plektra/ESP32-PDM/docs/decisions.md

# Decisions

Every design decision, numbered. Numbers are never reused. **Confirmed** = decided by the owner; **[proposed]** =
recommended, not decided; **auto** = a two-way-door decision made by an agent under decision 23, which the owner may
overturn. Background and calculations: [design-notes.md](design-notes.md). New decisions take the next
free number (`/handoff` adds them).

| # | Date | Area | Decision | Status |
|---|---|---|---|---|
| 1 | 2026-10-29 | system | Purpose: replace mechanical relays with smart high-side switching, controlled by ordinary panel switches **and** over NMEA 2000; status and current reported on the bus. No relays in the product. | confirmed |
| 2 | 2026-10-29 | system | **Low cost is the guiding principle.** JLCPCB PCBA; JLCPCB basic or preferred parts wherever one fits; few unique extended parts. | confirmed |
| 3 | 2026-10-29 | system | Supply: 12 V and 24 V systems, up to ~30 V while charging. | confirmed |
| 4 | 2026-10-30 | system | Keep the ESP32-S3 (NMEA 2000 / SensESP / Signal K ecosystem, Wi-Fi, OTA). Native USB; no USB-UART bridge. | confirmed |
| 5 | 2026-10-30 | system | One board per product, built from shared schematic sheets; the earlier base board + output module split is dropped. | confirmed |
| 6 | 2026-10-30 | system | Physical switch inputs drive the outputs in hardware, independent of the ESP32 and its 3.3 V rail (protected direct inputs, no optocoupler). | confirmed |
| 7 | 2026-10-30 | pdm-4ch | 4-channel board with Infineon PROFET+24V switches, fitted per channel at assembly: BTT6050-1ERA (≈ 4 A) or pin-compatible BTT6010-1ERA (≈ 8 A). BTT6030 not used. | confirmed |
| 8 | 2026-10-30 | pdm-hc2 | High-current board: 2 channels, TI TPS48110A-Q1 + back-to-back MOSFETs (≈ 15 A continuous with BSC030N08NS5). | confirmed |
| 9 | 2026-10-30 | system | Heat budget is part of the design process: 40 °C engine-room ambient, `tools/heat_budget.py`. | confirmed |
| 10 | 2026-10-30 | mechanical | Enclosure 3D printed (ASA), **vented**, installed in an enclosed location. Two mountings: DIN rail with the PCB perpendicular to the rail (target 1 module width, 17.5 mm) and flat (wall/ceiling). | amended by 97 |
| 11 | 2026-10-30 | mechanical | No metal base plate: risk of bridging DC negative to a steel hull, and cost. | confirmed |
| 12 | 2026-10-30 | system | Load dump is **not** handled on the board; the README states it (system-level protection required). | confirmed |
| 13 | 2026-10-30 | system | Low-power modes are entered by a bus command (NMEA 2000 or Signal K); local switches always work and can wake the node. Panel LEDs dimmable. | confirmed |
| 14 | 2026-10-29 | system | Board variant ID: resistor divider on IO1 (`MOD_ID`, 10 kΩ pull-up). 4-ch = 10 kΩ, HC2 = 4.7 kΩ. | confirmed |
| 15 | 2026-10-30 | system | Bilge pumps: the automatic float-switch circuits stay wired directly to the battery; the PDM is used only for manual forced run (in parallel with the float switch). | confirmed |
| 16 | 2026-10-30 | system | Withdrawn by the owner (2026-11-03). | withdrawn |
| 17 | 2026-10-30 | system | Panel cable (J5, 10 poles): 1–4 switch inputs, 5 fused switch supply SW_SUPPLY (VS via PTC F4 1812L050/60GR, SMAJ30CA, 100 nF), 6–9 LED cathodes to constant-current sinks (MMBT5551 + 470 Ω emitter, 1 k/10 k base from the GPIO, ≈ 5 mA, PWM-dimmable, 1 nF on the collector), 10 GND/drain. Panel LEDs: anode to SW_SUPPLY, no resistor at the panel; works up to ≥ 10 m of cable at 12 V and 24 V. SMAJ30CA on every line; no 3.3 V on the cable. A short in the panel cable trips F4 and disables that board's panel switches (bus control keeps working). | confirmed |
| 18 | 2026-10-30 | system | Pin map: VBAT_SENSE on IO10 (220 k/22 k + 100 nF, 33 V full scale), NTC on IO9 (10 k B3380 NTC APV ANTC1608-103F3380FB + 10 k pull-up, placed next to the output switches); both ADC1. Panel LED drives move to IO38–IO41; channel-4 drive (4-ch) moves IO9 → IO11; IO12/IO13 spare. | confirmed |
| 19 | 2026-10-30 | pdm-hc2 | Withdrawn by the owner (2026-11-03): no HC2 load above the ≈ 15 A rating; the breaker stays as in decision 39. | withdrawn |
| 20 | 2026-10-30 | system | Panel LED behaviour and fault handling: LED on = output on, blinking = fault (firmware). Alerts and failures are published to Signal K so they can be acknowledged and muted there; the failure modes per output (what blinks, what alerts, what is latched, what clears) are still to be designed in `/system firmware`. | open |
| 21 | 2026-10-30 | system | Sense the panel switch supply: SW_SUPPLY → 100 k/10 k divider (+ 100 nF) → spare GPIO IO12, so the firmware can alert when F4 has tripped (otherwise indistinguishable from "all switches off"). Two basic resistors per board. | superseded by 93 |
| 22 | 2026-10-30 | system | Unattended agent runs (`docs/AUTONOMY.md`): agents make small decisions themselves (recorded as **auto**); bigger design changes go to the owner through `docs/OWNER-INBOX.md`. Pilot: only the reviewers run unattended. | confirmed; policy replaced by 23 |
| 23 | 2026-11-01 | system | Autonomy by reversibility (one-way/two-way doors, `docs/AUTONOMY.md`) replaces the small/big rule of decision 22. One-way doors go to the owner: money (orders, changes to ordered boards), the owner's confirmed, proposed or open decisions, weakening safety or invariants, facts only the owner has, CRITICAL findings. Everything else is a two-way door: agents decide (recorded as **auto**, listed in the inbox digest, undoable with `orchestrate.py undo`); questions with a sensible default are answered with it. | confirmed |
| 24 | 2026-11-01 | system | Unattended fixes (`docs/AUTONOMY.md`, "Unattended fixes"): approved items (owner rulings and two-way decisions) are applied by agents without the owner – a planner makes work packages, board-fixer agents edit the schematics, the orchestrator gates every change (scope, ERC, netlist against declared refs, LCSC, shared sheets equal) before merging into `auto/pilot`, and a validator re-checks each board. One-way doors still go to the owner; the owner merges into `main` and reviews before any order. | confirmed |
| 25 | 2026-11-01 | pdm-hc2 | HC2 gate slew control per TPS4811-Q1 §8.3.2.1: R1 in the PU path, C1 + 10 Ω at the gate, PD direct (RGATE_PD as a 0 Ω footprint); sized for about 20 A inrush into 1000 µF (start ≈ 100 k / 3.9 nF), because the HC2 loads are not known yet. This supersedes the plain RG_PU 100 Ω of Q-0001. MOSFET SOA, heat budget and fast short-circuit response are checked. No PWM on HC2 outputs until measured on the bench; real load capacitance measured on the prototype. (owner: Q-0001, Q-0043, Q-0045) | confirmed |
| 26 | 2026-11-01 | system | Battery input J10 (both boards): bulk capacitor rated ≥ 63 V (not 50 V, the TVS clamps up to ≈ 48 V), basic part preferred, plus 1–2.2 µF/100 V ceramic at J10 and 1 µF/100 V at each BTT6050 VS tab; ferrite/CMC as a DNP footprint. (owner: Q-0002) | confirmed |
| 27 | 2026-11-01 | system | Output surge protection: HC2 gets a TVS from each OUT to GND at J11 with a short return to J10.2 (SMAJ33CA if basic/cheap for stand-off margin in the 28.8 V float-switch case, else SMAJ30CA). Invariant 4 is reworded to cover the PROFET output case (protection through the body diode to VS and D30); pdm-4ch gets a DNP SMAJ30CA footprint per output and wide VS copper to D30. (owner: Q-0003, Q-0007) | confirmed |
| 28 | 2026-11-01 | system | EMC target: IEC 60945 as a design target, no certification; one pre-compliance scan on the first prototypes decides the DNP footprints; the N2K shield stays unconnected at the node (4-pole J4). (owner: Q-0012) | confirmed |
| 29 | 2026-11-01 | system | CAN sheet: Y-capacitor GND_CAN–GND as a DNP footprint and a CMC footprint fitted with 0 Ω bridges, decided at the pre-compliance scan; 10 k pull-up from the transceiver TXD to +3V3; CA-IS3050G replaces ISO1044 only if its part-facts check (supplies, pinout, timing) passes; the isolated CAN side stays powered from NET-S (NMEA 2000 practice, LEN). (owner: Q-0004, Q-0023, Q-0031, Q-0039) | confirmed |
| 30 | 2026-11-01 | system | Buck (power-usb): add 100 nF/100 V at VIN, an SW RC snubber footprint (DNP) and a 0 Ω boot resistor; keep LMR51610YDBVR – swap to the YF (FPWM) variant only if the pre-compliance scan shows PFM noise (check price and stock then), and revisit the 400 kHz X variant only after the scan. Capacitors on battery-side clamp nets (C1, C50–C53): 100 V where a basic part exists, otherwise ≥ 63 V; the stock check decides. (owner: Q-0005, Q-0009, Q-0013, Q-0022) | confirmed |
| 31 | 2026-11-01 | system | USB service port: README service rule (battery-powered laptop or USB isolator); verify the ESD diode TLP/clamp data before ordering; shield-to-GND RC footprints (1 MΩ ‖ 4.7 nF) with a 0 Ω option. USB-C stays fitted on the prototype run; DNP/pogo pads plus OTA reconsidered for later runs. (owner: Q-0008, Q-0020, Q-0029) | confirmed |
| 32 | 2026-11-01 | system | BOM parts: add the listed basic/preferred LCSC codes after checking each against value and footprint (J5/J10/J11 in /system mechanical); adopt each L3 swap (FB → GZ2012D601TF, F2 → 1812L050/60GR, PESD0402V05 → H5VL10B, TPS7B91 → L78M05ABDT) only if its part-facts check passes; check the 1812L050/60GR Imax and minimum resistance against the prospective short current (30 V / cable + PTC resistance); recheck stock before ordering and datasheet-check the L1 second sources SLW6045S8R2MST C47018494 / FNR6045S8R2MT C168074; keep the NTC TH1; keep R1/R2 on HC2 so the controller part stays identical. (owner: Q-0011, Q-0014, Q-0015, Q-0019, Q-0024, Q-0025) | confirmed |
| 33 | 2026-11-01 | system | Ordering: first order 5 pdm-4ch + 5 pdm-hc2, quantity revisited for later runs; combined 1:1 panel of both designs at the PCB phase if the JLCPCB multi-design surcharge does not cancel the saving; the owner checks 2 oz + Economic PCBA on the JLCPCB quote page before layout; merge 100 nF / 1 µF package variants only if Standard PCBA is forced. (owner: Q-0016, Q-0017, Q-0018, Q-0026, Q-0027, Q-0028) | confirmed; first order replaced by 101, 102 |
| 34 | 2026-11-01 | mechanical | Terminals: J10 GND pole(s) rated like the VS input, with wide GND copper to J10.2; pluggable vs fixed terminals decided in /system mechanical, leaning pluggable for low-current J4/J5 and fixed for J10/J11. (owner: Q-0010, Q-0021, Q-0030) | terminal type replaced by 98 |
| 35 | 2026-11-01 | system | Panel interface (analog_sw): C14–C17 raised to 470 nF; README: dry (unlit) switch contacts and output-off below about 8 V during 12 V cranking; R3/R4/R7/R8 become two 1206 resistors in series (2.2 k + 2.4 k, basic); a series diode in the SW_SUPPLY feed protects the panel LEDs on reversal (switch thresholds and IN margin rechecked with its drop). The switch ON margin claim is corrected in design-notes and measured on the prototype; RIN 4.7 k is the planned fix if it is short; no other circuit change now. (owner: Q-0006, Q-0034, Q-0038, Q-0040) | confirmed |
| 36 | 2026-11-01 | pdm-4ch | Standard population: all four BTT6050, heavy loads go on HC2. RIS as 1206 ≥ 0.25 W; OUT pull-down as a DNP footprint; firmware rule: DEN pulsed only while sampling IS and dropped on full-scale IS, not held high in Active mode. (owner: Q-0032, Q-0033, Q-0041) | confirmed |
| 37 | 2026-11-01 | system | Footprints: Infineon_PG-TDSO-14_ThermalVias paste windows move between the thermal vias (no plugged-via surcharge), rechecked against the package drawing; U3 uses the standard KiCad Package_TO_SOT_SMD:SOT-23-6 after a check against TI DBV0006A and the JLCPCB footprint. (owner: Q-0036, Q-0037) | confirmed |
| 38 | 2026-11-01 | system | Amends decision 18: VBAT_SENSE full scale is about 32 V (ESP32-S3 ADC calibrated range 0–2900 mV), not 33 V; the 220 k/22 k divider is unchanged. (owner: Q-0035) | confirmed |
| 39 | 2026-11-01 | pdm-hc2 | HC2 breaker: RIWRN 68 k (IOC ≈ 17.5 A, 146 ms) plus a README/label requirement for an external breaker ≤ 15–18 A per output and a firmware soft fuse; the ARCHITECTURE HC2 budget is updated; the bilge pump start current is measured before ordering. An OUT voltage divider on spare IO4/IO5 (ADC1) detects float-driven runs (pin-map change). (owner: Q-0042, Q-0046) | confirmed; pump test timing replaced by 100 |
| 40 | 2026-11-01 | pdm-hc2 | Reverse battery on HC2: keyed/polarised J10 plus README and label warning; design-notes §8 corrected (reversal survival does not apply to HC2); full reverse-polarity protection deferred to a later HC2 revision and kept on the list. (owner: Q-0044) | confirmed |
| 41 | 2026-11-01 | system | Battery input J10 (both boards): C31 100 uF/63 V Ymin VKMD1001J101MV C487384 (extended; no basic/preferred >=63 V electrolytic exists; 10000 h at 105 C, 902 mA rms) on VS, C30 1 uF/100 V X7R 1206 Samsung CL31B105KCHNNNE C13832 (extended; no basic/preferred 100 V 1 uF) on the terminal net VBAT_IN with D30; FL30 DNP ferrite position VBAT_IN-VS bridged by JP30 copper net tie (no part, widened to VS copper at layout); two new extended-part loading fees accepted (T-0064) | auto |
| 42 | 2026-11-01 | pdm-hc2 | HC2 bulk: one extra 100 uF/63 V (C487384) per channel on VS in hc_channel (C106/C206), 3 x 100 uF in total (T-0064) | auto |
| 43 | 2026-11-01 | pdm-hc2 | HC2 output TVS D103/D203 SMAJ33CA C19077549 (preferred): VRWM 33 V above the 28.8 V float case, VC 53.3 V below the 80 V MOSFET and 100 V SS510B ratings (T-0064) | auto |
| 44 | 2026-11-01 | pdm-4ch | 4-ch: C104-C404 1 uF/100 V C13832 at each BTT6050 VS tab; D103-D403 SMAJ30CA C19077548 DNP from OUT to GND (check PROFET demagnetisation clamp before fitting) (T-0064) | auto |
| 45 | 2026-11-02 | system | L3 swaps (T-0026): FB1/FB2 -> Sunlord GZ2012D601TF C1017 (600 ohm@100 MHz, 0.30 ohm, 500 mA); D4-D6 -> H5VL10B C7420372 on D_SOD-882 (VRWM 5 V, VC 10 V@5 A 8/20us, CJ 18 pF max); U6 -> L78M05ABDT C58069 DPAK (VI max 35 V vs 29.2 V clamp, Id 6 mA, LEN unchanged 1/2) with C13 1 uF/50 V 0805 C28323; F2 not swapped (PTC Imax check failed) (T-0065) | auto |
| 46 | 2026-11-02 | system | USB shield (T-0014): J3 SH on net USB_SHIELD, R13 1 M 1206 C17927 \|\| C18 4.7 nF/1 kV X7R 1206 Yageo C107198 fitted, R14 0 ohm 0603 C21189 DNP hard-tie option (T-0065) | auto |
| 47 | 2026-11-02 | system | Buck (T-0011): C19 100 nF/100 V 0805 C28233 at U3 VIN; R43 0 ohm 0402 C17168 in series with boot cap C2; SW snubber R44 10 ohm 1206 C17903 + C20 100 pF/100 V C0G 0603 C296717, both DNP (values set at the pre-compliance scan) (T-0065) | auto |
| 48 | 2026-11-02 | system | Capacitor ratings (T-0015): C1 -> 2.2 uF/100 V X7R 1206 Samsung CL31B225KCHSNNE C170101 (extended; no basic >=63 V, 2x C13832 would be below TI's 2.2 uF minimum); C50-C53 -> 1 nF/2 kV X7R 1206 FH C9196 (basic) (T-0065) | auto |
| 49 | 2026-11-02 | system | L1 approved alternates (T-0022): Sunltech SLW6045S8R2MST C47018494 and cjiang FNR6045S8R2MT C168074, same 8.2 uH / 0.056 ohm max / Isat 3.9 A / Irms 2.6 A / 6045 land as SWPA6045S8R2MT; stock recheck on the pre-order checklist (T-0065) | auto |
| 50 | 2026-11-02 | pdm-4ch | PG-TDSO-14 EP paste: 4 x 2.55x0.6 mm windows at y=+/-0.6,+/-1.8 and 2 x 2.55x0.5 mm at y=+/-2.95, between the via rows; 51 % of the EP, >=0.15 mm from every via drill (BTT6050-1ERA DS Fig. 53; Q-0036) (T-0066) | auto |
| 51 | 2026-11-02 | shared | U3 LMR51610 footprint Package_TO_SOT_SMD:SOT-23-6 on both boards (matches TI DBV0006A pitch/width/pin order, JLC C22427220 pads inside it); lib symbol default updated; custom lib/ESP32-PDM.pretty/LMR51610.kicad_mod removed (Q-0037) (T-0066) | auto |
| 52 | 2026-11-02 | pdm-4ch | RIS 680 ohm 1206 0.25 W = C17975 (extended; no basic 1206 680 ohm exists) (T-0069) | auto |
| 53 | 2026-11-02 | pdm-4ch | DNP OUT pull-down R106/R206/R306/R406 47 kohm 0603 C25819 (BTT6050 Table 11 RPD example; 19 mW at 30 V) (T-0069) | auto |
| 54 | 2026-11-02 | shared | C14-C17 470 nF/10 V X5R 0402 CL05A474KP5NNNC (C47339, preferred), same footprint; tau about 1.5 ms (T-0012/Q-0006) (T-0068) | auto |
| 55 | 2026-11-02 | shared | SW_SUPPLY series diode D55 = DSK16 (C22466351, already on BOM; 60 V, 1 A, IFSM 25 A) between F4.2 (anode) and SW_SUPPLY/J5.5 (cathode); D54/C54 stay on J5.5 (T-0049/Q-0040) (T-0068) | auto |
| 56 | 2026-11-02 | pdm-4ch | p_other documented as about 2.2 W at 30 V with all panel lines on (Tj 101 C at 4 A); heat_budget default unchanged (T-0047) (T-0068) | auto |
| 57 | 2026-11-03 | pdm-hc2 | DIODE bypass C107/C207 1 nF 0402 C1523 fitted across MMBT3904 (TPS4811-Q1 9.6.1); emitter Kelvin to U GND at PCB (T-0071) | auto |
| 58 | 2026-11-03 | pdm-hc2 | RVS R114/R214 100 ohm C25076 VS -> VS_CTRL (pin 20); C102/C202 moved to VS_CTRL as CVS 1 uF/100 V 1206 C13832 (Table 9-3); drop <= 70 mV at I(Q) 700 uA; RSET and UV/OV divider stay on VS (T-0071) | auto |
| 59 | 2026-11-03 | pdm-hc2 | CS X cap C108/C208 1 nF C1523 fitted (tau 0.1 us << tSC 4 us); Y caps C109/C110/C209/C210 100 pF/100 V C296717 DNP (unbalanced source impedance, needs ferrites; Q-0012) (T-0071) | auto |
| 60 | 2026-11-03 | pdm-hc2 | EN/UVLO C111/C211, OV C112/C212 and IWRN C113/C213 1 nF C1523 fitted (OV delay <= 0.4 ms; 10 nF rejected at 4 ms; IWRN 47 us vs tOC 146 ms) (T-0071) | auto |
| 61 | 2026-11-03 | shared-can | U5 ISO1044 -> Chipanalog CA-IS3050G (C528763, SOIC-8-WB, KiCad SOIC-8_7.5x5.85mm_P1.27mm, new symbol ESP32-PDM:CA-IS3050G); datasheet v1.10 checks passed (VCC1 2.5-5.5 V, VCC2 4.5-5.5 V, +/-58 V bus, loop <=210 ns, DTO 2-8 ms, 5 kVrms); LEN 1 worst case 49.3 mA (T-0067) | auto |
| 62 | 2026-11-03 | shared-can | TXD pull-up R70 10 k 0402 C25744 to +3V3 (T-0067) | auto |
| 63 | 2026-11-03 | shared-can | barrier Y-cap C70 = 1 nF/2 kV X7R 1206 C9196 (reuses C50-C53 part), DNP, GND_CAN-GND, capacitor only (T-0067) | auto |
| 64 | 2026-11-03 | shared-can | CMC FL1 = cjiang FACT4532-510-2P-T C20624726 (51 uH, 4532), DNP, footprint Coilank_ACM4532 placeholder, bus side on pins 1/4; bridges R71/R72 0 ohm 0402 C17168 (reuses R43 part), fitted (T-0067) | auto |
| 65 | 2026-11-03 | system | LCSC codes from cost report C1 applied on both boards after value/package/net-voltage check: C2 C14663, C4/C6 C15849, C5 C19666, C7/C9 C28233, C8 C45783, C10/C11 C307331, C12 C52923, D12-D15 C22466350 (BAT54C, preferred), R1/R2/R5/R6 C25879, R11/R12 C25905, R15-R17/R21/R24/R27 C25744; C13 and FB1/FB2 keep the T-0065 codes (T-0073) | auto |
| 66 | 2026-11-03 | system | Firmware/production rule: never burn EFUSE_STRAP_JTAG_SEL (IO3 held low by IS2 on pdm-4ch, IMON2 on pdm-hc2); design-notes §2 and both STATUS pre-order checklists (T-0073) | auto |
| 67 | 2026-11-03 | pdm-hc2 | RIWRN R113/R213 68 k 0402 1 % = C36871 (preferred, replaces C25792): IOC 17.5 A nominal, ~15.2-19.7 A over V(SNS_WRN) interpolation and 1 % parts; tOC 146 ms unchanged; Tj 111 C at 17.5 A, 139 C at 19.7 A (11.7 mOhm path) (T-0072) | auto |
| 68 | 2026-11-03 | pdm-hc2 | OUT sense on the HC2 root sheet: R63/R65 220 k C25767, R64/R66 22 k C25768, C62/C63 100 nF C307331 (VBAT_SENSE parts), OUT1 -> IO4 (ADC1_CH3), OUT2 -> IO5 (ADC1_CH4); full scale ~31.9 V; <=0.13 mA into an unpowered pin (T-0072) | auto |
| 69 | 2026-11-03 | shared-can | Amends decision 61: U5 CA-IS3050G pinout corrected per CA-IS305x v1.10 p. 5 Fig. 6-1/Table 6-1: pin 2 = RXD, pin 3 = TXD. The symbol ESP32-PDM:CA-IS3050G is renumbered (positions unchanged) on both boards, so /IO17 (CAN TX, R70 pull-up) goes to U5.3 TXD and /IO18 (CAN RX) to U5.2 RXD. The earlier pinout pass in decision 61 had the CA-IS3052G order. Pin map and parts are unchanged. (owner: Q-0052) (owner: Q-0052) | confirmed |
| 70 | 2026-11-03 | shared | CA-IS3050G symbol pins corrected to datasheet v1.10 Table 6-1 (2 RXD, 3 TXD) by renumbering only; pin points and wiring unchanged, /IO17 -> U5.3 TXD, /IO18 -> U5.2 RXD, R70 stays on TXD (T-0078) | auto |
| 71 | 2026-11-03 | system | Amends decision 24: unattended **sync** packages (`docs/AUTONOMY.md`, "System sync"). Board-fixers with scope `sync` may bring `docs/ARCHITECTURE.md` (never its Invariants section), `docs/design-notes.md`, the boards' `STATUS.md` and the inputs of `tools/heat_budget.py` in line with what is already merged and decided – no design change. After fixes settle, the orchestrator sweeps the "For /system" lists: bookkeeping items are synced, choices (mechanics, firmware, pin map, invariants, money, safety rules, owner facts) stay for an interactive `/system` session. Gates: those files only, netlists unchanged, invariants word for word, the heat budget tool still runs. | confirmed |
| 72 | 2026-11-03 | pdm-hc2 | Amends decision 25: Amends decision 25: HC2 outputs are rated for a maximum load input capacitance of about 50-100 uF (BSC030N08NS5 SOA, T-0070); the 1000 uF / 20 A inrush target is dropped. Only a short gate slew for EMC is fitted (decision 25 topology), sized within the MOSFET SOA at that capacitance, also for turn-on into a short. The README says HC2 is for motor loads (bilge pumps, wipers) and grouped LED work lights (possibly a few hundred uF in total), while DC-DC converters (e.g. 24->12 V for a car radio), radios and other electronics go on pdm-4ch. The prototype measures real load capacitance (Q-0045) and confirms the rating; grouped LED lights are split if they cause short-circuit trips. No PWM on HC2 until measured stays. (owner: Q-0049, Q-0050, Q-0051) (owner: Q-0049, Q-0050, Q-0051) | confirmed |
| 73 | 2026-11-03 | system | Amends decision 32: Amends decision 32 (and the F4 part of decision 17): F1/F3/F4 become an 1812 60 V PTC with Imax 100 A (TECHFUSE mSMD050-60V C70113 or JDT ASMD1812-050-60V C427396, same footprint) after a datasheet check, plus a series resistor of about 0.15-0.22 ohm per PTC so that 30 V / R_total <= Imax. The resistor's pulse energy is checked against the PTC trip time; if no basic/cheap part passes, back to the owner. Then F2 is swapped to the same PTC (T-0026). F4 is safety-relevant (panel switches: bilge forced run, navigation lights): a competent person reviews it before installation. (owner: Q-0047) (owner: Q-0047) | confirmed |
| 74 | 2026-11-03 | system | Amends decision 35: Amends decision 35: the panel switch loads R3/R4/R7/R8 become two 2 k 1206 basic resistors (C17944) in series, 4.0 k in total (7.5 mA and 0.11 W per part at 30 V), instead of 2.2 k + 2.4 k (no basic part for those exists). (owner: Q-0048) (owner: Q-0048) | confirmed |
| 75 | 2026-11-03 | shared | panel switch loads: R3/R4/R7/R8 2 k 1206 C17944 with new R45/R46/R47/R48 2 k 1206 C17944 in series to GND (4.0 k, 0.11 W per part at 30 V, 0.29 W per part at the 48 V clamp within the 5 s overload of 55.9 V); p_other about 2.3 W, Tj 101 C at 4 x 4 A (T-0105/Q-0048) (T-0105) | auto |
| 76 | 2026-11-03 | pdm-hc2 | gate slew: R1 (R104/R204) 10 k C25744, C1 (C114/C214) 1 nF/2 kV 1206 C9196 to GND via R2 (R115/R215) 10 ohm C25077, PD direct via RGATE_PD (R116/R216) 0 ohm C17168; output ramp about 0.5-0.75 V/us (TPS4811-Q1 8.3.2.1, Eq. 3/4; BSC030N08NS5 SOA Diagram 3) (T-0106) | auto |
| 77 | 2026-11-03 | pdm-hc2 | HC2 output rating: max about 50 uF load input capacitance (100 uF and 68 uF fail SOA from a hot start, 100 uF trips ISCP); confirmed on the prototype (Q-0045) (T-0106) | auto |
| 78 | 2026-11-03 | pdm-4ch | RIS = two 1 kOhm 1206 0.25 W C4410 in parallel (R103\|\|R107 ... R403\|\|R407) = 500 ohm, replaces 680 ohm C17975; IS <= 1.63 V at 4.5 A BTT6050 (kILIS min 1380), firmware scale 500 ohm (T-0107) (T-0107) | auto |
| 79 | 2026-11-03 | system | C30 at J10 (both boards) 1 uF C13832 -> 2.2 uF/100 V X7R 1206 C170101, within decision 26's 1-2.2 uF (T-0107) (T-0107) | auto |
| 80 | 2026-11-03 | pdm-hc2 | CVS C102/C202 on VS_CTRL 1 uF C13832 -> 2.2 uF/100 V C170101; TPS4811-Q1 Table 9-3 0.1-10 uF, tau 0.22 ms with RVS 100 ohm (T-0107) (T-0107) | auto |
| 81 | 2026-11-03 | system | Amends decision 73: Amends decision 73: F1/F3/F4 each get a series 0.2 ohm 2 W alloy 2512 resistor (FOJAN FRM252WJR200TK, C7420022, extended). It is accepted on its 5 s / 50 J overload rating without a published ms pulse rating. F1-F4 become the 100 A PTC TECHFUSE mSMD050-60V C70113 (F2 moves from 0805 to the 1812 footprint, no series resistor on F2). A hard-short test at 30 V on the prototype (J5.5, and behind F1 and F3) is mandatory before installation. F4 feeds the panel switches (bilge forced run, navigation lights): a competent person reviews it before installation. (owner: Q-0060) | confirmed |
| 82 | 2026-11-03 | pdm-4ch | Reverse battery on pdm-4ch: a reverse-blocking element (P-FET or ideal-diode controller) goes on VS in front of the bulk capacitors in this revision. It is sized for the 40-50 A input path and checked with the heat budget at 40 C. Until it is in, the README/design-notes reversal claim is limited to the BTT6050 switches, with a warning that C31 is not reverse-rated. J10 is still keyed/polarised (decision 34, /system mechanical). (owner: Q-0054) | confirmed; pdm-4ch J10 keying dropped by 121 (fixed terminal, Q30 blocks reverse battery) |
| 83 | 2026-11-03 | system | Amends decision 31: Amends decision 31: the USB shield RC is 1 MOhm \|\| 1 nF/2 kV. C18 becomes C9196 (basic, already on the BOM) on both boards instead of 4.7 nF/1 kV C107198. USB-C (J3 and its protection) stays fitted on every run; no DNP/pogo-pad variant for later runs. (owner: Q-0058, Q-0061, Q-0062) | confirmed |
| 84 | 2026-11-03 | system | Amends decision 26: Amends decision 26: each BTT6050 VS tab gets >= 1 uF/100 V. On pdm-4ch, C104-C404 are 2.2 uF/100 V X7R 1206 C170101 instead of 1 uF C13832 (same footprint), which removes the C13832 fee. Revisit if runs grow past about 12 boards. (owner: Q-0063, Q-0064) | confirmed |
| 85 | 2026-11-03 | system | Assembly: Economic PCBA without the through-hole connectors J4, J5, J10 and J11. The owner buys and hand-solders all four on both boards. The owner checks the JLCPCB monthly assembly coupon centre and the cart at order time. (owner: Q-0057, Q-0059, Q-0065) | confirmed |
| 86 | 2026-11-03 | system | PTC series resistors R54 (F1), R55 (F3), R56 (F4): 200m C7420022 on Resistor_SMD:R_2512_6332Metric, on the protected side; each PTC shifted 7.62 mm to its supply side to make room (T-0118) (T-0118) | auto |
| 87 | 2026-11-03 | system | F2 swapped to C70113 1812: USB-only buck input at 0.40 A peak 3.74 V typ vs 3.80 V before, below 4 V with either part, same pass/fail in every corner, so the Q-0060 stop condition is not met (design-notes 8.3) (T-0118) | auto |
| 88 | 2026-11-03 | pdm-4ch | reverse-battery blocker: LM74500-Q1 (C5219210, no reverse-current blocking, EN tied to SOURCE) driving N-FET IPT007N06N (C122552, 60 V, 0.75 mOhm) between new net VBAT_FL (behind FL30/JP30) and VS; keeps the OUT->VS->D30 surge path (invariant 4), no TVS on VS (design-notes 8.6) (T-0121) | auto |
| 89 | 2026-11-03 | pdm-4ch | U30 VCAP capacitor C32 1 uF/50 V 0603 C15849 (>= 10 x Ciss 21.3 nF = 213 nF, LM74500 datasheet 9.3.1.2.3) (T-0121) | auto |
| 90 | 2026-11-03 | pdm-4ch | PCB rule: >= 6 cm2 2 oz copper on Q30 drain tab (VS) - Q30 Tj 122 C at 40 A, 200 C on a minimal pad (T-0121) | auto |
| 91 | 2026-11-04 | pdm-4ch | Q30 cost lever L1 dropped: AGM601LL C5464765 is 1.6 mOhm max (1.25 typ), RthJA 50 K/W without copper area; Q30 has no stable Tj below 175 C at 40 A (IPT007N06N 124 C by the same method). Q30 stays IPT007N06N C122552 (design-notes 8.6 Cost) (T-0132) | auto |
| 92 | 2026-11-04 | pdm-4ch | Amends decision 88: Reverse-battery blocker: a TVS is fitted across Q30 (drain VS to source VBAT_FL) on the first order, so that a negative transient with VS charged no longer avalanches Q30. It keeps Q30 VDS below 60 V at the pulse current and takes the transient's energy, checked at the real maximum input of 32 A (4 x BTT6010 at 8 A). It must not conduct for a steady reversed battery (<= 28 V) or in normal operation. Basic/preferred part if one fits; back to the owner if no part keeps VDS below 60 V. The 'no TVS on VS' wording of decision 88 and design-notes 8.6 (c) changes accordingly: the TVS is across Q30, not from VS to GND, and the OUT->VS->Q30->D30 surge path stays (invariant 4 unchanged). Design-notes 8.6 (b) is corrected. This replaces the documentation-only default assumed in T-0130. (owner: Q-0066) | confirmed |
| 93 | 2026-11-04 | system | Replaces decision 21: sense the panel switch supply digitally, because the 100 k/10 k divider cannot work on IO12 (ADC2, invariant 10; as a digital input it reads low at 24 V). SW_SUPPLY → R49 10 k 1206 → SW_SENSE (R57 4.7 k, D24 BZT52C3V3, C21 470 nF to GND) → R58 10 k → IO12, the same network as the switch inputs, on both boards. High = SW_SUPPLY present, from about 7.7 V. +5 parts per board, no new unique part. The firmware alerts only while VBAT_SENSE shows a healthy battery, so 12 V cranking does not raise a false alarm. An alert, not a safety function. | confirmed |
| 94 | 2026-11-04 | pdm-hc2 | Amends decision 72: plan on one LED work light per output. Each HC2 output is limited to about 50 µF of load input capacitance (decision 77), confirmed on the prototype. Several lights on one output are allowed only for loads with little capacitance (plain LED strips without their own driver) or once the prototype shows that group switches on cleanly. No redesign now; a pre-charge path (TPS48111-Q1 with a pre-charge MOSFET and resistor) is the planned fix for the next HC2 revision if the prototype shows real loads need it. | confirmed |
| 95 | 2026-11-04 | system | Board input limits, replacing the ≈ 40 A (4-ch) / ≈ 50 A (HC2) budget and the 40–50 A sizing basis of decision 82: J10, its GND pole and the supply copper are sized for 32 A continuous on pdm-4ch (4 × BTT6010 at 8 A; 16 A in the standard all-BTT6050 build) and 36 A on pdm-hc2 (2 × the 18 A external breaker). The README states them as the board input limits. Q30 stays IPT007N06N with the ≥ 6 cm² drain copper rule (Tj ≈ 86 °C at 32 A). Output terminals are chosen in `/system mechanical`. | confirmed; output connectors set by 98; pdm-4ch limit amended by 103 |
| 96 | 2026-11-04 | pdm-4ch | Amends decision 92: TVS across the reverse-battery blocker: SMDJ40CA C42371557 (preferred, 0.22 USD) is fitted across Q30 (drain VS to source VBAT_FL). The owner accepts Q30 VDS 59.4 V worst case and VS down to about -4 V for the 31 A bounding spike. This is recorded as a residual risk in design-notes 8.6 (C31 briefly reverse-biased), and a prototype check measures Q30 VDS and VS during a negative pulse. Basis (T-0137): 25 C figures, source short-circuit current at most 31 A. (owner: Q-0067) | confirmed |
| 97 | 2026-11-05 | mechanical | Amends decision 10: the board is designed to mount two ways on the same four non-plated M3 holes (H1–H4). (a) DIN rail without its own enclosure: bare board on a plastic carrier, PCB edge-on (perpendicular to the rail), about 36 mm of rail per unit with the tallest J10 block, inside an enclosure the installer provides; one enclosure can hold several units. J10/J11 screws face the neighbouring unit, so they are wired before the neighbour is fitted or with a unit unclipped. (b) A 3D-printed vented ASA enclosure instead of the rail, also usable for flat mounting. The 1-module width target is dropped. Carrier and screws never reach board copper (invariant 6). Shared enclosure rating, estimated until measured: full rating up to 50 °C air inside the box; a BTT6050 channel at 3 A up to about 65–70 °C. | confirmed; screw access replaced by 98; holes and mount refined by 123 |
| 98 | 2026-11-05 | mechanical | Replaces the terminal type of decision 34 and meets the keying of decisions 34, 40 and 82: all four connectors are keyed plugs on right-angle sockets, so plugs pull outward and no terminal screw faces the neighbouring unit. J10 both boards: Kefa KF2EDGSRAM-10.16-2P C6394053 + locking plug C6394029 (65 A UL / 57 A IEC, 10 mm²). J11 pdm-4ch: KF2EDGRC-5.08-4P C441238 + plug C440882 (10 A UL / 15 A IEC). J11 pdm-hc2: locking KF2EDGSRM-7.62-2P C577772 + plug C577752 (30 A UL / 32 A IEC), a different pitch so the battery plug cannot enter an output socket. J5: Kangnex WJ15EDGRC-3.81-10P C26895 + plug C26865. J4: WJ15EDGRC-3.81-04P C7245 + plug C7244. The owner hand-solders all sockets (decision 85). Board depth about 65 mm on pdm-4ch and about 75 mm on pdm-hc2, length up to 100 mm, set at layout. One sample of each set is checked before layout: plugs truly one-way, J4 plug against the J5 socket, fit at the 36 mm rail pitch. | confirmed; pdm-4ch J10 amended by 103 and 121; sample check moved to bring-up by 127 |
| 99 | 2026-11-06 | system | Result of the owner's quote-page check in decision 33: JLCPCB does not offer Economic PCBA with 2 oz copper. While the boards stay 2 oz, Standard PCBA is the cost basis for every order, whichever module is used. This meets decision 33's condition for merging the 100 nF / 1 µF package variants; the merge itself is not done yet. (owner: Q-0026) | confirmed |
| 100 | 2026-11-06 | system | Amends decision 39's timing: the bilge pump start current is measured on or after the first working prototype, not before ordering, and before any board runs a pump in service (`docs/pump-start-current-test.md`). U1 stays machine-placed: the owner will not hand-solder a module with a bottom pad (no hot air or hot plate), and the DOIT modules are dropped because of possible commercial use. The cost levers based on them (L1, L2 of the 2026-11-05 cost report) are closed. Since the Espressif S3 modules are standard-only, orders stay on Standard PCBA whatever the copper weight. | confirmed |
| 101 | 2026-11-06 | system | Amends decision 33's first-order quantity: 5 bare PCBs of each design, of which JLCPCB assembles 2 (JLCPCB's 2-of-5 option), instead of 5 assembled. The first order is prototype only. Copper stays 2 oz and U1 machine-placed; reflowing the module by hand is dropped for now. | confirmed |
| 102 | 2026-11-06 | system | Amends decision 33's first-order scope: the first order is pdm-4ch only, as the cheapest tangible MVP (no board is urgent, design changes are expected). pdm-hc2 layout and order follow after pdm-4ch bring-up, so shared-sheet fixes go in once. The combined panel of both designs does not apply to this order. | confirmed |
| 103 | 2026-11-06 | pdm-4ch | Amends decisions 95 and 98 for the first version: pdm-4ch is 16 A only, all BTT6050, with no BTT6010 build; a BTT6010 option can return in a later revision. J10 is to be downsized and Q30 re-selected for 16 A, including a heat check; both are open items for the next `/system` session, and the schematic is not changed yet. | confirmed |
| 104 | 2026-11-07 | pdm-4ch | Amends decision 98: pdm-4ch J10 becomes KF2EDGSRM-7.62-2P C577772 + locking plug C577752 (30 A UL / 32 A IEC) instead of the 10.16 mm set, which keeps keying against the 5.08 mm J11 on the same board. Q30 is re-selected for 16 A with a datasheet check, the heat budget at 40 °C and the LM74500-Q1 gate drive; invariant 4, D31 and decision 96's negative-pulse limits are kept, or the agent stops and reports. This names the set left open in decision 103. pdm-hc2 keeps the 10.16 mm J10. As a result the pdm-4ch battery plug fits a pdm-hc2 J11 socket; this is noted for /system and was not part of the ruling. (owner: T-0148) | confirmed; J10 replaced by 121 |
| 105 | 2026-11-07 | system | Merge near-duplicate BOM lines under Standard PCBA (decision 99): C2 to C307331 (0402), C12 and C13 to C15849, R10 to C25768, HC2 R9 to C36871. C13 is the L78M05 input capacitor: it moves only if the X5R DC-bias curve at 29 V passes, otherwise it keeps C28323. Planner's note, not part of the ruling: R9 is on the shared power-usb sheet, so it changes on pdm-4ch as well, at no cost. (owner: T-0149) | confirmed |
| 106 | 2026-11-07 | system | Amends decision 18: On-board sign of life and spare access, both boards: a low-current 3.3 V power LED and a firmware status LED on IO13 (no longer spare), using one LED line and a resistor value already on the BOM where it fits; CAN TX/RX LEDs only if a check against the CA-IS3050G and R70 shows they do not load the signals. IO35, IO36, IO37 and IO42 with 3V3 and GND go to an unfitted footprint with no BOM line, and TXD0, RXD0 and GND to unfitted pads with no BOM line; IO45 and IO46 are not used. Planner's note, not part of the ruling: IO35-IO37 are FLT signals on pdm-hc2, so under the ruling's pin-map check pdm-hc2 brings out only IO42 of those, and both uses share one unfitted 8-pole footprint. (owner: T-0150, T-0151, T-0152) | confirmed |
| 107 | 2026-11-07 | system | Buck input filter position on power-usb between D2 and C1/U3: an inductor footprint bridged by a fitted 0 Ohm part or equivalent, DNP inductor, plus a DNP damping option, after checks of current rating, PTC and R54 interaction and stability against the LMR51610 input requirements. The decision 28 pre-compliance scan decides whether the inductor is fitted. (owner: T-0153) | confirmed |
| 108 | 2026-11-07 | pdm-4ch | Q30 is AGM601LL C5464765 for the 16 A input (replaces auto decision 91, which rejected it at 40 A): Tj 66-80 C at 16 A, 40 C, 40-62 K/W, Infineon's TOLL figures as an analogue because AGM's 50 K/W has no stated copper area; footprint Infineon_PG-HSOF-8-1 and C32 unchanged; symbol stays ESP32-PDM:IPT007N06N with value AGM601LL (T-0158) | auto |
| 109 | 2026-11-07 | pdm-4ch | Q30 copper rule: >= 2 cm2 of 2 oz VS copper joined to the drain tab (tab land + D31 terminal copper, rounded up), replacing the 6 cm2 of decisions 90 and 95 (T-0158) | auto |
| 110 | 2026-11-07 | system | C13 stays 1 uF/50 V X7R 0805 C28323: C15849 gives 0.10 uF at 29 V and 0.31 uF at 12 V (Samsung Component Library DC Bias simulation, 25 C) against L78M05 C_I 0.33 uF; C28323 gives 0.42 uF at 29 V with tolerance and temperature (T-0159) (T-0159) | auto |
| 111 | 2026-11-07 | system | R9 68 k moves to C36871 0402 on both boards, not only HC2: it is on the shared power-usb sheet, and on pdm-4ch it swaps one line for one line, so it is cost-neutral (T-0159) (T-0159) | auto |
| 112 | 2026-11-07 | system | C2 C307331 0402, C12 C15849 0603, R10 C25768 0402 on both boards; values, nets and 3.3 V setpoint tolerance unchanged; saves 3 lines on pdm-4ch (4.59 USD) and 4 on pdm-hc2 (6.12 USD) per order (T-0159) (T-0159) | auto |
| 113 | 2026-11-07 | system | T-0150: LED line KT-0603R red 0603 C2286 (basic) with 2.2 k C25879: power LED D8/R67 +3V3 to GND, status LED D7/R59 IO13 to GND (high = on), ≈ 0.7 mA each, root sheet both boards (design-notes §8.7) (T-0160) | auto |
| 114 | 2026-11-07 | system | T-0150: CAN TX/RX LEDs left out: LED to GND on TXD with R70 10 k sits at the 2 V VIH limit; active-low LEDs would not load but light only for dominant bits, invisible at 0.7 mA (T-0160) | auto |
| 115 | 2026-11-07 | system | T-0151/T-0152: one DNP 1x08 2.54 mm footprint J6, no BOM line: 1 GND, 2 TXD0, 3 RXD0, 4 IO35, 5 IO36, 6 IO37, 7 IO42, 8 +3V3 (T-0160) | auto |
| 116 | 2026-11-07 | pdm-hc2 | T-0151: J6 pins 4-6 not connected on pdm-hc2 (IO35-IO37 are FLT_T1/FLT_I2/FLT_T2), FLT nets untouched; brings out GND, TXD0, RXD0, IO42, 3V3 only (T-0160) | auto |
| 117 | 2026-11-07 | system | Buck input filter position (power-usb, both boards): D2.K -> JP1 copper bridge (SolderJumper-2 Bridged, 0.6 mm bar, no part; 87 A2s at 2 oz by Onderdonk vs 9.6 A2s F1 trip bound) \|\| L2 DNP SWPA6045S8R2MT C96963 -> C1/C19/U3; D3 on the U3 side. No 0 ohm chip part: C17168/C21189 publish no pulse data (T-0161) (T-0161) | auto |
| 118 | 2026-11-07 | system | Buck input filter damping option: C22 2.2 uF C170101 + R73 10 ohm C17903 1206 in series across C1, both DNP; scan starts at 10 ohm, 3.3-4.7 ohm if needed; L2 only fitted together with C22/R73 (Middlebrook margin 4.1x at a 7.3 V crank, U3 VIN surge peak) (T-0161, design-notes 8.3) (T-0161) | auto |
| 119 | 2026-11-07 | pdm-4ch | J10 stock fallback: only C577772 from another seller; C577767 and C7422678 rejected (no flange, no shown lock with plug C577752) – T-0171 (T-0171) | auto |
| 120 | 2026-11-07 | system | J10 (pdm-4ch) and J11 (pdm-hc2) stay KF2EDGSRM-7.62-2P C577772 + locking plug KF2EDGSKM-7.62-2P C577752; no design change while C577772 is out of stock (0 at JLCPCB/LCSC on 2026-11-07, plug 63). The connectors are hand-soldered (decision 85), so the owner buys the set from any seller (LCSC restock, the maker's own shop, other distributors), checking that the header reads KF2EDGSRM-7.62 (flange). If none can be bought in time, the decision 98 sample, and with it layout and the order, waits. Flange-less sockets without a shown lock (C577767, C7422678, or similar) are not acceptable. Confirms decision 119. (owner: Q-0068, Q-0069) | confirmed; pdm-4ch J10 replaced by 121, holds for pdm-hc2 J11 |
| 121 | 2026-11-07 | pdm-4ch | Amends decisions 98, 104 and 120 for the pdm-4ch prototype: J10 is the fixed screw terminal Kefa KF135T-10.16-2P C475108 (65 A UL / 57 A IEC, 10 mm2, M4, 2 pins per pole in a 10.16 mm grid, hole 2.3 mm), new footprint ESP32-PDM:Kefa_KF135T-10.16-2P from the Kefa drawing (rev. A, 2021-03-16); no plug. Reason: every flange-locking socket that fits is out of stock or thin at LCSC (C577772 0, C6394053 4 on 2026-11-07). Accepted: on the DIN rail the screws face the neighbouring unit (wire before fitting the neighbour, decision 97's original workaround); removing a board means unscrewing the battery leads, so the feed is switched off first; polarity relies on the marking and on Q30's reverse-battery blocking (decision 82). With no pdm-4ch battery plug, the cross-board mis-plug question of T-0158 closes. Connector stock, including plug sets, is re-checked for the next revision. pdm-hc2 is unchanged (J10 keyed, decision 40; J11 C577772, decision 120). (owner, 2026-11-07) | confirmed |
| 122 | 2026-11-08 | system | Layout rule, both boards: **all SMT parts on one side** (top). A double-sided Standard PCBA job costs 33.77 USD more per order (setup 51.12 vs 25.56 USD, stencil 16.42 vs 8.21 USD; JLCPCB price page 2026-11-07). Through-hole connectors are hand-soldered (decision 85) and do not count. A part goes on the bottom only with an owner ruling. Lever L3 of `docs/reviews/2026-11-07-cost-system-2.md`. (owner, 2026-11-08) | confirmed |
| 123 | 2026-11-08 | mechanical | Refines decision 97: H1–H4 are M3 non-plated holes, one in each corner of each board. Both boards have the same length and the same hole spacing along the rail-side edge. The DIN mount is one solid 3D-printed ASA part (owner's Bambu P1S): a short version fastened to the two rail-side holes, and a long version that also reaches the two far corners for rigidity, in a 65 mm (4-ch) and a 75 mm (HC2) depth. The long version reaches the far holes along the board's short edges, not as a full plate behind the board, so the rail pitch stays about 36 mm per unit (a full plate adds about 2 mm). Nylon M3 screws and standoffs; nothing conductive reaches board copper (invariant 6). Layout rule: no copper and no parts within Ø 8 mm of each hole. The mount is drawn as a parametric OpenSCAD file after layout, from the board outline. (owner, 2026-11-08) | confirmed |
| 124 | 2026-11-08 | shared power-usb | C3 (+3V3 at L1 output) C377773 2.2uF/50V 0805 -> C170101 2.2uF/100V X7R 1206 on both boards; LMR51610 SLUSEY1B §8.2.2.5 gives no C_OUT max or ESR limit; unique parts -1 per board (T-0190) | auto |
| 125 | 2026-11-08 | pdm-hc2 | R105/R205 EN/UVLO top resistor 1 MΩ: C26083 0402 → C17927 1206 (±1 %, 1/4 W, 200 V; same part as R13), unique parts −1 (T-0191) | auto |
| 127 | 2026-11-08 | pdm-4ch | Amends decision 98 (and the J10 sample note of 121) for the pdm-4ch prototype: **no connector sample check before layout or order**. The checks of decision 98 (plugs one-way, J4 plug against the J5 socket, 36 mm rail pitch, J10 wire entry and M4 screw access, pin fit, reach from the edge) move to the first assembled boards; the connectors are hand-soldered (decision 85), so they are bought with the board order and a misfit costs a board revision, which decision 102 already expects. The layout covers the risks from the drawings: (1) each connector footprint is checked against the maker drawing and the JLCPCB/EasyEDA footprint in software; (2) J10 keeps a parts-free zone on both sides of its body, so the wire entry works whichever side the sample shows; (3) J4 and J5 apart on the edge, with "CAN" and "PANEL" and pin 1 on the silkscreen, and every connector's function and pin 1 marked; (4) a few mm of margin to the board edge beyond the drawing reach. The rail pitch is a soft goal, not a constraint: as small as practical, but it does not limit connector or layout choices; it is measured on the first boards and recorded. (owner, 2026-11-08) | confirmed |
| 128 | 2026-11-08 | pdm-4ch | First layout floorplan, fixing decision 123's shared figures: board **100 × 65 mm** (pdm-hc2 100 × 75 mm). One 100 mm long edge is the rail side, the other the front. Power connectors J10 (battery) and J11 (outputs) on one 65 mm short edge, signal connectors J5 (panel) and J4 (CAN) on the other: the two rows (42 + 55 mm) do not fit one 100 mm edge, and the split keeps the switching current away from the switch inputs and CAN. Power half (Q30/U30/D31, D30/C30 at J10, the four PROFETs, VS pour) at the power end; logic half (buck, CAN barrier, J6, D7/D8) at the signal end; ESP32 antenna at the front corner of the signal end, away from the rail and the switches. H1–H4 hole centres 4 mm from both edges: rail-side spacing **92 mm on both boards**, 57 mm across on pdm-4ch (67 mm on pdm-hc2). Skeleton `hardware/pdm-4ch/ESP32-PDM-4CH.kicad_pcb` (outline, 2 oz stackup, Ø 8 mm keep-outs). (owner, 2026-11-08) | confirmed |
| 129 | 2026-11-08 | system | Replaces the owner-merge step of decisions 23–24: **all work lands on `main` by itself.** `tools/land.py` merges origin/main into the branch, refuses duplicate decision numbers, pushes to main and fast-forwards a clean main checkout. The orchestrator lands `auto/pilot` after every committed task, after `inbox` and at the start and end of a run (`run --no-land` opts out; `orchestrate.py land` retries by hand); every Claude session, background worktree sessions included, lands its commits as soon as it commits (CLAUDE.md "Git"), so no `worktree-*` branch or PR waits for the owner. `docs/decisions.md` merges with `union` like the STATUS files. Reason: unmerged branches hid owner rulings from later sessions (the 2026-11-05 no-samples ruling was asked again on 2026-11-08) and made the owner merge by hand. Landing is a two-way door (revert, `undo`); ordering stays the one-way door, reviewed on `main`. (owner, 2026-11-08) | confirmed |
| 130 | 2026-11-08 | system | **PCB layout is done by the orchestrator.** New agent `pcb-fixer` lays out one stage of a board with `tools/kpcb.py` (KiCad 10's own Python: import from the schematic, place, zones, tracks, vias, text, DRC with schematic parity, render). `orchestrate.py pcb <board>` queues six stages (connectors and holes; power path; logic half; power copper; routing; silkscreen), then an EMC and a validator review; the planner may send layout-only items to pcb-fixer packages. Gates: schematic unchanged, parity 0, 0 DRC errors on the board, outline and hole keep-outs unchanged, no SMT on the bottom, no part in a hole keep-out, nothing parked after placement, nothing unconnected after routing. Placement and routing are two-way doors; bottom-side parts, outline/hole/connector-edge changes and ordering stay the owner's. The three combined-panel items deferred to the PCB phase (T-0025, T-0036, T-0093) are closed as settled (decision 102). (owner, 2026-11-08) | confirmed |
| 131 | 2026-11-08 | pdm-4ch | Power edge: J11 toward the front (origin 7.8/12.0), J10 toward the rail (origin 17.2/39.5), so the heavy M4 screw terminal sits beside the rail-side holes of the DIN mount; VBAT_IN upper pole, GND lower; front faces 0.5 mm inside the edge (T-0197) | auto |
| 132 | 2026-11-08 | pdm-4ch | J5 on the signal edge toward the rail (pin 1 at the rail end), leaving the front corner free for the ESP32 antenna; its nine SMA TVSs in two staggered columns (x 87.6 odd pins, x 79.5 even pins) with pad 2 toward the pin, then R34-R37/C14-C17 and the SW_SUPPLY chain D54-C54-D55-R56-F4 along y 38.3 (T-0197) | auto |
| 133 | 2026-11-08 | pdm-4ch | D30 vertical across the J10 rear VBAT_IN/GND pins and C30 beside it, both parallel to the edge; the J10 clear zone behind the terminal (x 20-35, y 33-56) holds only these low SMT parts (T-0197) | auto |
| 134 | 2026-11-08 | pdm-4ch | D103-D403 (DNP) at the J11 pins in two staggered columns (x 13.6/21.2), pad 2 toward the pin, leaving 6.6 mm gaps for the OUT copper (T-0197) | auto |
| 135 | 2026-11-09 | pdm-4ch | Battery path along the rail side behind the J10 clear zone: JP30 38.1/47 rot 180, Q30 48.2/47 rot 0 (drain toward C31 and the switches), D31 under Q30 at 48.2/56.2 spanning source and drain, C31 60.9/47, C32 42.5/35.9 (T-0198) | auto |
| 136 | 2026-11-09 | pdm-4ch | BTT6050 switches in a 2x2 grid (U11 32/9.2, U12 51/9.2, U14 32/25.8, U13 51/27.8), rot 180 with OUT pins toward J11; OUT2/OUT3 run in the inter-row corridor so no outputs cross (T-0198) | auto |
| 137 | 2026-11-09 | pdm-4ch | Per channel: VS caps C_n04/C_n03 side by side at the tab end, OUT parts beside the OUT pins, IN/DEN/IS/GND-network parts on the logic side; TH1 at U13's tab end (hottest switch, next to Q30) (T-0198) | auto |
| 138 | 2026-11-09 | pdm-4ch | Amends decision 128: pdm-4ch is **100 × 75 mm**, the same as pdm-hc2; the extra 10 mm is on the rail side (H3/H4 and their keep-outs at y 71, 4 mm from the rail edge; rail-side hole spacing stays 92 mm, 67 mm across on both boards). Reason: decision 128 forgot the Ø 8 mm hole keep-outs at the corners – the 65 mm signal edge left 49 mm for J5 + J4 (57 mm), and layout stage 3 (T-0199) found no room for the CAN block. One board size also means one long DIN mount depth (75 mm). JLCPCB prices boards up to 100 × 100 mm the same. (owner, 2026-11-09) | confirmed |
| 139 | 2026-11-09 | pdm-4ch | J5 and its protection cluster moved 7.4 mm toward the front, J4 below at 93.3/63.9 rot 90 (pin 1 at the rail end); both between the H2/H4 keep-outs with a 0.6 mm gap (decision 138) (T-0199) | auto |
| 140 | 2026-11-09 | pdm-4ch | U1 at 69.25/9.75 rot 0, antenna on the front edge in the signal-end corner; keep-out strip x 46.5-92, y 0-4.5 clear; channel 2 moved 2.6 mm toward the rail with its IS column beside the module (T-0199) | auto |
| 141 | 2026-11-09 | pdm-4ch | Buck along the rail edge: VS at D31 -> F1 -> R54 -> D1/D2 -> JP1 \|\| L2 -> C1/C19/U3 (upright, VIN in one row, loop about 3 mm) -> L1 -> C3 (T-0199) | auto |
| 142 | 2026-11-09 | pdm-4ch | CAN barrier block at J4: U5 at 71.5/56.5, GND_CAN island x >= 78.1 / y >= 51.4 with all bus-side parts and U6, parts-free band x 65-78.1 crossed only by C70 (T-0199) | auto |
| 143 | 2026-11-09 | pdm-4ch | USB J3 at the front edge in the power-end corner (15.2/4.2 rot 180); J6 upright at 55.2/55.1 on the logic side (no free 21 mm strip near U1) (T-0199) | auto |
| 144 | 2026-11-09 | pdm-4ch | Power copper as zones: VS priority 6 (bottom bands 7), VBAT_IN/VBAT_FL 5, OUT 4, GND_CAN 2, GND 1; 1.0 mm clearance on VS/VBAT_IN/VBAT_FL pours (EMC rule 7), 0.4 mm on OUT, 0.3 mm on GND (T-0200) (T-0200) | auto |
| 145 | 2026-11-09 | pdm-4ch | VS reaches the four PROFETs on the bottom layer: spine under U12/U13/Q30 plus a front band (U11) and a rear band (U14), joined to the 2.67 cm2 top drain pour by 40 vias; the corridor between the switch rows stays GND on the bottom (T-0200) (T-0200) | auto |
| 146 | 2026-11-09 | pdm-4ch | OUT1 on a bottom band with four vias at U11; OUT2/OUT3 on top through the corridor between the switch rows, OUT4 on top below D403; the J11 TVS returns reach J10.2 through a 3 mm GND strip along the power edge (T-0200) (T-0200) | auto |
| 147 | 2026-11-09 | pdm-4ch | GND and OUT1 pours connect pads solid instead of thermal reliefs (thermals starved 28 pads; GND carries no load current); VBAT_IN keeps 1.5 mm spokes for the hand-soldered J10 (T-0200) (T-0200) | auto |
| 148 | 2026-11-09 | pdm-4ch | C70 turned 180 deg so its GND_CAN pad faces the island; GND pour ends at x 67.6, GND_CAN at x 75.7 (8.1 mm across U5), 4.0 mm at the J5/J4 corner (T-0200) (T-0200) | auto |
| 149 | 2026-11-09 | pdm-4ch | JP30 stays the 2 x 2 mm top-layer net tie for the prototype (one square of 2 oz, about 64 mW at 16 A); a wider two-layer tie waits for the FL30 decision (T-0200) (T-0200) | auto |
| 150 | 2026-11-09 | pdm-4ch | **4 copper layers** instead of 2 (EMC review 2026-10-30, layout rule 3, never decided until now): F.Cu/B.Cu 2 oz carry all load current, In1.Cu a solid GND plane (GND_CAN its own area on the CAN side, split at the barrier per PCB rule 9), In2.Cu VS under the switches and Q30 for heat spreading and the surge path, the rest GND and spare routing; 1.6 mm, inner copper 0.5 oz (JLCPCB). Owner's JLCPCB quote 2026-11-09, 100 × 75 mm, 5 pcs: 2 layers €36.88, 4 layers €43.95 (+€7.07 per order). The 2-layer routing stage (T-0201) is superseded; placement and outer power copper (stages 1–4) stay. (owner, 2026-11-09) | confirmed |
| 151 | 2026-11-09 | pdm-4ch | In1.Cu solid GND plane with the outer GND outline (antenna notch, barrier cut at x 67.55, Ø 8.8 mm arcs around H1–H3) and a GND_CAN area equal to the outer island; barrier gap 8.1 mm across U5 on every layer (T-0205) | auto |
| 152 | 2026-11-09 | pdm-4ch | In2.Cu: VS (12.2 cm², pads solid) under U11–U14, Q30 drain, C31 and D31's VS side, which takes every PROFET thermal via and every VS via at the drain; the rest GND, and GND_CAN under the CAN island (T-0205) | auto |
| 153 | 2026-11-09 | pdm-4ch | Inner zones leave the hole (Ø 8.8 mm) and antenna areas out in their own outlines, because those rule areas cover only F.Cu/B.Cu (T-0205) | auto |
| 154 | 2026-11-09 | pdm-4ch | 90 stitching vias 0.8/0.4 mm: 34 board edge (about 5 mm), 5 GND_CAN edge, 12 around the buck, 8 around U1, 30 open-area grid, 1 island tie; every outer GND/GND_CAN island tied to In1 (T-0205) | auto |
| 155 | 2026-11-10 | pdm-4ch | Buck input loop closes on F.Cu through a 0.3 mm GND track from U3.2 under the SOT-23-6 body (between pins 3 and 4) to C19.2; FB stays on F.Cu and no via sits in the C1/C19/U3 loop (T-0207) | auto |
| 156 | 2026-11-10 | pdm-4ch | C2 and R43 moved into the L1-U3 corridor (17.3/61.5 rot 90, 17.3/63.45 rot 270) so the bootstrap link stays on F.Cu without crossing SW (T-0207) | auto |
| 157 | 2026-11-10 | pdm-4ch | R67 and R59 turned 180 degrees so the D8/D7 anode links are straight under the antenna strip and the +3V3/IO13 pads face outward (T-0207) | auto |
| 158 | 2026-11-10 | pdm-4ch | Nine tented GND stitching vias under the ESP32 module (around pad 61 and under the top GND pin row) (T-0207) | auto |
| 159 | 2026-11-10 | pdm-4ch | VS-B-spine and VS-In2 narrowed from x 61.0 to x 59.5 beside C31 (y 34.5-52.8): a side area with no VS pad or via, -27 mm2 B.Cu / -24 mm2 In2, drain rule met on F.Cu, heat budget unchanged; opens the U1-to-south corridor to x 59.5-67.5 (T-0208) | auto |
| 160 | 2026-11-10 | pdm-4ch | Six GND stitching vias removed from the U1 corridor and fan-out lanes, two re-added west of U1 at (59.9, 10.2) and (59.9, 15.6); In1 stays one piece (T-0208) | auto |
| 161 | 2026-11-10 | pdm-4ch | U1 fan-out vias sit under the module (tented, staggered at least 1.2 mm apart so In1 keeps webs) because the right pin column has only 1.3 mm to C50/C52/C53 (T-0208) | auto |
| 162 | 2026-11-10 | pdm-4ch | J6 service lines routed on In2 (IO35/36/37/42 the whole way, TXD0/RXD0 with a 5 mm B.Cu hop at J6 because their order swaps between U1 and J6) (T-0208) | auto |
| 163 | 2026-11-10 | pdm-4ch | **Routing as a reproducible build** (owner): one script (`hardware/pdm-4ch/scripts/build_routing.sh`, KiCad closed) rebuilds the routing on a copy. Locked copper (the stage 4–5 power copper, scripted links and the fixed routes in `scripts/fixed_routes.py`) stays; unlocked tracks and vias are removed; zone fills are cleared and the power zone outlines are keep-outs; Freerouting (headless) routes the signals only; then refill, stitching vias, dangling-via clean-up, pour-integrity check and DRC with parity. Several runs, keep the best clean one. Fixes go into the scripts, not hand edits on the board. Routing stages T-0209–T-0211 are rebriefed to this method; T-0207/T-0208 stay as landed. | confirmed |
| 164 | 2026-11-11 | pdm-4ch | Routing build: each power zone outline (VS, VBAT_IN, VBAT_FL, OUT1–4, VS-In2) goes to Freerouting as plane plus keep-out of the same outline, minus 0.5 mm escapes around foreign pads/vias/track ends; a plane alone let foreign tracks split the pours (T-0209) | auto |
| 165 | 2026-11-11 | pdm-4ch | Routing build: 0.35 mm board-edge keep-out strip for the router (copper ≥ 0.5 mm from the edge), signals barred from In1.Cu, buck SW/CB on F.Cu only (T-0209) | auto |
| 166 | 2026-11-11 | pdm-4ch | Routing build accepts a run only with 0 DRC errors, parity 0 and every power pour at its baseline island count and ≥ 98 % of its area; it replaces the board only when it has fewer unconnected items than the board at that moment (T-0209) | auto |
| 167 | 2026-11-11 | pdm-4ch | First build locked all existing copper (stage 4–5 power copper, T-0207/T-0208 links and fan-out); router tracks stay unlocked and are rebuilt each run; GND islands without a via get a tie-in via from the build (T-0209) | auto |
| 168 | 2026-11-11 | pdm-4ch | CAN pair: H/L side by side on F.Cu over GND_CAN; CANL_XCVR under FL1 on In2, CANH_BUS to J4.3 on B.Cu (vias 86.0/53.45, 85.1/58.05); CANL_XCVR tap through the R71/R72 slot with a 0.15 mm neck (T-0210) | auto |
| 169 | 2026-11-11 | pdm-4ch | USB pair crosses the VS block on B.Cu y 19.0/19.5 (x 17-46), F.Cu y 20.5/21.15 through the U12/U13 gap (x 46-58) and In2 east of x 57.5 (GND plane) to the U1 fan-out vias; ESD D5/D6 inline at J3 (T-0210) | auto |
| 170 | 2026-11-11 | pdm-4ch | No via under J3 inside OUT1-B (y 8.9-11.6): J3 end of the USB pair on F.Cu only, CC1 via above the pads, fixed GND ties at 18.05/13.0 and 20.55/12.25 (T-0210) | auto |
| 171 | 2026-11-11 | pdm-4ch | Landed the clean build with the pairs fixed at 78 unconnected (75 before) because the pairs are now fixed input; later builds compare against it (T-0210) | auto |
| 172 | 2026-11-11 | pdm-4ch | Amends decision 166: Routing build may put foreign signal vias (not tracks) through VS-In2 (In2 keep-out for tracks only); every power pour must stay at one island and keep >= 95 % of its baseline area (was 98 %); a placement stage may move the U1 transistor/resistor block (Q3-Q6, R17-R24/R50/R51) and the channel signal columns to make room; no corridor notch in VS-In2/OUT3-F; heat budget rechecked after the change (decision 9). (owner, 2026-11-11) (owner: Q-0070) | confirmed |
| 173 | 2026-11-12 | pdm-4ch | J6 service bundle (TXD0/RXD0/IO35-37/IO42) on In2 runs as nested L-routes down x 75.6-78.1 and west along y 32.6-35.1 instead of the stage-6b diagonal through the Q3-Q6 block (fixed_routes.py, T-0236) (T-0236) | auto |
| 174 | 2026-11-12 | pdm-4ch | R60 (VS -> VBAT_SENSE divider top) at 58.3/41.4 with its VS pad inside the VS-F-drain outline on the VS via column, so only the divided sense signal leaves the power area (T-0236) | auto |
| 175 | 2026-11-12 | pdm-4ch | Signal vias through VS-In2 (decision 172) alone gave no gain (79 vs 78): a through via also needs F.Cu and B.Cu room, and the VS-B spine/front/rear close the west channel pocket on B.Cu (T-0236) | auto |
| 176 | 2026-11-12 | pdm-4ch | Amends decision 172: Amends decision 172: In2 corridor. Signal tracks (not only vias) may run through the VS copper on In2.Cu only. F.Cu/B.Cu VS, the 16 A paths and the surge path stay unchanged. VS-In2 stays one piece, keeps every PROFET's thermal vias inside it and loses at most 15 % of its baseline area (the other pours keep >= 95 %). The heat budget at 40 C must pass (tools/heat_budget.py). Routing method: first fix the router export so the DSN has no built-in violations, and run several Freerouting runs per build. Route mostly by script: one channel's signal bus (sense, input, LED lines) is designed once through the In2 corridor and generated for the other three channels in scripts/fixed_routes.py. The J6 bundle, CAN, USB and the U1 fan-out stay fixed routes. Freerouting only fills the remaining short links, and if it cannot close them it is dropped and those links are scripted too. (owner: Q-0071) | confirmed |
| 177 | 2026-11-13 | pdm-4ch | Router export without built-in violations: router keep-outs get 0.25 mm holes round fixed copper, every placed pin gets clearance class PIN<class> (pin-pin 190 um, pin-wire = net class), fixed vias FIXV<class> (0 to pins); Freerouting loads with 0 pre-existing violations (was 723); no KiCad rule changed (T-0241, patch in scripts/) (T-0241) | auto |
| 178 | 2026-11-13 | pdm-4ch | In2 corridor rule (Q-0071): signal tracks may run on In2 inside VS-In2 only >= 1.5 mm inside its outline (internal slots, cannot split it) and never over a PROFET thermal-via field + 1 mm; per-pour check VS-In2 >= 1012.1 mm2 and 1 island, others >= 95 % and same islands; thermal_check requires all 40 thermal vias inside VS-In2 (T-0241) | auto |
| 179 | 2026-11-13 | pdm-4ch | Channel signal bus is generated per net by scripts/maze_route.py (grid A* 0.1 mm, class clearances, pour keep-outs) instead of one copied pattern: the destinations (D12-D15, U1) and the west-channel B.Cu pocket are not channel-symmetric, and channel 2's signal parts differ from channels 1/3/4 (T-0241) | auto |
| 180 | 2026-11-13 | pdm-4ch | Builds run 3 Freerouting runs but on a clean DSN the three strategies give identical results (spread 0); 15 passes suffice (state settles by pass 8) (T-0241) | auto |
| 181 | 2026-11-13 | pdm-4ch | Amends decision 176: Amends decision 176: Freerouting is dropped from the pdm-4ch routing build (the Q-0071 condition is met: after the export fix it still left short links open). scripts/T-0241-next-build.patch is applied and every remaining connection is routed by scripts/maze_route.py as fixed routes in fixed_routes.py: short local links first, then IO2-IO5, then the SW_IN lanes, plus the J3 VBUS/D3-A legs from design-notes 8.18. In2 runs stay >= 0.9 mm off GND THT pads. The board is still the build output (decision 163), and the pour, thermal-via and heat-budget checks stay. To give SW_IN1 and SW_IN4 their own exits, the channel 1 and channel 4 small-signal parts (sense/input resistors, diodes, capacitors; not the PROFETs or any power part) move out of the west B.Cu pocket toward U1. No via in VS-B-front/rear and no change to F.Cu/B.Cu power copper. (owner: Q-0072) | confirmed |
| 182 | 2026-11-13 | pdm-4ch | Freerouting removed from the build (Q-0072): build_routing.sh = prep + routing_build.py apply <work> - (refill, clean-up, stitching, pour/thermal checks) + DRC, one deterministic run; the T-0236 build-2 copper (696 tracks, 109 vias) is kept verbatim as a generated block in fixed_routes.py so the build reproduces the board (T-0246) | auto |
| 183 | 2026-11-13 | pdm-4ch | T-0241 generated channel bus dropped from fixed_routes.py (generated on a base without the kept copper); remaining links come from maze_route.py passes on the current board, one build per pass (T-0246) | auto |
| 184 | 2026-11-13 | pdm-4ch | ch1/ch4 classification for the pocket move: R101/R102/R104/C101/R103/R107/D102 (and 4xx) movable; R105/D101 stay as the PROFET GND return path, with C102/R106/D103 (OUT) and C103/C104 (VS) (T-0246) | auto |
| 185 | 2026-11-13 | pdm-4ch | maze pass 2 (314 lines for 1 item) not kept: maze_route.py legs do not merge new copper into the source side and duplicate connections (T-0246) | auto |
| 186 | 2026-11-13 | pdm-4ch | Routing build: routing_build.finish() runs prune(), which removes dangling signal tracks/vias (KiCad connectivity; a via only when it touches at most one item), never power/GND copper (T-0250) (T-0253) | auto |
| 187 | 2026-11-13 | pdm-4ch | maze_route.py emits each net's class width (+3V3 0.3 mm) with keep-outs sized for it, and ends legs at least one grid cell inside their copper; prep widens identical locked tracks to the fixed_routes.py width, never narrows (T-0251) (T-0253) | auto |
| 188 | 2026-11-13 | pdm-4ch | +3V3 maze copper widened to 0.3 mm; two necks stay 0.2 mm beside GND vias (In2 65.7,59.9-65.8,59.7; B.Cu 45.9,68.1-46.2,68.2; 0.6 mm total, <0.1 A) (T-0253) | auto |
| 189 | 2026-11-13 | pdm-4ch | pdm-4ch routing continues within the decision 172 limits (Q-0070), with no corridor notch. Steps: (1) fix maze_route.py so that a net's later legs start from the copper already laid (no duplicate copper); (2) move the ch1/ch4 signal parts R101/R102/R103/R104/R107/C101/D102 and their 4xx twins toward U1; (3) run more maze passes, one build per pass. R105/D101 (PROFET GND return), the OUT parts and the VS parts stay in place. 'In progress' with fewer unconnected items counts as progress. The work goes back to the owner only if a stage gains nothing or needs a one-way door: power copper outlines, connectors, the board outline or the schematic. (owner, 2026-11-13) (owner: Q-0073) | confirmed |
| 190 | 2026-11-13 | pdm-4ch | maze_route.py: a routed leg's cells join the source side, so later legs start from the copper already laid (no duplicates: 87 lines vs 314); a failed leg re-seeds from the next open cluster (T-0259, decision 185) (T-0259) | auto |
| 191 | 2026-11-13 | pdm-4ch | ch1/ch4 move by script (fixed_routes.PLACE, routing_build.prep move_parts): R101/R102/R401/R402 at 180 deg with PROFET-side pads facing their pins (straight links), R103/R107/R403/R407 at 270 deg with IS pads on top, GND bottom pads tied by 0.4 mm links and GND vias (42.9,11.6)/(42.9,28.2) (T-0259) (T-0259) | auto |
| 192 | 2026-11-13 | pdm-4ch | DEN R102.1-R402.1 routed F -> B.Cu pocket (x 42.1) -> In2 slot inside VS-In2 -> F -> B; VS-In2 1156.4 mm2, 1 island, 40/40 thermal vias (T-0259) (T-0259) | auto |
| 193 | 2026-11-13 | pdm-4ch | ch4 DEN via moved off pad R402.1 to (38.60, 25.42) with a 45-degree F.Cu link, keeping the GND-F neck to R403.1 open; /DEN added to fixed_routes.DROP_NETS so the build owns all /DEN copper (T-0266) (T-0266) | auto |
| 194 | 2026-11-13 | pdm-4ch | Amends decision 189: Amends decision 189: the VS-In2 east edge is pulled back about 2-3 mm at y 5-20, which gives one In2 -> B.Cu via column at x 55-57 as the west-pocket exit for SW_IN1/SW_IN4, IO2, IO5 and DEN to U1. The VS-B spine, the other VS outlines and the 16 A path stay unchanged. VS-In2 stays one island, >= 1012.1 mm2 (decision 178), with all 40 thermal vias inside. The corridor stays >= 1.5 mm inside the new edge, and the heat budget is rechecked (decision 9). Routing then continues as in Q-0073: the ch2/ch3 IN/DEN links, U1.28 and the DEN via off R402.1 are two-way steps, and the work returns to the owner only when a stage gains nothing or needs another one-way door. (owner, 2026-11-13) (owner: Q-0074) | confirmed |
| 195 | 2026-11-14 | pdm-4ch | Q-0074 VS-In2 east-edge trim not applied: with the corridor band centred on the outline no In2 run can reach a via column outside the trimmed edge, so the trim gains nothing (T-0271, design-notes 8.21) (T-0271) | auto |
| 196 | 2026-11-14 | pdm-4ch | ch2: U12-DEN link through the middle gap (y 11.30) into R202.2 from below; R202.1 /DEN leaves north to an In2 via at (59.40, 10.60) and runs on In2 under U1 to U1.28 (T-0271) (T-0271) | auto |
| 197 | 2026-11-14 | pdm-4ch | U1.28 /DEN leaves north on F past the IO35 fan-out via to a via at (72.50, 17.50); the Q3-B track under the U1 bottom row stays (T-0271) (T-0271) | auto |
| 198 | 2026-11-14 | pdm-4ch | ch3: U13-IN link through the middle gap (y 27.30) into R301.2 from above, freeing R301.1 /SW_IN3 to the south; R302.1 stays boxed by the C301.2 GND via (T-0271) (T-0271) | auto |
| 199 | 2026-11-14 | pdm-4ch | Amends decision 194: Amends decision 194: instead of the Q-0074 east-edge trim (dropped, not needed), the pdm-4ch west-pocket In2 runs (SW_IN1/SW_IN4, IO2, IO5, DEN R102.1/R402.1) get one marked exit at y 5-20, where they may cross the VS-In2 east edge into a via column at x 56.3-57 (option (a) of T-0271 / design-notes 8.21). VS-In2 is notched there only as much as the runs need. It stays one island, >= 1012.1 mm2, with all 40 thermal vias inside, and the heat budget is rechecked (decision 9). The VS-B spine and every other power outline stay unchanged: no spine notch and no vias in the x 46.15 strip. Routing then continues as ruled in Q-0073, and the work returns to the owner only when a stage gains nothing or needs another one-way door. (owner, 2026-11-14) (owner: Q-0075) | confirmed |
| 200 | 2026-11-14 | pdm-4ch | Marked In2 exit (Q-0075): maze_route.py EXIT_WINDOW x 55.0-57.0, y 6.45-20 for SW_IN1/SW_IN4/IO2/IO5/DEN only; band unchanged elsewhere (T-0276) (T-0276) | auto |
| 201 | 2026-11-14 | pdm-4ch | VS-In2 notch x 55.6-56.5, y 14.9-16.5 (column via + 0.5 mm zone clearance), applied by routing_build.prep from fixed_routes.VS_IN2_NOTCH; VS-In2 1133.4 mm2, 1 island, 40/40 thermal vias (T-0276) (T-0276) | auto |
| 202 | 2026-11-14 | pdm-4ch | maze_route.py via mask keeps vias a zone clearance + via radius outside foreign power-pour outlines (was 0.25 mm) (T-0276) (T-0276) | auto |
| 203 | 2026-11-14 | pdm-4ch | DEN via column at (56.45, 15.70); B north along x 56.36 to the DEN drop (59.40, 10.60) (T-0276) (T-0276) | auto |
| 204 | 2026-11-14 | pdm-4ch | ch3 links shifted one gap south (U13-DEN middle, U13-IN south), C301.2 GND via moved 0.16 mm to (56.78, 25.30); R302.1 /DEN to a via at (57.45, 25.95) and the DEN column; R301.1 boxed again (D14.3 unreachable) (T-0276) (T-0276) | auto |
| 205 | 2026-11-14 | pdm-4ch | IO2/IO5 through the exit and the +3V3 B runs under U1 not kept: they split GND-B/GND-F pours (island gate) (T-0276) (T-0276) | auto |
| 206 | 2026-11-14 | pdm-4ch | Amends decision 172: Amends decision 172: for the pdm-4ch routing (T-0218) agents may reroute any signal copper without asking (two-way from now on): the IO4/NTC/VBAT_SENSE copper by U1, the J6 In2 service bundle (decision 173 route) and other signal links. Where a signal route still splits a GND pour on F.Cu or B.Cu (IO2, IO5, +3V3 under U1), the new GND fragment is allowed if at least 2 vias tie it to the GND-In1 plane; unstitched slivers are removed, so no floating copper, and GND-In1 stays one piece. D12-D15 may move a few mm (added to the decision 189 move list) if rerouting the J6 bundle is not enough. Power copper stays as ruled (decision 172, the Q-0075 notch only), the heat budget is rechecked (decision 9), and connectors, the outline and the schematic stay unchanged. Routing then continues as ruled in Q-0073, and the work returns to the owner only when a stage gains nothing or needs another one-way door. (owner, 2026-11-14) (owner: Q-0076) | confirmed |
| 207 | 2026-11-14 | pdm-4ch | Q-0076 build gate: a GND-F/GND-B island with < 2 ties (GND vias/THT pads in the GND-In1 fill) is accepted only on a fragment of the board before the build or of the T-0281 start board (scripts/gnd_weak_q0076.json); new weak islands get stitching vias up to 2, else the build fails; GND-In1 exactly 1 island; every other pour checked against the board before the build (islands not more, area >= 95 %); VS-In2 keeps its own gate (T-0281) (T-0281) | auto |
| 208 | 2026-11-14 | pdm-4ch | IO2/IO5 through the marked exit: column vias x 56.50 y 16.60/17.50, nested B lanes to F vias (60.2, 12.8)/(60.2, 14.0); VS_IN2_NOTCH grown to y 18.3 (decision 199); VS-In2 1093.8 mm2, 1 island, 40/40 thermal vias, Tj 101 C (T-0281) (T-0281) | auto |
| 209 | 2026-11-14 | pdm-4ch | ch3 R302.1 /DEN B lane into the exit column removed for IO2/IO5; R302.1 open again because an In2 leg from the DEN drop isolates the GND-In2 under U1 (T-0281) (T-0281) | auto |
| 210 | 2026-11-14 | pdm-4ch | +3V3 maze legs under U1 kept (5 -> 1 unconnected); 5 new GND-F/B fragments each stitched by 2 vias to In1 (T-0281) (T-0281) | auto |
| 211 | 2026-11-14 | pdm-4ch | D12-D15 not moved and J6 bundle not rerouted: SW_IN2/SW_IN3 are boxed at R201.1/R301.1, SW_IN1/SW_IN4 have no free exit-column via; a move gains nothing (T-0281) (T-0281) | auto |
| 212 | 2026-11-14 | pdm-4ch | Amends decision 206: Standing rule for the rest of the pdm-4ch routing (T-0218), replacing case-by-case questions. Agents may, without asking: (1) move any small signal part (resistors, capacitors, small-signal diodes incl. D12-D15/D102-D402, the Q3-Q6 block, R60 and similar, and the ch2/ch3 blocks R201/R202 and R301/R302) and reroute any signal copper; (2) grow the In2 exit window and its VS-In2 notch as the runs need (widens decision 199), as long as VS-In2 stays one island, >= 1012.1 mm2, with all 40 thermal vias, and the heat budget is rechecked (decision 9); (3) leave GND fragments on F.Cu, B.Cu and In2 when each is tied to GND-In1 by >= 2 vias (no floating copper; GND-In1 stays one island). Fixed, owner only: connectors, U11-U14, U1, Q30/U30/D30/D31, the buck, the 16 A/battery/surge paths, all other power-pour outlines, holes, board outline and schematic. Work continues until 0 unconnected and returns only when a stage gains nothing or needs a fixed item. (owner, 2026-11-14) (owner: Q-0077) | confirmed |
