plektra/ESP32-PDM/docs/ROADMAP.md

# Roadmap

Generated by `tools/orchestrate.py` from `docs/queue.json` – do not edit. Updated 2026-11-14 20:34. Policy: `docs/AUTONOMY.md`.

**Now:** nothing running · **Up next:** 3 packages · **Done:** 65 packages (97 items) · **Failed:** 1 · **Waiting for you:** 0 (`docs/OWNER-INBOX.md`) · **Deferred:** 23

## Board size

| Board | Parts | DNP | Unique fitted parts | Since the agents started |
|---|---|---|---|---|
| pdm-4ch | 227 | 20 | 59 | +60 parts, +20 DNP, +1 unique |
| pdm-hc2 | 241 | 16 | 63 | +72 parts, +16 DNP, -3 unique |

Every unique extended part costs a loading fee per order; DNP parts cost nothing but board space.

## Plan

```mermaid
flowchart LR
  T0064["T-0064 · shared<br/>Battery input bulk/HF caps and output s…"]:::done
  T0065["T-0065 · shared<br/>Shared supply, USB and fuse parts (buck…"]:::done
  T0066["T-0066 · shared<br/>Custom footprints in lib/ (TDSO-14 past…"]:::done
  T0067["T-0067 · shared<br/>CAN sheet: barrier Y-cap/CMC footprints…"]:::done
  T0068["T-0068 · shared<br/>Panel interface (analog_sw): debounce, …"]:::done
  T0069["T-0069 · pdm-4ch<br/>Channel sense resistor, DEN rule, popul…"]:::done
  T0070["T-0070 · pdm-hc2<br/>HC2 gate slew control (inrush, EMC edge…"]:::done
  T0071["T-0071 · pdm-hc2<br/>HC2 controller pin filtering (VS RC, CS…"]:::done
  T0072["T-0072 · shared<br/>HC2 breaker level, float-run OUT divide…"]:::done
  T0073["T-0073 · shared<br/>BOM LCSC codes and controller notes (VB…"]:::done
  T0078["T-0078 · shared<br/>U5 CA-IS3050G: TXD/RXD pin numbers 2/3 …"]:::done
  T0082["T-0082 · sync<br/>HC2 heat-budget RDS(on) at 150 C per BS…"]:::done
  T0084["T-0084 · sync<br/>HC2 heat-budget RDS(on) at 150 C - veri…"]:::done
  T0085["T-0085 · sync<br/>Sync the  For /system  lists"]:::done
  T0104["T-0104 · shared<br/>PTC interrupt rating: F1/F3/F4 100 A PT…"]:::done
  T0105["T-0105 · shared<br/>Panel switch loads R3/R4/R7/R8 -  2 k +…"]:::done
  T0106["T-0106 · pdm-hc2<br/>Short EMC gate slew, maximum load capac…"]:::done
  T0107["T-0107 · shared<br/>Extended-part fee levers: C18 -  C9196,…"]:::done
  T0108["T-0108 · shared<br/>README installation guidance (text only)"]:::done
  T0118["T-0118 · shared<br/>PTC interrupt rating: C70113 on F1-F4 p…"]:::done
  T0119["T-0119 · shared<br/>USB shield capacitor C18 to 1 nF/2 kV C…"]:::done
  T0120["T-0120 · pdm-4ch<br/>pdm-4ch VS-tab capacitors C104-C404 to …"]:::done
  T0121["T-0121 · pdm-4ch<br/>pdm-4ch reverse-battery blocking on VS …"]:::done
  T0132["T-0132 · pdm-4ch<br/>Q30 AGM601LL swap check (swap only if i…"]:::done
  T0137["T-0137 · pdm-4ch<br/>TVS across Q30 for negative transients …"]:::done
  T0141["T-0141 · sync<br/>Sync the  For /system  lists"]:::done
  T0143["T-0143 · pdm-4ch<br/>Fit SMDJ40CA across Q30, record the res…"]:::done
  T0147["T-0147 · sync<br/>Sync the  For /system  lists"]:::done
  T0156["T-0156 · sync<br/>Sync the  For /system  lists"]:::done
  T0158["T-0158 · pdm-4ch<br/>pdm-4ch 16 A input: J10 set and Q30 re-…"]:::done
  T0159["T-0159 · shared<br/>Merge near-duplicate BOM lines"]:::done
  T0160["T-0160 · shared<br/>Sign-of-life LEDs, spare GPIO and seria…"]:::done
  T0161["T-0161 · shared<br/>Buck input filter position"]:::done
  T0171["T-0171 · pdm-4ch<br/>pdm-4ch J10 socket C577772: stock fallb…"]:::done
  T0179["T-0179 · shared<br/>C577772 + C577752 set: buying rule and …"]:::done
  T0180["T-0180 · pdm-hc2<br/>HC2 turn-off edge: R116/R216 trial on t…"]:::done
  T0185["T-0185 · sync<br/>Sync the  For /system  lists"]:::done
  T0186["T-0186 · sync<br/>Sync the  For /system  lists"]:::done
  T0190["T-0190 · shared<br/>Shared power-usb: C3 to C170101 (cost l…"]:::done
  T0191["T-0191 · pdm-hc2<br/>HC2 EN/UVLO top resistors R105/R205 to …"]:::done
  T0196["T-0196 · sync<br/>Sync the  For /system  lists"]:::done
  T0197["T-0197 · pdm-4ch<br/>Place connectors and mounting holes"]:::done
  T0198["T-0198 · pdm-4ch<br/>Place the power path and output channels"]:::done
  T0199["T-0199 · pdm-4ch<br/>Place the logic half and all remaining …"]:::done
  T0200["T-0200 · pdm-4ch<br/>Power copper: pours and wide paths"]:::done
  T0201["T-0201 · pdm-4ch<br/>Route all remaining connections"]:::done
  T0202["T-0202 · pdm-4ch<br/>Silkscreen, markings and a clean DRC"]:::ready
  T0205["T-0205 · pdm-4ch<br/>4-layer planes and stitching vias"]:::done
  T0206["T-0206 · pdm-4ch<br/>Route all remaining connections on 4 la…"]:::done
  T0207["T-0207 · pdm-4ch<br/>Route the short local links and ground …"]:::done
  T0208["T-0208 · pdm-4ch<br/>Make room in the U1 strip and fan out U1"]:::done
  T0209["T-0209 · pdm-4ch<br/>Routing build script and the U1 strip"]:::done
  T0210["T-0210 · pdm-4ch<br/>CAN and USB pairs as fixed routes, rebu…"]:::done
  T0211["T-0211 · pdm-4ch<br/>Close the last connections by build"]:::ready
  T0214["T-0214 · pdm-4ch<br/>pdm-4ch: CAN/USB/CC1 fixed routes and L…"]:::done
  T0221["T-0221 · pdm-4ch<br/>pdm-4ch: confirm the routing scripts ga…"]:::done
  T0226["T-0226 · pdm-4ch<br/>pdm-4ch routing: signal vias through VS…"]:::failed
  T0231["T-0231 · pdm-4ch<br/>pdm-4ch routing: signal vias through VS…"]:::done
  T0236["T-0236 · pdm-4ch<br/>pdm-4ch routing: build with signal vias…"]:::done
  T0241["T-0241 · pdm-4ch<br/>pdm-4ch routing: clean router export, I…"]:::done
  T0246["T-0246 · pdm-4ch<br/>pdm-4ch routing: ch1/ch4 signal parts o…"]:::done
  T0253["T-0253 · pdm-4ch<br/>pdm-4ch routing scripts: remove danglin…"]:::done
  T0259["T-0259 · pdm-4ch<br/>pdm-4ch routing: maze_route merge fix, …"]:::done
  T0260["T-0260 · sync<br/>pdm-4ch +3V3 neck wording in design-not…"]:::done
  T0266["T-0266 · pdm-4ch<br/>pdm-4ch: move the ch4 DEN via off pad R…"]:::done
  T0271["T-0271 · pdm-4ch<br/>pdm-4ch: trim VS-In2 east edge for the …"]:::done
  T0276["T-0276 · pdm-4ch<br/>pdm-4ch: marked In2 exit across the VS-…"]:::done
  T0281["T-0281 · pdm-4ch<br/>pdm-4ch: stitched GND-F/B fragments, fr…"]:::done
  T0288["T-0288 · pdm-4ch<br/>pdm-4ch routing to 0 unconnected under …"]:::ready
  T0074["T-0074 · pdm-4ch<br/>re-check after its packages"]:::done
  T0075["T-0075 · pdm-hc2<br/>re-check after its packages"]:::done
  T0079["T-0079 · pdm-4ch<br/>re-check after its packages"]:::done
  T0080["T-0080 · pdm-hc2<br/>re-check after its packages"]:::done
  T0109["T-0109 · pdm-4ch<br/>re-check after its packages"]:::done
  T0110["T-0110 · pdm-hc2<br/>re-check after its packages"]:::done
  T0111["T-0111 · system<br/>re-check after its packages"]:::done
  T0112["T-0112 · system<br/>re-check after its packages"]:::done
  T0122["T-0122 · pdm-4ch<br/>re-check after its packages"]:::done
  T0123["T-0123 · pdm-hc2<br/>re-check after its packages"]:::done
  T0124["T-0124 · system<br/>re-check after its packages"]:::done
  T0125["T-0125 · system<br/>re-check after its packages"]:::done
  T0133["T-0133 · pdm-4ch<br/>re-check after its packages"]:::done
  T0134["T-0134 · system<br/>re-check after its packages"]:::done
  T0135["T-0135 · system<br/>re-check after its packages"]:::done
  T0138["T-0138 · pdm-4ch<br/>re-check after its packages"]:::done
  T0139["T-0139 · system<br/>re-check after its packages"]:::done
  T0140["T-0140 · system<br/>re-check after its packages"]:::done
  T0144["T-0144 · pdm-4ch<br/>re-check after its packages"]:::done
  T0145["T-0145 · system<br/>re-check after its packages"]:::done
  T0146["T-0146 · system<br/>re-check after its packages"]:::done
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
  T0190 --> T0191
  T0197 --> T0198
  T0198 --> T0199
  T0199 --> T0200
  T0200 --> T0201
  T0211 --> T0202
  T0200 --> T0205
  T0205 --> T0206
  T0205 --> T0207
  T0207 --> T0208
  T0208 --> T0209
  T0209 --> T0210
  T0210 --> T0211
  T0259 --> T0260
  classDef done fill:#d8f0dc,stroke:#2e7d32
  classDef running fill:#d6e6ff,stroke:#1f5fbf
  classDef ready fill:#f2f2f2,stroke:#888
  classDef failed fill:#f9d9d9,stroke:#b3261e
```

Green done · blue running · grey waiting · red failed. Arrows: must finish first.

## Up next – what will change

### T-0202 · pdm-4ch · Silkscreen, markings and a clean DRC

Waiting after T-0211.

<details><summary>Planner's brief</summary>

Layout rules: the board's STATUS.md ("Next" PCB items, PCB rule 9, the pre-order checklist), decisions 122 (all SMT on top), 123 (holes, Ø 8 mm keep-outs), 127 (connector margins, J10 clear zone, labels), 128 (floorplan), the "Layout rules" sections of the EMC reports in docs/reviews/, and ARCHITECTURE invariants 4 and 6. Silkscreen: BATTERY and polarity at J10, function labels and pin 1 at every connector, PANEL and CAN at J5/J4, the board name, version and date. References readable, nothing on pads. Refill zones; 0 DRC errors, 0 unconnected, then record in STATUS.md what the layout does and what the bring-up should check.

</details>

### T-0211 · pdm-4ch · Close the last connections by build

Waiting after T-0218.

<details><summary>Planner's brief</summary>

Layout rules: the board's STATUS.md ("Next" PCB items, PCB rule 9, the pre-order checklist), decisions 122 (all SMT on top), 123 (holes, Ø 8 mm keep-outs), 127 (connector margins, J10 clear zone, labels), 128 (floorplan), the "Layout rules" sections of the EMC reports in docs/reviews/, and ARCHITECTURE invariants 4 and 6. Method (decision 163, owner): routing is a reproducible build, not hand edits. One command, `hardware/pdm-4ch/scripts/build_routing.sh [runs]`, run with KiCad closed under KiCad's own Python (pcbnew; it exports Specctra DSN and imports SES, kicad-cli cannot), works on a temp copy of the project and copies a board in only when it is better and clean. Steps: (1) fixed copper = every LOCKED track, via and zone: the stage 4–5 power copper and the scripted links of T-0207/T-0208 (lock them once, in the first build) plus the fixed tracks listed in `scripts/fixed_routes.py` (pairs, tight escapes; coordinates in mm, the place where hand-made routing lives); all UNLOCKED tracks and vias are removed before each build; (2) clear every zone fill, keep the power zone outlines (VS, VBAT_IN, VBAT_FL, OUT1–4, VS-In2) as keep-outs for foreign nets, In1 barred for signals, the antenna, CAN-barrier, JP30/JP1 and hole keep-outs on all layers; (3) Freerouting 2.5.0 headless (`~/.local/opt/jdk-25.0.4.1+1/Contents/Home/bin/java -Djava.awt.headless=true -jar ~/.local/opt/freerouting-2.5.0/freerouting-2.5.0.jar --gui.enabled=false -de in.dsn -do out.ses -mt 1`) routes the signals only; (4) import the SES, then pour: refill every zone, add GND stitching vias, remove dangling vias and stubs; (5) check: no power pour split, no starved thermal, `kpcb drc` with parity; (6) Freerouting differs per run: do several runs (up to 3 in parallel, in the background, each in its own folder) and keep the one with 0 DRC errors and the fewest unconnected. A problem the router leaves is fixed by adding fixed routes or a part move to the scripts and rebuilding, never by editing only the board. Each Freerouting run takes 15–20 min: start runs early and hand in within the 90-min limit. Record the method and the script usage in the board's STATUS.md and design-notes. Rules: no signal on In1.Cu; buck SW/CB/input loop on F.Cu with no via in the C1/C19/U3 loop; nothing across the CAN barrier; power pours stay whole. Earlier failures: docs/reviews/2026-11-10-fix-pdm-4ch-T-0206-rejected.md. Add fixed routes or the smallest two-way part move for every connection still open, rebuild until a run has 0 unconnected and 0 DRC errors, and commit the scripts with the board. A one-way door goes to the owner. Finish with 0 unconnected and 0 DRC errors.

</details>

### T-0288 · pdm-4ch · pdm-4ch routing to 0 unconnected under the Q-0077 standing rule

Waiting.

- MAJOR · 0 unconnected is not reachable under the stage rules: the west channel signals (27 items) are walled in by th… → your ruling: Standing rule for the rest of T-0218 (replaces case-by-case questions). Agents may, without asking: (1) move any small signal part (resistors, capacitors, smal…

<details><summary>Planner's brief</summary>

Layout only (board file via tools/kpcb.py and the routing scripts; plus STATUS.md and design-notes). Start from the current board: T-0281 build b6, 37 unconnected, 0 DRC errors, parity 0. Owner ruling Q-0077, verbatim: "Standing rule for the rest of T-0218 (replaces case-by-case questions). Agents may, without asking: (1) move any small signal part (resistors, capacitors, small-signal diodes incl. D12-D15/D102-D402, the Q3-Q6 block, R60 and similar), including the ch2/ch3 blocks R201/R202 and R301/R302, and reroute any signal copper; (2) grow the In2 exit window and its VS-In2 notch as the runs need, if VS-In2 stays one island, >= 1012.1 mm2, with all 40 thermal vias inside, and the heat budget is rechecked (decision 9); (3) leave GND fragments on F.Cu, B.Cu and In2 when each is tied to GND-In1 by >= 2 vias (no floating copper; GND-In1 stays one island). Fixed, owner only: connectors, PROFETs U11-U14, U1, Q30/U30/D30/D31, the buck, the 16 A/battery/surge paths, all other power-pour outlines, holes, board outline, schematic. Keep going until 0 unconnected; return only when a stage gains nothing or needs one of the fixed items." Order: (a) Update the routing_build.py gate to the ruling. GND fragments are now allowed on In2 as well as F/B when each has >= 2 ties to GND-In1, so the GND-In2 'keep island count' check becomes the same >= 2-tie check (this lifts the T-0281 b2/b4/b5 rejection only if the cut-off GND-In2 under U1 gets 2 stitching vias). GND-In1 stays exactly 1 island. No floating copper. Every power pour other than VS-In2 keeps its outline unchanged. VS-In2 gate: 1 island, >= 1012.1 mm2, 40/40 thermal vias. (b) Move the ch2/ch3 resistor blocks R201/R202 and R301/R302 (and nearby small parts as needed) to free the R201.1/R301.1 exits. Route SW_IN2/SW_IN3 and ch3 R302.1 /DEN (this also clears T-0285). (c) Grow EXIT_WINDOW/VS_IN2_NOTCH (fixed_routes.py) only as far as SW_IN1/SW_IN4 need, or move D12-D15 to give them via spots. The VS-B spine and the x 45.5-46.8 strip stay untouched, because they are 'other power-pour outlines'. (d) Run maze passes on the U1 strip and the analog block (GND, Q4-B/Q4-E/Q5-E, F2-Pad1, IO*, EN, NTC, VBAT_SENSE, D3-A, SW*, +3V3), moving Q3-Q6, R60 and other small parts where that helps. Build once per pass and keep only builds that reduce unconnected. Checks after every kept build: kpcb drc with 0 errors and parity 0; fix_check --role pcb-fixer; pour gates as above; no SMT part on the bottom; no part in a hole keep-out. After any VS-In2 change, run tools/heat_budget.py at 40 C (Tj report as in T-0281). Record each step's auto decisions. Stop and return (one-way door) if the next gain needs any fixed item: a connector, U11-U14, U1, Q30/U30/D30/D31, the buck, a 16 A/battery/surge path, a power-pour outline other than the VS-In2 notch, a hole, the outline, the schematic, or a bottom-side part. Also stop if VS-In2 would fall below 1012.1 mm2, lose a thermal via or split, if GND-In1 would split, or if the heat budget fails. Return as well when a whole stage gains nothing. Safety: 16 A and surge paths stay unchanged, and a competent person reviews the board before installation.

</details>

## Done

| Package | Scope | What | Items | Board growth | Model | Cost | Merged |
|---|---|---|---|---|---|---|---|
| T-0064 | shared | Battery input bulk/HF caps and output surge protection (inv… | 4 | – | opus | 4.12 USD | `dbc672cd` |
| T-0065 | shared | Shared supply, USB and fuse parts (buck caps, USB shield/ES… | 6 | – | opus | 12.15 USD | `e5fedd96` |
| T-0066 | shared | Custom footprints in lib/ (TDSO-14 paste, LMR51610 -> SOT-2… | 2 | – | opus | 1.58 USD | `14b42e65` |
| T-0067 | shared | CAN sheet: barrier Y-cap/CMC footprints, TXD pull-up, CA-IS… | 5 | – | opus | 6.74 USD | `5ffcfb6f` |
| T-0068 | shared | Panel interface (analog_sw): debounce, switch-load resistor… | 6 | pdm-4ch +1 parts (+0 DNP), +1 unique, pdm-hc2 +1 parts (+0 DNP), +1 unique | opus | 2.66 USD | `86fbfe03` |
| T-0069 | pdm-4ch | Channel sense resistor, DEN rule, population rule | 4 | pdm-4ch +4 parts (+4 DNP), +0 unique | sonnet | 0.62 USD | `b9fcef31` |
| T-0070 | pdm-hc2 | HC2 gate slew control (inrush, EMC edges) | 4 | no part changes | opus | 1.65 USD | `c036d2a6` |
| T-0071 | pdm-hc2 | HC2 controller pin filtering (VS RC, CS/EN/OV/IWRN filters,… | 3 | pdm-hc2 +16 parts (+4 DNP), +0 unique | opus | 5.14 USD | `80bb3bd1` |
| T-0072 | shared | HC2 breaker level, float-run OUT divider, reverse-battery d… | 4 | – | opus | 3.99 USD | `c036d2a6` |
| T-0073 | shared | BOM LCSC codes and controller notes (VBAT full scale, IO3 s… | 6 | pdm-4ch +0 parts (+0 DNP), -4 unique, pdm-hc2 +0 parts (+0 DNP), -5 unique | opus | 1.13 USD | `1939dfbc` |
| T-0078 | shared | U5 CA-IS3050G: TXD/RXD pin numbers 2/3 swapped (both boards) | 1 | no part changes | opus | 0.51 USD | `d42065e2` |
| T-0082 | sync | HC2 heat-budget RDS(on) at 150 C per BSC030N08NS5 Diagram 9 | 1 | no part changes | opus | 0.24 USD | `24bf9f3b` |
| T-0084 | sync | HC2 heat-budget RDS(on) at 150 C - verify T-0082 sync and c… | 1 | no part changes | opus | 0.15 USD | `24bf9f3b` |
| T-0085 | sync | Sync the "For /system" lists | 0 | no part changes | opus | 0.71 USD |  |
| T-0104 | shared | PTC interrupt rating: F1/F3/F4 100 A PTC + series resistor,… | 1 | no part changes | opus | 3.21 USD | `3b24acd6` |
| T-0105 | shared | Panel switch loads R3/R4/R7/R8 -> 2 k + 2 k basic | 1 | pdm-4ch +4 parts (+0 DNP), +0 unique, pdm-hc2 +4 parts (+0 DNP), +0 unique | opus | 1.49 USD | `849fc1d6` |
| T-0106 | pdm-hc2 | Short EMC gate slew, maximum load capacitance, HC2 load gui… | 4 | pdm-hc2 +6 parts (+0 DNP), +0 unique | opus | 3.28 USD | `c036d2a6` |
| T-0107 | shared | Extended-part fee levers: C18 -> C9196, RIS -> 2 x C4410, 1… | 4 | pdm-4ch +4 parts (+0 DNP), +0 unique, pdm-hc2 +0 parts (+0 DNP), -1 unique | opus | 3.21 USD | `196bdd9c` |
| T-0108 | shared | README installation guidance (text only) | 1 | no part changes | opus | 0.25 USD | `c9bce1a7` |
| T-0118 | shared | PTC interrupt rating: C70113 on F1-F4 plus 0.2 ohm series r… | 1 | pdm-4ch +3 parts (+0 DNP), +0 unique, pdm-hc2 +3 parts (+0 DNP), +0 unique | opus | 1.81 USD | `3b24acd6` |
| T-0119 | shared | USB shield capacitor C18 to 1 nF/2 kV C9196 | 2 | pdm-4ch +0 parts (+0 DNP), -1 unique, pdm-hc2 +0 parts (+0 DNP), -1 unique | opus | 0.47 USD | `196bdd9c` |
| T-0120 | pdm-4ch | pdm-4ch VS-tab capacitors C104-C404 to 2.2 uF/100 V C170101 | 2 | pdm-4ch +0 parts (+0 DNP), -1 unique | opus | 0.41 USD | `70cdd9cf` |
| T-0121 | pdm-4ch | pdm-4ch reverse-battery blocking on VS in front of the bulk… | 1 | pdm-4ch +3 parts (+0 DNP), +2 unique | opus | 4.44 USD | `f1f3f88b` |
| T-0132 | pdm-4ch | Q30 AGM601LL swap check (swap only if it passes) and design… | 2 | no part changes | opus | 7.06 USD | `605f3305` |
| T-0137 | pdm-4ch | TVS across Q30 for negative transients with VS charged | 1 | no part changes | opus | 4.12 USD | `9cda47c8` |
| T-0141 | sync | Sync the "For /system" lists | 0 | no part changes | opus | 0.80 USD |  |
| T-0143 | pdm-4ch | Fit SMDJ40CA across Q30, record the residual risk and the p… | 1 | pdm-4ch +1 parts (+0 DNP), +1 unique | opus | 1.94 USD | `9cda47c8` |
| T-0147 | sync | Sync the "For /system" lists | 0 | no part changes | opus | 0.76 USD |  |
| T-0156 | sync | Sync the "For /system" lists | 0 | no part changes | opus | 0.61 USD |  |
| T-0158 | pdm-4ch | pdm-4ch 16 A input: J10 set and Q30 re-selection | 1 | no part changes | opus | 2.93 USD | `232c3185` |
| T-0159 | shared | Merge near-duplicate BOM lines | 1 | pdm-4ch +0 parts (+0 DNP), -3 unique, pdm-hc2 +0 parts (+0 DNP), -4 unique | opus | 3.01 USD | `698cbf87` |
| T-0160 | shared | Sign-of-life LEDs, spare GPIO and serial console access | 3 | pdm-4ch +5 parts (+1 DNP), +1 unique, pdm-hc2 +5 parts (+1 DNP), +1 unique | opus | 4.13 USD | `c01c3a6d` |
| T-0161 | shared | Buck input filter position | 1 | pdm-4ch +4 parts (+4 DNP), +0 unique, pdm-hc2 +4 parts (+4 DNP), +0 unique | opus | 5.08 USD | `9024407b` |
| T-0171 | pdm-4ch | pdm-4ch J10 socket C577772: stock fallback for the order | 3 | no part changes | opus | 0.97 USD | `ac1c0481` |
| T-0179 | shared | C577772 + C577752 set: buying rule and interchangeable-plug… | 3 | no part changes | opus | 0.44 USD | `ac1c0481` |
| T-0180 | pdm-hc2 | HC2 turn-off edge: R116/R216 trial on the pre-compliance sc… | 1 | no part changes | opus | 0.28 USD | `147034f0` |
| T-0185 | sync | Sync the "For /system" lists | 0 | no part changes | opus | 0.65 USD |  |
| T-0186 | sync | Sync the "For /system" lists | 0 | no part changes | opus | 0.53 USD |  |
| T-0190 | shared | Shared power-usb: C3 to C170101 (cost lever L5) | 1 | pdm-4ch +0 parts (+0 DNP), -1 unique, pdm-hc2 +0 parts (+0 DNP), -1 unique | opus | 0.97 USD | `ca774491` |
| T-0191 | pdm-hc2 | HC2 EN/UVLO top resistors R105/R205 to C17927 (cost lever L… | 1 | pdm-hc2 +0 parts (+0 DNP), -1 unique | opus | 0.46 USD | `93a72d3b` |
| T-0196 | sync | Sync the "For /system" lists | 0 | no part changes | opus | 0.33 USD |  |
| T-0197 | pdm-4ch | Place connectors and mounting holes | 0 | no part changes | opus | 2.17 USD |  |
| T-0198 | pdm-4ch | Place the power path and output channels | 0 | no part changes | opus | 3.48 USD |  |
| T-0199 | pdm-4ch | Place the logic half and all remaining parts | 0 | no part changes | opus | 24.23 USD |  |
| T-0200 | pdm-4ch | Power copper: pours and wide paths | 0 | no part changes | opus | 4.34 USD |  |
| T-0201 | pdm-4ch | Route all remaining connections | 0 | – | opus | 6.33 USD |  |
| T-0205 | pdm-4ch | 4-layer planes and stitching vias | 0 | no part changes | opus | 2.44 USD |  |
| T-0206 | pdm-4ch | Route all remaining connections on 4 layers | 0 | – | opus | 4.46 USD |  |
| T-0207 | pdm-4ch | Route the short local links and ground vias | 0 | no part changes | opus | 7.04 USD |  |
| T-0208 | pdm-4ch | Make room in the U1 strip and fan out U1 | 0 | no part changes | opus | 5.29 USD |  |
| T-0209 | pdm-4ch | Routing build script and the U1 strip | 0 | no part changes | opus | 3.54 USD |  |
| T-0210 | pdm-4ch | CAN and USB pairs as fixed routes, rebuild | 0 | no part changes | opus | 5.93 USD |  |
| T-0214 | pdm-4ch | pdm-4ch: CAN/USB/CC1 fixed routes and LAND_BEST into the ro… | 1 | no part changes | opus | 0.57 USD | `746f3880` |
| T-0221 | pdm-4ch | pdm-4ch: confirm the routing scripts gate is open and the T… | 1 | no part changes | opus | 0.21 USD | `1c5d7eb3` |
| T-0231 | pdm-4ch | pdm-4ch routing: signal vias through VS-In2 and placement r… | 1 | no part changes | opus | 0.94 USD | `` |
| T-0236 | pdm-4ch | pdm-4ch routing: build with signal vias through VS-In2, pla… | 1 | no part changes | opus | 4.82 USD | `` |
| T-0241 | pdm-4ch | pdm-4ch routing: clean router export, In2 signal corridor t… | 1 | no part changes | opus | 7.17 USD | `` |
| T-0246 | pdm-4ch | pdm-4ch routing: ch1/ch4 signal parts out of the west pocke… | 1 | no part changes | opus | 1.95 USD | `` |
| T-0253 | pdm-4ch | pdm-4ch routing scripts: remove dangling maze copper and em… | 2 | no part changes | opus | 3.81 USD | `f6b7742b` |
| T-0259 | pdm-4ch | pdm-4ch routing: maze_route merge fix, ch1/ch4 signal parts… | 1 | no part changes | opus | 12.97 USD | `` |
| T-0260 | sync | pdm-4ch +3V3 neck wording in design-notes and STATUS | 1 | no part changes | opus | 0.52 USD | `277a83e0` |
| T-0266 | pdm-4ch | pdm-4ch: move the ch4 DEN via off pad R402.1 | 1 | no part changes | opus | 1.54 USD | `64f4ea02` |
| T-0271 | pdm-4ch | pdm-4ch: trim VS-In2 east edge for the west-pocket exit to … | 1 | no part changes | opus | 7.34 USD | `` |
| T-0276 | pdm-4ch | pdm-4ch: marked In2 exit across the VS-In2 east edge (y 5-2… | 1 | no part changes | opus | 8.50 USD | `` |
| T-0281 | pdm-4ch | pdm-4ch: stitched GND-F/B fragments, free signal rerouting,… | 1 | no part changes | opus | 9.63 USD | `` |
| T-0226 | pdm-4ch | pdm-4ch routing: signal vias through VS-In2, placement room… | 1 | failed: no report written (unknown): timeout after 5400 s | opus | 0.00 USD |  |

Undo a package: `python3 tools/orchestrate.py undo <item>` (any of its items).

## Deferred

**Until order** (12)

- Order 30 instead of 10 per run: -6.05 $/board (4-ch), -7.00 $/board (HC2); 10 instead of 5 saves -9.0/-9.8 $
- USB-C as DNP or pogo pads removes 3 extended fees and ~0.27 $ parts: -1.30 $/board at 10 (overlaps L3)
- How many pdm-4ch and pdm-hc2 boards per order (5, 10, 30)? This is the largest cost lever
- Is a fitted USB-C service connector required, or are pads/DNP plus OTA enough (L4)?
- TPS48110A stock is 989 and L1 1231, both single-source or thin; nothing is below 500
- 30 instead of 10 boards per order saves 6.38 USD (4-ch) / 7.12 USD (HC2) per board; 10 instead of 5 saves 9.4…
- Hand-soldering the four through-hole connectors removes 4 extended fees and the THT labour: 16.2 USD per orde…
- USB-C as service pads on later runs saves 3 extended fees and parts: 1.20 USD per board at 10
- A monthly JLCPCB assembly coupon may waive the 8.18 USD setup per order (conditions for 2 oz and Economic PCB…
- Should the first order use the free-assembly coupon (L6) or hand-soldered connectors (L3)?
- C13832 removal costs 0.162 USD per board against a 3.07 USD fee per order, so it pays only up to about 19 boa…
- C170101 instead of C13832 saves the loading fee only below about 14 boards per order; above that C13832 is ch…

**Until owner** (4)

- 52/59 unique parts cost 1.53 $ each only under Standard PCBA; merging package variants would save ~9 $ per or…
- Does JLCPCB accept 2 oz copper with Economic PCBA? If not, Standard PCBA adds +5.1 $ (4-ch) / +5.6 $ (HC2) pe…
- C30 swap to 2.2 uF C170101 adds about 0.054 USD per board on pdm-4ch with no fee saved, because C13832 stays …
- ch3 /DEN link (routed in T-0276) is open again after the IO2/IO5 column took its lane; ch3 DEN pin would floa…

**Until prototype** (3)

- LMR51610YF (FPWM, same 1.1 MHz) would avoid PFM noise below 350 kHz; E7 asks for a scan first.
- LMR51610XDBVR (400 kHz, C20539658, 0.52 $) instead of the Y variant (1.35 $): -0.83 $/board; needs a re-desig…
- SH-ESP32 uses the same 60 V PTC without a series resistor; removing R54-R56 would save one line, about 2-3 US…

**Until system-mechanical** (4)

- Board ground reaches the battery negative through one terminal pole that carries TVS surge current and, on HC…
- Fixed screw terminals instead of pluggable header + plug: about -1.0 $/board (the plug halves alone cost 1.20…
- Pluggable or fixed screw terminals (L5)?
- SH-ESP32 fits standard 100 x 68 x 50 mm waterproof enclosures; pdm-4ch at about 100 x 65 mm is close, which c…
