plektra/ESP32-PDM/docs/OWNER-INBOX.md

# Owner inbox

One-way doors the agents may not decide themselves (decision 23, `docs/AUTONOMY.md`). Write your ruling on each
question's Answer line – `yes` (do the proposed fix), `no` (drop it) or your own ruling in words – or use `/inbox`.
The next `tools/orchestrate.py run` (or `inbox`) applies the answers. Below the questions: what the agents decided
(two-way doors), each with its undo command. This file is regenerated from `docs/queue.json`: only the Answer
lines are read; other edits are lost.

No open questions.

## Decided by agents (4) – two-way doors

Undo any of them with `python3 tools/orchestrate.py undo <task>`: it comes back above as a question.

- T-0130 · INFO · system · Do negative supply transients below -30 V occur on the Vega battery bus (inductive loads switched on the same bus)? → assumed No; treat E18 as documentation only and take no hardware action
- T-0128 · INFO · pdm-4ch · Accept a Q30 with 1.25 mΩ instead of 0.75 mΩ if the heat budget passes (L1)? → assumed yes, if Tj stays within the existing margin
- T-0101 · INFO · system · What does JLCPCB quote for the real board outline in 2 oz at 5, 10 and 30 pieces once layout exists? → assumed Keep the estimate of 15 / 20 / 38 USD per order
- T-0100 · INFO · system · Does the JLCPCB quote page offer Economic PCBA with 2 oz copper (Q-0026 is still open)? → assumed Assume Economic PCBA; if only Standard, per board at 10 add 6.2 USD (4-ch) / 7.4 USD (HC2)

## Applied by agents (75)

Undo with `python3 tools/orchestrate.py undo <task>`: reverts the whole work package.

- T-0264 · pdm-4ch · Open 0.3 mm via sits inside the 0402 pad R402.1; solder wicks away, risking an open joint and loss of ch4 DEN/diagnosis → T-0266 (`64f4ea02`)
- T-0257 · pdm-4ch · Text says the +3V3 necks feed only clamp diodes and pull-ups, but +3V3 also feeds U5 VCC1, L1 output caps and later U1.3; topology behind the necks not traced → T-0260 (`277a83e0`)
- T-0251 · pdm-4ch · 160 mm of +3V3 at 0.2 mm, below 0.3 mm v3 class; currents <0.1 A so no failure, known to the fixer → T-0253 (`f6b7742b`)
- T-0250 · pdm-4ch · Maze pass 1 left 13 dangling vias/track stubs (none in base); no short, 0 DRC errors → T-0253 (`f6b7742b`)
- T-0219 · pdm-4ch · the pcb-fixer merge gate still rejects hardware/pdm-4ch/scripts/ (T-0210 finding), so fixed routes cannot be added to fixed_routes.py as decision 163 requires; needs a /system gate change or a package scoped to scripts/ → T-0221 (`1c5d7eb3`)
- T-0212 · pdm-4ch · pcb-fixer merge gate admits only the board file and notes; the fixed_routes.py entries for the CAN/USB/CC1 routes and LAND_BEST=1 in build_routing.sh are held back as a patch in this report and need a package whose scope covers hardware/pdm-4ch/scripts/ (the routes themselves are locked copper on th → T-0214 (`746f3880`)
- T-0188 · pdm-hc2 · R105/R205 to C17927 1M 1206 (already R13) removes C26083 from the HC2 BOM: 1.53 USD per order, higher voltage rating on VS → T-0191 (`93a72d3b`)
- T-0187 · system · C3 to C170101 2.2uF/100V X7R 1206 (already on both BOMs) removes one line per board: 1.53 USD per order, +0.08 USD per part → T-0190 (`ca774491`)
- T-0177 · system · The pdm-4ch battery plug fits an HC2 output socket and puts battery minus on OUT2, so turning channel 2 on is a dead short through Q21/Q22 (outside the calculated SOA from hot); the README still says all connectors are keyed. → T-0179 (`ac1c0481`)
- T-0176 · pdm-hc2 · HC2 turn-off is not slewed (PD direct, R(PD) 0.69-1.34 Ω into about 10 nF): the output steps 28 V in tens of ns, about 500 V/µs, against 0.76 V/µs at turn-on, so a switch-off can click the VHF receiver. → T-0180 (`147034f0`)
- T-0169 · pdm-4ch · J10 socket C577772 is out of stock at JLCPCB (stock 0, min order 18), so the battery input cannot be assembled as designed until restocked. → T-0171 (`9d4e6dd8`)
- T-0168 · pdm-4ch · May C577772 be bought when it is back in stock, with C577767 as fallback after a footprint check? → T-0179 (`ac1c0481`)
- T-0167 · pdm-4ch · T-0158 saves about 4.8 $ per board at 5 (Q30 2.7 $, J10 set 2.2 $) with no new extended part; confirmed → T-0171 (`9d4e6dd8`)
- T-0166 · pdm-4ch · C577772 shows stock 0 (MOQ 18) on 2026-11-07; STATUS says 40, and pdm-hc2 J11 uses the same code → T-0179 (`ac1c0481`)
- T-0153 · system · The buck input has capacitors but no LC filter position; SH-ESP32 uses an inductor with damping to limit conducted noise → T-0161 (`9024407b`)
- T-0152 · system · The serial console is unconnected, so a firmware crash that takes native USB down leaves no diagnostics → T-0160 (`c01c3a6d`)
- T-0151 · system · Spare GPIOs are unconnected, so later design changes have nowhere to attach without a new PCB → T-0160 (`c01c3a6d`)
- T-0150 · system · The boards have no on-board LED, so a new board gives no sign of life without firmware and a panel (SH-ESP32 comparison in the cost report) → T-0160 (`c01c3a6d`)
- T-0149 · system · Standard PCBA charges 1.53 USD per unique line, so near-duplicate values cost about 6 USD (4-ch) and 7.65 USD (HC2) per order → T-0159 (`698cbf87`)
- T-0148 · pdm-4ch · Decision 103 makes the first pdm-4ch 16 A only, all BTT6050, but J10 is still the 65 A 10.16 mm set and Q30 the 0.75 mOhm IPT007N06N sized for 32 A → T-0158 (`232c3185`)
- T-0129 · pdm-4ch · A negative transient clamped by D30 at about -48.4 V while VS is charged puts about 77 V across Q30 (60 V rated, avalanche); design-notes states VDS <= 48.4 V. → T-0143 (`9cda47c8`)
- T-0126 · pdm-4ch · Q30 is the most expensive new part (3.06 USD at 10 boards); AGM601LL C5464765 (TOLL-8L, 60 V, 1.25 mΩ, 0.85 USD) would save about 2.2 USD per board if the heat budget still passes → T-0132 (`605f3305`)
- T-0115 · pdm-4ch · May pdm-4ch C104-C404 change to C170101 (already open from T-0107)? It removes C13832 from the 4ch BOM (-3.07 USD per order) and is cheaper up to about 9 boards → T-0120 (`70cdd9cf`)
- T-0099 · system · Using C170101 for the 1 uF/100 V places removes the C13832 fee; pays only for runs of fewer than 9 (4-ch) or 15 (HC2) boards → T-0120 (`70cdd9cf`)
- T-0098 · pdm-4ch · RIS 680 ohm 1206 C17975 (extended) replaced by two 1 kohm 1206 C4410 (basic) in parallel: 0.26 USD per board at 10, sense scale 0.33 V/A → T-0107 (`d6c2bb6e`)
- T-0096 · system · 4.7 nF/1 kV C107198 (extended) to 1 nF/2 kV C9196 (basic): 0.31 USD per board at 10, RC corner 34 Hz to 160 Hz → T-0119 (`196bdd9c`)
- T-0090 · system · Two avoidable extended-part types: 4.7 nF/1 kV USB-shield capacitor and the 680 ohm 1206 RIS, 3.07 USD per order and design each → T-0119 (`196bdd9c`)
- T-0089 · system · The cable practice that the immunity design assumes (screened panel cable with drain at the PDM end, bundled battery pair away from VHF coax, load returns to the battery negative bus, diode at inductive loads, PWM limits, N2K drop length) is not in the README. → T-0108 (`c9bce1a7`)
- T-0088 · system · The VS bulk capacitors are polarised aluminium electrolytics with no reverse rating in their datasheet and nothing in front of them at J10, while the README says pdm-4ch survives a reversed battery of up to 28 V for 2 min; a reversed battery can overheat and vent C31. → T-0121 (`f1f3f88b`)
- T-0076 · pdm-4ch · U5 pins 2 and 3 are swapped: datasheet (CA-IS305x v1.10 p. 5 Fig. 6-1/Table 6-1) has pin 2 = RXD, pin 3 = TXD; symbol and netlist have 2 = TXD on IO17 and 3 = RXD on IO18, so ESP32 TX drives the isolator's RXD output and CAN cannot work. → T-0078 (`d42065e2`)
- T-0062 · pdm-hc2 · Should the HC2 hardware breaker sit near the continuous rating (about 17.5 A) or stay at 25 A with a documented external breaker requirement? Is an OUT voltage divider (spare IO4/IO5) wanted for float-run detection, or are SW3/SW4 enough? → T-0072 (`901c6f45`)
- T-0061 · pdm-hc2 · Which HC2 loads have more than about 50 uF input capacitance (LED work-light drivers, radios, inverter)? Sets whether gate slew control is needed and its inrush target. → T-0106 (`c036d2a6`)
- T-0060 · pdm-hc2 · IO3 strapping pin is held low by the IMON2 network; harmless while EFUSE_STRAP_JTAG_SEL is not burnt (same as V11 on pdm-4ch). → T-0073 (`1939dfbc`)
- T-0059 · pdm-hc2 · First switch-on after power-up waits about 76-100 ms for the bootstrap (Eq. 1), also on the hardware switch path; overcurrent/short retry is about 3.8 min, reset by toggling INP. → T-0070 (`9d0b6d53`)
- T-0058 · pdm-hc2 · Section 1 still names TPS48111-Q1 and 8-20 A; section 9 says an OUT voltage divider lets the PDM see float-driven runs, but no such divider exists and IMON cannot see that current. → T-0072 (`901c6f45`)
- T-0057 · pdm-hc2 · RDS(on) at 150 C is 11.2 mOhm in the tool; BSC030N08NS5 Diagram 9 max (5.35 mOhm) gives 2 x 5.35 + 1 = 11.7 mOhm; 15 A rises from 87 to 88 C, 20 A from 137 to 143 C; rating stands. → T-0082 (`24bf9f3b`)
- T-0056 · pdm-hc2 · No 1 nF bypass across the MMBT3904 remote sensor; TPS4811-Q1 section 9.6.1 says it must be placed (EMC E4 lists it only as a tune-in-test footprint). → T-0071 (`80bb3bd1`)
- T-0055 · pdm-hc2 · Reversed battery puts about -12...-30 V on TPS48110 VS/CS+/CS-/ISCP (abs max -1 V to GND); D30 SMCJ30CA is bidirectional and HC2 has no reverse protection; design-notes section 8 survival claim does not apply to HC2. → T-0072 (`901c6f45`)
- T-0054 · pdm-hc2 · MOSFETs switch fully on in under 1 us, so a load with more than about 50-100 uF input capacitance probably exceeds the 71-91 A short-circuit threshold for longer than 4-5 us; the channel then stays off for 3.8 min (estimate, UNVERIFIED). → T-0106 (`c036d2a6`)
- T-0053 · pdm-hc2 · Hardware breaker at about 24-26 A (146 ms) and OT trip at 140-160 C at the sensor leave about 18-24 A unprotected in hardware; heat budget gives Tj 137-143 C at 20 A and 169 C at 22 A against MOSFET Tj max 150 C, so only firmware protects when the ESP32 runs. → T-0106 (`c036d2a6`)
- T-0052 · pdm-4ch · Should DEN be held high in Active mode, or pulsed only while sampling IS? V1 (RIS overload on fault or open output) depends on it. → T-0069 (`b9fcef31`)
- T-0051 · pdm-4ch · IO3 (JTAG source strap) is tied low through 10.7 k; harmless unless EFUSE_STRAP_JTAG_SEL is burnt. → T-0073 (`1939dfbc`)
- T-0050 · pdm-4ch · 'Switches survive with the ground network' holds only for VS(REV) 28 V, t < 2 min, RL >= 12 ohm (P_4.1.2); at 4 A the body diode dissipates about 2.4 W > PTOT 1.6 W. → T-0068 (`86fbfe03`)
- T-0049 · pdm-4ch · With reversed battery, the panel LEDs see about 24-30 V reverse (cathode held near 0 V by R19 and the Q collector-base junction); typical LED VR is 5 V. → T-0068 (`86fbfe03`)
- T-0048 · pdm-4ch · No external pull-up on ISO1044 TXD; TI says not to rely on the internal one, and GPIO17 has a 60 us low glitch at power-up, which can put a dominant pulse on the N2K bus. → T-0067 (`5ffcfb6f`)
- T-0047 · pdm-4ch · p_other 0.6 W omits about 1.5 W of panel-interface dissipation at 30 V (switch loads, dividers, LED sinks); Tj rises from 100 to 101 C at 4 A, so the rating stands. → T-0068 (`86fbfe03`)
- T-0046 · pdm-4ch · 0.19 W continuous at 30 V in a 0.25 W part (77 %), 0.49 W during a 48 V clamp. → T-0105 (`849fc1d6`)
- T-0045 · pdm-4ch · Pads are 1.81 x 0.61 mm at x = +/-1.15 (inner edges under the body) instead of TI DBV0006A 1.1 x 0.6 mm at +/-1.3; numbering is correct. → T-0066 (`14b42e65`)
- T-0044 · pdm-4ch · Paste apertures overlap the open 0.3 mm thermal vias, so solder wicks into the vias (voids under the VS tab). → T-0066 (`14b42e65`)
- T-0043 · pdm-4ch · ESP32-S3 ADC calibrated range is 0-2900 mV (datasheet v2.2 Table 5-6), so VBAT full scale is 31.9 V, not 33 V; 30 V still reads. → T-0073 (`1939dfbc`)
- T-0042 · pdm-4ch · At SWIN 10.5 V with the 3.3 V rail down, IN minus device GND is about 1.8-2.0 V once ON, against VIN(H) min 2.0 V; the claimed 0.4 V margin does not hold (UNVERIFIED zener knee). → T-0068 (`86fbfe03`)
- T-0041 · pdm-4ch · IS fault current (6/15/40 mA, P_7.5.7) into 680 ohm dissipates 0.15 W typ / ~1.1 W max in a 0.1 W 0603 whenever DEN is high and a channel is faulted, including an unconnected output floating up in OFF (open-load-in-OFF). → T-0069 (`b9fcef31`)
- T-0040 · pdm-4ch · Standard population for Vega's pdm-4ch: all BTT6050 (24.87 $) or a 2+2 mix with BTT6010 (28.58 $ at 10)? → T-0069 (`b9fcef31`)
- T-0039 · system · Must the isolated CAN side stay powered from NET-S? If not, an isolated CAN part with integrated isolated supply could also remove the TPS7B91/FB2/D11 chain → T-0067 (`5ffcfb6f`)
- T-0033 · pdm-hc2 · Removing R1/R2 on HC2 saves only ~0.01 $/board; recommendation is to keep the controller part identical → T-0073 (`1939dfbc`)
- T-0032 · pdm-4ch · Each BTT6010 channel adds 1.57 $ at 10 and a mixed build adds one 3.07 $ fee per order (2+2 mix: +3.71 $/board); fit BTT6010 only where > 4 A and order mixed builds together → T-0069 (`b9fcef31`)
- T-0031 · system · No basic NTC exists; an MMBT3904 diode sensor (preferred) would remove one extended fee: -0.32 $/board at 10, at the cost of accuracy and calibration → T-0073 (`1939dfbc`)
- T-0030 · system · CA-IS3050G (C528763, 5 kV RMS, 0.92 $ at 10+) instead of ISO1044 (1.62 $): -0.71 $/board, second source; different package/pinout → T-0067 (`5ffcfb6f`)
- T-0026 · system · Four basic/preferred swaps remove 4 extended fees: FB->GZ2012D601TF C1017, F2->1812L050/60GR, PESD0402V05->H5VL10B C7420372, TPS7B91->L78M05ABDT C58069 → T-0065 (`e5fedd96`)
- T-0022 · system · Nothing is below 500 in stock, but TPS48110A (999), L1 SWPA6045S8R2MT (1231) and BTT6050 (1748) are thin and single-source; the EMC option LMR51610YF has only 458 → T-0065 (`e5fedd96`)

## Deferred (23)

- T-0016 · system · Board ground reaches the battery negative through one terminal pole that carries TVS surge current and, on HC2, motor freewheel current (up to 25 A per channel); its rating is not defined. → until system-mechanical: Q-0010: GND pole(s) at J10 rated like the VS input are chosen with the terminal blocks in /system mechanical; wide GND copper to J10.2 is a PCB-phase rule
- T-0020 · system · LMR51610YF (FPWM, same 1.1 MHz) would avoid PFM noise below 350 kHz; E7 asks for a scan first. → until prototype: Q-0013: swap to LMR51610YF only if the pre-compliance scan of the first prototypes shows PFM noise; check price and stock then
- T-0023 · system · 52/59 unique parts cost 1.53 $ each only under Standard PCBA; merging package variants would save ~9 $ per order then → until owner: Q-0016: merge 100 nF / 1 uF package variants only if the owner's check (T-0034) shows Standard PCBA is forced
- T-0024 · system · Order 30 instead of 10 per run: -6.05 $/board (4-ch), -7.00 $/board (HC2); 10 instead of 5 saves -9.0/-9.8 $ → until order: Q-0017: 5 + 5 for the first order; revisit the quantity for later runs
- T-0027 · system · USB-C as DNP or pogo pads removes 3 extended fees and ~0.27 $ parts: -1.30 $/board at 10 (overlaps L3) → until order: Q-0020: no change now, USB-C stays fitted on prototypes; revisit DNP/pogo pads for later runs
- T-0028 · system · Fixed screw terminals instead of pluggable header + plug: about -1.0 $/board (the plug halves alone cost 1.20 $) → until system-mechanical: Q-0021: pluggable vs fixed terminals for J4/J5 is decided in /system mechanical
- T-0029 · system · LMR51610XDBVR (400 kHz, C20539658, 0.52 $) instead of the Y variant (1.35 $): -0.83 $/board; needs a re-designed L/C and conflicts with EMC lever L1 → until prototype: Q-0022: no for now, keep LMR51610Y; revisit the 400 kHz X variant after the pre-compliance scan
- T-0034 · system · Does JLCPCB accept 2 oz copper with Economic PCBA? If not, Standard PCBA adds +5.1 $ (4-ch) / +5.6 $ (HC2) per board at 10 → until owner: Q-0026: the owner checks the JLCPCB quote page (2 oz + Economic PCBA) before layout
- T-0035 · system · How many pdm-4ch and pdm-hc2 boards per order (5, 10, 30)? This is the largest cost lever → until order: Q-0027: 5 pdm-4ch + 5 pdm-hc2 for the first order; applies when ordering
- T-0037 · system · Is a fitted USB-C service connector required, or are pads/DNP plus OTA enough (L4)? → until order: Q-0029: USB-C fitted on the prototype run; reconsider DNP/pogo pads plus OTA for later runs
- T-0038 · system · Pluggable or fixed screw terminals (L5)? → until system-mechanical: Q-0030: terminal type for J4/J5/J10/J11 decided in /system mechanical with the J10 pole sizing (leaning pluggable J4/J5, fixed J10/J11)
- T-0091 · system · TPS48110A stock is 989 and L1 1231, both single-source or thin; nothing is below 500 → until order: Stock re-check of TPS48110A (989) and L1 SWPA6045S8R2MT (1231) only means something on the day of the order. It is already on both STATUS pre-order checklists, and the L1 alternates are on file (decision 49).
- T-0092 · system · 30 instead of 10 boards per order saves 6.38 USD (4-ch) / 7.12 USD (HC2) per board; 10 instead of 5 saves 9.46 / 9.93 USD → until order: First order 5 pdm-4ch + 5 pdm-hc2, quantity revisited for later runs: already decision 33. Nothing changes in the design; applied when the order is placed.
- T-0094 · system · Hand-soldering the four through-hole connectors removes 4 extended fees and the THT labour: 16.2 USD per order and design (1.62 USD per board at 10) → until order: J4, J5, J10 and J11 are left off the PCBA order and hand-soldered by the owner. This is done when the order's BOM/CPL is made. J5/J10/J11 are not chosen yet: /system mechanical should pick hand-solderable through-hole terminals (J10/J11 carry 40-50 A, so joint quality matters).
- T-0095 · system · USB-C as service pads on later runs saves 3 extended fees and parts: 1.20 USD per board at 10 → until order: Ruled 'no': USB-C (J3 and its protection) stays fitted on every run, with no DNP/pogo-pad variant. There is nothing to change in the design or docs; the decision row amends decision 31. Each order's BOM keeps J3, F2, C18, R13, D4-D6 and FB1.
- T-0097 · system · A monthly JLCPCB assembly coupon may waive the 8.18 USD setup per order (conditions for 2 oz and Economic PCBA unverified) → until order: Owner action: check the JLCPCB coupon centre and the cart (2 oz, Economic PCBA conditions) at order time.
- T-0102 · system · Should the first order use the free-assembly coupon (L6) or hand-soldered connectors (L3)? → until order: Economic PCBA without J4/J5/J10/J11 (hand-soldered, ruling Q-0057) plus the coupon check (ruling Q-0059). These are the same order-time actions as T-0094 and T-0097, done once at the order.
- T-0113 · pdm-4ch · C30 swap to 2.2 uF C170101 adds about 0.054 USD per board on pdm-4ch with no fee saved, because C13832 stays at C104-C404 → until owner: No change now. The pdm-4ch C30 C170101 swap costs +0.054 USD per board with no fee saved only while C104-C404 keep C13832. Whether they move to C170101 is the open owner question from T-0107/T-0099 (confirmed decision 26 names 1 uF at each VS tab). C30 stays identical on both boards (shared root sheet).
- T-0114 · pdm-hc2 · C13832 removal costs 0.162 USD per board against a 3.07 USD fee per order, so it pays only up to about 19 boards per order → until order: Depends on the order quantity. For orders above about 20 pdm-hc2 boards, revert C30/C102/C202 to C13832 1 uF/100 V (inside decision 26 and TPS4811 Table 9-3). Re-price with tier prices at order time, since STATUS says 15+ and cost-system-2 says about 19 at 1+ prices. C30 is on the shared root sheet: weigh this against keeping both boards identical. No change for the planned 5-30 boards.
- T-0127 · pdm-4ch · C170101 instead of C13832 saves the loading fee only below about 14 boards per order; above that C13832 is cheaper → until order: The item only asks to revisit C13832 vs C170101 at order time, once the run size is known. The first run is 5 boards (decision 33), below the break-even of about 14 boards, so nothing changes now. Decision 84 says revisit past about 12 boards; reprice at a run of 12 or more.
- T-0154 · system · SH-ESP32 uses the same 60 V PTC without a series resistor; removing R54-R56 would save one line, about 2-3 USD per order → until prototype: kept until measured
- T-0155 · system · SH-ESP32 fits standard 100 x 68 x 50 mm waterproof enclosures; pdm-4ch at about 100 x 65 mm is close, which could replace a printed MVP enclosure → until system-mechanical: needs a heat check
- T-0285 · pdm-4ch · ch3 /DEN link (routed in T-0276) is open again after the IO2/IO5 column took its lane; ch3 DEN pin would float if built as is → until owner: ch3 R302.1 /DEN has no free route under the current rules: its B lane went to the IO2/IO5 exit column (decision 209) and the only alternative, an In2 leg from the DEN drop (59.40, 10.60), isolates the GND-In2 under U1 (T-0281 builds b2/b4/b5). Signal rerouting (decision 206) was already tried in T-0281. The finding's fix routes it after the ch2/ch3 resistor-block move (R201/R202, R301/R302), which is the next one-way door in STATUS and is pending in owner question Q-0077 (T-0218). Route R302.1 in the first T-0218 pcb-fixer package after that ruling.

## Answered (62)

- Q-0050 (pdm-hc2): MOSFET gate drive is not slew-limited (about 400-800 V/us estimated, PD direct), so switching clicks reach the VHF receiver and cable emissions rise; PROFET channels switch at 0.8 V/us. → **covered by Q-0049: short EMC-only gate slew within the MOSFET SOA** (done)
- Q-0002 (system): Battery input has only an SMCJ30CA: no bulk or HF capacitance and no filter, so short-circuit turn-off spikes, switched-current steps and RF go straight onto the cable and the rails. → **yes - bulk capacitor rated >=63 V (not 50 V, TVS clamps up to ~48 V), basic part preferred, plus 1-2.2 uF/100 V ceramic at J10 and 1 uF/100 V at each BTT6050 VS tab; ferrite/CMC as a DNP footprint** (done)
- Q-0003 (pdm-hc2): HC2 outputs have no surge/ESD clamp at the connector (invariant 4); the back-to-back MOSFETs also stop positive surges from reaching D30, so only the 80 V avalanche limits them. → **yes - TVS from each OUT to GND at J11 with short return to J10.2; use SMAJ33CA if it is basic/cheap (stand-off margin for the 28.8 V float-switch case), else SMAJ30CA** (done)
- Q-0004 (system): No high-frequency return across the isolation barrier (CIO about 1 pF) and no CMC option, so the N2K cable can radiate logic-ground noise and ESD lifts the whole island; not measured. → **yes - as footprints only: Y-capacitor GND_CAN-GND DNP, CMC footprint fitted with 0 ohm bridges; decide at pre-compliance scan** (done)
- Q-0005 (system): Buck is the 1.1 MHz PFM variant; PFM drops into the 150-350 kHz band at light load, the datasheet's separate 0.1 uF at VIN is missing, C1 is only 50 V, and SW ringing can land in the tightly limited 156-165 MHz band. → **yes - add 100 nF/100 V at VIN, footprints for an SW RC snubber (DNP) and a boot resistor (0 ohm); keep LMR51610YDBVR, switch to the YF (FPWM) variant only if the pre-compliance scan shows PFM noise** (done)
- Q-0006 (system): Hardware switch path has tau 0.32 ms (no real debounce), turns the output off below about 8 V at the switch (12 V cranking), and a lamp across the switch contacts above about 1.4 mA turns it on. → **yes - C14-C17 to 470 nF; README note: dry (unlit) switch contacts, and the output-off behaviour below about 8 V during 12 V cranking** (done)
- Q-0007 (pdm-4ch): 4-ch outputs rely on the PROFET (body diode to VS, clamp, 4 kV HBM) and D30 at J10; this meets the intent of invariant 4 but not its wording, and D30 is far from J11. → **yes - reword invariant 4 to cover the PROFET output case, DNP SMAJ30CA footprint per output, keep VS copper to D30 wide** (done)
- Q-0008 (system): USB shield is tied to battery negative (shore PE loop via a laptop) and the ESD diode is listed with a 40 V clamp against 3.6 V ESP32 pins (unverified). → **yes, all three - README service rule (battery-powered laptop or USB isolator), verify the ESD diode TLP/clamp data before ordering, shield-to-GND RC footprints (1 Mohm || 4.7 nF) with a 0 ohm option** (done)
- Q-0009 (system): 1 nF collector capacitors and the 2.2 uF buck input capacitor are probably 50 V parts against a 48.4 V TVS clamp; TI advises twice VIN for CIN. → **yes, basic-first - 100 V where a basic part exists, otherwise >=63 V; the stock check decides** (done)
- Q-0010 (system): Board ground reaches the battery negative through one terminal pole that carries TVS surge current and, on HC2, motor freewheel current (up to 25 A per channel); its rating is not defined. → **yes - GND pole(s) rated like the VS input, decided in /system mechanical; wide GND copper to J10.2** (deferred)
- Q-0060 (system): Is the interrupt rating (Imax at 60 V) of the 1812L050/60GR PTC enough for the prospective current of a direct battery short at J5.5 (F4 is fed from VS) or on NET-S? I could not read the datasheet. → **Option (1): series 0.2 ohm 2 W alloy 2512 FOJAN FRM252WJR200TK C7420022 for F1/F3/F4, accepted on its 5 s/50 J overload rating; a hard-short test at 30 V on the prototype is mandatory before installation. F1-F4 become C70113.** (done)
- Q-0012 (system): Is IEC 60945 (marine) compliance a goal or only good practice, is a pre-compliance scan planned, and may the N2K shield stay unconnected at the node (4-pole J4)? This sets how far E3-E7 must go. → **IEC 60945 as a design target, no certification; one pre-compliance scan on the first prototypes decides the DNP footprints; the N2K shield stays unconnected at the node (4-pole J4)** (done)
- Q-0013 (system): LMR51610YF (FPWM, same 1.1 MHz) would avoid PFM noise below 350 kHz; E7 asks for a scan first. → **swap to LMR51610YF only if the pre-compliance scan shows PFM noise (see Q-0005); check price and stock then** (deferred)
- Q-0014 (system): 22 BOM lines have no LCSC field, so JLCPCB cannot place them as drawn → **yes - add the listed basic/preferred LCSC codes after checking each against value and footprint; J5/J10/J11 in /system mechanical** (done)
- Q-0015 (system): Nothing is below 500 in stock, but TPS48110A (999), L1 SWPA6045S8R2MT (1231) and BTT6050 (1748) are thin and single-source; the EMC option LMR51610YF has only 458 → **yes - recheck stock before ordering; datasheet-check the L1 second sources SLW6045S8R2MST C47018494 / FNR6045S8R2MT C168074** (done)
- Q-0016 (system): 52/59 unique parts cost 1.53 $ each only under Standard PCBA; merging package variants would save ~9 $ per order then → **only if Standard PCBA is forced (see Q-0026): then merge the 100 nF and 1 uF package variants** (deferred)
- Q-0017 (system): Order 30 instead of 10 per run: -6.05 $/board (4-ch), -7.00 $/board (HC2); 10 instead of 5 saves -9.0/-9.8 $ → **5 + 5 for the first order (see Q-0027); revisit the quantity for later runs** (deferred)
- Q-0018 (system): One panel holding pdm-4ch + pdm-hc2 saves one setup, stencil, THT fee and 15 shared extended fees: -59.79 $/order (-2.99 $/board at 10+10) → **yes - panelise both designs at the PCB phase if the multi-design surcharge does not cancel the saving (see Q-0028)** (done)
- Q-0019 (system): Four basic/preferred swaps remove 4 extended fees: FB->GZ2012D601TF C1017, F2->1812L050/60GR, PESD0402V05->H5VL10B C7420372, TPS7B91->L78M05ABDT C58069 → **yes - adopt each of the four swaps only if its part-facts check passes (H5VL10B USB FS capacitance and clamp, L78M05 at the 29 V clamp and Iq, DPAK area)** (done)
- Q-0020 (system): USB-C as DNP or pogo pads removes 3 extended fees and ~0.27 $ parts: -1.30 $/board at 10 (overlaps L3) → **no for now - USB-C stays fitted on prototypes (see Q-0029); revisit for later runs** (deferred)
- Q-0021 (system): Fixed screw terminals instead of pluggable header + plug: about -1.0 $/board (the plug halves alone cost 1.20 $) → **decide in /system mechanical (see Q-0030)** (deferred)
- Q-0022 (system): LMR51610XDBVR (400 kHz, C20539658, 0.52 $) instead of the Y variant (1.35 $): -0.83 $/board; needs a re-designed L/C and conflicts with EMC lever L1 → **no for now - keep LMR51610Y; revisit after the pre-compliance scan** (deferred)
- Q-0023 (system): CA-IS3050G (C528763, 5 kV RMS, 0.92 $ at 10+) instead of ISO1044 (1.62 $): -0.71 $/board, second source; different package/pinout → **yes - part-facts check of CA-IS3050G (supplies, pinout, timing), swap only if it passes; Q-0004 footprints and Q-0039 pull-up then apply to it** (done)
- Q-0024 (system): No basic NTC exists; an MMBT3904 diode sensor (preferred) would remove one extended fee: -0.32 $/board at 10, at the cost of accuracy and calibration → **keep the NTC (accuracy without calibration is worth 3.07 USD per order)** (done)
- Q-0025 (pdm-hc2): Removing R1/R2 on HC2 saves only ~0.01 $/board; recommendation is to keep the controller part identical → **no - keep R1/R2 so the controller part stays identical on both boards** (done)
- Q-0026 (system): Does JLCPCB accept 2 oz copper with Economic PCBA? If not, Standard PCBA adds +5.1 $ (4-ch) / +5.6 $ (HC2) per board at 10 → **owner checks the JLCPCB quote page (2 oz + Economic PCBA) before layout; Q-0016 merge only if Standard PCBA is forced** (deferred)
- Q-0027 (system): How many pdm-4ch and pdm-hc2 boards per order (5, 10, 30)? This is the largest cost lever → **5 + 5 (5 pdm-4ch and 5 pdm-hc2) for the first order** (deferred)
- Q-0028 (system): Is a combined 1:1 panel of pdm-4ch + pdm-hc2 acceptable (L2)? → **yes - combined 1:1 panel of pdm-4ch + pdm-hc2, decided at the PCB phase after checking the JLCPCB multi-design surcharge** (done)
- Q-0029 (system): Is a fitted USB-C service connector required, or are pads/DNP plus OTA enough (L4)? → **USB-C fitted on the prototype run; reconsider DNP/pogo pads plus OTA for later runs** (deferred)
- Q-0030 (system): Pluggable or fixed screw terminals (L5)? → **decide in /system mechanical together with the J10 pole sizing (Q-0010); leaning pluggable for low-current J4/J5, fixed for J10/J11** (deferred)
- Q-0031 (system): Must the isolated CAN side stay powered from NET-S? If not, an isolated CAN part with integrated isolated supply could also remove the TPS7B91/FB2/D11 chain → **keep the isolated CAN side powered from NET-S (NMEA 2000 practice, LEN)** (done)
- Q-0032 (pdm-4ch): Standard population for Vega's pdm-4ch: all BTT6050 (24.87 $) or a 2+2 mix with BTT6010 (28.58 $ at 10)? → **all four BTT6050 as the standard pdm-4ch population; heavy loads go on HC2** (done)
- Q-0033 (pdm-4ch): IS fault current (6/15/40 mA, P_7.5.7) into 680 ohm dissipates 0.15 W typ / ~1.1 W max in a 0.1 W 0603 whenever DEN is high and a channel is faulted, including an unconnected output floating up in OFF (open-load-in-OFF). → **yes, all three - RIS as 1206 >=0.25 W; record firmware rule: DEN pulsed only while sampling (and dropped on full-scale IS); OUT pull-down as a DNP footprint** (done)
- Q-0034 (pdm-4ch): At SWIN 10.5 V with the 3.3 V rail down, IN minus device GND is about 1.8-2.0 V once ON, against VIN(H) min 2.0 V; the claimed 0.4 V margin does not hold (UNVERIFIED zener knee). → **correct the margin claim in design-notes and measure on the prototype; RIN 4.7 k goes on the prototype test list as the planned fix if the margin is short; no circuit change now** (done)
- Q-0035 (pdm-4ch): ESP32-S3 ADC calibrated range is 0-2900 mV (datasheet v2.2 Table 5-6), so VBAT full scale is 31.9 V, not 33 V; 30 V still reads. → **yes - correct VBAT full scale to about 32 V in decision 18 and design-notes** (done)
- Q-0036 (pdm-4ch): Paste apertures overlap the open 0.3 mm thermal vias, so solder wicks into the vias (voids under the VS tab). → **move the paste windows between the thermal vias (no plugged-via surcharge); recheck the footprint against the package drawing** (done)
- Q-0037 (pdm-4ch): Pads are 1.81 x 0.61 mm at x = +/-1.15 (inner edges under the body) instead of TI DBV0006A 1.1 x 0.6 mm at +/-1.3; numbering is correct. → **use the standard KiCad Package_TO_SOT_SMD:SOT-23-6 after checking it against TI DBV0006A and the JLCPCB footprint** (done)
- Q-0048 (pdm-4ch): 0.19 W continuous at 30 V in a 0.25 W part (77 %), 0.49 W during a 48 V clamp. → **(a) 2 k + 2 k 1206 basic (C17944) in series for R3/R4/R7/R8** (done)
- Q-0039 (pdm-4ch): No external pull-up on ISO1044 TXD; TI says not to rely on the internal one, and GPIO17 has a 60 us low glitch at power-up, which can put a dominant pulse on the N2K bus. → **yes - 10 k pull-up from ISO1044 TXD to +3V3 on the shared can sheet** (done)
- Q-0040 (pdm-4ch): With reversed battery, the panel LEDs see about 24-30 V reverse (cathode held near 0 V by R19 and the Q collector-base junction); typical LED VR is 5 V. → **add a series diode in the SW_SUPPLY feed to protect the panel LEDs on reversal; recheck the switch thresholds and the Q-0034 IN margin with the extra diode drop** (done)
- Q-0041 (pdm-4ch): Should DEN be held high in Active mode, or pulsed only while sampling IS? V1 (RIS overload on fault or open output) depends on it. → **DEN pulsed only while sampling IS (and dropped on full-scale IS), not held high in Active mode (see Q-0033)** (done)
- Q-0053 (pdm-hc2): Hardware breaker at about 24-26 A (146 ms) and OT trip at 140-160 C at the sensor leave about 18-24 A unprotected in hardware; heat budget gives Tj 137-143 C at 20 A and 169 C at 22 A against MOSFET Tj max 150 C, so only firmware protects when the ESP32 runs. → **no - drop the 21 A option; decision 19 is withdrawn by the owner (2026-11-03); the breaker stays as in decision 39** (done)
- Q-0049 (pdm-hc2): MOSFETs switch fully on in under 1 us, so a load with more than about 50-100 uF input capacitance probably exceeds the 71-91 A short-circuit threshold for longer than 4-5 us; the channel then stays off for 3.8 min (estimate, UNVERIFIED). → **(1) maximum load capacitance: rate HC2 for about 50-100 uF load input capacitance, confirmed by the prototype measurement (Q-0045); fit only a short gate slew for EMC (within the MOSFET SOA at that capacitance); README: HC2 is for motor loads (bilge pumps, wipers) and grouped LED work lights, while DC-DC converters (e.g. 24->12 V for a car radio), radios and other electronics go on the 4-channel board; split grouped LED lights if the prototype shows short-circuit trips** (done)
- Q-0044 (pdm-hc2): Reversed battery puts about -12...-30 V on TPS48110 VS/CS+/CS-/ISCP (abs max -1 V to GND); D30 SMCJ30CA is bidirectional and HC2 has no reverse protection; design-notes section 8 survival claim does not apply to HC2. → **keyed/polarised J10 plus README and label warning, and correct design-notes section 8 (reversal survival does not apply to HC2); full reverse-polarity protection deferred to a later HC2 revision (keep it on the list)** (done)
- Q-0051 (pdm-hc2): Which HC2 loads have more than about 50 uF input capacitance (LED work-light drivers, radios, inverter)? Sets whether gate slew control is needed and its inrush target. → **typical HC2 loads are bilge pumps and wipers (not capacitive) and possibly grouped 100 W LED work lights (a few hundred uF in total); DC-DC converters for 12 V car radios, radios and electronics go on the 4-channel board; see Q-0049** (done)
- Q-0046 (pdm-hc2): Should the HC2 hardware breaker sit near the continuous rating (about 17.5 A) or stay at 25 A with a documented external breaker requirement? Is an OUT voltage divider (spare IO4/IO5) wanted for float-run detection, or are SW3/SW4 enough? → **breaker level as ruled in Q-0042 (RIWRN 68k, about 17.5 A, plus external breaker and firmware soft fuse); add an OUT voltage divider on spare IO4/IO5 for float-run detection - pin-map change via /system** (done)
- Q-0052 (pdm-4ch): U5 pins 2 and 3 are swapped: datasheet (CA-IS305x v1.10 p. 5 Fig. 6-1/Table 6-1) has pin 2 = RXD, pin 3 = TXD; symbol and netlist have 2 = TXD on IO17 and 3 = RXD on IO18, so ESP32 TX drives the isolator's RXD output and CAN cannot work. → **yes** (done)
- Q-0054 (system): The VS bulk capacitors are polarised aluminium electrolytics with no reverse rating in their datasheet and nothing in front of them at J10, while the README says pdm-4ch survives a reversed battery of up to 28 V for 2 min; a reversed battery can overheat and vent C31. → **Add reverse blocking now, this revision: a reverse-blocking element (P-FET or ideal-diode controller) on VS in front of the bulk capacitors on pdm-4ch, sized for the 40-50 A path and checked with the heat budget at 40 C. Until it is in, limit the README/design-notes claim to the BTT6050 and warn that C31 is not reverse-rated. Still key J10 (decision 34).** (done)
- Q-0062 (system): Two avoidable extended-part types: 4.7 nF/1 kV USB-shield capacitor and the 680 ohm 1206 RIS, 3.07 USD per order and design each → **yes: same ruling as Q-0061 (C18 -> 1 nF/2 kV C9196, decision 31 amended).** (done)
- Q-0055 (system): 30 instead of 10 boards per order saves 6.38 USD (4-ch) / 7.12 USD (HC2) per board; 10 instead of 5 saves 9.46 / 9.93 USD → **First order 5 pdm-4ch + 5 pdm-hc2 as decision 33; quantity revisited for later runs.** (deferred)
- Q-0056 (system): One panel for both designs saves 62.9 USD per order (3.15 USD per board at 10 + 10) → **yes, as decision 33: combined 1:1 panel at the PCB phase if the JLCPCB multi-design surcharge does not cancel the saving.** (done)
- Q-0057 (system): Hand-soldering the four through-hole connectors removes 4 extended fees and the THT labour: 16.2 USD per order and design (1.62 USD per board at 10) → **yes: leave J4, J5, J10 and J11 out of the PCBA order; the owner buys and hand-solders all four.** (deferred)
- Q-0058 (system): USB-C as service pads on later runs saves 3 extended fees and parts: 1.20 USD per board at 10 → **no: USB-C (J3 and its protection) stays fitted on every run; amend decision 31 (no DNP/pogo-pad variant for later runs).** (deferred)
- Q-0061 (system): 4.7 nF/1 kV C107198 (extended) to 1 nF/2 kV C9196 (basic): 0.31 USD per board at 10, RC corner 34 Hz to 160 Hz → **yes: C18 becomes 1 nF/2 kV C9196 on both boards; amend decision 31 to 1 MOhm || 1 nF/2 kV.** (done)
- Q-0059 (system): A monthly JLCPCB assembly coupon may waive the 8.18 USD setup per order (conditions for 2 oz and Economic PCBA unverified) → **yes: the owner checks the JLCPCB coupon centre and the cart at order time.** (deferred)
- Q-0063 (system): Using C170101 for the 1 uF/100 V places removes the C13832 fee; pays only for runs of fewer than 9 (4-ch) or 15 (HC2) boards → **yes: pdm-4ch C104-C404 become 2.2 uF/100 V C170101 (same 1206 footprint); amend decision 26 to '>= 1 uF/100 V (2.2 uF C170101)'. Revisit if runs grow past about 12 boards.** (done)
- Q-0065 (system): Should the first order use the free-assembly coupon (L6) or hand-soldered connectors (L3)? → **Not all by JLCPCB: Economic PCBA without J4, J5, J10, J11; the owner hand-solders those four (ruling Q-0057). The owner checks the monthly assembly coupon at order time (ruling Q-0059).** (deferred)
- Q-0064 (pdm-4ch): May pdm-4ch C104-C404 change to C170101 (already open from T-0107)? It removes C13832 from the 4ch BOM (-3.07 USD per order) and is cheaper up to about 9 boards → **yes: same ruling as Q-0063 (C104-C404 -> C170101, decision 26 amended).** (done)
- Q-0067 (pdm-4ch): A negative transient clamped by D30 at about -48.4 V while VS is charged puts about 77 V across Q30 (60 V rated, avalanche); design-notes states VDS <= 48.4 V. → **A: fit SMDJ40CA C42371557 (preferred, 0.22 USD) across Q30 (drain VS to source VBAT_FL). Accept VDS 59.4 V worst case and VS down to about -4 V only for the 31 A bounding spike; record this as a residual risk in design-notes 8.6 (C31 briefly reverse-biased) and add a prototype check of Q30 VDS and VS during a negative pulse.** (done)
- Q-0068 (pdm-4ch): C577772 shows stock 0 (MOQ 18) on 2026-11-07; STATUS says 40, and pdm-hc2 J11 uses the same code → **Keep C577772 + C577752 (no design change). Sockets are hand-soldered (decision 85), so buy them from any seller (LCSC restock, AliExpress Kefa, other distributors); if none can be bought by order time, the order waits. A flange-less socket without the lock (C577767, C7422678) is not acceptable.** (done)
- Q-0069 (pdm-4ch): May C577772 be bought when it is back in stock, with C577767 as fallback after a footprint check? → **no – see Q-0068: buy C577772 + C577752 from any seller; no C577767 fallback (no lock); the order waits if none can be bought.** (done)
- Q-0077 (pdm-4ch): 0 unconnected is not reachable under the stage rules: the west channel signals (27 items) are walled in by the VS-In2, VS spine/front/rear and OUT2/OUT3-F outlines (only the 0.65 mm via strip at x 46.15, used by USB), and the U1 strip/analog block (47 items) is congested; needs an owner ruling on a  → **Standing rule for the rest of T-0218 (replaces case-by-case questions). Agents may, without asking: (1) move any small signal part (resistors, capacitors, small-signal diodes incl. D12-D15/D102-D402, the Q3-Q6 block, R60 and similar), including the ch2/ch3 blocks R201/R202 and R301/R302, and reroute any signal copper; (2) grow the In2 exit window and its VS-In2 notch as the runs need, if VS-In2 stays one island, >= 1012.1 mm2, with all 40 thermal vias inside, and the heat budget is rechecked (decision 9); (3) leave GND fragments on F.Cu, B.Cu and In2 when each is tied to GND-In1 by >= 2 vias (no floating copper; GND-In1 stays one island). Fixed, owner only: connectors, PROFETs U11-U14, U1, Q30/U30/D30/D31, the buck, the 16 A/battery/surge paths, all other power-pour outlines, holes, board outline, schematic. Keep going until 0 unconnected; return only when a stage gains nothing or needs one of the fixed items.** (parked)
