plektra/ESP32-PDM/docs/reviews/2026-11-14-plan-system-T-0286.md

# Plan – T-0286 (2026-11-14, unattended)

One approved item: T-0285 (MINOR, pdm-4ch, two-way, from `docs/reviews/2026-11-14-validate-pdm-4ch-3.md` M1).

## Packages

None. Nothing in this item can be done now without repeating work that has already failed or going through a one-way door.

## Deferred

- **T-0285 – ch3 R302.1 /DEN open again** → `until: owner`. In T-0281 the IO2/IO5 exit column took over the ch3 DEN
  B lane along x 56.36 (decision 209). The only other path T-0281 found was an In2 leg down from the DEN drop at
  (59.40, 10.60). Builds b2/b4/b5 showed that this leg cuts off the 78 mm² of GND-In2 under U1, which the GND-In2
  island gate rejects. Rerouting signal copper is already a two-way door (decision 206), and T-0281 tried it. The
  finding's own fix says "route R302.1 in a later stage (after the ch2/ch3 resistor block move already named in
  STATUS); no extra action now". STATUS names that move (R201/R202, R301/R302) as the next one-way door, and it is
  covered by the open owner question **Q-0077** (T-0218, how to continue past the current stage rules). Once the
  owner rules Q-0077, R302.1 /DEN should be routed in the first pcb-fixer package for T-0218 that follows. Until then
  the board is not orderable anyway (37 unconnected), so the open DEN pin is disclosed and causes no harm.

## Decisions

None. The item carries no owner ruling, and deferring it is not a design decision.

<!-- plan:begin -->
```json
{
  "packages": [],
  "deferred": [
    {"task": "T-0285", "until": "owner", "reason": "ch3 R302.1 /DEN has no free route under the current rules: its B lane went to the IO2/IO5 exit column (decision 209) and the only alternative, an In2 leg from the DEN drop (59.40, 10.60), isolates the GND-In2 under U1 (T-0281 builds b2/b4/b5). Signal rerouting (decision 206) was already tried in T-0281. The finding's fix routes it after the ch2/ch3 resistor-block move (R201/R202, R301/R302), which is the next one-way door in STATUS and is pending in owner question Q-0077 (T-0218). Route R302.1 in the first T-0218 pcb-fixer package after that ruling."}
  ],
  "decisions": []
}
```
<!-- plan:end -->
