plektra/ESP32-PDM/docs/reviews/2026-11-14-plan-system-T-0280.md

# Plan – system, T-0280 (2026-11-14)

Planner run, unattended. One approved item: T-0218 (pdm-4ch routing to 0 unconnected) with the owner's ruling on
Q-0076 ("Both, stitched"). Start state (T-0276): 42 unconnected, 0 DRC errors, parity 0, VS-In2 1 island 1133.4 mm²
with 40/40 thermal vias, Tj 101 °C at 40 °C.

## Packages

**P1 – pdm-4ch, pcb-fixer: stitched GND fragments, free signal rerouting, D12–D15 nudge (T-0218).** Layout only, no
schematic change, so a pcb-fixer package. Order inside the package:
1. Change the build's pour gate only for GND-F/GND-B: a new fragment is kept if ≥ 2 vias tie it to GND-In1;
   unstitched slivers are removed; GND-In1 stays one piece; every power pour keeps its existing gate.
2. Put back the routes T-0276 dropped only because of the island gate: IO2/IO5 through the exit column, +3V3 under U1.
3. Reroute signal copper by U1 (IO4/NTC/VBAT_SENSE) where that keeps a GND link open (now a two-way door).
4. SW_IN1–4: reroute the J6 In2 bundle first. Move D12–D15 a few mm only if that is not enough.
5. Continue the Q-0073 maze passes. Gates as before, heat budget at 40 °C at the end.

The package stops and asks if work needs power copper beyond decision 172 and the Q-0075 notch, a GND-In1 split, an
unstitched fragment, a bigger D12–D15 move or any other part move, a schematic/connector/outline change, looser
rules, or a failing heat budget.

## Deferred

None.

## Decisions

- One row from Q-0076, status confirmed, **amends decision 172** (the pour rules). It allows stitched GND-F/B
  fragments, makes rerouting signal copper (including the J6 bundle) a two-way door and adds D12–D15 (a few mm) to the
  decision 189 move list. Power copper, connectors, outline and schematic stay as ruled.

Safety: no 16 A or surge path changes. A competent person should review the board before installation.

<!-- plan:begin -->
```json
{
  "packages": [
    {
      "id": "P1",
      "scope": "pdm-4ch",
      "role": "pcb-fixer",
      "title": "pdm-4ch: stitched GND-F/B fragments, free signal rerouting, D12-D15 nudge; continue routing to fewer unconnected",
      "tasks": [
        "T-0218"
      ],
      "after": [],
      "brief": "T-0218 (MAJOR). Owner ruling Q-0076, verbatim: \"Both, stitched (T-0276 open points). (1) Agents may reroute any signal copper without asking: IO4/NTC/VBAT_SENSE by U1, the J6 In2 service bundle and other signal links. This is a two-way door from now on. (2) Where a signal route still splits a GND pour on F.Cu or B.Cu (IO2, IO5, +3V3 under U1), the new GND fragment is allowed if at least 2 vias tie it to the GND-In1 plane. Unstitched slivers are removed, so no floating copper. GND-In1 itself stays one piece. (3) D12-D15 may move a few mm if rerouting the J6 bundle is not enough. Power copper stays as ruled (decision 172, Q-0075 notch only), the heat budget is rechecked, and connectors, the outline and the schematic stay unchanged. Then keep going on T-0218 as ruled in Q-0073. Return only when a stage gains nothing or needs another one-way door.\"\n\nBACKGROUND: read docs/reviews/2026-11-14-fix-pdm-4ch-T-0276.md (open points) and design-notes 8.20-8.22. Start state after T-0276: 0 DRC errors, parity 0, 42 unconnected, only the /IO13 via_dangling; pours GND-F 37, GND-B 19, GND-In2 18, GND-In1 1 island; VS-In2 1 island, 1133.4 mm2, 40/40 thermal vias, notch x 55.6-56.5 / y 14.9-16.5 (VS_IN2_NOTCH); EXIT_WINDOW x 55.0-57.0 / y 6.45-20 for SW_IN1/SW_IN4/IO2/IO5/DEN; Tj 101 C at 40 C, 4 x 4 A. Decisions in force: 163 (board = build output; fixes go into the scripts, not hand edits), 166/172/176/178/181 (pour and corridor rules, amended for GND-F/B fragments by this ruling), 173 (J6 bundle route, now reroutable), 189/199 (Q-0073/Q-0075), 200-205 (T-0276 results). No part fact or schematic check is needed: this is layout only.\n\nSTEPS:\n1. Confirm the start state: python3 tools/kpcb.py pdm-4ch drc and the pour check; heat budget python3 tools/heat_budget.py --ambient 40 --currents 4,4,4,4.\n2. Change the build gate (routing_build.py / pour-integrity check), and only for GND-F and GND-B: a new GND island is accepted when at least 2 vias tie it to GND-In1 (count real GND vias inside the fragment). Every unstitched GND sliver is removed by the build (no floating copper, no dangling via). GND-In1 stays exactly 1 island; GND-In2 and every power pour keep the existing gates (island count, >= 95 % area, VS-In2 >= 1012.1 mm2 with 40/40 thermal vias). Record the new gate as an auto decision quoting Q-0076.\n3. Re-run the T-0276 routes that were dropped only for the island gate: IO2 and IO5 through the exit column, and the +3V3 B runs under U1. Keep them when each new GND fragment is stitched by >= 2 vias to In1 (add stitching vias where needed, outside power outlines and the x 46.15 strip).\n4. Signal copper by U1 (IO4, NTC, VBAT_SENSE and other signal links) may be rerouted (two-way now) where that keeps a GND link open or frees a via spot; prefer that over making new fragments when it costs nothing.\n5. SW_IN1-4 to D12.3-D15.3: first reroute the J6 In2 service bundle (fixed_routes.py, decision 173 route) to free via spots by the diode pads. Only if that is not enough, move D12-D15 by a few mm (same side, no rotation that changes the connector edge); record the move.\n6. Then continue on the remaining nets as ruled in Q-0073 (maze passes, one build per pass with hardware/pdm-4ch/scripts/build_routing.sh, KiCad closed).\n7. GATES for every kept build: 0 DRC errors; parity 0; unconnected below the previous kept build (42 at start), else the stage gains nothing; no new dangling copper; GND-F/GND-B fragments only as allowed in step 2; GND-In1 1 island; VS-In2 1 island, >= 1012.1 mm2, 40/40 thermal vias; other pours unchanged island count and >= 95 %; no via in VS-B-front/rear or the x 46.15 strip; In2 runs >= 0.9 mm off GND THT pads (decision 181).\n8. Heat budget at 40 C at the end (decision 9) and report Tj; python3 tools/fix_check.py --role pcb-fixer --scope pdm-4ch.\n9. Update hardware/pdm-4ch/STATUS.md (gate change, fragments with their via count, moved parts, per-net unconnected), add design-notes 8.23, record auto decisions. Safety: no 16 A or surge path changed; a competent person reviews the board before installation.\n\nONE-WAY DOORS (stop and ask, do not do):\n- any power copper change beyond decision 172 and the Q-0075 notch (VS/VBAT/OUT outlines, VS-B spine, F/B power copper, 16 A or surge paths), vias in the x 46.15 strip;\n- a GND-In1 split, or a GND-F/B fragment with fewer than 2 vias to In1 kept on the board;\n- moving D12-D15 more than a few mm, or moving any other part outside the decision 189 list;\n- a schematic, connector, outline or hole change, or a bottom-side SMT part;\n- loosening a DRC rule, clearance or net-class width;\n- the heat budget failing at 40 C.\nWhen a stage gains nothing, return with the per-net unconnected list and name the next one-way door."
    }
  ],
  "deferred": [],
  "decisions": [
    {
      "area": "pdm-4ch",
      "text": "Amends decision 172: for the pdm-4ch routing (T-0218) agents may reroute any signal copper without asking (two-way from now on): the IO4/NTC/VBAT_SENSE copper by U1, the J6 In2 service bundle (decision 173 route) and other signal links. Where a signal route still splits a GND pour on F.Cu or B.Cu (IO2, IO5, +3V3 under U1), the new GND fragment is allowed if at least 2 vias tie it to the GND-In1 plane; unstitched slivers are removed, so no floating copper, and GND-In1 stays one piece. D12-D15 may move a few mm (added to the decision 189 move list) if rerouting the J6 bundle is not enough. Power copper stays as ruled (decision 172, the Q-0075 notch only), the heat budget is rechecked (decision 9), and connectors, the outline and the schematic stay unchanged. Routing then continues as ruled in Q-0073, and the work returns to the owner only when a stage gains nothing or needs another one-way door. (owner, 2026-11-14)",
      "from": [
        "Q-0076"
      ],
      "amends": 172
    }
  ]
}
```
<!-- plan:end -->
