plektra/ESP32-PDM/docs/reviews/2026-11-13-plan-system-T-0270.md

# Plan T-0270 (2026-11-13, unattended)

There is one approved item: T-0218 (pdm-4ch, MAJOR). It comes with the owner's ruling on Q-0074. The change is to
the layout only: the copper outline of VS-In2 and the routing. The schematic does not change. So it becomes one
pcb-fixer package. Nothing is deferred. There is one decision row for the ruling, and it amends decision 189.

## Packages

**P1 – pdm-4ch: trim the VS-In2 east edge for a pocket exit, then continue routing (T-0218, pcb-fixer).**

The problem comes from T-0259 (`docs/reviews/2026-11-13-fix-pdm-4ch-T-0259.md`, MAJOR finding). Five pocket nets
cannot reach U1: SW_IN1, SW_IN4, IO2, IO5 and DEN. The reason is that the In2 corridor ends at x 55.0, which is the
1.5 mm band inside the VS-In2 east edge. A via at x ≤ 55 lands in the B.Cu VS spine.

The owner ruled on this. The ruling is to pull the VS-In2 east edge back by about 2–3 mm at y 5–20. That makes room
for one In2 → B.Cu via column at x 55–57. Nothing else changes:
- the VS-B spine, the other VS outlines and the 16 A path;
- the VS-In2 limits: one island, at least 1012.1 mm², all 40 thermal vias inside;
- the 1.5 mm corridor band, now measured from the new edge.

The fixer then carries on with T-0218 under Q-0073 (decision 189), taking the two-way steps the ruling names:
- the ch2/ch3 IN/DEN links;
- U1.28;
- the DEN via off R402.1. T-0266 has already done this one (decision 193), so it only needs to be checked.

The fixer stops only when a stage gains nothing, or when a step needs another one-way door.

The trim costs about 30–45 mm² out of the current 1156.4 mm², which leaves a wide margin to 1012.1 mm². The heat
budget at 40 °C is rerun anyway (decision 9).

## Deferred

None.

## Decisions

There is one row, from Q-0074. It **amends decision 189**, which held routing to "no corridor notch". The new rule
allows one trim of the VS-In2 east edge at y 5–20 for a single In2 → B.Cu via column. The other limits from
decisions 172, 178 and 181 stay as they are.

<!-- plan:begin -->
```json
{
  "packages": [
    {
      "id": "P1",
      "scope": "pdm-4ch",
      "role": "pcb-fixer",
      "title": "pdm-4ch: trim VS-In2 east edge for the west-pocket exit to U1, then continue routing",
      "tasks": ["T-0218"],
      "after": [],
      "brief": "T-0218 (MAJOR). Owner ruling Q-0074, verbatim: \"Trim the VS-In2 east edge (T-0259 finding): pull it back about 2-3 mm at y 5-20 for one In2 -> B.Cu via column at x 55-57, the exit for SW_IN1/SW_IN4, IO2, IO5 and DEN to U1. The VS-B spine, the other VS outlines and the 16 A path stay unchanged. VS-In2 stays one island, >= 1012.1 mm2 (decision 178), with all 40 thermal vias inside. Recheck the heat budget (decision 9). The corridor stays >= 1.5 mm inside the new edge. Then keep going on T-0218 as ruled in Q-0073: the two-way next steps (ch2/ch3 IN/DEN links, U1.28, the DEN via off R402.1) need no question. Return only when a stage gains nothing or needs another one-way door.\"\n\nBACKGROUND: see docs/reviews/2026-11-13-fix-pdm-4ch-T-0259.md, the MAJOR finding and the open points. The In2 corridor from the west pocket ends at x 55.0, which is the 1.5 mm band inside the VS-In2 east edge. The U1 side of In2 starts at x 58.1. The B.Cu VS spine covers x 45.5-55. The only F.Cu gap (U12/U13, y 19-20) carries the USB pair. Decisions in force: 163 (the board is the build output), 172/176/178/181 (In2 corridor rules), 189 (Q-0073 steps), 190-193 (maze and move results).\n\nSTEPS:\n1. Confirm the start state with python3 tools/kpcb.py pdm-4ch drc. Expect: 0 errors, 46 unconnected, parity 0 (FL30 DNP warning only), the explained /IO13 via_dangling, VS-In2 1 island at 1156.4 mm2 with 40/40 thermal vias. Then run heat_budget at 40 C, 4x4 A: Tj 101 C.\n2. Find where the VS-In2 zone outline comes from: the board file, or prep in hardware/pdm-4ch/scripts/routing_build.py / fixed_routes.py. Change it at that source so that a rebuild keeps the change (decision 163). Pull ONLY the VS-In2 east edge back by about 2-3 mm, over y 5-20. Make it just enough that one In2 -> B.Cu via column at x 55-57 clears VS-In2 by its class clearance, keeping the corridor band (CORRIDOR_BAND, 1.5 mm) measured from the new edge. The rest of the VS-In2 outline stays as it is. These stay untouched: the VS-B spine, VS-B-front/rear, the VS F.Cu pours, OUT*, VBAT* and every 16 A or surge track. The freed In2 area fills as the existing In2 pours already do. Add no new pour, keep-out or option.\n3. Check the via column: at x 55-57, y 5-20, a through via must clear all F.Cu and B.Cu power copper without moving it. Use it as the exit for SW_IN1, SW_IN4, IO2, IO5 and DEN toward U1. Route with maze_route.py passes as fixed routes in fixed_routes.py, one build per pass (hardware/pdm-4ch/scripts/build_routing.sh, KiCad closed).\n4. Then do the Q-0073 two-way steps: re-route the ch2/ch3 U12/U13 IN/DEN links with copper only, so that R201.1/R202.1/R301.1/R302.1 are no longer boxed in; then free U1.28 (DEN) by moving the Q-net track under the U1 bottom row; then run more maze passes. The DEN via off R402.1 is already done (T-0266, decision 193). Only check that it stays off the pad, at least 0.5 mm.\n5. GATES for every kept build:\n   - 0 DRC errors and parity 0;\n   - unconnected below the previous kept build, otherwise the stage gains nothing;\n   - no new dangling copper;\n   - VS-In2: 1 island, >= 1012.1 mm2, all 40 thermal vias inside (thermal_check);\n   - every other pour keeps its island count and >= 95 % of its baseline (decision 172);\n   - no via in VS-B-front/rear;\n   - In2 runs >= 0.9 mm off GND THT pads (decision 181).\n6. Run python3 tools/heat_budget.py --ambient 40 --currents 4,4,4,4 after the trim and at the end (decision 9). Report Tj; it must not exceed the limit. Then run python3 tools/fix_check.py --role pcb-fixer --scope pdm-4ch.\n7. Update hardware/pdm-4ch/STATUS.md with the new VS-In2 area, the unconnected count per net, and the open items. Add a design-notes 8.20 entry with the new edge coordinates and the via column. Record auto decisions for your own choices. Add safety: no 16 A/surge path changed, and a competent person reviews the board before installation.\n\nONE-WAY DOORS (stop and ask, do not do):\n- a VS-In2 change beyond the east edge at y 5-20 (about 2-3 mm), or one that leaves VS-In2 split, below 1012.1 mm2 or with a thermal via outside it;\n- any change to the VS-B spine, VS-B-front/rear, other VS/OUT/VBAT outlines, F.Cu/B.Cu power copper, or the 16 A or surge paths;\n- a via column that needs any of those changes to fit;\n- a corridor run closer than 1.5 mm to the new edge;\n- a schematic change, a connector, outline or hole change, or a bottom-side SMT part;\n- moving a part outside the decision 189/191 move list;\n- loosening a DRC rule, clearance or net-class width;\n- the heat budget failing at 40 C.\nWhen a stage gains nothing, return with the per-net unconnected list and name the next one-way door."
    }
  ],
  "deferred": [],
  "decisions": [
    {
      "area": "pdm-4ch",
      "text": "Amends decision 189: the VS-In2 east edge is pulled back about 2-3 mm at y 5-20, which gives one In2 -> B.Cu via column at x 55-57 as the west-pocket exit for SW_IN1/SW_IN4, IO2, IO5 and DEN to U1. The VS-B spine, the other VS outlines and the 16 A path stay unchanged. VS-In2 stays one island, >= 1012.1 mm2 (decision 178), with all 40 thermal vias inside. The corridor stays >= 1.5 mm inside the new edge, and the heat budget is rechecked (decision 9). Routing then continues as in Q-0073: the ch2/ch3 IN/DEN links, U1.28 and the DEN via off R402.1 are two-way steps, and the work returns to the owner only when a stage gains nothing or needs another one-way door. (owner, 2026-11-13)",
      "from": ["Q-0074"],
      "amends": 189
    }
  ]
}
```
<!-- plan:end -->
