plektra/ESP32-PDM/docs/reviews/2026-11-13-plan-system-T-0258.md

# Plan T-0258 (2026-11-13, unattended)

Two approved items, both pdm-4ch. Each one goes into a package. Nothing is deferred.

## Packages

**P1 – pdm-4ch routing: maze_route merge fix, ch1/ch4 signal parts toward U1, more maze passes (T-0218, pcb-fixer).**
This package carries out the Q-0073 ruling. First, `maze_route.py` must start a net's later legs from the copper
that is already laid, so it stops laying duplicate copper. Then the ch1/ch4 signal parts move toward U1:
R101/R102/R103/R104/R107/C101/D102 and their 4xx twins. After that, more maze passes run, one build per pass.

The work is layout and script only. It stays inside the decision 172/176/178 limits. R105/D101, the OUT parts and the
VS parts do not move. The start state is 48 unconnected, 0 errors and parity 0.

"In progress" with fewer unconnected items counts as a result. The package stops and asks the owner only if:
- a stage gains nothing, or
- the work would need a one-way door: power copper outlines, connectors, the board outline or the schematic.

**P2 – sync: +3V3 neck wording (T-0257).** This package only rewords text in design-notes (T-0253 note) and in
STATUS.md. The current text says the +3V3 necks feed "only clamp diodes and pull-ups". That claim was never traced.
The new text states the real bound instead:
- the necks are about 3 squares of 0.2 mm copper in total;
- that is a few mΩ (In2 is 0.5 oz, B.Cu is 2 oz);
- the drop is negligible even at 0.5 A.

P2 comes after P1 because P1's re-route can change or remove the two necks, and the text should describe the final
copper.

## Deferred

None.

## Decisions

One row for Q-0073. It records the owner's ruling to keep going on T-0218 within the Q-0070 limits, with the named
next steps and the conditions for returning to the owner. It does not change decision 172. It confirms the part
classification that decision 184 made as auto.

<!-- plan:begin -->
```json
{
  "packages": [
    {
      "id": "P1",
      "scope": "pdm-4ch",
      "role": "pcb-fixer",
      "title": "pdm-4ch routing: maze_route merge fix, ch1/ch4 signal parts toward U1, maze passes",
      "tasks": ["T-0218"],
      "after": [],
      "brief": "T-0218 (MAJOR, PCB layout). Owner ruling Q-0073, verbatim: \"Keep going on T-0218 within the Q-0070 limits (decision 172). Next: fix maze_route.py so a net's later legs start from the copper already laid (no duplicate copper), move the ch1/ch4 signal parts (R101/R102/R103/R104/R107/C101/D102 and the 4xx twins) toward U1, then more maze passes, one build per pass. R105/D101 (PROFET GND return), the OUT parts and the VS parts stay. \\\"In progress\\\" with fewer unconnected items is progress, not a question. Return to the owner only if a stage gains nothing or needs a one-way door: power copper outlines, connectors, the board outline or the schematic.\"\n\nScope: layout and scripts only (hardware/pdm-4ch/ESP32-PDM-4CH.kicad_pcb, hardware/pdm-4ch/scripts/{maze_route,routing_build,fixed_routes,geom_export}.py, build_routing.sh), plus STATUS.md and design-notes 8.20.\n\nSTART STATE (confirm first with python3 tools/kpcb.py pdm-4ch drc):\n- 0 errors, about 407 warnings, 48 unconnected, parity 0;\n- 1 explained via_dangling (the /IO13 junction via at 64.15/16.80);\n- VS-In2 1 island, 1165.0 mm2, 40/40 thermal vias;\n- Tj 101 C at 40 C, 4x4 A.\nSources: hardware/pdm-4ch/STATUS.md, design-notes 8.20, docs/reviews/2026-11-13-fix-pdm-4ch-T-0246.md and -T-0253.md (open points), decisions 163, 172, 176, 178, 181-188.\n\nLIMITS (decisions 172/176/178):\n- signal vias, and signal tracks on In2 only, may pass through VS-In2, but only >= 1.5 mm inside its outline and never over a PROFET thermal-via field + 1 mm;\n- VS-In2 stays 1 island, >= 1012.1 mm2, with all 40 thermal vias inside it;\n- every other pour keeps its island count and >= 95 % of its baseline;\n- In2 runs stay >= 0.9 mm off GND THT pads;\n- no notch in VS-In2/OUT3-F;\n- F.Cu/B.Cu VS, the 16 A paths and the surge path do not change;\n- the board stays the build output (decision 163); Freerouting stays out (decision 182).\n\nSTEP 1 - maze_route.py merge fix (T-0246 finding, decision 185):\n1. Replace the stub 'added' loop. After a leg of a multi-cluster net is routed, add its cells to the source side, so the next leg can start from any copper of the already joined cluster.\n2. Check it by re-running the pass that gave 314 lines for 1 item: the new copper must not duplicate an existing connection.\n3. Keep the T-0253 behaviour: class widths, erode() goal and start cells, prune() in finish().\n\nSTEP 2 - placement move (decision 184 classification, confirmed by the ruling):\n1. Move R101/R102/R103/R104/R107/C101/D102 and R401/R402/R403/R404/R407/C401/D402 toward U1, to give SW_IN1/SW_IN4 and the ch1/ch4 signals their own exits from the west pocket.\n2. These parts stay where they are: R105/D101 and R405/D401, C102/R106/D103 and their 4xx twins (OUT), C103/C104 and their 4xx twins (VS), and every other part.\n3. Keep every part on top. Keep no part in a hole keep-out. Keep pad clearance to the pours and their outlines; the pour outlines do not change.\n4. Do the move by script, so the build reproduces it.\n\nSTEP 3 - maze passes, one build per pass:\n1. For each pass, run the build (LAND_BEST=1) and keep the result only if:\n   - unconnected goes down;\n   - 0 DRC errors and parity 0;\n   - no new dangling copper;\n   - all the pour and thermal-via checks above pass.\n2. Order of work: short local links first, then the U1 strip and the U1 IO fan-outs (including U1.3 +3V3 at the +3V3 class width, 0.3 mm), then IO2-IO5, the SW_IN lanes, DEN/EN/NTC, and the J3 VBUS/D3-A legs (decision 181).\n3. Where a re-route makes it easy, widen the two 0.2 mm +3V3 necks to 0.3 mm. Do not move a GND via just for this.\n4. Run builds in the background with a 25-min limit. Stop at about 60 minutes and keep the best clean state.\n\nSTEP 4 - land:\n1. Run python3 tools/heat_budget.py --ambient 40 --currents 4,4,4,4 (decision 9).\n2. Run python3 tools/fix_check.py --role pcb-fixer --scope pdm-4ch.\n3. Update STATUS.md and design-notes 8.20, and give the unconnected count per net against the start state.\n4. Report T-0218 as done only at 0 unconnected. Otherwise list it under 'blocked' as two-way 'in progress: <stage>, N unconnected (was 48)'. Fewer unconnected items is progress, not a question.\n\nONE-WAY DOORS (stop and put a question in the report, do not do):\n- any change to a power copper outline (VS/OUT/VBAT/GND pours), F.Cu/B.Cu power copper, the 16 A paths, the surge path or a locked 0.3-1.2 mm power track;\n- moving a connector, a VS or OUT part, R105/D101 or R405/D401;\n- a board outline or hole change;\n- a bottom-side part;\n- any schematic change;\n- loosening a DRC rule, a clearance or a net-class width;\n- a VS-In2 split, an area below 1012.1 mm2, or a thermal via outside it;\n- the heat budget failing at 40 C;\n- a full stage (merge fix + move + passes) that gains nothing: then return to the owner with the per-net blockers."
    },
    {
      "id": "P2",
      "scope": "sync",
      "title": "pdm-4ch +3V3 neck wording in design-notes and STATUS",
      "tasks": ["T-0257"],
      "after": ["P1"],
      "brief": "T-0257 (MINOR, two-way, from docs/reviews/2026-11-13-validate-pdm-4ch-3.md M1). Text only: change docs/design-notes.md (T-0253 note in 8.20, '+3V3 width' bullet) and hardware/pdm-4ch/STATUS.md (T-0253 entry and any later entry that repeats the claim). Change no design, script or board file.\n\nPROBLEM: The note says the +3V3 path through the two 0.2 mm necks 'feeds clamp diodes and pull-ups only', and STATUS says 'branch currents < 0.1 A'. The +3V3 net also feeds L1.2 (buck output), C3/C8/C10, U5.1 (CA-IS3050G VCC1) and, once T-0218 routes it, U1.3. Which of these lie behind the necks was never traced.\n\nSTEPS:\n1. Read the board as P1 left it. Find out whether the 0.2 mm +3V3 necks still exist, and measure their lengths and layers. The T-0253 necks were In2 (65.7,59.9)-(65.8,59.7) and B.Cu (45.9,68.1)-(46.2,68.2), about 0.6 mm and about 3 squares in total.\n2. State the bound instead of the consumer claim, using the stackup in design-notes (In1/In2 0.5 oz, about 1 mOhm/sq; F/B 2 oz, about 0.25 mOhm/sq):\n   - the neck resistance (a few mOhm at most);\n   - the drop at 0.5 A, which covers the ESP32 peak plus U5 (well under 5 mV, negligible against the 3.3 V tolerance).\n3. Remove the claim that only clamp diodes and pull-ups lie behind the necks. Keep the sentence that the +3V3 copper is not in the battery input, reverse-battery or output path, and keep the competent-person reminder.\n4. If P1 removed or widened the necks, say so in one line instead.\n5. Do not edit decisions.md; its rows are a log.\n\nONE-WAY DOOR: none expected. If the measured neck copper gives more than about 50 mV drop at 0.5 A, do not reword it as negligible. Report it as a finding for the owner."
    }
  ],
  "deferred": [],
  "decisions": [
    {
      "area": "pdm-4ch",
      "text": "pdm-4ch routing continues within the decision 172 limits (Q-0070), with no corridor notch. Steps: (1) fix maze_route.py so that a net's later legs start from the copper already laid (no duplicate copper); (2) move the ch1/ch4 signal parts R101/R102/R103/R104/R107/C101/D102 and their 4xx twins toward U1; (3) run more maze passes, one build per pass. R105/D101 (PROFET GND return), the OUT parts and the VS parts stay in place. 'In progress' with fewer unconnected items counts as progress. The work goes back to the owner only if a stage gains nothing or needs a one-way door: power copper outlines, connectors, the board outline or the schematic. (owner, 2026-11-13)",
      "from": ["Q-0073"],
      "amends": null
    }
  ]
}
```
<!-- plan:end -->
