plektra/ESP32-PDM/docs/reviews/2026-11-13-plan-system-T-0245.md

# Plan T-0245 – pdm-4ch routing after Q-0072 (ch1/ch4 signal parts out of the west pocket, scripted routing)

Date: 2026-11-13 · Role: planner (unattended) · Items: 1 (T-0218, owner ruling Q-0072)

## Overview for the owner

**Where it stands.** T-0241 left the board unchanged: 74 unconnected, 0 DRC errors, parity 0, VS-In2 1 island,
1185.4 mm². What it did achieve:

- The router export now loads with 0 violations.
- The corridor rule and the generated channel bus are ready but not applied. They are in
  `hardware/pdm-4ch/scripts/T-0241-next-build.patch`, which the 2026-11-13 validator found applies cleanly.

Two problems are left:

1. **SW_IN1 and SW_IN4 have one exit between them.** It is the via strip at x 45.2–46.2, which also carries USB.
2. **Freerouting still leaves short links open,** even on the clean DSN.

You ruled on Q-0072:

- Move the ch1/ch4 small-signal parts toward U1.
- Add no via in VS-B-front/rear and change no power copper.
- Drop Freerouting and route everything left with `maze_route.py` as fixed routes.

**Package P1 (pcb-fixer, pdm-4ch)** – one item, done in this order:

1. Apply the patch.
2. Move the ch1/ch4 signal parts out of the west B.Cu pocket toward U1. Only parts whose nets are not VS, OUT or the
   load path may move.
3. Take Freerouting out of the build.
4. Script all remaining connections in this order:
   - short local links first;
   - then IO2–IO5;
   - then the SW_IN lanes;
   - then the J3 VBUS/D3-A legs from §8.18.
   In2 runs stay ≥ 0.9 mm away from GND THT pads.
5. Land the board as the build output.
6. Run the pour, thermal-via and heat-budget checks.

The goal is 0 unconnected. If it is not reached, the report says exactly which nets are left and why.

- **Deferred:** none.
- **Decisions:** one new row (Q-0072). It amends decision 176 (the routing method; it also replaces the Freerouting
  step of decision 163). The placement freedom for the channel signal columns is already in decision 172 and is not
  repeated.

**Safety.** The ruling keeps the PROFETs, VS caps, OUT TVS diodes, every F.Cu/B.Cu power pour, the 16 A paths and the
surge path where they are. Only small-signal parts move. VS-In2 stays under the existing corridor rule (decision 178),
and the heat budget is rechecked. A competent person should review the battery path, the VS copper and the outputs
before installation.

<!-- plan:begin -->
```json
{
  "packages": [
    {
      "id": "P1",
      "scope": "pdm-4ch",
      "role": "pcb-fixer",
      "title": "pdm-4ch routing: ch1/ch4 signal parts out of the west pocket, Freerouting dropped, all links scripted with maze_route.py (Q-0072)",
      "tasks": ["T-0218"],
      "after": [],
      "brief": "Fifth attempt at T-0218. The board on main is the T-0236 build 2: 74 unconnected, 0 DRC errors, parity 0, VS-In2 1 island, 1185.4 of 1190.7 mm2, 40/40 thermal vias inside. First confirm that state with kpcb drc.\n\nOwner's ruling (Q-0072, new decision row amending 176), verbatim: \"Move the channel 1 and channel 4 small signal parts (their sense/input resistors, diodes and capacitors, not the PROFETs or any power part) out of the west B.Cu pocket toward U1 so SW_IN1 and SW_IN4 get their own exits; no via in VS-B-front/rear and no change to F.Cu/B.Cu power copper. Drop Freerouting (the Q-0071 condition is met: after the export fix it still left short links open): apply scripts/T-0241-next-build.patch, route every remaining connection with scripts/maze_route.py as fixed routes (short local links first, then IO2-IO5, then the SW_IN lanes), keep In2 runs >= 0.9 mm off GND THT pads, script the J3 VBUS/D3-A legs from design-notes §8.18, and land the board as the build output. Keep the pour, thermal-via and heat-budget checks.\"\n\nSources:\n- docs/reviews/2026-11-12-fix-pdm-4ch-T-0241.md: the open items with the next scripted routes, and the channel placement table (ch1/3/4 identical, ch2 differs);\n- design-notes 8.16-8.19, in particular the west pocket geometry and the J3 VBUS route in 8.18;\n- hardware/pdm-4ch/STATUS.md;\n- decisions 163-180.\n\nMethod: decision 163 as amended by this ruling. The board stays the output of scripts/build_routing.sh, but routing_build.py no longer calls Freerouting. Every signal track comes from fixed_routes.py, generated by maze_route.py. Placement moves use tools/kpcb.py and must be recorded in the scripts or a placement step, so that the build reproduces the board.\n\nREPORT DISCIPLINE:\n- Write the report within the first 10 minutes. Its fix block lists T-0218 under 'blocked' (door two-way, reason 'in progress: <stage>').\n- Update the report after each stage.\n- Move T-0218 to 'done' only at 0 unconnected.\n- Never leave done and blocked both empty.\n- Do not commit; the orchestrator does.\n\nTIME BOX:\n- Run maze routing and builds in the background with a 25-min limit each.\n- Stop work at about 75 minutes, keep the best clean state, and finish the report.\n\nSTAGE 1 - apply the patch:\n1. git apply hardware/pdm-4ch/scripts/T-0241-next-build.patch. It contains the clean export, the corridor rule (decision 178), pour_check/thermal_check and the generated bus.\n2. Remove the Freerouting call from build_routing.sh/routing_build.py. Keep prep (zone refill, keep-outs), stitching, the dangling-via clean-up, pour_check, thermal_check and DRC/parity.\n3. Remove the generated SW_IN bus from fixed_routes.py for now. Stage 3 generates it again after the move.\n\nSTAGE 2 - placement (ch1/ch4 only):\n1. With tools/sch_query.py pdm-4ch net/ref, classify every ch1/ch4 part: C101/C102, R101/R102/R104/R105, D102 (BAT54S), R103/R107, D101 and their 400-series twins.\n2. A part may move only if none of its pads is on VS, OUT1/OUT4 or the load/GND-return path of the PROFET. Those parts stay: C103/C104, C403/C404, D103/D403, R106/R406 and anything else on VS/OUT.\n3. Report the classification before you move anything.\n4. Move the movable parts out of the west B.Cu pocket (x 36-45.5, y 6-30) toward U1, on F.Cu (no bottom-side part). Keep each IS filter (series R + C) together and close to the U1 ADC pin.\n5. A pad that must stay at the PROFET (IN/DEN/IS pin) keeps a short local link. The long run then becomes a single signal per channel through the pocket exit, instead of a column of parts.\n6. Use the free room in the U1 block and the analog area. Decision 172 already allows moving the Q3-Q6 block and the channel signal columns.\n7. Do not move PROFETs, Q30/U30/D31, connectors, holes or the outline. Do not change the F.Cu/B.Cu power copper or any pour outline.\n8. After the move, run kpcb drc: 0 errors and parity 0 (routing may be open).\n\nSTAGE 3 - scripted routing with maze_route.py:\nRoute in this order and append each result to fixed_routes.py as fixed routes:\n1. short local links (U11-U14 IS/DEN/IN, Q3-Q6 block, J3-CC2 and the other open short links);\n2. IO2-IO5;\n3. the SW_IN1-4 lanes: SW_IN1 and SW_IN4 each need their own exit; no via in VS-B-front/rear;\n4. the J3 VBUS (F2-Pad1) and D3-A (FB1.2 -> D3) legs, scripted from design-notes 8.18. They compete for In2 west of x 26.5, so do them together.\nRules for every route:\n- keep In2 runs >= 0.9 mm off GND THT pads (J6.1 starved relief in T-0241 build 5);\n- respect the corridor rule (decision 178);\n- no signal on In1.Cu;\n- buck SW/CB on F.Cu only;\n- nothing across the CAN barrier or the antenna strip;\n- no via in OUT1-B (decision 170).\nAfter each group, pre-check the fixed copper with kpcb drc (0 errors) plus pour_check/thermal_check, then continue.\n\nSTAGE 4 - land:\n1. Run one build (LAND_BEST=1) so that the board is the script output.\n2. Accept it only with:\n   - 0 DRC errors and parity 0;\n   - VS-In2 1 island and >= 1012.1 mm2, all 40 thermal vias inside it;\n   - every other pour at its island count and >= 95 %;\n   - fewer unconnected items than the board (target 0).\n\nAFTER THE LAST KEPT BUILD:\n1. Run python3 tools/heat_budget.py --ambient 40 --currents 4,4,4,4 (decision 9) and report Tj.\n2. State the VS-In2 area, the island count and the thermal vias.\n3. Run python3 tools/fix_check.py --role pcb-fixer --scope pdm-4ch.\n4. Update STATUS.md and design-notes (new 8.20).\n5. Record your own placement and routing choices as auto decisions in the fix block.\n\nIf nets stay open, list them under 'blocked' (two-way) with the exact nets and why maze_route.py found no path.\n\nONE-WAY DOORS (stop, do not do, ask in the report):\n- a via, or any signal copper, in VS-B-front/rear or the VS-B spine on B.Cu;\n- any change to F.Cu/B.Cu power copper, a power-zone outline, the 16 A paths or the surge path;\n- moving a PROFET, a VS cap, an OUT TVS, Q30/U30/D31, a connector, a hole or the outline;\n- a part that turns out to be on VS/OUT/load path but seems to need moving;\n- breaking the corridor rule: VS-In2 split, below 1012.1 mm2, or a thermal via outside it;\n- the heat budget failing at 40 C;\n- loosening a DRC rule or clearance;\n- a bottom-side part;\n- any schematic change;\n- bringing Freerouting back."
    }
  ],
  "deferred": [],
  "decisions": [
    {
      "area": "pdm-4ch",
      "text": "Amends decision 176: Freerouting is dropped from the pdm-4ch routing build (the Q-0071 condition is met: after the export fix it still left short links open). scripts/T-0241-next-build.patch is applied and every remaining connection is routed by scripts/maze_route.py as fixed routes in fixed_routes.py: short local links first, then IO2-IO5, then the SW_IN lanes, plus the J3 VBUS/D3-A legs from design-notes 8.18. In2 runs stay >= 0.9 mm off GND THT pads. The board is still the build output (decision 163), and the pour, thermal-via and heat-budget checks stay. To give SW_IN1 and SW_IN4 their own exits, the channel 1 and channel 4 small-signal parts (sense/input resistors, diodes, capacitors; not the PROFETs or any power part) move out of the west B.Cu pocket toward U1. No via in VS-B-front/rear and no change to F.Cu/B.Cu power copper.",
      "from": ["Q-0072"],
      "amends": 176
    }
  ]
}
```
<!-- plan:end -->
