plektra/ESP32-PDM/docs/reviews/2026-11-12-plan-system-T-0240.md

# Plan T-0240 – pdm-4ch routing after Q-0071 (In2 corridor, scripted channel buses)

Date: 2026-11-12 · Role: planner (unattended) · Items: 1 (T-0218, owner ruling Q-0071)

## Overview for the owner

**Where it stands.** T-0236 used your Q-0070 ruling, vias through VS-In2 (decision 172), and got the board from 78 to
**74 unconnected**, with 0 DRC errors, parity 0 and every pour whole. Two things block further progress:

- **The west channel nets cannot get out.** They sit in a B.Cu pocket closed by the VS-B copper. A via is no help
  there, because it also needs room on F.Cu and B.Cu (decision 175).
- **The router results are noisy.** Freerouting starts every run from a DSN with 722 built-in violations, and
  single runs vary by about ±3 unconnected.

You ruled on Q-0071: an **In2 corridor**, with signal tracks through the VS copper on In2.Cu only, and routing done
mostly by script.

**Package P1 (pcb-fixer, pdm-4ch)** – one item, five stages in this order:

1. **Clean router export.** Fix the router export so the DSN has no built-in violations, and run several Freerouting
   runs per build. `build_routing.sh` already takes up to 3 runs with different strategies.
2. **Corridor rule in the build scripts.** Signal tracks may run on In2 inside VS-In2. The build checks:
   - VS-In2 stays one island and loses at most 15 % of its baseline area;
   - every PROFET thermal via stays inside VS-In2;
   - the other pours keep the existing ≥ 95 %.
3. **One channel signal bus, repeated.** Design one channel's sense, input and LED bus through the corridor in
   `fixed_routes.py`, then generate the other three channels from the same pattern. The J6 bundle, CAN, USB and the
   U1 fan-out stay fixed routes.
4. **Short links.** Freerouting fills the remaining short links. If it still cannot close them, they are scripted
   too.
5. **Heat budget** at 40 °C (decision 9), then STATUS.md and design-notes.

The report must name T-0218 in its fix block from the first minutes on, as blocked "in progress" until the board
reaches 0 unconnected. Two earlier runs ended with an empty or unfinished report.

- **Deferred:** none.
- **Decisions:** one new row (Q-0071). It amends decision 172:
  - signal tracks (not only vias) are now allowed through VS-In2;
  - VS-In2 may lose up to 15 % of its area, where 172 allowed 5 %;
  - routing becomes script-first.
- **Planner finding (MINOR, tool):** the T-0236 merge commit says "0 fixed, 0 blocked", but its fix block lists
  T-0218 as blocked. The orchestrator's merge summary under-counts blocked items. This does not affect the plan.

**Safety.** The ruling keeps the F.Cu/B.Cu VS copper, the 16 A paths and the surge path unchanged. The corridor only
thins the In2 VS layer, which carries about 11 % of the load current and sits under the PROFET thermal vias. That is
why P1 checks the area, the island count, the thermal vias and the heat budget. A competent person should review the
battery path, the VS copper and the outputs before installation.

<!-- plan:begin -->
```json
{
  "packages": [
    {
      "id": "P1",
      "scope": "pdm-4ch",
      "role": "pcb-fixer",
      "title": "pdm-4ch routing: clean router export, In2 signal corridor through VS-In2, scripted channel buses (Q-0071)",
      "tasks": ["T-0218"],
      "after": [],
      "brief": "Fourth attempt at T-0218. The board on main is the T-0236 build 2: 74 unconnected, 0 DRC errors, parity 0, VS-In2 1 island, 1185.4 of 1190.7 mm2. Start from main, and first confirm that state with kpcb drc.\n\nOwner's ruling (Q-0071, new decision row amending 172), verbatim: \"In2 corridor. Allow signal tracks through the VS copper on In2.Cu only; F.Cu/B.Cu VS, the 16 A paths and the surge path stay unchanged. VS-In2 stays one piece and keeps every PROFET's thermal vias inside it, loses at most 15 % of its baseline area, and the heat budget at 40 °C must pass (tools/heat_budget.py). First fix the router export so the DSN has no built-in violations (T-0236 reports 722), and run several Freerouting runs per build so the run-to-run spread does not hide gains. Route mostly by script: the four output channels are identical, so design one channel's signal bus (sense, input, LED lines) through the In2 corridor once and generate the other three as the same pattern in scripts/fixed_routes.py; the J6 bundle, CAN, USB and the U1 fan-out stay fixed routes too. Freerouting only fills the remaining short links; if it still cannot close them after the export fix, drop it and script those links as well.\"\n\nSources:\n- docs/reviews/2026-11-12-fix-pdm-4ch-T-0236.md: open items by group, the builds table, the next steps;\n- design-notes 8.16 (build method; the 500-700 'unfixable' violations), 8.17 and 8.18 (the west pocket geometry, J6 bundle v2 and the J3 VBUS route, both pre-checked at 0 DRC errors on fixed copper);\n- hardware/pdm-4ch/STATUS.md;\n- decisions 163-175.\n\nMethod (decision 163): fixes go into hardware/pdm-4ch/scripts/ (routing_build.py, fixed_routes.py, build_routing.sh), and the board is the build output. Placement moves, if any, use tools/kpcb.py.\n\nREPORT DISCIPLINE:\n- Write the report within the first 10 minutes. Its fix block lists T-0218 under 'blocked' (door two-way, reason 'in progress: <stage>').\n- Update the report after each stage.\n- Move T-0218 to 'done' only at 0 unconnected.\n- Never leave done and blocked both empty.\n- Do not commit; the orchestrator does. Leave the best clean state in the worktree, with the scripts reproducing that board. Use LAND_BEST=1 once after fixed_routes.py changes, if needed.\n\nTIME BOX:\n- Start each build in the background with a 25-min limit.\n- At most 5 builds.\n- Stop work at about 75 minutes, keep the best clean state, and finish the report.\n\nSTAGE 1 - clean router export (no board change):\n1. In routing_build.py prep, find what makes the 722 DSN violations. Suspects from 8.16: power copper inside its own pour keep-out, and pads near the 0.35 mm edge strip.\n2. Change the export so the DSN has 0 built-in violations (Freerouting log). Do not loosen any KiCad DRC rule or keep-out to get there.\n3. From then on, build with 3 runs (build_routing.sh 3 25). The script already gives each run its own strategy (FR_STRATS).\n4. Record the violations before and after, and the 3-run spread.\n\nSTAGE 2 - corridor rule (scripts only):\n1. Let signal tracks on In2.Cu pass inside the VS-In2 outline: VS-In2 is no longer a track keep-out for foreign nets on In2.\n2. Change nothing on F.Cu/B.Cu VS, the VBAT/OUT pours, the 16 A paths or the surge path. Their keep-outs stay exactly as they are.\n3. Make the pour check per pour: VS-In2 may lose up to 15 % of its 1190.7 mm2 baseline (so >= 1012 mm2) and must stay 1 island. Every other pour keeps its island count and >= 95 % of its area (decision 172).\n4. Add a check that every PROFET thermal via (U11-U14 exposed pad vias, VS) lies inside the filled VS-In2 and is connected to it.\n5. Leave the VS-In2 outline unchanged; the fill clears around the tracks.\n6. Run one 3-run build and keep it if it is better.\n\nSTAGE 3 - scripted channel bus:\n1. Before you script anything, check that the four channels' signal-side parts (the IS sense resistors/filters, the IN/DEN input parts, the LED drivers and their resistors) have the same relative placement and rotation. Report any differences.\n2. Design one channel's bus (IS sense, IN/DEN input, LED lines) from its signal-column parts through the In2 corridor to D12-D15/U1, as a function in fixed_routes.py.\n3. Generate the other three channels with that function, using per-channel offsets or a mirror. Where placement differs, use per-channel parameters rather than moving power parts.\n4. Keep J6 (v1 as on main, or v2 from 8.18 if it then builds better), CAN, USB and the U1 fan-out as fixed routes.\n5. Add the J3 VBUS route and a D3-A route (FB1.2 -> D3) from 8.18 together. They compete for In2 west of x 26.5.\n6. Pre-check the fixed copper at 0 DRC errors, then build.\n\nSTAGE 4 - short links:\n1. Let Freerouting fill what is left.\n2. If after the export fix it still leaves links open across builds, script those links in fixed_routes.py and build again.\n\nACCEPTANCE (every build):\n- 0 DRC errors and parity 0;\n- the pour rules from stage 2;\n- no signal on In1.Cu (EMC rule 3), buck SW/CB on F.Cu only, nothing across the CAN barrier or the antenna strip, no via in OUT1-B (decision 170);\n- fewer unconnected items than the board.\n\nAFTER THE LAST KEPT BUILD:\n1. Run python3 tools/heat_budget.py --ambient 40 --currents 4,4,4,4 (decision 9) and report Tj.\n2. heat_budget.py does not model the In2 area. State the VS-In2 area, the island count and that all thermal vias are inside it.\n3. Run python3 tools/fix_check.py --role pcb-fixer --scope pdm-4ch. It checks: schematic unchanged, parity 0, 0 DRC errors, outline and holes unchanged, no bottom SMT.\n4. Update STATUS.md and design-notes (new 8.19).\n5. Record your own layout choices (export fix, channel bus geometry) as auto decisions in the fix block.\n\nIf items stay open, list them under 'blocked' (two-way) with the exact nets and the next scripted route.\n\nONE-WAY DOORS (stop, do not do, ask in the report):\n- any change to F.Cu/B.Cu VS copper, the 16 A paths, the surge path or any other power-zone outline;\n- a signal track through any power pour other than VS-In2, or on a layer other than In2 inside VS copper;\n- VS-In2 split, losing more than 15 %, or a PROFET thermal via ending up outside it;\n- the heat budget failing at 40 C;\n- loosening a DRC rule or clearance to clear DSN violations;\n- moving a PROFET, Q30/U30/D31, a connector, a hole or the outline;\n- a bottom-side part;\n- any schematic change."
    }
  ],
  "deferred": [],
  "decisions": [
    {
      "area": "pdm-4ch",
      "text": "Amends decision 172: In2 corridor. Signal tracks (not only vias) may run through the VS copper on In2.Cu only. F.Cu/B.Cu VS, the 16 A paths and the surge path stay unchanged. VS-In2 stays one piece, keeps every PROFET's thermal vias inside it and loses at most 15 % of its baseline area (the other pours keep >= 95 %). The heat budget at 40 C must pass (tools/heat_budget.py). Routing method: first fix the router export so the DSN has no built-in violations, and run several Freerouting runs per build. Route mostly by script: one channel's signal bus (sense, input, LED lines) is designed once through the In2 corridor and generated for the other three channels in scripts/fixed_routes.py. The J6 bundle, CAN, USB and the U1 fan-out stay fixed routes. Freerouting only fills the remaining short links, and if it cannot close them it is dropped and those links are scripted too.",
      "from": ["Q-0071"],
      "amends": 172
    }
  ]
}
```
<!-- plan:end -->
