plektra/ESP32-PDM/docs/reviews/2026-11-11-cost-system.md

# Cost re-check, scope system – 2026-11-11 (T-0228)

## Figures
`git diff c08d5134a4cb -- hardware lib docs/design-notes.md` is empty. The only commits since the base are
a3158bc (planner T-0225: plan, decision row, queue; docs only) and e27010b (pcb-fixer T-0226: failed, no board change).
No part was added, removed or swapped. The BOM, the unique extended part count per board and the loading fees are
unchanged from the earlier reports. Nothing to price.

## Levers
None from this change set.

## Rule findings
None. The planned T-0218 routing work (signal vias through VS-In2, placement moves) changes no part, only copper and
placement, so it has no BOM cost.

## Questions for the owner
None.

## Not checked
Everything untouched since c08d5134a4cb, as instructed. Quote-side fee items stay with the owner.

<!-- findings:begin -->
```json
[]
```
<!-- findings:end -->
