plektra/ESP32-PDM/docs/reviews/2026-11-11-validate-pdm-4ch-3.md

# Validation re-check pdm-4ch (T-0227), 2026-11-11

Scope: changes since c08d5134a4cb in `hardware`, `lib`, `docs/design-notes.md`.

## Findings
None. `git diff c08d5134a4cb HEAD -- hardware lib docs/design-notes.md` is empty; the worktree is clean.

## Checked and OK
- Commits after c08d513 (a3158bc planner T-0225, e27010b pcb-fixer T-0226 "failed") touch only `docs/ROADMAP.md` and `docs/queue.json` (git show --stat e27010b). No design file changed, so no change needs a correctness or scope check.

## Not checked
- Untouched circuits (out of scope for this re-check).

<!-- findings:begin -->
```json
[]
```
<!-- findings:end -->
