plektra/ESP32-PDM/docs/reviews/2026-11-13-fix-pdm-4ch-T-0271.md

# pdm-4ch – T-0271 (T-0218, owner rulings Q-0074 and Q-0073): VS-In2 east-edge trim, ch2/ch3 links, U1.28

Date: 2026-11-14, unattended (pcb-fixer). Board: `hardware/pdm-4ch/ESP32-PDM-4CH.kicad_pcb`, which is the output of
`build_routing.sh` again (decision 163). Copper only; no part moved, no pour outline changed.

## Start state (confirmed)
- `kpcb drc`: 0 errors, 407 warnings, 46 unconnected, parity 0 (FL30 DNP warning only), /IO13 via_dangling.
- VS-In2: 1 island, 1156.4 mm², 40/40 thermal vias. `heat_budget.py --ambient 40 --currents 4,4,4,4`: Tj 101 °C.

## Step 1–3: the VS-In2 east-edge trim was not applied
The VS-In2 outline lives only in the board file; prep reads it and no script builds it. Its east edge is x 56.5 at
y 4.95–34.5. The B spine is x 45.5/46.5–55.0 at y 5–35, with a 1.0 mm zone clearance.

FINDING (MAJOR): the ruled trim cannot create the exit. The corridor band is drawn **centred on** the VS-In2 outline
(maze_route.py: the outline as a 2 × 1.5 mm line; routing_build.py: outline − deflated outline). An In2 run can
therefore never cross any VS-In2 edge. It can only end at a via at least 1.5 mm inside the pour, which today means
x ≤ 55.0. A through via clears the B spine only at x ≥ 56.3, and for y < 35 every spot in the band-free core is spine
on B and OUT2-F/OUT3-F or U12/U13 on F. Pulling the east edge back 2–3 mm moves the core further west (x ≈ 52–53).
The via column at x 55–57 then sits outside VS-In2, and no corridor run can reach it without crossing the new edge
(a one-way door in this brief). The trim alone gains nothing and would fail the "fewer unconnected" build gate, and
it costs VS-In2 copper, so it was not made. VS-In2 is unchanged.

The exit needs one of these one-way rulings (design-notes 8.21):
- **(a)** One marked exit where pocket In2 runs may cross the VS-In2 east edge at y 5–20 into a via column at
  x 56.3–57. VS-In2 gets a notch and stays one island; the trim becomes optional.
- **(b)** A spine notch: the B spine east edge to x ≤ 53.7 at y 5–20, so a via at x ≈ 55 in the band-free core
  clears it.
- **(c)** Signal vias in the x 46.15 strip between OUT3-F and the spine, as the USB pair has. They notch the spine
  fill. The run then goes east on F between U12 and U13 at y 16.6–19.8 / 21.8–23.

## Step 4: Q-0073 two-way steps
The two 0402 resistors per channel leave three 0.76–0.77 mm gaps across their pad columns (north, middle, south).
Each gap holds one 0.2 mm track. The U12/U13 pin row walls the west, and no via fits west of x 56.3. So only one of
the two R?.1 pads per channel can be freed with F copper.
- **ch2:** the U12-DEN link now goes through the middle gap into R202.2 from below. R202.1 (/DEN) leaves through the
  north gap to an In2 via at (59.40, 10.60). Maze pass 1 found the In2 leg under U1 (GND-In2 side, outside VS-In2)
  to U1.28. R201.1 (/SW_IN2) stays boxed.
- **U1.28:** it was boxed by pads 27/29 and the Q3-B track under the bottom row. It now leaves north on F past the
  IO35 fan-out via to a via at (72.50, 17.50): 0.23 mm to In2 IO40 and 0.24 mm to B Q3-C. Q3-B was not moved; that
  would need vias in the R18/R20/IO38/IO39 block.
- **ch3:** the C301.2 GND via (56.78, 25.46) fills the north gap, so R302.1 (/DEN) cannot leave. The U13-IN link
  moved to the middle gap instead, which opens R301.1 (/SW_IN3) to the south. No route to D14.3 was found, and a
  stub with a via would have been dangling copper, so none is built.
- **DEN via off R402.1** (T-0266): it is still at (38.60, 25.42), 0.60 mm from the pad (≥ 0.5 mm).
- The hand stubs are needed because the 0.77 mm gaps are below what the maze router's 0.1 mm grid with inflated
  keep-outs can resolve.

## Step 5: builds
| build | content | unconnected | errors | kept |
|---|---|---|---|---|
| w1 | U12/U13 DEN links via the middle gap | 46 | 0 | no (no gain) |
| w2 | + R202.1/R302.1 stubs | 46 | 1 (R302.1 stub 0.04 mm from the C301.2 GND via) | no |
| w3/w4 | ch3 switched to the IN link; U1.28 stub; maze pass 1 run on base | 46 | 0 | no |
| w5 | + maze pass 1 (R202.1 → U1.28) and SW_IN3 stub | 45 | 0 | landed, then rejected: dangling SW_IN3 via, GND-F 37 → 38 islands |
| w7 | SW_IN3 stub removed, rebuilt from the HEAD board | 45 | 0 | rejected: GND-F 37 → 38 (C201.2/R203.2 fragment) |
| w8 | In2 drop moved to (59.40, 10.60) | **45** | 0 | **yes** |

A full maze pass over all 31 open nets on the w8 board gained nothing (every net failed or found only redundant
joins). The stage stops there.

## Step 6: checks on the kept board
- `kpcb drc`: **0 errors, 407 warnings, 45 unconnected, parity 0.** The only via_dangling is the known /IO13. No
  bottom-side SMT, no part in a hole keep-out, nothing parked.
- Pours compared with the HEAD board (`routing_build.py islands`): every zone keeps its island count. GND-F
  2863.8 → 2858.0 mm² (−0.20 %), GND-In2 3759.8 → 3745.3 mm² (−0.39 %), GND-B −0.06 %, GND-In1 −0.06 %. All other
  pours are unchanged. **VS-In2: 1 island, 1156.4 mm² (≥ 1012.1), 40/40 thermal vias.**
- No via in VS-B-front/rear: the new vias are at (59.40, 10.60) and (72.50, 17.50). No GND THT pad lies near the new
  In2 run.
- `heat_budget.py --ambient 40 --currents 4,4,4,4`: **Tj 101 °C** (unchanged, no VS copper changed).
- `fix_check.py --role pcb-fixer --scope pdm-4ch`: OK. `fix_check.py --scope pdm-4ch`: OK.
- Safety: no power copper, pour outline, 16 A path or surge path changed. The new copper is 0.2 mm signal copper on
  the DEN line (diagnosis enable) and two link reroutes on the IN/DEN side. A competent person reviews the board
  before installation.

## Unconnected per net, start → now
**DEN 3 → 2**. Unchanged: +3V3 5, GND 3, IO6 2, IO11 2, IO17 2, SW1 2, SW4 2, F2-Pad1 2, Q4-B 2, and 1 each for
SW_IN1–4, SWIN2–4, SW1_IO, SW2_IO, SW4_IO, IO0, IO2, IO5, IO7, IO18, EN, NTC, VBAT_SENSE, D3-A, Q4-E, Q5-E.
Total 46 → 45.

## Open points for the next stage
- **One-way door for the owner:** the pocket exit (SW_IN1/4, IO2, IO5, pocket DEN R102.1/R402.1). Choose (a), (b)
  or (c) above. The trim as ruled does not work with the band rule.
- Two-way: route R301.1 (/SW_IN3) → D14.3 (the pad is open now). Freeing R302.1 needs the C301.2 GND via moved
  (only the IS loop interior is free for it). R201.1 can only be freed if ch2 gives up R202.1.
- The U1 strip and analog block (+3V3, IO6/11/17/18, SW*_IO, EN, IO0, NTC, VBAT_SENSE, Q4/Q5) are unchanged.

<!-- fix:begin -->
```json
{
  "done": [],
  "blocked": [
    {"id": "T-0218", "door": "one-way", "reason": "the Q-0074 VS-In2 east-edge trim cannot give the pocket exit: the 1.5 mm corridor band straddles the VS-In2 outline, so an In2 run cannot cross a trimmed edge, and every via >= 1.5 mm inside VS-In2 lands in the B spine (x <= 55.0 vs >= 56.3 needed). Trim not applied (it gains nothing). Owner choice needed: (a) a marked In2 exit across the east edge into a via column at x 56.3-57, (b) a spine notch to x <= 53.7 at y 5-20, or (c) signal vias in the x 46.15 strip that notch the spine fill. Two-way steps done: 46 -> 45 unconnected (DEN 3 -> 2)"}
  ],
  "refs": [],
  "decisions": [
    {"area": "pdm-4ch", "text": "Q-0074 VS-In2 east-edge trim not applied: with the corridor band centred on the outline no In2 run can reach a via column outside the trimmed edge, so the trim gains nothing (T-0271, design-notes 8.21)"},
    {"area": "pdm-4ch", "text": "ch2: U12-DEN link through the middle gap (y 11.30) into R202.2 from below; R202.1 /DEN leaves north to an In2 via at (59.40, 10.60) and runs on In2 under U1 to U1.28 (T-0271)"},
    {"area": "pdm-4ch", "text": "U1.28 /DEN leaves north on F past the IO35 fan-out via to a via at (72.50, 17.50); the Q3-B track under the U1 bottom row stays (T-0271)"},
    {"area": "pdm-4ch", "text": "ch3: U13-IN link through the middle gap (y 27.30) into R301.2 from above, freeing R301.1 /SW_IN3 to the south; R302.1 stays boxed by the C301.2 GND via (T-0271)"}
  ],
  "checks": {"drc": "0 errors, 407 warnings, 45 unconnected", "parity": "0", "fix_check": "OK", "heat_budget": "Tj 101 C at 40 C, 4x4 A", "vs_in2": "1 island, 1156.4 mm2, 40/40 thermal vias"}
}
```
<!-- fix:end -->
