plektra/ESP32-PDM/docs/reviews/2026-11-13-fix-pdm-4ch-T-0259.md

# pdm-4ch – T-0259 (T-0218, owner ruling Q-0073): maze merge fix, ch1/ch4 move, maze passes

Date: 2026-11-13, unattended (pcb-fixer). Board: `hardware/pdm-4ch/ESP32-PDM-4CH.kicad_pcb`. It is the output of
`build_routing.sh` again (decision 163).

## Start state (confirmed)
- `kpcb drc`: 0 errors, 407 warnings, 48 unconnected, parity 0.
- VS-In2: 1 island, 1165.0 mm², 40/40 thermal vias. Tj 101 °C at 40 °C, 4 × 4 A.

## Step 1 – maze_route.py merge fix
- The stub `added` loop is gone. After each leg, the leg's path cells (`laid`, per layer) become start cells for the
  next leg, so later legs start from any copper of the joined cluster.
- The T-0253 behaviour stays: class widths, `erode()` start and goal cells, and `prune()` in `finish()`.
- Check: re-running the full open-net list on the start board gave **87 lines** (T-0246 pass 2: 314), with no
  duplicate connection. Most legs are 0.1 mm joins onto fragment clusters; those under 0.15 mm were dropped. One
  multi-leg route (MOD_ID) closed.
- Also changed: a failed leg now re-seeds from the next open cluster, so one boxed-in pad no longer stops the net
  (that is how DEN gained). The node limit is 6 M, and the `@file` net list is one net per line, because net names
  can contain spaces.
- FINDING (MINOR): build_routing.sh reported "KEPT" after a crashed prep, because an empty result counted as clean.
  The cp then failed, so the board was untouched. Fixed: `OK=${OK:--1}`.

## Step 2 – placement move (scripted)
- `fixed_routes.py` now holds `PLACE`, `DROP_NETS` and `DROP_GND`. `routing_build.prep` → `move_parts()` places the
  parts and removes the copper the move replaces, in the same single pass over the tracks. A second `GetTracks()`
  after `Remove()` breaks KiCad's SWIG layer.
- R101 (37.2, 9.2, 180°), R102 (37.2, 7.93, 180°), R401 (37.2, 25.8, 180°), R402 (37.2, 24.53, 180°). The PROFET-side
  pad now faces its U11/U14 pin with a straight 0.2 mm link, and the SW_IN/DEN pad faces east toward U1. Before
  this, the IN/DEN links wrapped round the resistor and boxed in the SW_IN/DEN pad.
- R103/R107/R403/R407 turned to 270° in place. The IS pads are now on top, linked from the R104/R404 branch, and
  the IS track no longer runs down x 38.9 across the pocket. The bottom GND pads get a 0.4 mm link and one GND via
  each: (42.9, 11.6) and (42.9, 28.2).
- C101, R104, D102 and their 4xx twins did not need to move. R105/D101, R405/D401, OUT, VS and every other part
  stay. All parts are on top, none is in a hole keep-out, and no pour outline changed.
- Result: R101.1, R102.1, R401.1 and R402.1 now reach F, In2 and B (before the move, R102.1 reached 33 cells on F
  only).

## Step 3 – builds (one per pass)
| build | content | unconnected | errors | kept |
|---|---|---|---|---|
| 1 | pass 1 (merge-fixed router, all open nets) | 47 | 2 (NTC leg 0.1973 mm from R62.1) | no, NTC line dropped |
| 2 | move + pass 1 | 47 | 0 | yes |
| 3 | pass 2: DEN R102.1 → R402.1 (F → B → In2 slot → F → B) + local IO2/IO5 joins | **46** | 0 | yes |

Every kept build had parity 0 and no new dangling copper (still only the /IO13 junction via). Every pour is whole.

FINDING (MAJOR): the pocket nets still cannot reach U1. For y < 35, the In2 corridor from the pocket ends at x 55.0
(the 1.5 mm band inside the VS-In2 east edge), and the U1 side of In2 starts at x 58.1. A via at x ≤ 55 lands in the
B.Cu VS spine (x 45.5–55), and the only F.Cu gap (U12/U13, y 19–20) carries the USB pair. SW_IN1/SW_IN4, IO2, IO5
and DEN to U1 therefore need a VS-In2 or VS-spine outline change, which is a one-way door. The same holds for the
other boxed pads, which sit outside this stage's move list: R201.1/R202.1/R301.1/R302.1 (ch2/ch3 have the same
wrap-around pattern), U1.28 (DEN), D12.3 (SW_IN1), U5.2/U5.3 (IO18/IO17), R70.2, R60.2, FB1.2, J3 A4/A9/B4/B9 and
the Q4/Q5 block.

FINDING (MINOR): the new DEN via at (37.60, 24.30) overlaps R402.1 (same net, DRC clean). Solder can wick into it;
move it off the pad when DEN is routed again.

## Step 4 – checks
- `kpcb drc`: **0 errors, 407 warnings, 46 unconnected, parity 0**. No bottom-side SMT, no part in a hole keep-out,
  nothing parked.
- Pours compared with the start board: no power pour lost an island or more than 5 %. **VS-In2: 1 island,
  1156.4 mm²** (≥ 1012.1), 40/40 thermal vias inside. The GND fills changed their island counts (F 39 → 37,
  B 17 → 19, In2 15 → 18) with GND unconnected unchanged at 3. These are fill fragments, not lost connections.
- `heat_budget.py --ambient 40 --currents 4,4,4,4`: Tj 101 °C (unchanged).
- `fix_check.py --scope pdm-4ch`: OK.
- Safety: no power copper, outline, 16 A path, surge path or locked power track changed. The moved parts are
  sense/control parts (IN, DEN, IS), and IS keeps R103 ∥ R107 to GND. A competent person reviews the board before
  installation.

## Unconnected per net, start → now
+3V3 5→5, SWIN2 1→1, SWIN3 1→1, SWIN4 1→1, **DEN 4→3**, EN 1→1, IO0 1→1, IO11 2→2, IO17 2→2, IO18 1→1, IO2 1→1,
IO5 1→1, IO6 2→2, IO7 1→1, **MOD_ID 1→0**, NTC 1→1, SW1 2→2, SW1_IO 1→1, SW2_IO 1→1, SW4 2→2, SW4_IO 1→1,
SW_IN1–4 1→1 each, VBAT_SENSE 1→1, GND 3→3, D3-A 1→1, F2-Pad1 2→2, Q4-B 2→2, Q4-E 1→1, Q5-E 1→1. Total 48 → 46.

## Open points for the next stage
- One-way door for the owner: a signal exit from the west pocket to U1. Options: narrow the VS-In2 east edge or the
  VS-B spine at y 5–20 enough for one In2 → B via column at x 55–57, or allow In2 corridor runs to end closer than
  1.5 mm to the VS-In2 edge at one marked exit. Either one would also serve SW_IN4/IO5 from ch4.
- Two-way: re-route the ch2/ch3 U12/U13 IN/DEN links with copper only, so R201.1/R202.1/R301.1/R302.1 are no longer
  boxed in. The parts cannot move there. Then free U1.28 (DEN) by moving the Q-net track under the U1 bottom row.
- Move the DEN via off R402.1.

<!-- fix:begin -->
```json
{
  "done": [],
  "blocked": [
    {"id": "T-0218", "door": "two-way", "reason": "in progress: merge fix + ch1/ch4 move + 2 maze passes done, 46 unconnected (was 48); the pocket nets (SW_IN1/4, IO2, IO5, DEN) now leave their pads but reach U1 only through a VS-In2/VS-spine outline change (one-way door, see report)"}
  ],
  "refs": ["R101", "R102", "R103", "R107", "R401", "R402", "R403", "R407"],
  "decisions": [
    {"area": "pdm-4ch", "text": "maze_route.py: a routed leg's cells join the source side, so later legs start from the copper already laid (no duplicates: 87 lines vs 314); a failed leg re-seeds from the next open cluster (T-0259, decision 185)"},
    {"area": "pdm-4ch", "text": "ch1/ch4 move by script (fixed_routes.PLACE, routing_build.prep move_parts): R101/R102/R401/R402 at 180 deg with PROFET-side pads facing their pins (straight links), R103/R107/R403/R407 at 270 deg with IS pads on top, GND bottom pads tied by 0.4 mm links and GND vias (42.9,11.6)/(42.9,28.2) (T-0259)"},
    {"area": "pdm-4ch", "text": "DEN R102.1-R402.1 routed F -> B.Cu pocket (x 42.1) -> In2 slot inside VS-In2 -> F -> B; VS-In2 1156.4 mm2, 1 island, 40/40 thermal vias (T-0259)"}
  ],
  "checks": {"drc": "0 errors, 407 warnings, 46 unconnected", "parity": "0", "fix_check": "OK", "heat_budget": "Tj 101 C at 40 C, 4x4 A", "vs_in2": "1 island, 1156.4 mm2, 40/40 thermal vias"}
}
```
<!-- fix:end -->
