plektra/ESP32-PDM/docs/reviews/2026-11-12-fix-pdm-4ch-T-0241.md

# pdm-4ch T-0241 – clean router export, In2 corridor through VS-In2, scripted channel buses (Q-0071)

Run 2026-11-12 23:26 – 2026-11-13 00:22. Item T-0218 (Q-0071). Role: pcb-fixer (unattended).

## Result
**The board is unchanged: 74 unconnected, 0 DRC errors, parity 0, VS-In2 1 island, 1185.4 mm².** No build beat it.
- **Stage 1 is done.** The router export has 0 pre-existing violations (was 723).
- **Stages 2–3 are written and verified on fixed copper.** The final-rule build gave 77 unconnected with 1 error.
  That is not better, so it was not kept.
- **Where the changes are.** All script changes are kept as `hardware/pdm-4ch/scripts/T-0241-next-build.patch`
  (applies cleanly with `git apply`). `routing_build.py`/`fixed_routes.py` stay as on main, so they still reproduce
  the board. The generators `geom_export.py` and `maze_route.py` are added; the build does not import them.
- **Doors.** No one-way door was touched: no change to F/B VS copper, power-zone outlines, parts, outline or
  schematic.
- T-0218 stays blocked (two-way).

## Start state (confirmed)
`kpcb drc` on main: 0 errors, 425 warnings, 74 unconnected, parity 0 (T-0236 build 2).

## Stage 1 – clean router export (done)
Freerouting on the main board's DSN: **723 pre-existing violations** (the brief said 722). They were:
- 125 pin-to-pin;
- 598 fixed trace/via vs ObstacleArea.

After the fix: **0** (no design warning at all; 408 unrouted at the start, as before). Three causes, all fixed in
`routing_build.py` (DSN/router copy only, no KiCad rule or zone touched):
1. **Fixed copper inside router keep-outs (598).**
   - What happened: a DSN keep-out holds for every net. So a pour's own vias and tracks inside its `pour-*`
     keep-out were violations, and so were foreign vias whose 0.8 mm escape was smaller than their class clearance.
   - Fix (`clear_fixed()`): every router-made keep-out (pour-*, antenna, CAN barrier, JP1/JP30, edge strip) gets a
     hole around each fixed track/via it touches. The hole is the item's class clearance + 0.05 mm. Another net
     cannot be placed in that hole anyway, so the protection is unchanged.
2. **Pin-to-pin (125).**
   - What happened: Freerouting checked fixed pad pairs against the net-class clearance (VS 1.0 mm, OUT 0.3, VBUS
     0.25). The footprints' own pad gaps cannot meet that: PROFET VS pins, VS capacitors, F1, R60, U30 and the J3
     VBUS/GND pins (KiCad gap 0.200 mm).
   - Fix (`pin_classes()`): every placed pin gets clearance class `PIN<class>`. Pin↔wire/via keeps the class value
     (the larger of the two). Pin↔pin is 190 µm; that covers only two fixed pads, which the router never moves, and
     the 190 absorbs Freerouting's polygon approximation of the 0.200 mm J3 gap. KiCad DRC (0.2 mm) stays the
     authority.
3. **Fixed vias at a same-net SMD pad (6, left after 1 and 2).**
   - Which: the R60.1 VS via column (57.4/40.8 and 42.2, VS copper, not to be moved), and the GND vias at D6.1,
     D103.1, D203.1 and R106.2 (gaps 0–0.15 mm).
   - Fix: fixed vias get `FIXV<class>`: 0 against pins and other fixed vias, the class value against routed
     wires/vias.

Pass 1 of a run now ends with "128 unrouted and 0 violations" (T-0236: 138 unrouted, 722 violations).

## Stage 2 – In2 corridor rule (scripts only)
- `routing_build.py`: `CORRIDOR_POURS = {'VS-In2'}`. The router no longer gets a track keep-out over the VS-In2
  outline, only over each PROFET's thermal-via field (pad-15 PTH vias + 1.0 mm, `THERMAL_KEEP_MM`). F.Cu/B.Cu VS,
  VBAT, OUT, the 16 A paths and the surge path keep their full keep-outs. Outlines are unchanged.
- `pour_check()`: VS-In2 must be exactly 1 island and ≥ 1012.1 mm² (85 % of 1190.7, `CORRIDOR_MIN_MM2`). Every
  other power pour keeps its island count and ≥ 95 % of its baseline.
- `thermal_check()`: each of the 40 PROFET thermal vias (U11–U14, 10 each) lies inside the VS-In2 outline and touches
  its fill. The pour check fails the run otherwise. On main: 40/40.

## Stage 3 – channel bus
**Placement comparison (relative to each PROFET, all rot 180):**
- Channels 1, 3 and 4 are identical: Rx01/Rx02/Rx05/Cx01 at +5.20 x, Rx03 +8.30, Rx07 +10.90, Rx04 (+7.00, −4.20),
  Dx01 (+7.00, +4.20), Dx02 (+10.50, −5.00).
- **Channel 2 differs**, because U12 sits against the U1 block: R203 (+7.55, −0.95), R204 (+5.20, −4.00), R207
  (+7.55, +3.80), D201 (+6.50, +7.50), D202 (+8.20, −5.25).
- The C/D power parts (Cx03/Cx04) are mirrored in y for ch3/ch4. They are not part of the signal bus.
- No power part was moved.

**Why a copied pattern does not work here.** The destinations are not channel-symmetric:
- D12–D15 sit in a column at x 59–63, y 56–72.
- U1's IO pins are at x 62.
- The two west channels (1, 4) sit in a B.Cu pocket (x 36–45.5) closed by VS-B-front/rear and the spine.
- The two east channels (2, 3) sit beside the spine.
- So the bus is generated per net by a script instead (`maze_route.py`: grid A* at 0.1 mm over F/In2/B, with the
  KiCad clearances, the pour keep-outs and the corridor rule built in). Its output is the generated block at the end
  of `fixed_routes.py`.
- Every SW_IN line uses one lane: pocket → via strip x 45.2–46.2/y 16–18 (In2 hop under the spine edge) → F.Cu
  between U12 and U13 → B.Cu lane x 56–61 → D12–D15.
- The strip holds only one lane besides USB, so SW_IN1 and SW_IN4 cannot both pass. Every one of 6 orders closed
  3 of 4.

## Builds (`build_routing.sh 3 25`, later `3 15`; each from a snapshot of the scripts in the job folder)
| Build | Input | Result (3 runs) | Kept |
|---|---|---|---|
| 1 | main + clean export (class-clearance holes) | 69 / 69 / 69 unconnected, 0 errors, **pour check failed**: VS-B-spine 463.0 of 519.7 mm², VS-In2 1003.7 | no |
| 2 | + In2 corridor (no band) | 64 / 64 / 64, 0 errors, **failed**: VS-In2 2 islands, 1083.3 mm²; spine 478.5 | no |
| 3 | + scripted bus | stopped after 7 min: carried the hole bug of builds 1–2 | no |
| 4 | + 0.25 mm holes | stopped after 1 min: no corridor band yet | no |
| 5 | 0.25 mm holes + corridor with 1.5 mm band + scripted bus (3 × 15 passes) | 77 / 77 / 77, **1 error** (starved GND thermal relief, In2, J6 pad 1), pours whole | no |

**Spread:** in every build the three runs (strategies prioritized/sequential/random) gave identical results, pass for
pass. The run-to-run spread is 0 on a clean DSN.

What the numbers mean:
- Builds 1–2 reached 69/64 only because signal tracks cut VS copper. The pour check rejected them, so it works as
  intended.
- Under the final rules, the scripted lane closes SW_IN2/3/4, but Freerouting then leaves short links open that it
  used to close: U11–U14 IS/DEN/IN, IO2/IO4, VBUS, J3-CC2, the Q3–Q6 block.
- Freerouting's best state per build: 128 (b1), 120 (b2), 145 (b5) unrouted. It still alternates with a ~250 state.

## Stage 4 – short links
Not reached within the 5 builds. Stage 1 fixed the export, and Freerouting still leaves links open. As Q-0071 says,
the next step is to script those too. The tool is ready: `maze_route.py` closes nets on a given board under the same
rules, and every output is pre-checked with kpcb drc plus the pour and thermal checks.

## Acceptance of the kept state (= main board)
- `kpcb drc`: 0 errors, 74 unconnected, parity 0, no bottom SMT, nothing in a hole keep-out.
- No signal on In1, buck SW/CB on F.Cu, CAN barrier/antenna free, no via in OUT1-B: unchanged from T-0236.
- VS-In2: 1 island, 1185.4 mm² (−0.4 % of 1190.7). All 40 PROFET thermal vias (U11–U14 pad 15) lie inside it and
  touch its fill (new `thermal_check()`, run on the board).
- `python3 tools/heat_budget.py --ambient 40 --currents 4,4,4,4`: 4 × BTT6050-1ERA, 1.40 W/ch, enclosure air
  45.4 °C, **Tj 101 °C**, passes. heat_budget.py does not model the In2 area; the area is unchanged.
- `python3 tools/fix_check.py --scope pdm-4ch`: **OK – passes the merge gates** (ERC 0 errors, 227 parts +0).

## Open items, with the next scripted routes
1. **Apply `scripts/T-0241-next-build.patch`.** Then generate the bus after the short local links, not before.
   - Order: the U1x-IS/DEN/IN links first, then IO2–IO5, then SW_IN2/3/4 through the lane.
   - Run `maze_route.py` on the routed board's leftovers too, and land everything as fixed routes. One build
     (LAND_BEST=1) then makes the board the script output again.
2. **SW_IN1 vs SW_IN4.** Only one lane besides USB fits the west-pocket via strip (x 45.2–46.2, y 16–18). A second
   exit needs either a via landing in VS-B-front/rear, which is a one-way door, or the ch1/ch4 signal columns moved
   out of the pocket (two-way, placement).
3. **J6 pad 1 (GND).** In2 copper beside it starves its thermal relief. Keep In2 runs ≥ 0.9 mm off GND THT pads
   (maze_route.py does this; Freerouting does not).
4. **VBUS (F2-Pad1) and D3-A.** The maze connects them only in part. Script the remaining J3 legs by hand from
   design-notes §8.18.

Safety: no power copper changed. The battery path, the reverse-battery blocker, the 16 A paths, the surge path and
the outputs are as on main. With the patch, the corridor only allows signal tracks on In2 inside VS-In2: 1.5 mm off
its edge, never over a thermal-via field, and with the pour check guarding area and islands. A competent person
reviews the board before installation.

<!-- fix:begin -->
```json
{
  "done": [],
  "blocked": [
    {"id": "T-0218", "door": "two-way", "reason": "74 unconnected left (board unchanged; no build was better). Export fixed (0 DSN violations), corridor rule and generated channel bus are in hardware/pdm-4ch/scripts/T-0241-next-build.patch; final-rule build gave 77 unconnected + 1 starved-thermal error (J6.1 GND, In2). Next: apply the patch, script the short links first (U11-U14 IS/DEN/IN, IO2-IO5, VBUS F2-Pad1, D3-A, J3-CC2, Q3-Q6 block) with maze_route.py on the routed board, then SW_IN2/3/4 through the lane, keep In2 >= 0.9 mm off GND THT pads, one LAND_BEST=1 build. SW_IN1 and SW_IN4 share the only west-pocket via strip (x 45.2-46.2, y 16-18): a second exit needs a moved ch1/ch4 signal column (two-way) or a via landing in VS-B-front/rear (one-way)."}
  ],
  "refs": [],
  "decisions": [
    {"area": "pdm-4ch", "text": "Router export without built-in violations: router keep-outs get 0.25 mm holes round fixed copper, every placed pin gets clearance class PIN<class> (pin-pin 190 um, pin-wire = net class), fixed vias FIXV<class> (0 to pins); Freerouting loads with 0 pre-existing violations (was 723); no KiCad rule changed (T-0241, patch in scripts/)"},
    {"area": "pdm-4ch", "text": "In2 corridor rule (Q-0071): signal tracks may run on In2 inside VS-In2 only >= 1.5 mm inside its outline (internal slots, cannot split it) and never over a PROFET thermal-via field + 1 mm; per-pour check VS-In2 >= 1012.1 mm2 and 1 island, others >= 95 % and same islands; thermal_check requires all 40 thermal vias inside VS-In2"},
    {"area": "pdm-4ch", "text": "Channel signal bus is generated per net by scripts/maze_route.py (grid A* 0.1 mm, class clearances, pour keep-outs) instead of one copied pattern: the destinations (D12-D15, U1) and the west-channel B.Cu pocket are not channel-symmetric, and channel 2's signal parts differ from channels 1/3/4"},
    {"area": "pdm-4ch", "text": "Builds run 3 Freerouting runs but on a clean DSN the three strategies give identical results (spread 0); 15 passes suffice (state settles by pass 8)"}
  ],
  "checks": {"drc": "0 errors, 425 warnings, 74 unconnected", "parity": "0", "fix_check": "OK", "dsn_violations": "723 -> 0", "heat_budget": "Tj 101 C at 40 C, 4 x 4 A", "vs_in2": "1 island, 1185.4 of 1190.7 mm2, 40/40 thermal vias inside", "builds": "b1 69 (pours fail), b2 64 (VS-In2 split), b3/b4 stopped, b5 77 + 1 error (pours whole)"}
}
```
<!-- fix:end -->
