plektra/ESP32-PDM/docs/reviews/2026-11-12-fix-pdm-4ch-T-0236.md

# pdm-4ch T-0236 – routing with signal vias through VS-In2, placement room (continues T-0231)

Run 2026-11-12, 07:41–08:40. Item T-0218 (Q-0070, decision 172). Role: pcb-fixer (unattended).

## Result
**74 unconnected (was 78), 0 DRC errors, parity 0, every pour whole.** The board in the worktree is the build-2 output,
and `scripts/fixed_routes.py` is exactly that build's input (J6 bundle v1). Stage A' alone gains nothing. Stage B
(the J6 bundle off the Q3–Q6 block, and R60 into the VS-F-drain edge) gives −4. Builds 3 and 4 (VBUS fixed route,
J6 bundle v2) gave 77 and 75 and were not kept. Their scripts are described below for the follow-up. T-0218 stays
**blocked (two-way)** with named next steps. No one-way door was touched.

## Start state (confirmed)
- `routing_build.py` line 43: `VIA_OK_POURS = {'VS-In2'}`; `fixed_routes.py` line 30: `POUR_LOSS_MAX = 0.05`.
- Board on main: T-0210 build, 0 errors, 78 unconnected, parity 0.

## Stage A' – build with via freedom
- Build 1 (`build_routing.sh 1 25`, 07:41–07:54): r1 0 errors, parity 0, pours whole, **79 unconnected** (board
  78), so the board is unchanged.
- VS-In2: baseline 1 island, 1190.7 mm². The board had 1 island, 1185.4 mm²; r1 had 1 island, 1186.0 mm²
  (-0.4 %). There are 12 foreign vias inside its outline in both.
- Why the via freedom did not help: a via through In2 also needs a legal spot on F.Cu and B.Cu.
  - The west channel columns (R10x/R40x, x 36–44) sit in a B.Cu pocket x 36–45.5, y 6–30. It is closed by VS-B-front
    (north), the VS-B-spine (east, x 45.5–55, y 5–58.7) and VS-B-rear (south).
  - Its only B.Cu exit is west, through y 13.8–21 at x 26.5–36.
  - From there a net must change to In2 west of x 26.5 and run south round J10 and the buck. It then turns east along
    y 59–74 to D12–D15/U1, a path of about 150 mm per net. Freerouting does not find it.
- In the U1 south strip, a locked stage-6b In2 diagonal of the J6 service bundle runs across the Q3–Q6/analog block.
  It is six tracks at 0.5 mm pitch, from (78,21) to (60,36). Nearly every short link in that block was open (Q3-B,
  Q4-B, Q5-B, Q3-E, Q4-E, the collectors), because no via fits beside those pads.

## Stage B – placement and lanes (option 2)
- The J6 bundle's In2 diagonal is removed (6 locked segments, `kpcb delete --track-at`). It is replaced in
  `fixed_routes.py` by nested L-routes on In2: down at x 75.6–78.1, west at y 32.6–35.1, onto the existing verticals
  at x 60.2–62.7. This frees In2 under the whole block, x 60–75, y 21–32.
- R60 (VS → VBAT_SENSE divider top) moved from (64.6, 24.4) to (58.3, 41.4). Its VS pad now sits inside the VS-F-drain
  outline, on the VS via column at x 57.4, so the 1 mm-clearance VS link through the analog block is gone. Only the
  divided VBAT_SENSE signal leaves the power area.
- Build 2 (`build_routing.sh 1 25`, 07:59–08:13): r1 0 errors, parity 0, pours whole (VS-In2 1 island,
  1185.4 mm²), **74 unconnected** (was 78). Kept: this is the board in the worktree unless build 4 is better.
  - fix_check: OK.
  - Committing and `land.py` are denied in this run (pcb-fixer rule: the orchestrator commits), so the result waits
    in the worktree.
- Still open in the block: Q3-B, Q4-B, Q3-E, Q4-E, Q5-E, Q4-C, Q6-B. The new In2 verticals at x 75.6–78.1 now lie
  under R17/R18/R20/R21 and R24/R27/R52.

## Stage C – fixed route J3 VBUS
- `fixed_routes.py` gains a fixed route for VBUS (Net-(F2-Pad1)).
  - A4/B9 and A9/B4 leave upwards past the NPTH pegs on F.Cu (0.2 mm) to vias at (17.4, 5.6) and (13.0, 5.6).
  - The two join on In2 (0.4 mm) along y 5.6, west of VS-In2.
  - The route comes down at x 21.5 to a via at (25.2, 13.6), between OUT1-B (y ≤ 11.6) and OUT2-F (y ≥ 14.1), and
    reaches F2.1 on F.Cu.
  - No via sits in OUT1-B (decision 170) or in any other power outline.
- Build 3 (`build_routing.sh 1 25`, stage B plus the VBUS route), run in parallel with build 2. The build input
  does not depend on build 2, because prep removes all unlocked copper.
  - Result: 0 errors, parity 0, pours whole, **77 unconnected**. The VBUS items closed (−4), but the router's variance
    moved elsewhere (+7: D3-A, Q5-B, U14-IS, IO4, IO8, SW3_IO, SWIN1).
  - Not kept. The script had copied it, because the board it compared against was the edited pre-build board (83).
    The build-2 board was restored by hand.
- Build 4 (`build_routing.sh 1 25`), the last allowed, has all of the above plus J6 bundle v2:
  - The whole bundle is re-defined, and its 12 old locked In2 segments were removed.
  - Each line jogs 2.2 mm east at 45° under U1's corner, runs down x 77.8–80.3 under the LED-driver SMA/1206 parts,
    and turns west along y 32.6–35.1. This frees x 60–77 under the block for vias.
  - Pre-check: DRC on the prepped base board (fixed copper only, refilled) gives 0 errors.
  - Result: see below.

- Build 4 result: 0 errors, parity 0, pours whole (stitch 9), **75 unconnected**. VBUS, Q3-E, Q4-E and Q5-E
  closed; Q3-C, Q5-B, SW4, NTC and SW_SUPPLY opened. Not kept, so the board stays at build 2.
  `fixed_routes.py` was reverted to the build-2 input (J6 v1, no VBUS), so the scripts reproduce the board.
  - The two script blocks that were not kept are J6 v2 and VBUS. They are written out in design-notes §8.18 and
    were pre-checked at 0 DRC errors on fixed copper. Their exact text came from this run's job folder and is not in
    the repo; re-create them from §8.18.

## Builds (4 of 4 used, 1 run each, `build_routing.sh 1 25`)
| Build | Input | Unconnected | Kept |
|---|---|---|---|
| 1 | main (via freedom in VS-In2) | 79 | no |
| 2 | + J6 bundle v1 (L round the block), R60 moved | **74** | **yes** |
| 3 | build 2 + J3 VBUS fixed route | 77 | no (restored by hand) |
| 4 | build 3 + J6 bundle v2 (lane x 77.8–80.3) | 75 | no |

Freerouting still oscillates between two board states each pass (138 vs ~260 unrouted, 722 constant DSN violations).
Single-run results vary by ±3 for small input changes, so a 1-run build can hide a real gain.

## Heat budget (decision 9)
`python3 tools/heat_budget.py --ambient 40 --currents 4,4,4,4`: 4 × BTT6050-1ERA, P 1.40 W/ch, enclosure air
45.4 °C, **Tj 101 °C** (below the limit). heat_budget.py does not model the In2 area. The RthJA estimate is unchanged:
every PROFET thermal via is still VS inside VS-In2, and VS-In2 lost 0.4 % (1185.4 of 1190.7 mm², 1 island), within
the 5 % limit.

## Checks
- `kpcb drc` (board): 0 errors, 425 warnings, 74 unconnected, parity 0. No bottom SMT, nothing in a hole keep-out,
  nothing parked.
- `python3 tools/fix_check.py --scope pdm-4ch`: **OK – passes the merge gates**. Schematic unchanged: ERC 0 errors,
  227 parts (+0).
- Outline, holes, power-zone outlines, connectors, PROFETs, Q30/U30/D31, buck and U1 are not moved or changed. The
  only placement change is R60.

## Open items (74), with next steps
1. **West channel group** (about 30 items: DEN ×8, +3V3 ×20 in part, SW_IN1–4, IO0/2/3/5, EN ×6, NTC, U12/U14-IS).
   - The pocket exits only west on B.Cu (y 13.8–21, x 26.5–36). A net then needs In2 west of x 26.5, round J10 and
     the buck, and east along y 59–74.
   - Next step: fixed routes in `fixed_routes.py` along that path, one net at a time, starting with SW_IN1/SW_IN4
     (to D12/D15) and DEN.
   - Alternative: move D102/D402 (IO2/IO5 clamps, +3V3) next to U1, which takes +3V3 out of the pocket. This needs
     room west of U1's left pad column, and there is none today.
2. **U1 strip / analog block** (about 40 items: Q3-B, Q4-B, Q3/Q4/Q5-E, Q4-C, Q6-B, SW1/SW2/SW4, IO6/7/11/17/18,
   SWx_IO, SW_SENSE(_IO), SWIN2–4, R3/R4 dividers).
   - Next step: J6 bundle v2 (§8.18), the lane x 77.8–80.3 that frees R17–R21/R24/R27/R52, together with a
     re-spaced Q block and a 2–3-run build, because single runs vary by ±3.
3. **J3** (VBUS ×4, D3-A ×2): the VBUS fixed route of §8.18 closes VBUS (build 3). It should land together with a D3-A
   route, because FB1.2 → D3 competes for In2 west of x 26.5.

Safety: no power copper changed (no outline, no split, no via in OUT/VBAT/VS-F/VS-B copper). R60, the divider top
resistor from VS, now sits at the VS pour edge. The battery path, the reverse-battery blocker and the outputs are
unchanged. A competent person reviews the board before installation.

<!-- fix:begin -->
```json
{
  "done": [],
  "blocked": [
    {"id": "T-0218", "door": "two-way", "reason": "74 unconnected left (was 78). (1) West channel group, about 30 items (DEN, SW_IN1-4, IO0/2/3/5, EN, NTC, +3V3 to D102/D402, U12/U14-IS): the B.Cu pocket x 36-45.5/y 6-30 exits only west at y 13.8-21; next step is fixed routes in fixed_routes.py along B.Cu west, then In2 west of x 26.5, round J10/buck and east along y 59-74, starting with SW_IN1/SW_IN4 and DEN. (2) U1 strip/analog block, about 40 items (Q3-B, Q4-B, Q3/Q4/Q5-E, Q4-C, Q6-B, SW1/2/4, IO6/7/11/17/18, SWx_IO, SW_SENSE, SWIN2-4): next step is J6 bundle v2 (design-notes 8.18, lane x 77.8-80.3) with a re-spaced Q block and a 2-3 run build. (3) J3: the VBUS fixed route of 8.18 plus a D3-A route (FB1.2 -> D3) on In2 west of x 26.5"}
  ],
  "refs": ["R60"],
  "decisions": [
    {"area": "pdm-4ch", "text": "J6 service bundle (TXD0/RXD0/IO35-37/IO42) on In2 runs as nested L-routes down x 75.6-78.1 and west along y 32.6-35.1 instead of the stage-6b diagonal through the Q3-Q6 block (fixed_routes.py, T-0236)"},
    {"area": "pdm-4ch", "text": "R60 (VS -> VBAT_SENSE divider top) at 58.3/41.4 with its VS pad inside the VS-F-drain outline on the VS via column, so only the divided sense signal leaves the power area"},
    {"area": "pdm-4ch", "text": "Signal vias through VS-In2 (decision 172) alone gave no gain (79 vs 78): a through via also needs F.Cu and B.Cu room, and the VS-B spine/front/rear close the west channel pocket on B.Cu"}
  ],
  "checks": {"drc": "0 errors, 425 warnings, 74 unconnected", "parity": "0", "fix_check": "OK", "heat_budget": "Tj 101 C at 40 C, 4 x 4 A", "vs_in2": "1 island, 1185.4 of 1190.7 mm2 (-0.4 %)"}
}
```
<!-- fix:end -->
