plektra/ESP32-PDM/docs/reviews/2026-11-11-fix-pdm-4ch-T-0231.md

# pdm-4ch T-0231 – signal vias through VS-In2 and placement room (in progress)

Started 2026-11-11 06:30. Stage A/B/C in progress.

## Stage A (option 3): script change
- `routing_build.py`: new `VIA_OK_POURS = {'VS-In2'}`. The router keep-out `pour-VS-In2` uses `SetDoNotAllowVias(False)`
  and exports as a `wire_keepout` (tracks barred, vias allowed). The DSN has 1 wire_keepout and 248 full keep-outs, so
  every other pour keeps its full track+via keep-out (decision 164).
- `fixed_routes.py`: `POUR_LOSS_MAX = 0.05` (was 0.02).
- VS-In2 baseline (prep, `islands`): 1 island, 1190.7 mm². So the "one island" rule is the existing "no more islands
  than baseline" test.
- Build A (1 run): running.

<!-- fix:begin -->
```json
{
  "done": [],
  "blocked": [],
  "refs": [],
  "decisions": [],
  "checks": {}
}
```
<!-- fix:end -->
