plektra/ESP32-PDM/docs/reviews/2026-11-11-fix-pdm-4ch-T-0221.md

# Fix pdm-4ch T-0221 – routing scripts gate and T-0210 fixed routes (2026-11-11, unattended)

Closes T-0219 (from `docs/reviews/2026-11-11-fix-pdm-4ch-T-0211.md`): the pcb-fixer merge gate was reported to reject
`hardware/pdm-4ch/scripts/`.

## Per item

**T-0219 – done (verification, one STATUS line).**
1. Gate: `tools/orchestrate.py` loaded via importlib; `fix_allowed('hardware/pdm-4ch/scripts/fixed_routes.py',
   'pdm-4ch', 'pcb-fixer')` returns `True` (gate opened in c9fa4fa). No tools/ change needed.
2. Patch: already on main – commit 4945f12 (T-0214). `fixed_routes.py` carries the CAN pair, USB D+/D− and J3 CC1
   entries; `build_routing.sh` handles `LAND_BEST`. Not applied again. `fixed_routes.py` imports with 34 TRACKS and
   16 VIAS; `bash -n build_routing.sh` passes. build_routing.sh not run; the board was not touched.
3. `hardware/pdm-4ch/STATUS.md`: the "Held back" bullet was replaced by one line. It now says the routes are in
   `scripts/fixed_routes.py` and the pcb-fixer gate admits `scripts/` (c9fa4fa, decision 163). The "Updated" line
   was refreshed.

No schematic, PCB, lib or tools change.

## Checks
- Gate check script: `fix_allowed(...) = True`.
- `python3 tools/fix_check.py --scope pdm-4ch` (no refs): OK. pdm-4ch ERC 0 errors/5 warnings, 227 parts (+0),
  59 unique (+0). pdm-hc2 ERC 0 errors/5 warnings, 241 parts (+0), 63 unique (+0).

## Open points
None.

<!-- fix:begin -->
```json
{
  "done": ["T-0219"],
  "blocked": [],
  "refs": [],
  "decisions": [],
  "checks": {"erc": "pdm-4ch 0 errors/5 warnings, pdm-hc2 0 errors/5 warnings (unchanged)", "netlist": "unchanged on both boards (fix_check OK, +0 parts)", "gate": "fix_allowed(hardware/pdm-4ch/scripts/fixed_routes.py, pdm-4ch, pcb-fixer) = True", "scripts": "fixed_routes.py imports, 34 TRACKS / 16 VIAS; bash -n build_routing.sh OK; patch already landed in 4945f12 (T-0214)"}
}
```
<!-- fix:end -->
