plektra/ESP32-PDM/docs/reviews/2026-11-08-fix-pdm-4ch-T-0197.md

# pdm-4ch layout stage 1: connectors and mounting holes (T-0197, 2026-11-08, unattended)

Role: pcb-fixer. Board `hardware/pdm-4ch/ESP32-PDM-4CH.kicad_pcb`, edited only with `tools/kpcb.py`. The schematic, `lib/`, the outline
and the hole keep-outs are unchanged.

Coordinates are mm from the top-left board corner. The board is 100 × 65 mm:
- x = 0 is the power edge, x = 100 the signal edge;
- y = 0 is the front, y = 65 the rail side.

These come from the Cmts.User floorplan notes of decision 128.

## What was placed

| Group | Parts | Position / reason |
|---|---|---|
| Holes | H1–H4 | On the keep-out centres (4,4), (96,4), (4,61), (96,61) (decision 123/128) |
| Power edge | J11 (rot 270, origin 7.8/12.0) | Toward the front, plug side outward, OUT1–OUT4 from the top |
| Power edge | J10 (rot 270, origin 17.2/39.5) | Toward the rail: the heaviest and tallest part (29.5 mm, M4, 10 mm²) sits beside the rail-side holes that carry the short DIN mount. Wire entry outward; VBAT_IN (+) upper pole, GND (−) lower |
| J10 protection | D30 (vertical, at the rear VBAT_IN/GND pins), C30 (beside it, parallel to the edge) | EMC 2026-11-07-3 rule 1, 2026-11-03 rule 2 |
| J11 protection | D103–D403 (DNP), two staggered columns at x 13.6 / 21.2, pad 2 (OUT) toward the pin | EMC 2026-11-03 rule 1. The 6.6 mm gaps let the OUT copper pass |
| Signal edge | J5 (rot 90, origin 93.3/53.5, pin 1 at the rail end) | Toward the rail; the front corner (y < 16) stays free for the ESP32 antenna |
| J5 protection | D16–D19, D50–D54: horizontal, pad 2 toward the pin, odd pins at x 87.6, even pins at x 79.5 | Within about 4 mm of the pins, flow-through (EMC 2026-10-30 rules 1 and 8) |
| J5 filters | R34–R37 (x 71.5), C14–C17 (x 67.3) at pins 1–4 | TVS → R → C (rule 8) |
| SW_SUPPLY chain | D54 → C54 → D55 → R56 → F4 along y 38.3 from J5.5 | EMC 2026-11-07-2 rule 3, 2026-11-03-2 rule 12 |
| Silkscreen | "BATTERY", "+", "−" at J10; OUT1–OUT4 at J11; "PANEL" and pin "1" at J5 | Decision 127 item 3, EMC 2026-11-07-3 rule 3 |

Design-notes §8.9 has the reasoning, the J10 clear zone and the safety note. STATUS.md has the dated paragraph.

## Blocked – owner (one-way door): J4 does not fit on the signal edge

- **FINDING (HIGH): J4 does not fit.** Decision 128 puts J5 (panel) and J4 (CAN) together on the 65 mm signal edge.
  - The H2 and H4 Ø 8 mm keep-outs are centred 4 mm from the corners. Any connector whose courtyard reaches the edge
    must stay outside y 0–8 and y 57–65, which leaves **49 mm**.
  - J5 takes 39.0 mm of body (40.1 mm courtyard) and J4 16.1 mm (17.2 mm courtyard): **55.1 mm at the least, 57.3 mm
    with courtyards**, before any gap between them (decision 127 asks for them to be apart).
  - Decision 128's "42 + 55 mm" count used the full edge.
- **What was done.** J5 is placed (toward the rail); J4, D9, D10 and its GND_CAN-side parts stay parked. Holes, outline and
  connector edges are owner-fixed (decisions 123/128), so this is a one-way door.
- **Question for the owner:** where does J4 go? Options:
  - (a) on the front long edge near the signal end. Simplest; the ESP32 antenna then moves along the front edge,
    away from J4.
  - (b) on the power edge. Against the split rationale of decision 128 (keep CAN away from the switching current).
  - (c) a shorter J5. Needs a schematic change; not proposed.
  - (d) holes inset further, or a longer edge. Changes decisions 123/128 and the shared DIN mount.
- **Suggested default:** (a). J4 sits on the front edge 10–15 mm from the signal-edge corner, plug outward. The CAN
  barrier (U5, GND_CAN island) goes beside it, and the antenna goes to the front edge between the power half and J4, or
  to the signal-edge corner above J5 if the keep-outs allow.

## Checks

- `kpcb drc` (whole board):
  - **0 errors**, 10 warnings, 469 unconnected (no routing yet), parity 0, bottom SMT none, hole keep-out none.
  - All 10 warnings are silkscreen:
    - 2 are the H1/H2 reference fields near the edge;
    - 7 are reference fields of D19/C54, D30/J10 and D303 overlapping;
    - 1 is my "OUT3" text over the D303 reference.
  - `kpcb` cannot delete or move a text, so these go to the silkscreen pass.
  - The error lines `kpcb drc` prints (antenna keep-out of U1, Q3/Q30, JP30/L1) are between parts still parked off the
    board and do not count.
- `python3 tools/fix_check.py --scope pdm-4ch`: **OK – passes the merge gates** (ERC 0 errors on both boards, parts unchanged).
- Render read after each group: parts are grouped at their connectors, nothing overlaps, and the hole and antenna
  corners are free.

## Open points for the next stages

1. **J4** and its protection (D9, D10, F3/R55, FB2) wait for the owner's ruling above.
2. **J10 clear zone (decision 127 item 2):**
   - Behind J10's rear face (x 20–35, y 33–56), only the low SMT parts D30/C30 sit.
   - Keep other and tall parts out, so a wire still fits if the sample shows the entry on the inner face.
   - Along the edge, J10 has 2.7 mm of room to J11 and 1.7 mm to the H3 keep-out; the 49 mm edge allows no more.
3. **Power stage:**
   - JP30/FL30 → Q30 → C31 (at Q30's drain) start right of C30 at x ≈ 30, around y 40–50.
   - VS to F4.1 (x 54.8, y 38.3) has to be routed across.
   - The GND return of D103–D403 goes to J10.2.
4. **Panel-interface stage:**
   - The LED parts R19/R22/R25/R28 → C50–C53 go after D50–D53 (column at x 79.5/87.6).
   - Even-pin traces run through the 4 mm gaps of the odd-pin column.
5. **ESP32 stage:** the antenna corner (signal end, front) is free above J5 for y < 16, but the H2 keep-out takes
   x > 92 there.
6. **Silkscreen pass:**
   - Clean the reference-field overlaps listed above, including the "OUT3" label.
   - Add "CAN" and pin 1 at J4 once it is placed.

<!-- fix:begin -->
```json
{
  "done": [],
  "blocked": [{"task": "T-0197", "door": "one-way", "reason": "J5 (40.1 mm courtyard) and J4 (17.2 mm) need 57 mm, but the signal short edge has 49 mm between the H2/H4 Ø 8 mm keep-outs; decision 128 counted the full 65 mm edge. J4, D9, D10 left parked.", "question": "Where does J4 (CAN) go: (a) front long edge near the signal end, (b) power edge, (c) shorter J5, (d) holes or edge changed?", "default": "(a) J4 on the front edge 10-15 mm from the signal-edge corner, plug outward, CAN barrier beside it"}],
  "refs": ["H1", "H2", "H3", "H4", "J10", "J11", "J5", "D30", "C30", "D103", "D203", "D303", "D403", "D16", "D17", "D18", "D19", "D50", "D51", "D52", "D53", "D54", "C54", "D55", "R56", "F4", "R34", "R35", "R36", "R37", "C14", "C15", "C16", "C17"],
  "decisions": [
    {"area": "pdm-4ch", "text": "Power edge: J11 toward the front (origin 7.8/12.0), J10 toward the rail (origin 17.2/39.5), so the heavy M4 screw terminal sits beside the rail-side holes of the DIN mount; VBAT_IN upper pole, GND lower; front faces 0.5 mm inside the edge"},
    {"area": "pdm-4ch", "text": "J5 on the signal edge toward the rail (pin 1 at the rail end), leaving the front corner free for the ESP32 antenna; its nine SMA TVSs in two staggered columns (x 87.6 odd pins, x 79.5 even pins) with pad 2 toward the pin, then R34-R37/C14-C17 and the SW_SUPPLY chain D54-C54-D55-R56-F4 along y 38.3"},
    {"area": "pdm-4ch", "text": "D30 vertical across the J10 rear VBAT_IN/GND pins and C30 beside it, both parallel to the edge; the J10 clear zone behind the terminal (x 20-35, y 33-56) holds only these low SMT parts"},
    {"area": "pdm-4ch", "text": "D103-D403 (DNP) at the J11 pins in two staggered columns (x 13.6/21.2), pad 2 toward the pin, leaving 6.6 mm gaps for the OUT copper"}
  ],
  "checks": {"drc": "0 errors, 10 warnings (silkscreen only), 469 unconnected", "parity": "0", "fix_check": "OK"}
}
```
<!-- fix:end -->
