plektra/ESP32-PDM/docs/reviews/2026-11-07-fix-sync-T-0186.md

# T-0186: "For /system" sweep (scope sync), 2026-11-07

Unattended sweep, documents only. **Nothing changed in this package:** no file was edited apart from this report.

The "For /system" lists on both boards are word for word the ones T-0185 swept earlier today. T-0185 already synced
every bookkeeping entry, and the T-0156 sweep before it gave the same verdicts for the entries that remain. Since then
the only change was decision 121 (pdm-4ch J10 → KF135T-10.16-2P C475108). ARCHITECTURE already records it (Mechanics
row "J10, 4-ch"), and it is not a list entry. Every remaining entry is a choice, not a record: firmware, a safety or
installation rule, an owner decision, mechanics, or a future revision. So each one stays word for word for an
interactive `/system` session.

## Synced

None.

## Left (word for word)

pdm-4ch:
- T-0160 IO13 status LED / J6 spare-input pulls: firmware.
- Decision 93 read IO12: firmware.
- T-0107 RIS = 500 Ω scale constant: firmware.
- T-0069 RIS note (C17975 gone, 0.8 W fault case): firmware cover of a fault case.
- T-0069 DEN firmware requirements and part-swap text: firmware. The part-swap sentence is stale (C17975 and C23228 are
  gone), but it shares an entry with firmware content, so it stays (as in T-0156, open point 2).
- RIS at the 40 mA fault current, ≥ 1.5 W hardware cover: owner decision.
- T-0118 PTC settled, competent-person review of F1–F4/R54–R56: safety review reminder.
- DIN carrier and printed enclosure: mechanics.

pdm-hc2:
- T-0072/T-0055 keyed J10, board-label warnings: installation and safety rule.
- T-0072/T-0053 firmware soft fuse on IMON, OUT sense IO4/IO5: firmware.
- Next HC2 revision (reverse polarity at J10, pre-charge path): a future revision's design choice (Q-0044, decision 94).
- Decision 93 read IO12: firmware.
- T-0160 IO13 status LED / IO42 pull: firmware.
- T-0118 competent-person review of F1–F4/R54–R56: safety review reminder.
- Bilge output fusing (T-0064): safety and installation rule (invariant 8). The README is outside the sync scope.
- DIN carrier and printed enclosure: mechanics.

## Checks

- `tools/fix_check.py --scope sync`: OK. pdm-4ch ERC 0 errors/5 warnings, 227 parts (+0), 60 unique (+0). pdm-hc2 ERC
  0 errors/5 warnings, 241 parts (+0), 65 unique (+0).
- `tools/heat_budget.py`: not edited, so the result is the same before and after: 4 × 4 A Tj 101 °C, 4.5 A 124 °C
  marginal, 5 A OVER.

## Open points

- Sweeps T-0156, T-0185 and T-0186 all found the same entries left. Further unattended sweeps will change nothing until
  an interactive `/system` session (firmware, mechanics) deals with these entries.

## Suggestions (not done)

- In `/system`: drop the stale T-0069 part-swap sentence, and reduce the T-0118 entries to the review reminder that is
  already in each STATUS.md paragraph.

<!-- fix:begin -->
```json
{
  "done": [],
  "blocked": [],
  "refs": [],
  "decisions": [],
  "synced": [],
  "left": [
    {"entry": "pdm-4ch: T-0160 firmware IO13 LED / J6 pulls", "reason": "firmware"},
    {"entry": "pdm-4ch: decision 93 firmware IO12", "reason": "firmware"},
    {"entry": "pdm-4ch: T-0107 RIS 500 ohm scale constant", "reason": "firmware"},
    {"entry": "pdm-4ch: T-0069 RIS note (C17975 gone, 0.8 W)", "reason": "firmware cover of a fault case"},
    {"entry": "pdm-4ch: T-0069 DEN firmware and part swap", "reason": "firmware; stale swap sentence shares the entry"},
    {"entry": "pdm-4ch: RIS at 40 mA fault, hardware cover", "reason": "owner decision"},
    {"entry": "pdm-4ch: T-0118 PTC settled, competent-person review", "reason": "safety review"},
    {"entry": "pdm-4ch: DIN carrier and printed enclosure", "reason": "mechanics"},
    {"entry": "pdm-hc2: T-0072/T-0055 keyed J10, board label warnings", "reason": "installation/safety rule"},
    {"entry": "pdm-hc2: T-0072/T-0053 firmware soft fuse, OUT sense", "reason": "firmware"},
    {"entry": "pdm-hc2: next HC2 revision (reverse polarity, pre-charge)", "reason": "design choice for a future revision"},
    {"entry": "pdm-hc2: decision 93 firmware IO12", "reason": "firmware"},
    {"entry": "pdm-hc2: T-0160 firmware IO13 / IO42", "reason": "firmware"},
    {"entry": "pdm-hc2: T-0118 competent-person review", "reason": "safety review"},
    {"entry": "pdm-hc2: bilge output fusing (T-0064)", "reason": "safety/installation rule"},
    {"entry": "pdm-hc2: DIN carrier and printed enclosure", "reason": "mechanics"}
  ],
  "checks": {"erc": "pdm-4ch 0 errors/5 warnings, pdm-hc2 0 errors/5 warnings (unchanged)", "netlist": "fix_check OK, 227 and 241 parts (+0), 60 and 65 unique (+0)", "heat_budget": "not edited; before = after: 4 A Tj 101 C, 4.5 A 124 C marginal, 5 A OVER"}
}
```
<!-- fix:end -->
