plektra/ESP32-PDM/docs/reviews/2026-11-07-fix-shared-T-0179.md

# T-0179 – C577772 + C577752 buying rule and interchangeable-plug warning (shared, documents only)

Date: 2026-11-07. Unattended run. Items T-0166, T-0168 (owner rulings Q-0068, Q-0069) and T-0177 (two-way door,
`docs/reviews/2026-11-07-emc-system-2.md` E21). No schematic, footprint, BOM or ARCHITECTURE change.

## What changed

**T-0166 / T-0168 (Q-0068, Q-0069).**
- `hardware/pdm-4ch/STATUS.md`, pre-order checklist, decision 98 bullet: the T-0171 wording ("using either one, or any other
  part … goes to the owner") is replaced by the ruling. Buy C577772 from any seller (LCSC restock, AliExpress Kefa, other
  distributors), check that the marking reads KF2EDGSRM-7.62 (flange header), no C577767, C7422678 or other socket, and the
  order waits if none can be bought. The stock figures are kept (40 / 63 on 2026-11-05, 0 / 63 on 2026-11-07, minimum order 18).
- `hardware/pdm-hc2/STATUS.md`, decision 98 pre-order bullet: the same rule for J11 C577772 + C577752, with the same stock figures.
- The T-0171 "for the sync sweep" note in pdm-4ch "For /system" is marked done.
- Design-notes §7 is not changed. It names no fallback socket for the 7.62 mm set. The Phoenix 10.16 mm set C6790556 it
  mentions belongs to the 10.16 mm sets from decision 98 and is outside this ruling.

**T-0177.**
- `README.md` Mounting bullet: the sentence "All connectors are keyed plugs …" is kept. New text after it says that the keying
  holds within one board only, that pdm-4ch J10 and pdm-hc2 J11 use the same 7.62 mm set (C577772 + C577752) and fit each other,
  what each wrong plugging does (battery plug in an HC2 output socket: the battery is short-circuited when channel 2 turns on;
  HC2 load plug in a pdm-4ch J10: the unit is dead), and that the battery plug must be marked (red sleeve or label) and checked
  before power-up.
- Both STATUS files: a plug-marking line next to the decision 98 sample check. It also gives the layout notes (silkscreen
  "BATTERY" + polarity at J10, "OUT1 OUT2" at J11), which layout rule 2 of the EMC report already sets. No physical fix was
  chosen. The plugs, sockets and keying are unchanged.
- Both STATUS files: dated entry at the top and "Updated:" line.

## Safety note

Plugging the battery plug into a pdm-hc2 J11 is a burn risk (dead short through Q21/Q22, outside the calculated SOA from
hot, design-notes §4a.3). The only guard now is the marking and the check before power-up. **A competent person should check
the plug marking before installation on a boat that carries both boards** (CLAUDE.md item 7).

## Checks

- `python3 tools/fix_check.py --scope shared --refs ""`: OK. pdm-4ch ERC 0 errors / 5 warnings, 227 parts (+0), 60 unique (+0).
  pdm-hc2 ERC 0 errors / 5 warnings, 241 parts (+0), 65 unique (+0). No netlist change on either board.
- Heat budget: not run, because no output changed.

## Open points

- C577772 stock: re-check before the decision 98 sample and at order time (owner action).

## Suggestions (not done)

- A physical fix that makes the two plugs fail to mate (e.g. a different set on one board) would amend decisions 98/104.
  That is the owner's call. It was not proposed here.

<!-- fix:begin -->
```json
{
  "done": ["T-0166", "T-0168", "T-0177"],
  "blocked": [],
  "refs": [],
  "decisions": [],
  "checks": {"erc": "pdm-4ch 0 errors/5 warnings, pdm-hc2 0 errors/5 warnings (unchanged)", "netlist": "unchanged on both boards (documents only; fix_check OK, +0 parts, +0 unique)", "heat_budget": "not run: no output change"}
}
```
<!-- fix:end -->
