plektra/ESP32-PDM/docs/reviews/2026-11-07-fix-pdm-4ch-T-0171.md

# Fix report – pdm-4ch T-0171: J10 socket C577772, stock fallback

Date: 2026-11-07 · Scope: `pdm-4ch` · Unattended (decision 23) · No owner ruling; all items two-way

## Summary

The J10 socket C577772 (Kefa KF2EDGSRM-7.62-2P) has JLCPCB/LCSC stock 0 and a minimum order of 18. There is no
design change. Two possible substitutes were checked against the existing footprint and the locking plug C577752,
and both fail. The only fallback is the same part, C577772, bought from another seller. That fallback is now in the
pdm-4ch pre-order checklist. Picking a different socket would need a new plug or footprint, which amends decisions
98/104. That question goes to the owner (T-0166 below).

## Per item

### T-0169 (validator M1): C577772 out of stock – done
- Pre-order checklist, decision 98 / J10 bullet: the existing "0 / 63 on 2026-11-07, minimum order 18" note is kept
  word for word. Added:
  - re-check C577772 stock before buying the decision 98 sample and again at order time;
  - J10 is bought and hand-soldered by the owner (decision 85), so JLCPCB assembly does not wait for it;
  - fallback (a): C577772 from another seller. It needs no new footprint check because the footprint was drawn from
    this part, but check that the marking reads KF2EDGSRM-7.62 (flange header) and not KF2EDGSR;
  - the two other parts checked, why they fail, and that any other part goes to the owner (decisions 98/104).

### T-0166 (cost F1): name a fallback (C577767 or C7422678) – blocked, one-way
- **C577767**, KF2EDGSR-7.62-2P (`docs/part-facts/C577767.md`, new). Pad grid 2 × 2 at 7.62 × 7.62 mm, Ø1.50
  +0.10/0 mm holes: matches the footprint `Kefa_KF2EDGSRM-7.62-2P`. Rated 30 A UL group B and 32 A IEC (≥ 16 A).
  **It has no flange or flange holes.** C577752 is KF2EDGSKM, a plug with ear screws. With no flange on the header,
  those screws have nothing to go into, and the drawings show no latch. Mating and locking are UNVERIFIED and not
  supported by the drawings. Neither part shows keying. **Fails.**
- **C7422678**, DORABO DB3ERC-7.62-2P-GN (`docs/part-facts/C7422678.md`, new). Same pad grid and holes, same
  30 A / 32 A rating, also no flange. The drawing describes locking with C577752 as "UNVERIFIED, and unlikely".
  **Fails.**
- Neither part fits the existing footprint AND mates and locks with C577752 AND is rated ≥ 16 A AND keeps the keying
  against the 5.08 mm J11. Under the brief's stop rule, I did not pick either part. Only C577772 from another seller
  is named.

### T-0167 (cost lever, INFO): T-0158 saving confirmed – done, no action
The fix says "none needed". It is recorded only in the STATUS entry.

### STATUS bookkeeping
- New dated entry at the top of `hardware/pdm-4ch/STATUS.md`. The brief said "T-0170"; the entry is filed under
  this package's id, T-0171. `Updated:` is now 2026-11-07.
- One line added to "For /system" for the sync sweep: pdm-hc2 J11 uses the same C577772 (decision 102), so the
  same re-check and fallback apply when pdm-hc2 is ordered. pdm-hc2 files are not changed.

## Checks
- `git status`: only `hardware/pdm-4ch/STATUS.md` (modified), `docs/part-facts/C577767.md` and
  `docs/part-facts/C7422678.md` (new), and this report.
- `fix_check.py --scope pdm-4ch` (no refs): OK. pdm-4ch ERC 0 errors / 5 warnings, 227 parts (+0), 60 unique (+0).
  pdm-hc2 ERC 0 errors / 5 warnings, 241 parts (+0), 65 unique (+0).
- Netlist: unchanged (no schematic touched). Heat budget: not run (no output change).

## Open points
- One-way question for the owner (T-0166): if C577772 cannot be bought from any seller in time, which way? Options:
  (1) wait for a restock or buy from another seller (the current default);
  (2) change to a non-flange header such as C577767 together with a plug that latches into it;
  (3) another flange-header set.
  Options 2 and 3 amend decisions 98/104, need a footprint check, and must keep the keying against J11.
- The C577767 facts file notes that C577752 is printed as KF2EDGSKM (not "KF2EDGSRM" as the brief writes). The
  C577772/C577752 pairing itself also rests only on the shared series name (`C577752.md`: "UNVERIFIED as a stated
  mating pair"). The decision 98 sample is the place to confirm it.

## Suggestions (not done)
- Ask Kefa which header names pair with KF2EDGSKM (flange, latch), so that a substitute can be named from the maker's
  own word.

<!-- fix:begin -->
```json
{
  "done": ["T-0169", "T-0167"],
  "blocked": [{"task": "T-0166", "door": "one-way", "reason": "Neither named fallback passes: C577767 and C7422678 match the J10 pad grid, Ø1.5 mm holes and 30 A UL / 32 A IEC, but have no flange for the C577752 plug's ear screws and their drawings show no lock (docs/part-facts/C577767.md, C7422678.md). Using either needs a new plug or footprint, which amends decisions 98/104.", "question": "If C577772 cannot be bought from any seller in time for the order or the decision 98 sample, should J10 move to a different socket + plug set (new footprint and/or plug, keyed against the 5.08 mm J11), or should the order wait for a C577772 restock?", "default": "Wait for a restock or buy C577772 from another seller; no part change"}],
  "refs": [],
  "decisions": [{"area": "pdm-4ch", "text": "J10 stock fallback: only C577772 from another seller; C577767 and C7422678 rejected (no flange, no shown lock with plug C577752) – T-0171"}],
  "checks": {"erc": "pdm-4ch 0 errors/5 warnings, pdm-hc2 0 errors/5 warnings (unchanged)", "netlist": "unchanged, no schematic touched; fix_check OK, parts +0, unique +0", "heat_budget": "not run, no output change"}
}
```
<!-- fix:end -->
