plektra/ESP32-PDM/docs/reviews/2026-11-07-fix-sync-T-0156.md

# Sync sweep of the "For /system" lists (T-0156)

Date: 2026-11-07. Scope `sync` (decision 71). No file changed except this report: no schematic, parts, refs, ARCHITECTURE, design-notes, STATUS.md or `heat_budget.py` change.

## Result

Nothing to sync. I checked all 13 entries against the schematics, the README, `decisions.md` and design-notes. None of them is pure bookkeeping, and the ARCHITECTURE rows and budgets they touch do not name a part or value the boards no longer have. T-0147 already removed the last overtaken entries. Because nothing was synced, STATUS.md stays untouched, including its date.

## Left for an interactive `/system` session (word for word)

pdm-4ch:

- Decision 93, read IO12: firmware.
- T-0107 IS scale constant RIS = 500 Ω: firmware. The figures match design-notes §6.1 (500/1500 ≈ 0.33 V/A, 500/3900 ≈ 0.128 V/A, 2.9 V/500 Ω = 5.8 mA).
- T-0069 RIS note (C17975 gone, 0.8 W fault case): firmware cover of a fault case. 0.80 W matches the §6.1 table.
- T-0069 DEN firmware requirements and part swap: firmware. See open point 2.
- RIS at the 40 mA fault current: owner decision on hardware cover.
- T-0118 PTC settled, competent-person review: safety and installation reminder. C70113 (4 parts) and C7420022 (3 parts) are on the board.
- DIN carrier and printed enclosure design: mechanics. `docs/CONTINUE-FROM-HERE.md` still lists it as open; decision 97 sets the concept, not the design.

pdm-hc2:

- T-0072/T-0055 J10 keyed, board label: safety label on a PCB that does not exist yet. The keying is settled (decision 98); the label is not yet on any board.
- T-0072/T-0053 firmware soft fuse, OUT sense: firmware.
- Next HC2 revision, reverse polarity and pre-charge: a later revision's choice (Q-0044, decision 94).
- Decision 93, read IO12: firmware.
- T-0118 PTC settled, competent-person review: safety and installation reminder. C70113 (4 parts) and C7420022 (3 parts) are on the board.
- Bilge output fusing: safety and installation rule (invariant 8). See open point 1. A competent person reviews the bilge wiring before installation.
- DIN carrier and printed enclosure design: mechanics, as above.

## Checks

- `tools/fix_check.py --scope sync --refs ""`: OK. pdm-4ch ERC 0 errors/5 warnings, 218 parts (+0), 15 DNP (+0), 62 unique (+0). pdm-hc2 ERC 0 errors/5 warnings, 232 parts (+0), 11 DNP (+0), 68 unique (+0).
- `tools/heat_budget.py`: file untouched, no input changed. 4 × 4 A Tj 101 °C, 4 × 4.5 A Tj 124 °C marginal. HC2 at 2 × 15 A Tj 90 °C. Same as T-0147 and T-0141.
- `sch_query parts`: C17975 and C23228 are on neither board. C4410 is on pdm-4ch (8 parts). C25819 is on pdm-4ch (4 parts, all DNP: R106, R206, R306, R406).

## Open points

1. **The bilge fusing rule is only partly in the README (MINOR).** The README's HC2 breaker point already says a bilge-pump output's breaker sits between J11 and the junction with the float-switch circuit. It leaves out the condition from the entry and design-notes §8.2: that fuse must **open before the float-circuit fuse** (selectivity: clearly smaller, or a slower float fuse). The README also says "so the float circuit never depends on the PDM" without that condition. The README is outside this scope, and this is a safety rule, so I changed nothing; the entry stays open. A competent person reviews the bilge wiring before installation.
2. **Stale text inside entries left word for word.** The T-0069 pdm-4ch entries still name C17975 and C23228 as a part swap, and "≈ 1.1 W". The note above them corrects C17975 and the wattage, but not C23228, which is also gone. These entries also carry firmware and owner-decision content, so they stay.

## Suggestions (not done)

- Add the selectivity sentence from design-notes §8.2 to the README's HC2 breaker point, then close the bilge entry.
- In the T-0069 entry, keep the DEN firmware sentence and drop the part-swap sentence.
- The T-0118 entry repeats its STATUS.md paragraph on both boards. `/system` could keep the reminder there and drop the entry (also suggested by T-0147).
- The ARCHITECTURE `power-usb` and `analog_sw` rows still do not mention R54–R56 (decision 81). The rows are not wrong, only incomplete, so this is outside the sync rule (also suggested by T-0141 and T-0147).

<!-- fix:begin -->
```json
{
  "done": [],
  "blocked": [],
  "refs": [],
  "decisions": [],
  "synced": [],
  "left": [
    {"item": "pdm-4ch Decision 93 read IO12", "reason": "firmware"},
    {"item": "pdm-4ch T-0107 IS scale constant RIS = 500 ohm", "reason": "firmware"},
    {"item": "pdm-4ch T-0069 RIS note (C17975 gone, 0.8 W fault case)", "reason": "firmware cover of a fault case"},
    {"item": "pdm-4ch T-0069 DEN firmware requirements and part swap", "reason": "firmware; stale part-swap sentence flagged in the report"},
    {"item": "pdm-4ch RIS at the 40 mA fault current", "reason": "owner decision on hardware cover"},
    {"item": "pdm-4ch T-0118 PTC settled, competent-person review", "reason": "safety and installation reminder"},
    {"item": "pdm-4ch DIN carrier and printed enclosure design", "reason": "mechanics, still open"},
    {"item": "pdm-hc2 T-0072/T-0055 J10 keyed, board label", "reason": "safety label, no PCB yet"},
    {"item": "pdm-hc2 T-0072/T-0053 firmware soft fuse, OUT sense", "reason": "firmware"},
    {"item": "pdm-hc2 Next revision reverse polarity and pre-charge", "reason": "a later revision's choice, Q-0044, decision 94"},
    {"item": "pdm-hc2 Decision 93 read IO12", "reason": "firmware"},
    {"item": "pdm-hc2 T-0118 PTC settled, competent-person review", "reason": "safety and installation reminder"},
    {"item": "pdm-hc2 Bilge output fusing", "reason": "safety and installation rule, invariant 8; README has the position but not the selectivity condition, and README is out of sync scope"},
    {"item": "pdm-hc2 DIN carrier and printed enclosure design", "reason": "mechanics, still open"}
  ],
  "checks": {
    "erc": "pdm-4ch and pdm-hc2 0 errors, 5 warnings (unchanged)",
    "netlist": "fix_check OK: 218 and 232 parts (+0), 62 and 68 unique (+0)",
    "heat_budget": "no input changed, file untouched; before = after: 4 x 4 A Tj 101 C, 4 x 4.5 A Tj 124 C marginal, HC2 2 x 15 A Tj 90 C"
  }
}
```
<!-- fix:end -->
