plektra/ESP32-PDM/docs/reviews/2026-11-03-fix-pdm-4ch-T-0132.md

# Fix report – pdm-4ch – T-0132 (T-0126, T-0129)

Unattended run, 2026-11-04. Scope `pdm-4ch`. **No schematic change, no refs.**

## T-0126 – Q30 AGM601LL swap check (cost lever L1): checked, swap fails, lever dropped

Facts: `docs/part-facts/C5464765.md` (new, AGM601LL datasheet VER2.65).

| Condition | AGM601LL | Result |
|---|---|---|
| V(BR)DSS ≥ 60 V | 60 V min | pass |
| VGS ≥ 15 V | ±20 V | pass |
| RDS(on) at about 10 V | specified at 10 V: **typ 1.25, max 1.6 mΩ** (25 °C). The cost report's 1.25 mΩ is typical | specified |
| Avalanche rating | EAS 1225 mJ (25 °C, 70 A, 0.5 mH) | pass |
| Body diode | IS 223 A, VSD 1.2 V max; **no ISM** | not verifiable |
| C32 ≥ 10 × Ciss max | Ciss typ 5.47 nF, **no max** (10 × typ = 55 nF ≪ 1 µF) | not verifiable (max) |
| Pinout / package | 1 G, 2–8 S, tab D; body 10.25–10.55 × 9.75–10.05, e 1.20, H 11.55–11.85 (Infineon: 10.28–10.58, 9.70–10.10, 1.20, 11.48–11.88) | plausible, no land pattern |
| RthJA at 6 cm² | 50 K/W, **no copper area stated** | not verifiable |
| **Q30 Tj at 40 A ≤ 125 °C** | see below | **FAIL** |

Q30 junction by the design-notes 8.6 method (Tj = T_air + I²·RDS(on)(Tj)·RthJA, max curve 1.6 mΩ × Fig. 6 factors 1.00/1.14/1.47/1.80 at 25/50/100/150 °C). Enclosure air comes from `tools/heat_budget.py --p-other 2.3 --r-path 0.0069` (4 mΩ + 2.9 mΩ hot): 45.7 / 46.6 °C. At 40 A the air is 52.5 °C, from `--part BTT6010-1ERA --currents 10`, which gives 53.0 °C with 6.9 mΩ; 52.5 °C was used and the difference does not matter here.

| Input | IPT007N06N (method check) | AGM601LL max, 40 K/W | AGM601LL max, 50 K/W | AGM601LL typ, 40 K/W |
|---|---|---|---|---|
| 16 A | 54 °C | 66 °C | 72 °C | 61 °C |
| 24 A | 67 °C | 101 °C | 121 °C | 86 °C |
| 40 A | 124 °C (design-notes: 122 °C with 51.2 °C air) | runaway, no solution < 175 °C | runaway | ≈ 249 °C |

Even 1.25 mΩ held at its 25 °C value gives 2.0 W and ≈ 132 °C at 40 A. To pass it would need RthJA ≈ 17 K/W: more copper or a second FET, neither in the item. As the brief says, the lever is dropped. Q30 stays IPT007N06N C122552.

Decision 9 tool runs at 40 °C, `--p-other 2.3`, r_path 4 / 5.05 (today) / 6.9 mΩ (AGM601LL hot), for the record:
- 4 × BTT6050 at 4 A: Tj 101 / 102 / 102 °C. At 4.5 A: 124 marginal / 125 marginal / 125 OVER.
- 2 × BTT6010 at 8 A + 2 × BTT6050 at 4 A: P_tot 9.61 / 10.22 / 11.31 W, Tj 90/102, 90/102, 91/103 °C.
- 4 × BTT6010 at 8 A: P_tot 10.81 / 11.90 / 13.83 W, Tj 91 / 91 / 93 °C.

The channel ratings would have held; the failure is Q30's own junction, which the tool does not model.

Written up in design-notes §8.6 Cost and in the pdm-4ch STATUS.md.

## T-0129 – design-notes 8.6 (b) avalanche correction: BLOCKED (stop condition of the brief)

The arithmetic for IPT007N06N (it stays). C = 100 µF + 4 × 2.2 µF + 4 × 100 nF ≈ 109.2 µF. E = C·(VS + 48.4 − Vav)·Vav:
- At VS 29 V: 114 mJ at Vav 60 V and 82 mJ at 66 V. That compares with ½CV² = 46 mJ.
- VS sags to Vav − 48.4 = 11.6–17.6 V.
- 12 V system (VS 14.6 V): 20 mJ at Vav 60 V; none at 66 V.

The brief's numbers check out.

The problem: new facts in `docs/part-facts/C122552.md` (added through `part_facts.py --more`).
- The EAS of 1100 mJ is for **Tj(start) = 25 °C**.
- The datasheet has no EAS-vs-Tj curve and **no repetitive avalanche rating**.
- Diagram 13 (IAS vs tAV) at Tj(start) 125 °C holds 150 A for only ≈ 21 µs, which is ≈ 100 mJ triangular. At 25 °C the same curve gives ≈ 880 mJ. V(BR)DSS rises to ≈ 63 V at 125 °C.

At the 40 A input rating Q30 runs at Tj ≈ 122 °C, so a transient at that moment is a hot-start avalanche. I simulated the C31 discharge, with and without a 40 A load, for ESR 30–300 mΩ (`$CLAUDE_JOB_DIR/scripts/av_margin.py`):
- At a 125 °C start, the Diagram 13 time limit is only **≈ 1.0–1.9×** the pulse length for ESR 50–300 mΩ (≈ 3× at 30 mΩ).
- At a 100 °C start it is ≈ 2–7×; at 25 °C it is ≥ 9×.

C31's ESR has no lower bound in its facts file. The rating is therefore **not clearly above** the absorbed energy at the hot corner. The brief says to stop and ask here, because the question is now a safety one for the panel supply on VS. If Q30 fails short, reverse protection is lost; if it fails open, the board is dead, including the navigation-light and bilge forced-run panel switches.

§8.6 (b) is left word for word as it was; the pdm-4ch STATUS.md says it is pending.

## Checks

- `tools/fix_check.py --scope pdm-4ch --refs ""`: OK (see the fix block).
- ERC unchanged: no schematic file was touched.
- Netlist: no change.
- heat_budget: runs as above.

## Suggestions (not done)

- Bound the hot-start avalanche case another way: take C31's ESR/impedance from the Ymin datasheet, or measure it on the prototype.
- Ask for an Infineon EAS(Tj) figure for IPT007N06N (newer datasheet revision).

<!-- fix:begin -->
```json
{
  "done": ["T-0126"],
  "blocked": [{"task": "T-0129", "door": "one-way", "reason": "Energy check of the brief's stop condition: EAS 1100 mJ is only rated at Tj(start) 25 C (no EAS(Tj), no repetitive rating); at the 40 A input rating Q30 starts at Tj ~122 C, where IPT007N06N Diagram 13 leaves only ~1-2x margin for the 80-115 mJ / 1.3-1.9 mC a negative transient with VS charged puts into Q30, depending on C31 ESR, which is not bounded. Safety question for the panel supply on VS (Q30 short: no reverse protection; open: board and panel switches dead).", "question": "A negative transient on VBAT_IN with VS charged avalanches Q30 (about 77 V otherwise, 60 V part). At 16-24 A the rating margin is >= 2-7x, but at the 40 A input rating (Q30 hot) it is only about 1-2x by the datasheet's IAS-tAV curve. Accept documenting this as an assumption (T-0130: such transients do not occur) with no hardware change, or should the hot case be covered (e.g. limit the rating, bound C31 ESR by measurement, or add protection on VS, which changes the 'no TVS on VS' wording of 8.6 (c))?", "default": null}],
  "refs": [],
  "decisions": [{"area": "pdm-4ch", "text": "Q30 cost lever L1 dropped: AGM601LL C5464765 is 1.6 mOhm max (1.25 typ), RthJA 50 K/W without copper area; Q30 has no stable Tj below 175 C at 40 A (IPT007N06N 124 C by the same method). Q30 stays IPT007N06N C122552 (design-notes 8.6 Cost)"}],
  "checks": {"erc": "unchanged, no schematic edit (pdm-4ch 0 errors, 5 lib_symbol_mismatch warnings)", "netlist": "no change, no schematic edit", "heat_budget": "40 C, p_other 2.3: r_path 4/5.05/6.9 mOhm: 4x4 A Tj 101/102/102 C; mix Tj 90-102/90-102/91-103 C; 4x8 A Tj 91/91/93 C; Q30 own Tj at 40 A: IPT007N06N 124 C, AGM601LL runaway >175 C (FAIL)"}
}
```
<!-- fix:end -->
