plektra/ESP32-PDM/docs/reviews/2026-11-03-fix-sync-T-0085.md

# T-0085 – sync of the "For /system" lists (scope sync), 2026-11-03

Unattended run. No schematic change: documents and one tool default only. Files touched: `docs/ARCHITECTURE.md`
(Shared sheets table only, Invariants untouched), `docs/design-notes.md` (§4, §4a.2), `tools/heat_budget.py`,
`hardware/pdm-4ch/STATUS.md`, `hardware/pdm-hc2/STATUS.md`.

## Synced (removed from the "For /system" lists)

1. **T-0073 32 V full scale** (both boards). Already recorded: decision 38 amends decision 18, design-notes §2 gives
   ≈ 31.9 V; ARCHITECTURE does not mention 33 V. Nothing to change beyond removing the item.
2. **T-0068/T-0047 `--p-other` default** (4-ch). design-notes §4 documents ≈ 2.2 W (0.6 W controller + 1.6 W panel
   interface at 30 V, everything on). Default raised 0.6 → 2.2 W in `tools/heat_budget.py` with a comment citing §4;
   help text updated. design-notes §4 updated ("default unchanged" sentence and the assumptions line); the §4a.2 HC2
   command now states `--p-other 0.6` so its recorded figures stay reproducible. The ARCHITECTURE budgets still hold
   (4-ch 4 A → Tj 101 °C, HC2 15 A → 90 °C), the worst case is already what §4 used.
3. **T-0067 `can` row ISO1044 → CA-IS3050G** (both). Row now names CA-IS3050G (SOIC-8-WB), R70, DNP FL1 bridged by
   R71/R72, DNP C70, LEN 1 at 49.3 mA worst case and the prototype measurement. Checked against both schematics
   (`sch_query parts`) and design-notes §8.5, which already holds the LEN recheck and the measurement step.
4. **T-0065 `can` row TPS7B91 → L78M05ABDT** (both). Row names L78M05ABDT, DPAK footprint ≈ 10.4 × 6.7 mm (decision
   45, design-notes §8.3, which already addresses the area to `/system mechanical`). The old LEN figures (44.8/76.8 mA)
   and the "recheck if the transceiver changes" step are superseded by the §8.5 recheck (item 3).
5. **Root row: C30/C31, FL30/JP30, VBAT_IN** (4-ch). Added to the root row as in decision 41; checked on both boards
   (C30 on /VBAT_IN with D30/J10, C31 on VS, FL30 DNP and JP30 between VBAT_IN and VS).

## Left word for word (for an interactive `/system` session)

- T-0068/T-0046 2.2 k/2.4 k resistor choice – owner question (blocked item, money/parts choice).
- T-0069 DEN firmware requirements and extended-part note – firmware list.
- RIS ≥ 1.5 W hardware cover – owner decision.
- T-0065 PTC interrupt rating (F1/F3/F4) – safety/protection question for the owner.
- T-0065 unique extended parts list – cost record for the owner/cost session, no document row to sync it into.
- T-0064 extended parts and C13832 reuse hint – cost choice.
- Terminal blocks / J5 (4-ch), module width (hc2) – mechanics.
- J10 keyed/polarised (hc2) – mechanics, label.
- Firmware soft fuse on IMON (hc2) – firmware.
- Next HC2 revision: reverse-polarity protection – deferred owner decision (Q-0044).
- Bilge output fusing / README installation rule (hc2) – safety and installation requirement.

## Checks

- `tools/heat_budget.py` before (default 0.6 W): 4 × BTT6050 4 A → Tj 100 °C; HC2 (`--channels 2 --part HC-2xBSC030
  --rth-ja 20 --r-box 0.9 --r-path 0.002`) 15 / 17.5 / 18 A → 88 / 111 / 117 °C.
  After (default 2.2 W): 4 A → Tj 101 °C; HC2 15 / 17.5 / 18 A → 90 / 113 / 119 °C.
- `tools/fix_check.py --scope sync`: ERC 0 errors / 5 warnings on both boards, parts +0, unique +0 – OK.

## Open points

None beyond the items left above.

## Suggestions (not done)

- The `--p-other` worst case differs per board (4-ch 2.2 W, HC2 ≈ 1.9 W); a per-board default could be derived from
  `--part`, but that is a tools change beyond this sync.

<!-- fix:begin -->
```json
{
  "done": [],
  "blocked": [],
  "refs": [],
  "decisions": [],
  "synced": [
    "T-0073 32 V full scale (both): already recorded in decision 38 / design-notes §2",
    "T-0068/T-0047 heat_budget --p-other default 0.6 -> 2.2 W (design-notes §4)",
    "T-0067 ARCHITECTURE can row: CA-IS3050G, R70, DNP FL1/C70, LEN (both)",
    "T-0065 ARCHITECTURE can row: L78M05ABDT DPAK (both)",
    "ARCHITECTURE root row: C30/C31, FL30/JP30, VBAT_IN (pdm-4ch)"
  ],
  "left": [
    "T-0068/T-0046 2.2k/2.4k resistors: owner choice (parts/money)",
    "T-0069 DEN firmware requirements and extended-part note: firmware list",
    "RIS >= 1.5 W hardware cover: owner decision",
    "T-0065 PTC interrupt rating F1/F3/F4: safety question for the owner",
    "T-0065 unique extended parts list: cost record, no row to sync",
    "T-0064 extended parts / C13832 reuse: cost choice",
    "Terminal blocks J5 (4-ch): mechanics",
    "J10 keyed/polarised (hc2): mechanics and label",
    "Firmware soft fuse on IMON (hc2): firmware",
    "Next HC2 revision reverse-polarity protection: deferred owner decision",
    "Bilge output fusing README rule (hc2): safety/installation requirement",
    "Module width (hc2): mechanics/enclosure"
  ],
  "checks": {
    "erc": "0 errors, 5 lib_symbol_mismatch warnings on each board (unchanged)",
    "netlist": "no schematic change; parts +0, unique +0 on both boards",
    "heat_budget": "before (p_other 0.6): 4ch 4 A Tj 100 C; HC2 15/17.5/18 A 88/111/117 C. after (default 2.2): 4ch 4 A Tj 101 C; HC2 15/17.5/18 A 90/113/119 C"
  }
}
```
<!-- fix:end -->
