plektra/ESP32-PDM/docs/reviews/2026-11-03-fix-sync-T-0084.md

# Fix T-0084 (sync): HC2 heat-budget RDS(on) at 150 °C – verify T-0082 and close

Date: 2026-11-03. Scope: sync (decision 71). No file changed apart from this report.

## T-0057 – already done by T-0082 (commit ca2c930)

1. `tools/heat_budget.py` line 30: `'HC-2xBSC030': (0.0070, 0.0117)`. The comment above it cites
   BSC030N08NS5 Rev 2.3 Diagram 9 (p. 8): max 3.0 mΩ at 25 °C, ~5.35 mΩ at 150 °C, path = 2 × FET + 1 mΩ shunt
   (T-0057, design-notes 4a.2). Holds.
2. `python3 tools/heat_budget.py --channels 2 --part HC-2xBSC030 --rth-ja 20 --r-box 0.9 --r-path 0.002 --currents 15,20`:
   15 A → Tj 88 °C, 20 A → Tj 143 °C (OVER, as expected). Also 19.7 A (upper IOC, T-0072) → 139 °C.
   Both one-way gates clear: 15 A is below ~100 °C and 19.7 A is below Tj max 150 °C (Table 2).
3. `docs/design-notes.md` §4a (line 189–190) quotes 11.7 mΩ, 88 °C / 143 °C and keeps "Continuous rating ≈ 15 A per
   channel"; §4a.2 (line 271) quotes 11.7 mΩ, 15 A → 88 °C, 19.7 A → 139 °C. Holds.

No board `STATUS.md` lists this item under "For /system", so there was nothing to remove there.

## Checks

- heat_budget (run once, no input change, so before = after): 15 A 88 °C, 20 A 143 °C, 19.7 A 139 °C.
- `tools/fix_check.py --scope sync --refs ""`: OK. pdm-4ch ERC 0 errors / 5 warnings, 196 parts (+0);
  pdm-hc2 ERC 0 errors / 5 warnings, 212 parts (+0).

## Open points

None.

<!-- fix:begin -->
```json
{
  "done": [],
  "blocked": [],
  "refs": [],
  "decisions": [],
  "synced": ["T-0057: HC-2xBSC030 RDS(on) 150 C = 11.7 mOhm – already applied by T-0082 (ca2c930); tool and design-notes verified, no change needed"],
  "left": [],
  "checks": {"erc": "pdm-4ch 0 errors/5 warnings, pdm-hc2 0 errors/5 warnings (unchanged)", "netlist": "unchanged, +0 parts on both boards", "heat_budget": "before = after (no input change): 2ch HC-2xBSC030 rth-ja 20, r-box 0.9: 15 A 88 C, 19.7 A 139 C, 20 A 143 C"}
}
```
<!-- fix:end -->
