plektra/ESP32-PDM/docs/reviews/2026-11-02-fix-pdm-hc2-T-0070.md

# Fix report – pdm-hc2 – T-0070 (HC2 gate slew control) – 2026-11-02

Unattended run (decision 23). Items: T-0006 (Q-0001), T-0054 (Q-0043), T-0059, T-0061 (Q-0045).
**Result: the gate slew control is blocked at the SOA check (stop condition in the brief). No schematic change.**
T-0059 and the STATUS notes are done.

## Part facts used

- `docs/part-facts/C17556513.md` (TPS4811-Q1, SLUSEE5E rev. E): §8.3.2.1 / Fig. 8-6 topology (PU → R1 → gate, PD
  direct to the gate, C1 + R2 ≈ 10 Ω at the gate), Eq. 3 IINRUSH = 0.63 × V(BST–SRC) × CLOAD / (R1 × C1), Eq. 4
  CBST > Qg(total) + 10 × C1, Eq. 1 TDRV_EN = CBST × 7.6 V / 100 µA, tSC 4 µs typ / 5 µs max, Eq. 9 retry.
- `docs/part-facts/C501507.md` (BSC030N08NS5 rev. 2.3): Qg 61 / 76 nC (typ/max), SOA Diagram 3 at VDS = 30 V,
  Tc = 25 °C, single pulse: 10 µs ≈ 185 A, 100 µs ≈ 15 A, **1 ms ≈ 1.5 A, 10 ms ≈ 0.4 A** (digitised, ±15 %);
  Zth j-c (max) Diagram 4: 0.09 K/W at 100 µs, 0.29 at 1 ms, 0.57 at 10 ms.

## T-0054 / T-0006 / T-0061 – gate slew control: BLOCKED (one-way)

Sizing per the ruling: R1 = 100 kΩ, Eq. 3 with V(BST–SRC) = 12 V, 1000 µF, 20 A → C1 = 3.78 nF → **3.9 nF** (E12),
as the owner expected. Ramp at 30 V: t = C·V/I = 1.5 ms. Eq. 4: 2 × 76 nC + 10 × 3.9 nF = 191 nC < 1 µF CBST, OK.

The SOA check fails. In the common-source back-to-back pair, the input-side MOSFET (Q11/Q21) carries the whole
VS − VOUT during the ramp. The output-side MOSFET conducts through its channel or body diode. Calculation
(`$CLAUDE_JOB_DIR/scripts/slew_soa.py`: power profile (V − vout) × I, superposed on the Zth max curve, log-log
interpolated):

| CLOAD | I_inrush | ramp | P peak | E in Q11 | ΔTj above case (Zth) |
|---|---|---|---|---|---|
| 1000 µF | 20 A | 1.5 ms | 600 W | 0.45 J | **100 K** (125 K with a 15 A resistive load attached) |
| 1000 µF | 10 A | 3.0 ms | 300 W | 0.45 J | 68 K |
| 1000 µF | 5 A | 6.0 ms | 150 W | 0.45 J | 41 K |
| 470 µF | 20 A | 0.7 ms | 600 W | 0.21 J | 68 K |
| 220 µF | 20 A | 0.33 ms | 600 W | 0.10 J | 46 K |
| 100 µF | 20 A | 0.15 ms | 600 W | 0.045 J | 31 K |

- **SOA (Diagram 3):** the 1 ms line allows ≈ 1.5 A × 30 V ≈ 45 W. The ruled ramp needs 600 W for 1.5 ms, about
  13 × too much. Slower ramps make it worse, because the 10 ms line allows only ≈ 12 W while the energy stays 0.45 J.
  Even 100 µF at 20 A (600 W for 150 µs) is above the 100 µs line (≈ 450 W). This OptiMOS 5 part is made for
  switch mode. Its curves fall steeply at 30 V (∝ VDS⁻², the thermal-instability region), so it cannot run in linear
  mode for milliseconds.
- **Thermal (Zth alone, independent of how the SOA plot is read):** ΔTj ≈ 100 K above the case at 20 A / 1000 µF.
  With the case at 40–60 °C that reaches 140–160 °C. On a retry after running at 15 A (Tj ≈ 87 °C, heat budget) it
  reaches ≈ 190 °C. Either way it is over 150 °C.
- **Short-circuit response (checked as asked):** the PD path stays direct, so turn-off would not be slowed (tSC
  4–5 µs, 4 A PD sink). **Turn-on into a short gets worse with slew control**, though. The gate then rises slowly
  through the linear region with the full 30 V across Q11 until 80 A trips ISCP: about 1 kW for ≈ 100 µs with
  100 kΩ / 3.9 nF (τ = 0.39 ms), against ≈ 450 W at 100 µs on the SOA. The fast trip itself is not delayed, but the
  MOSFET would be outside SOA before it trips.

So no R1/C1 pair meets both the ~20 A / 1000 µF target (Q-0045) and the MOSFET SOA. The brief says to stop here: the
answer needs either a maximum load capacitance or a different MOSFET (decision 19, **[proposed]**). R104/R204
therefore stay 10 Ω PU → gate. No C1, R2 or RGATE_PD was added, and RG_PU 100 Ω was not fitted (Q-0043 supersedes
it). The no-PWM rule of Q-0001 is recorded.

Options for the owner (not done, all need a ruling):
1. **State a maximum load capacitance** for HC2 outputs and keep the BSC030N08NS5, with a short slew (tens of µs)
   mainly for EMC E2. The SOA allows only about ≤ 50–100 µF at ~20 A. It can be set once the prototype measures the
   real loads.
2. **Linear-mode MOSFET** with a guaranteed SOA (hot-swap/"linear FET" class) instead of Q11/Q21 only, the input
   side. This is a part change under decision 19, at some extra cost and with its RDS(on) and heat budget to check.
3. **Pre-charge path**: TPS48111-Q1 has a separate G pin for a pre-charge FET + resistor (TI's method for large
   capacitive loads). This is a controller variant change with added parts.

## T-0059 – timing notes: DONE

- design-notes §4a, new bullet "Timing the user sees": the bootstrap delay at first switch-on, Eq. 1 1 µF × 7.6 V /
  100 µA ≈ 76 ms (≈ 95 ms at the minimum 80 µA, ≈ 100 ms with CBST tolerance). It applies to the hardware switch
  path too. The retry is Eq. 9 22.7·10⁶ × 10 µF ≈ 3.8 min. The new ramp time cannot be given yet, because the slew
  values are blocked; the note says so.
- Correction to the finding: the datasheet names INP / EN toggle as the reset for **latch-off** mode (p. 24). That an
  INP toggle cuts the **auto-retry** wait short is not stated in the facts read, so I marked it UNVERIFIED and listed
  it as a prototype test rather than writing it as fact.
- README "Important limitations": a short `pdm-hc2` timing bullet (≈ 0.1 s first switch-on, ≈ 4 min off after a trip,
  no PWM).

## STATUS (brief step 5): DONE

`hardware/pdm-hc2/STATUS.md`: the T-0070 entry (blocked, with the numbers), "no PWM until bench-measured", the
prototype test of real load capacitance/inrush and of INP-toggle retry reset, and Next item 0.

## Failure-mode note (bilge forced-run)

Nothing on the outputs changed, so their behaviour is as before: hard turn-on, 80 A fast trip, 25 A / 146 ms
breaker, 3.8 min retry. Points that matter for safety while this is open:
- A bilge pump or a load driver with a large input capacitance (more than ~50–100 µF) can trip the 80 A fast
  short-circuit protection at switch-on (T-0054 estimate). The output then stays off for ≈ 3.8 min, also on the
  hardware forced-run path. The float switch stays independent (invariant 8). Measure each intended load on the
  prototype (Q-0045).
- A stalled pump draws a steady overcurrent. The 25 A / 146 ms breaker turns it off, and it retries every 3.8 min.
  The slow-ramp design would have added linear-mode stress here at every retry. That is a further reason not to fit
  it with this MOSFET.
- A competent person must review the bilge outputs before installation.

## Checks

- `tools/fix_check.py --scope pdm-hc2 --refs ""`: **OK**. pdm-hc2 ERC 0 errors / 5 warnings (unchanged), 185 parts
  (+0), 75 unique (+0). pdm-4ch unchanged.
- Netlist: no schematic edit, so the netlist is unchanged.
- Heat budget: not rerun, because no output ratings or switch parts changed. The 15 A rating stands as in §4a. The
  11.7 mΩ scratch run belongs with the slew change once it is unblocked.

## Suggestions (not done)

- Add the HC2 load-capacitance limit (≈ 50–100 µF at hard turn-on, from T-0054) to the README once the owner rules on
  option 1.
- The SOA readout is digitised (±15 %). The thermal (Zth) result supports the blocking independently, but confirm the
  Diagram 3 reading in `/validate pdm-hc2 deep`.

<!-- fix:begin -->
```json
{
  "done": ["T-0059"],
  "blocked": [
    {"task": "T-0054", "door": "one-way", "reason": "No R1/C1 pair meets 20 A into 1000 uF within the BSC030N08NS5 SOA: 600 W peak / 0.45 J over 1.5 ms vs SOA ~45 W at 1 ms (30 V); Zth gives dTj ~100 K above case (125 K with a 15 A load); slow turn-on into a short would also leave SOA before the 80 A trip. Fix needs a maximum load capacitance or a different MOSFET/pre-charge path (decision 19, proposed).", "question": "HC2 gate slew control: (1) set a maximum load capacitance (about 50-100 uF at ~20 A with the BSC030N08NS5) and use only a short EMC slew, (2) fit a linear-mode-rated MOSFET on the input side (decision 19), or (3) move to TPS48111-Q1 with a pre-charge FET + resistor?", "default": null},
    {"task": "T-0006", "door": "one-way", "reason": "Superseded by Q-0043 (do not fit RG_PU 100 ohm); waits on the T-0054 answer. The no-PWM rule is recorded in STATUS and design-notes 4a.", "question": "Covered by the T-0054 question.", "default": null},
    {"task": "T-0061", "door": "one-way", "reason": "The ruled sizing target (20 A into 1000 uF) is outside the MOSFET SOA; the prototype load measurement is recorded in STATUS.", "question": "Covered by the T-0054 question.", "default": null}
  ],
  "refs": [],
  "decisions": [],
  "checks": {"erc": "pdm-hc2 0 errors, 5 lib_symbol_mismatch warnings (unchanged); pdm-4ch unchanged", "netlist": "no schematic edit; parts +0, unique +0 on both boards", "heat_budget": "not rerun - no output change; 15 A per channel stands (design-notes 4a)"}
}
```
<!-- fix:end -->
