plektra/ESP32-PDM/docs/reviews/2026-11-02-fix-shared-T-0065.md

# Fix report T-0065 – shared supply, USB and fuse parts (2026-11-02, unattended)

Scope: shared sheets `power-usb`, `can`, `analog_sw`, edited with `tools/ksch.py` scripts and kept identical on
`pdm-4ch` and `pdm-hc2` (only the `(project …)` name differs). Calculations and sources: `docs/design-notes.md` §8.3.

## Per item

### T-0018 (Q-0011) – PTC Imax check: **FAILED → blocked, one-way, nothing changed**
LUTE 1812L series datasheet (Rev. 2020, p. 3), 1812L050/60GR: I_max **40 A** at V_max 60 V, R_min 0.150 Ω. Note 3: the part must not
be used where I_max can be exceeded in a fault condition. The ruling's prospective current: 30 V / (0.150 + 0.010) Ω ≈ **188 A**
(4.7 × I_max) for a hard short directly behind F1 (on-board: D1, C1, U3 input), F4 (J5.5 terminal / first metres of the
panel cable, VS-fed) or F3 (J4/NET-S side; in practice the N2K power-tee fuse and drop-cable resistance limit this, but it is not guaranteed).
Even with 0.3 Ω of wiring the current is ≈ 65 A. F4 feeds the panel switches (bilge forced run, navigation lights), so this is
safety-relevant. A competent person must review F1/F3/F4 before installation. Following the brief, nothing was changed and the F2 swap
(which depended on this check) was not done.

Proposal for the owner (also in the fix block):
- (a) Swap F1/F3/F4 to an 1812 60 V PTC listed with I_max 100 A (TECHFUSE mSMD050-60V C70113, 0.088 USD, or JDT
  ASMD1812-050-60V C427396; same footprint; datasheets to be checked) **and** add a series resistance so that 30 V / R_total
  ≤ I_max. For example, ≥ 0.3 Ω total including the PTC: a 0.15–0.22 Ω pulse-rated resistor per PTC. Its pulse energy until trip must be
  checked. The F1 load is ≈ 0.2 A, F4 ≈ 50 mA, F3 ≤ 77 mA, so the DC drop is negligible.
- (b) Accept the residual risk and document it (prospective current at the board is limited only by battery, cable and terminals).
- No JLCPCB 1812 PTC covers 188 A on its own.

### T-0026 (Q-0019) – four L3 swaps: three adopted, F2 not adopted
- **FB1, FB2** BLM18AG601SN1D → **GZ2012D601TF (C1017, basic, 0805)**. Sunlord GZ catalogue p. 3: 600 Ω ± 25 % at 100 MHz,
  DCR ≤ 0.30 Ω, 500 mA. FB1 carries ≤ 0.40 A from VBUS (USB-only operation). **Pass.**
- **F2** SMD0805B050TF stays: the swap depended on T-0018, which failed.
- **D4–D6** PESD0402V05 → **H5VL10B (C7420372, preferred, DFN1006-2 → `Diode_SMD:D_SOD-882`)**. V_RWM 5 V, V_C ≤ 8 V at 1 A /
  ≤ 10 V at 5 A (8/20 µs), C_J 15 typ / 18 max pF, ±25 kV IEC 61000-4-2. This is inside the ≤ 15–20 pF USB FS budget. The old
  polymer part clamped at 40 V (8 kV contact), so ESD protection is **stronger**, not weaker. **Pass.**
- **U6** TPS7B91 → **L78M05ABDT (C58069, basic, DPAK `TO-252-2`)**. V_I abs max 35 V vs the SMAJ18CA clamp 29.2 V (20 % margin).
  I_d 6 mA (+0.8 mA). **LEN unchanged:** with ISO1044 I_CC2 (TI SLLSFB0A) 38 mA max (1 Mbit/s traffic) the NET-S current goes
  38 → 44.8 mA (LEN 1), and 70 → 76.8 mA held dominant (LEN 2). Dropout 2 V: 8.5 V available at NET-S 9 V. DPAK pinout
  1 IN / tab GND / 3 OUT matches the KiCad L7805 symbol and the TO-252-2 pads. The symbol was placed on the old pin points (same UUID),
  so IN/GND nets are unchanged and OUT moved from pin 5 to pin 3. Input capacitor C13 raised 0.1 µF → **1 µF/50 V 0805 (C28323, basic)**
  for the datasheet's C_I 0.33 µF. Heat ≈ 0.48 W → +48 K (R_θJA 100 K/W). DPAK area noted for `/system mechanical`. **Pass.**

### T-0014 (Q-0008) – USB: done
- README: USB-C is a service port only (battery-powered laptop or USB isolator), with the reason.
- J3 SH moved from GND to the new net `USB_SHIELD`. To GND: **R13 1 MΩ 1206 (C17927, basic)** ‖ **C18 4.7 nF/1 kV X7R 1206
  (Yageo CC1206KKX7RCBB472, C107198, extended)** fitted, and **R14 0 Ω 0603 (C21189) DNP** as the hard-tie option (auto choice:
  RC fitted, 0 Ω DNP). No basic 4.7 nF part ≥ 250 V exists.
- TLP/clamp check of the remaining ESD part (H5VL10B): no TLP curve published; 8/20 µs clamp data verified (above). Recorded
  on the pre-order checklist. A USBLC6-2-type part is the alternative if TLP data are required.
- J3 USB-C stays fitted (Q-0029).

### T-0011 (Q-0005) – buck: done
TI SLUSEY1B §8.2.2.6/8.2.2.7. **C19 100 nF/100 V 0805 (C28233, basic)** VIN–GND next to C1. **R43 0 Ω 0402 (C17168)** between U3 CB
and C2. **R44 10 Ω 1206 (C17903) + C20 100 pF/100 V C0G 0603 (C296717)** SW→GND, **both DNP** (≈ 63 mW at 24 V if fitted).
LMR51610YDBVR kept.

### T-0015 (Q-0009) – capacitor ratings: done
- **C1** 2.2 µF/50 V → **2.2 µF/100 V X7R 1206 Samsung CL31B225KCHSNNE (C170101, extended)**. No basic or preferred ≥ 63 V 2.2 µF
  exists. Reusing C13832 (1 µF/100 V) twice would give 2 µF, below TI's 2.2 µF minimum, so a new extended part was accepted.
- **C50–C53** 1 nF 0402 → **1 nF/2 kV X7R 1206 FH 1206B102K202NT (C9196, basic)**. This is the only basic 1 nF part ≥ 63 V. Values kept.

### T-0022 (Q-0015) – L1 second sources: done (documentation only)
SWPA6045S8R2MT, Sunltech SLW6045S8R2MST (C47018494) and cjiang FNR6045S8R2MT (C168074) have the same datasheet values:
8.2 µH ± 20 %, DCR 0.043 typ / 0.056 Ω max, I_sat 3.90 A, I_rms 2.60 A, 6.0 × 6.0 × 4.5 mm, land a 2.8 / b 1.7 / c 5.7 mm. Both
are approved and recorded in both STATUS files. The stock recheck is on the new pre-order checklist. SLW has no EasyEDA footprint at JLCPCB.

## Checks
- ERC after every step on both boards: 6 violations, all `lib_symbol_mismatch` (BC817 ×4, PLMR51610XDBVR, USB4145-03-0170-C),
  unchanged from the baseline. 0 errors.
- Netlist (kicadxml) compared with the previous step after every step, and base → final on both boards. Changed components:
  C1, C13, C18, C19, C20, C50–C53, D4–D6, FB1, FB2, R13, R14, R43, R44, U6. Changed nets: `USB_SHIELD` (J3.SH, R13, C18, R14) new;
  `Net-(U3-CB)` = U3.1 + R43.2, new `Net-(C2-Pad1)` = C2.1 + R43.1; SW net + R44.2; new `Net-(C20-Pad2)`; VIN net + C19.1; GND
  + C18.2, C19.2, C20.1, R13.2, R14.2, − J3.SH; `Net-(U5-VCC2)` U6 pin 5 → 3; U6 NC pins 3/4 removed. Both boards are identical in these changes.
- Shared sheets `power-usb`, `can`, `analog_sw`: identical on both boards apart from the project name (checked after every step).
- Every new or changed part has an LCSC code; R14, R44, C20 are DNP (with LCSC codes for later fitting).
- `tools/heat_budget.py` (40 °C): unchanged, BTT6050 4 A → Tj 100 °C. No output changed. L78M05 adds ≈ 0.07 W.
- `*.kicad_prl` restored after kicad-cli.

## Open points
- T-0018 PTC question (one-way, below).
- ARCHITECTURE `can` row still names TPS7B91 → `/system` (not edited; not part of the ruling).
- LEN margin is only 5 mA in the normal-traffic case. Recheck it if T-0030 swaps the CAN transceiver.
- Footprints to check against JLCPCB before ordering: D_SOD-882 (C7420372), TO-252-2 (C58069), L_0805 (C1017).
- KiCad GUI tidy-up of the script-placed parts (labels/positions in `power-usb` near J3, U3 and the SW node).

Reminder: F1/F3/F4 protect safety-relevant paths (F4: panel switches for bilge forced run and navigation lights). A
competent person must review the fusing before installation.

<!-- fix:begin -->
```json
{
  "done": ["T-0026", "T-0014", "T-0011", "T-0015", "T-0022"],
  "blocked": [
    {
      "task": "T-0018",
      "door": "one-way",
      "reason": "Datasheet check failed: 1812L050/60GR Imax 40 A at 60 V (LUTE 1812L Rev. 2020 p. 3), Rmin 0.150 ohm; prospective short current behind F1/F3/F4 = 30 V / (0.150 + 0.010) ohm = 188 A (4.7 x Imax). Protection problem (F4 feeds the panel switches incl. bilge forced run / nav lights), so not changed; the dependent F2 swap of T-0026 was not done either.",
      "question": "How should F1/F3/F4 be made safe against a hard short? (a) 1812 60 V PTC with Imax 100 A (TECHFUSE mSMD050-60V C70113 or JDT ASMD1812-050-60V C427396, same footprint, after datasheet check) plus a pulse-rated series resistor per PTC so that 30 V / R_total <= Imax (about 0.15-0.22 ohm); or (b) accept and document the residual risk (current limited only by battery, cable and terminals)?",
      "default": null
    }
  ],
  "refs": ["C1", "C2", "C11", "C12", "C13", "C18", "C19", "C20", "C50", "C51", "C52", "C53", "D2", "D3", "D4", "D5", "D6", "FB1", "FB2", "J3", "L1", "R13", "R14", "R43", "R44", "U3", "U5", "U6"],
  "decisions": [
    {"area": "system", "text": "L3 swaps (T-0026): FB1/FB2 -> Sunlord GZ2012D601TF C1017 (600 ohm@100 MHz, 0.30 ohm, 500 mA); D4-D6 -> H5VL10B C7420372 on D_SOD-882 (VRWM 5 V, VC 10 V@5 A 8/20us, CJ 18 pF max); U6 -> L78M05ABDT C58069 DPAK (VI max 35 V vs 29.2 V clamp, Id 6 mA, LEN unchanged 1/2) with C13 1 uF/50 V 0805 C28323; F2 not swapped (PTC Imax check failed)"},
    {"area": "system", "text": "USB shield (T-0014): J3 SH on net USB_SHIELD, R13 1 M 1206 C17927 || C18 4.7 nF/1 kV X7R 1206 Yageo C107198 fitted, R14 0 ohm 0603 C21189 DNP hard-tie option"},
    {"area": "system", "text": "Buck (T-0011): C19 100 nF/100 V 0805 C28233 at U3 VIN; R43 0 ohm 0402 C17168 in series with boot cap C2; SW snubber R44 10 ohm 1206 C17903 + C20 100 pF/100 V C0G 0603 C296717, both DNP (values set at the pre-compliance scan)"},
    {"area": "system", "text": "Capacitor ratings (T-0015): C1 -> 2.2 uF/100 V X7R 1206 Samsung CL31B225KCHSNNE C170101 (extended; no basic >=63 V, 2x C13832 would be below TI's 2.2 uF minimum); C50-C53 -> 1 nF/2 kV X7R 1206 FH C9196 (basic)"},
    {"area": "system", "text": "L1 approved alternates (T-0022): Sunltech SLW6045S8R2MST C47018494 and cjiang FNR6045S8R2MT C168074, same 8.2 uH / 0.056 ohm max / Isat 3.9 A / Irms 2.6 A / 6045 land as SWPA6045S8R2MT; stock recheck on the pre-order checklist"}
  ],
  "checks": {
    "erc": "both boards after every step: 0 errors, 6 lib_symbol_mismatch warnings (unchanged)",
    "netlist": "compared after every step and base->final on both boards; changes limited to the declared refs (new nets USB_SHIELD, Net-(C2-Pad1), Net-(C20-Pad2); U6 OUT pin 5->3); shared sheets identical apart from project name",
    "heat_budget": "unchanged (BTT6050 4 A -> Tj 100 C at 40 C); no output changed, L78M05 adds ~0.07 W controller loss"
  }
}
```
<!-- fix:end -->
