plektra/ESP32-PDM/hardware/pdm-4ch/ESP32-PDM-4CH.kicad_pcb

## KiCad design hardware/pdm-4ch/ESP32-PDM-4CH.kicad_pcb (2026-11-14)

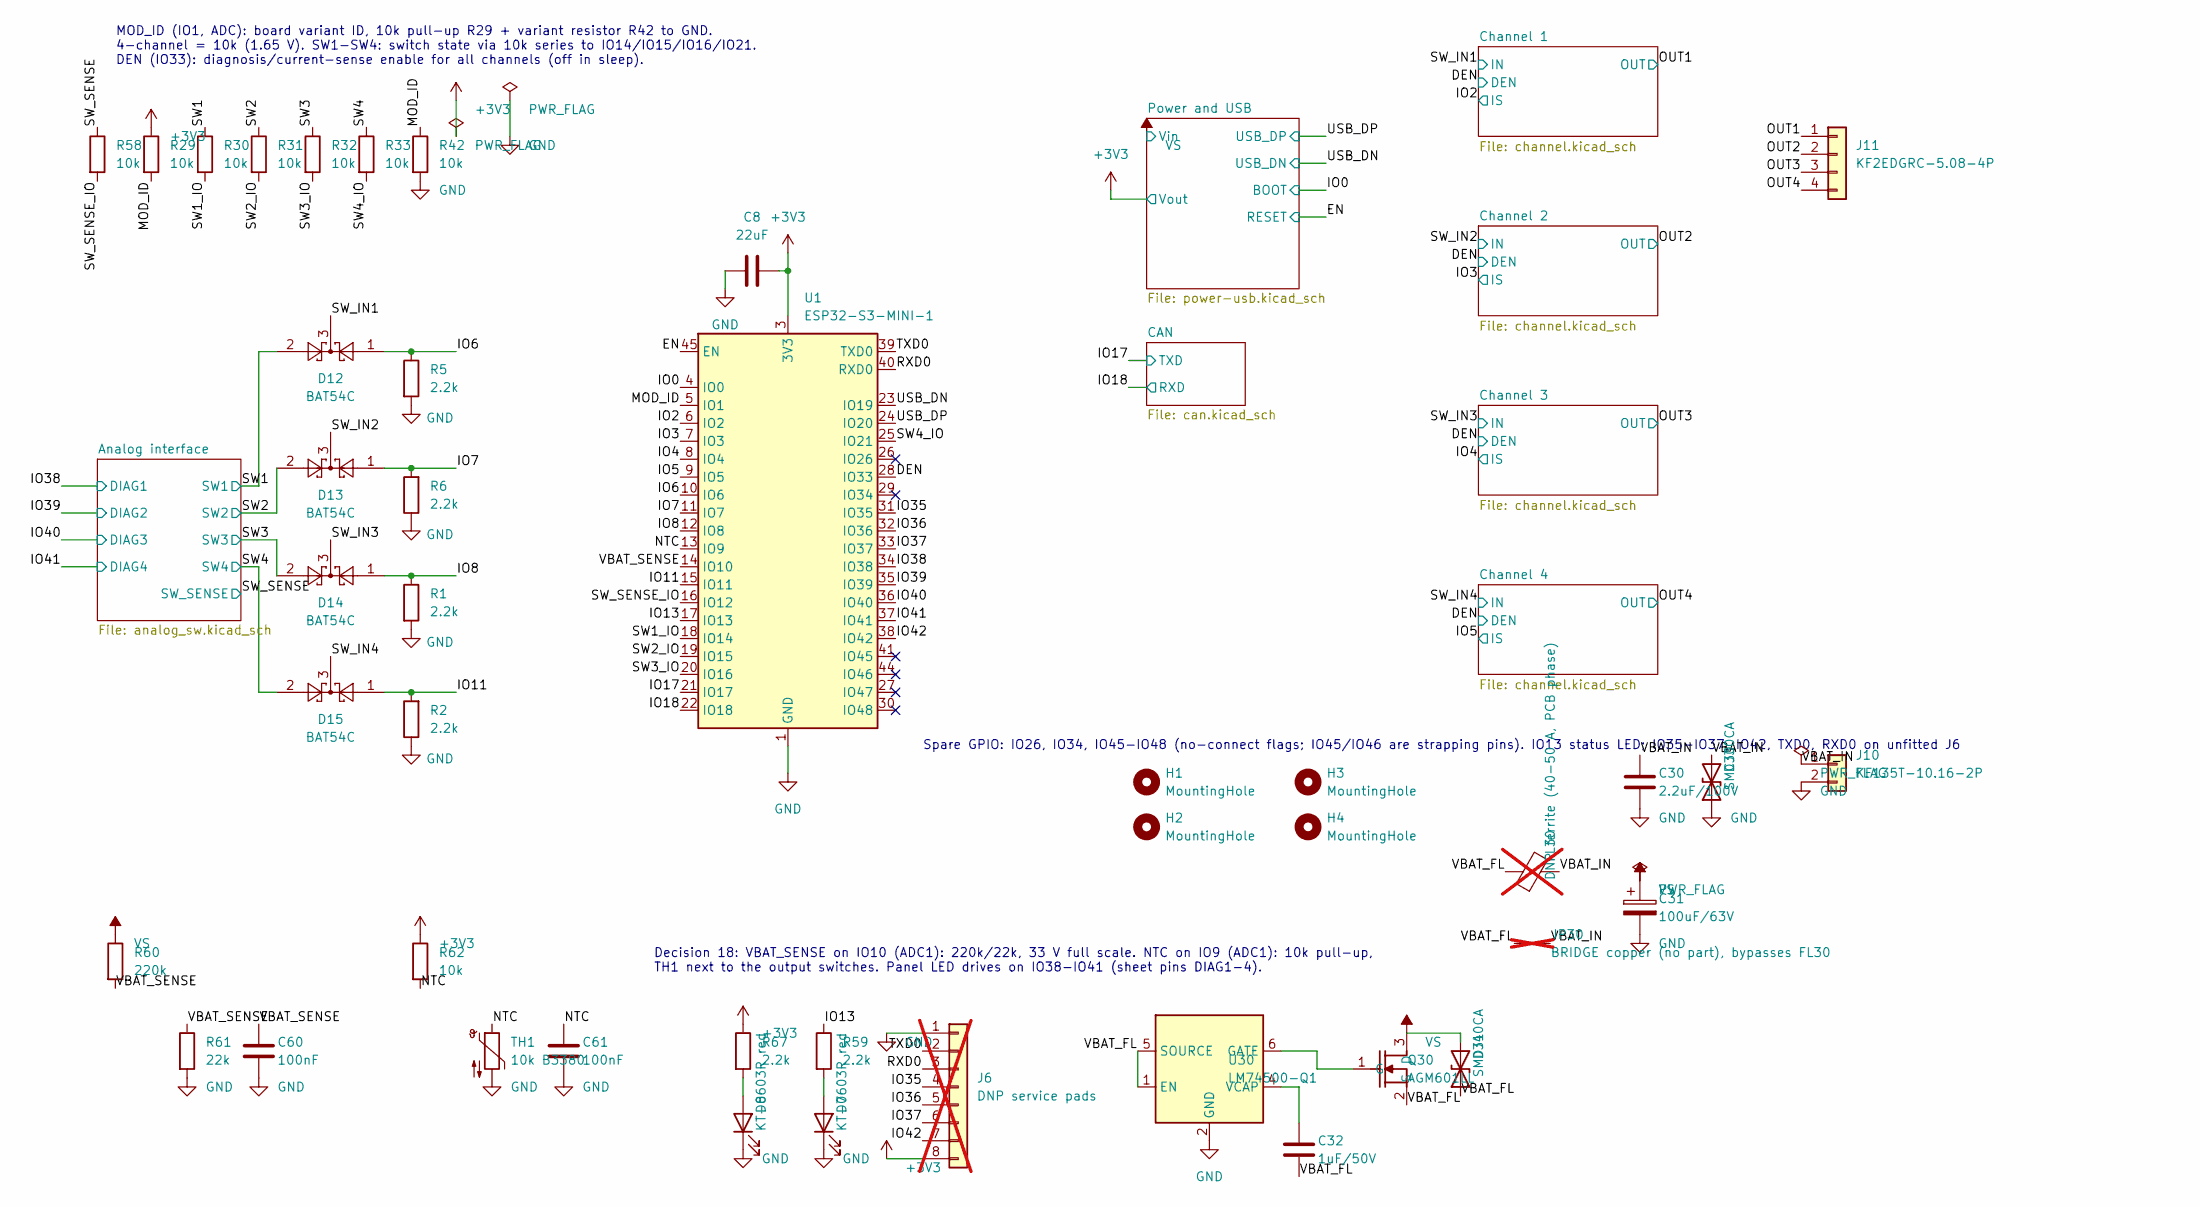
[picture p1: schematic ESP32-PDM-4CH.kicad_sch]

Parts:
C8: 22uF; C_0805_2012Metric; LCSC C45783
C30: 2.2uF/100V; C_1206_3216Metric; MPN Samsung CL31B225KCHSNNE; LCSC C170101
C31: 100uF/63V; CP_Elec_8x10; MPN Ymin VKMD1001J101MV; LCSC C487384
C32: 1uF/50V; C_0603_1608Metric; LCSC C15849
C60, C61: 100nF; C_0402_1005Metric; LCSC C307331
D7, D8: KT-0603R red; LED_0603_1608Metric; LCSC C2286
D12, D13, D14, D15: BAT54C; SOT-23; LCSC C22466350
D30: SMCJ30CA; D_SMC; LCSC C19077607
D31: SMDJ40CA; D_SMC; LCSC C42371557
FL30: DNP ferrite (40-50 A, PCB phase); not fitted
H1, H2, H3, H4: MountingHole; MountingHole_3.2mm_M3
J6: DNP service pads; PinHeader_1x08_P2.54mm_Vertical; not fitted
J10: KF135T-10.16-2P; Kefa_KF135T-10.16-2P; LCSC C475108
J11: KF2EDGRC-5.08-4P; Kefa_KF2EDGRC-5.08-4P; LCSC C441238
JP30: BRIDGE copper (no part), bypasses FL30; NetTie-2_SMD_Pad2.0mm; not fitted
Q30: AGM601LL; Infineon_PG-HSOF-8-1; LCSC C5464765
R1, R2, R5, R6, R59, R67: 2.2k; R_0402_1005Metric; LCSC C25879
R29, R30, R31, R32, R33, R42, R58, R62: 10k; R_0402_1005Metric; LCSC C25744
R60: 220k; R_0402_1005Metric; LCSC C25767
R61: 22k; R_0402_1005Metric; LCSC C25768
TH1: 10k B3380; R_0603_1608Metric; LCSC C52155402
U1: ESP32-S3-MINI-1; ESP32-S2-MINI-1; LCSC C2913206
U30: LM74500-Q1; TI_DDF0008A; MPN LM74500QDDFRQ1; LCSC C5219210

Connections:
+3V3: C8.2, J6.8, R29.1, R62.1, R67.1, U1.3 (3V3); also elsewhere on the board
/DEN: U1.28 (IO33); also elsewhere on the board
/EN: U1.45 (EN); also elsewhere on the board
/IO0: U1.4 (IO0); also elsewhere on the board
/IO2: U1.6 (IO2); also elsewhere on the board
/IO3: U1.7 (IO3); also elsewhere on the board
/IO4: U1.8 (IO4); also elsewhere on the board
/IO5: U1.9 (IO5); also elsewhere on the board
/IO6: D12.1, R5.1, U1.10 (IO6)
/IO7: D13.1, R6.2, U1.11 (IO7)
/IO8: D14.1, R1.1, U1.12 (IO8)
/IO11: D15.1, R2.2, U1.15 (IO11)
/IO13: R59.1, U1.17 (IO13)
/IO17: U1.21 (IO17); also elsewhere on the board
/IO18: U1.22 (IO18); also elsewhere on the board
/IO35: J6.4, U1.31 (IO35)
/IO36: J6.5, U1.32 (IO36)
/IO37: J6.6, U1.33 (IO37)
/IO38: U1.34 (IO38); also elsewhere on the board
/IO39: U1.35 (IO39); also elsewhere on the board
/IO40: U1.36 (IO40); also elsewhere on the board
/IO41: U1.37 (IO41); also elsewhere on the board
/IO42: J6.7, U1.38 (IO42)
/MOD_ID: R29.2, R42.1, U1.5 (IO1)
/NTC: C61.1, R62.2, TH1.1, U1.13 (IO9)
/OUT1: J11.1; also elsewhere on the board
/OUT2: J11.2; also elsewhere on the board
/OUT3: J11.3; also elsewhere on the board
/OUT4: J11.4; also elsewhere on the board
/RXD0: J6.3, U1.40 (RXD0)
/SW1: D12.2, R30.1; also elsewhere on the board
/SW1_IO: R30.2, U1.18 (IO14)
/SW2: D13.2, R31.1; also elsewhere on the board
/SW2_IO: R31.2, U1.19 (IO15)
/SW3: D14.2, R32.1; also elsewhere on the board
/SW3_IO: R32.2, U1.20 (IO16)
/SW4: D15.2, R33.1; also elsewhere on the board
/SW4_IO: R33.2, U1.25 (IO21)
/SW_IN1: D12.3; also elsewhere on the board
/SW_IN2: D13.3; also elsewhere on the board
/SW_IN3: D14.3; also elsewhere on the board
/SW_IN4: D15.3; also elsewhere on the board
/SW_SENSE: R58.1; also elsewhere on the board
/SW_SENSE_IO: R58.2, U1.16 (IO12)
/TXD0: J6.2, U1.39 (TXD0)
/USB_DN: U1.23 (IO19); also elsewhere on the board
/USB_DP: U1.24 (IO20); also elsewhere on the board
/VBAT_FL: C32.2, D31.1 (A1), FL30.1, JP30.1, Q30.2 (S), U30.1 (EN), U30.5 (SOURCE)
/VBAT_IN: C30.1, D30.2 (A2), FL30.2, J10.1, JP30.2
/VBAT_SENSE: C60.1, R60.2, R61.1, U1.14 (IO10)
GND: C8.1, C30.2, C31.2, C60.2, C61.2, D7.1 (K), D8.1 (K), D30.1 (A1), J6.1, J10.2, R1.2, R2.1, R5.2, R6.1, R42.2, R61.2, TH1.2, U1.1 (GND), U1.2 (GND), U1.42 (GND), U1.43 (GND), U1.46 (GND), U1.47 (GND), U1.48 (GND), U1.49 (GND), U1.50 (GND), U1.51 (GND), U1.52 (GND), U1.53 (GND), U1.54 (GND), U1.55 (GND), U1.56 (GND), U1.57 (GND), U1.58 (GND), U1.59 (GND), U1.60 (GND), U1.61 (GND), U1.62 (GND), U1.63 (GND), U1.64 (GND), U1.65 (GND), U30.2 (GND); also elsewhere on the board
unnamed: D7.2 (A), R59.2
unnamed: D8.2 (A), R67.2
unnamed: Q30.1 (G), U30.6 (GATE)
unnamed: C32.1, U30.4 (VCAP)
VS: C31.1, D31.2 (A2), Q30.3 (D), R60.1; also elsewhere on the board

Notes on the sheet:
MOD_ID (IO1, ADC): board variant ID, 10k pull-up R29 + variant resistor R42 to GND. 4-channel = 10k (1.65 V). SW1-SW4: switch state via 10k series to IO14/IO15/IO16/IO21. DEN (IO33): diagnosis/current-sense enable for all channels (off in sleep).
Spare GPIO: IO26, IO34, IO45-IO48 (no-connect flags; IO45/IO46 are strapping pins). IO13 status LED; IO35-IO37, IO42, TXD0, RXD0 on unfitted J6
Decision 18: VBAT_SENSE on IO10 (ADC1): 220k/22k, 33 V full scale. NTC on IO9 (ADC1): 10k pull-up, TH1 next to the output switches. Panel LED drives on IO38-IO41 (sheet pins DIAG1-4).

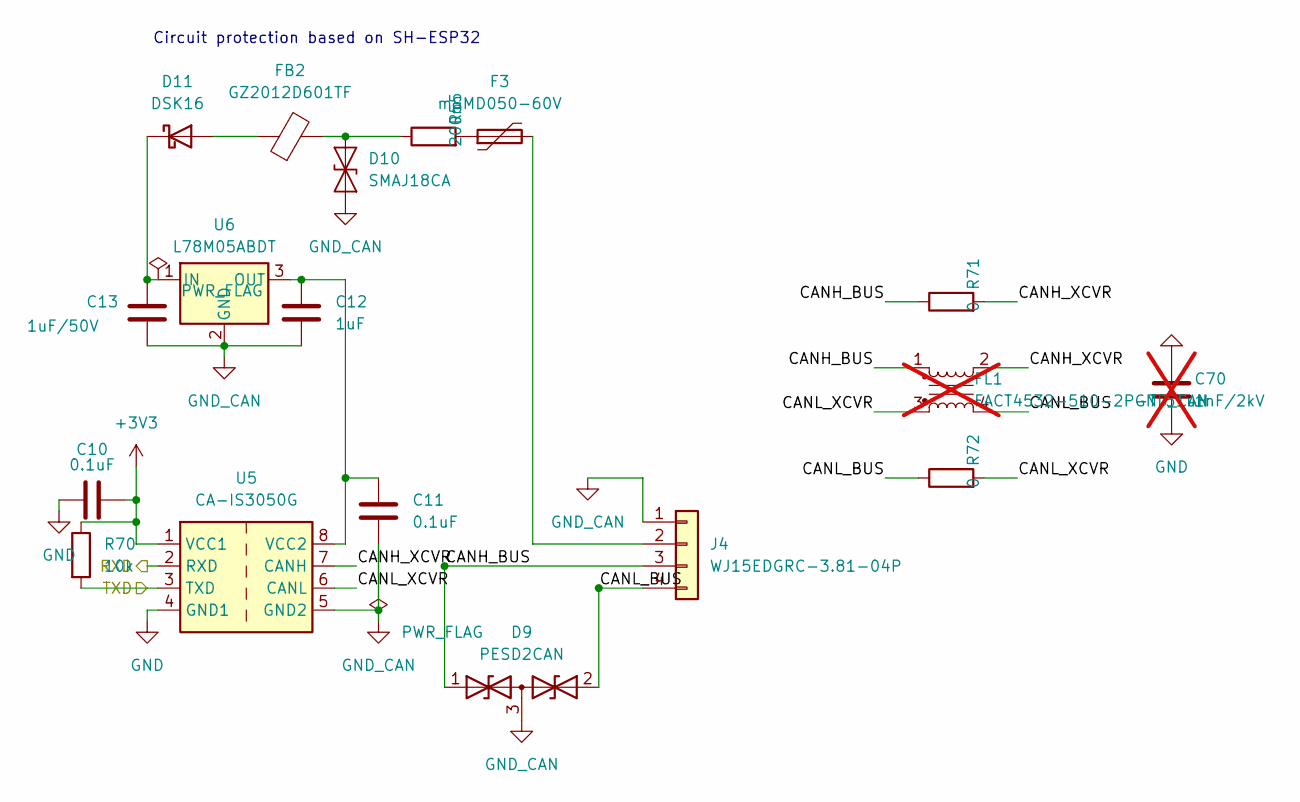
[picture p2: schematic can.kicad_sch]

Parts:
C10, C11: 0.1uF; C_0402_1005Metric; LCSC C307331
C12: 1uF; C_0402_1005Metric; LCSC C52923
C13: 1uF/50V; C_0805_2012Metric; LCSC C28323
C70: 1nF/2kV; C_1206_3216Metric; LCSC C9196; not fitted
D9: PESD2CAN; SOT-23; LCSC C2687131
D10: SMAJ18CA; D_SMA; LCSC C19077539
D11: DSK16; D_SOD-123F; LCSC C22466351
F3: mSMD050-60V; Fuse_1812_4532Metric; LCSC C70113
FB2: GZ2012D601TF; L_0805_2012Metric; LCSC C1017
FL1: FACT4532-510-2P-T 51uH; L_CommonModeChoke_Coilank_ACM4532; LCSC C20624726; not fitted
J4: WJ15EDGRC-3.81-04P; Kangnex_WJ15EDGRC-3.81-04P; LCSC C7245
R55: 200m; R_2512_6332Metric; LCSC C7420022
R70: 10k; R_0402_1005Metric; LCSC C25744
R71, R72: 0; R_0402_1005Metric; LCSC C17168
U5: CA-IS3050G; SOIC-8_7.5x5.85mm_P1.27mm; LCSC C528763
U6: L78M05ABDT; TO-252-2; LCSC C58069

Connections:
+3V3: C10.2, R70.1, U5.1 (VCC1); also elsewhere on the board
/CAN/CANH_BUS: D9.1 (A1), FL1.1, J4.3, R71.1
/CAN/CANH_XCVR: FL1.2, R71.2, U5.7 (CANH)
/CAN/CANL_BUS: D9.2 (A2), FL1.4, J4.4, R72.1
/CAN/CANL_XCVR: FL1.3, R72.2, U5.6 (CANL)
/IO17: R70.2, U5.3 (TXD); also elsewhere on the board
/IO18: U5.2 (RXD); also elsewhere on the board
GND: C10.1, C70.2, U5.4 (GND1); also elsewhere on the board
GND_CAN: C11.2, C12.2, C13.2, C70.1, D9.3 (common), D10.1 (A1), J4.1, U5.5 (GND2), U6.2 (GND)
unnamed: D10.2 (A2), FB2.2, R55.1
unnamed: D11.2 (A), FB2.1
unnamed: C13.1, D11.1 (K), U6.1 (IN)
unnamed: F3.1, R55.2
unnamed: F3.2, J4.2
unnamed: C11.1, C12.1, U5.8 (VCC2), U6.3 (OUT)

Notes on the sheet:
Circuit protection based on SH-ESP32

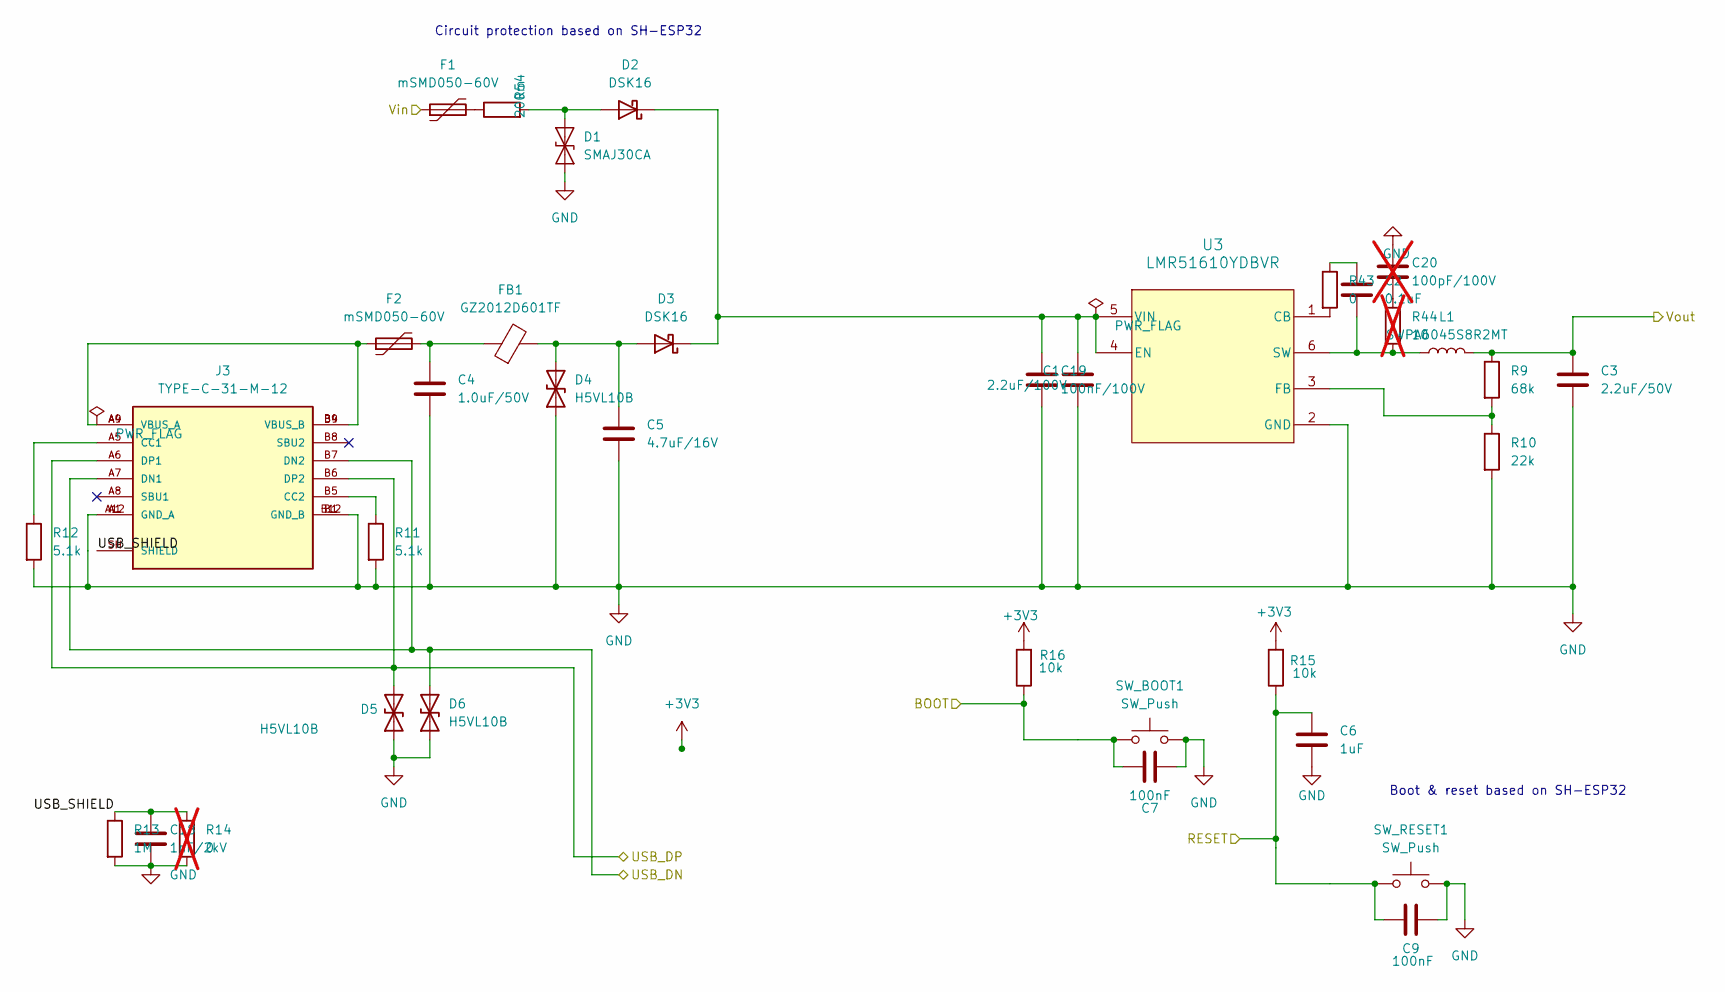
[picture p3: schematic power-usb.kicad_sch]

Parts:
C1: 2.2uF/100V; C_1206_3216Metric; LCSC C170101
C2: 0.1uF; C_0402_1005Metric; LCSC C307331
C3: 2.2uF/50V; C_0805_2012Metric; LCSC C377773
C4: 1.0uF/50V; C_0603_1608Metric; LCSC C15849
C5: 4.7uF/16V; C_0603_1608Metric; LCSC C19666
C6: 1uF; C_0603_1608Metric; LCSC C15849
C7, C9: 100nF; C_0805_2012Metric; LCSC C28233
C18: 1nF/2kV; C_1206_3216Metric; LCSC C9196
C19: 100nF/100V; C_0805_2012Metric; LCSC C28233
C20: 100pF/100V; C_0603_1608Metric; LCSC C296717; not fitted
D1: SMAJ30CA; D_SMA; LCSC C19077548
D2, D3: DSK16; D_SOD-123F; LCSC C22466351
D4, D5, D6: H5VL10B; D_SOD-882; LCSC C7420372
F1, F2: mSMD050-60V; Fuse_1812_4532Metric; LCSC C70113
FB1: GZ2012D601TF; L_0805_2012Metric; LCSC C1017
J3: TYPE-C-31-M-12; USB_C_Receptacle_HRO_TYPE-C-31-M-12; PARTREV A2; LCSC C165948
L1: SWPA6045S8R2MT; L_Sunlord_SWPA6045S; LCSC C96963
R9: 68k; R_0402_1005Metric; LCSC C36871
R10: 22k; R_0402_1005Metric; LCSC C25768
R11, R12: 5.1k; R_0402_1005Metric; LCSC C25905
R13: 1M; R_1206_3216Metric; LCSC C17927
R14: 0; R_0603_1608Metric; LCSC C21189; not fitted
R15, R16: 10k; R_0402_1005Metric; LCSC C25744
R43: 0; R_0402_1005Metric; LCSC C17168
R44: 10; R_1206_3216Metric; LCSC C17903; not fitted
R54: 200m; R_2512_6332Metric; LCSC C7420022
SW_BOOT1: SW_Push; SW_Push_1P1T_XKB_TS-1187A; LCSC C318884
SW_RESET1: SW_Push; SW_Push_1P1T_XKB_TS-1187A; LCSC C318884
U3: LMR51610YDBVR; SOT-23-6; LCSC C22427220

Connections:
+3V3: C3.1, L1.2, R9.1, R15.2, R16.2; also elsewhere on the board
/EN: C6.1, C9.1, R15.1, SW_RESET1.1; also elsewhere on the board
/IO0: C7.2, R16.1, SW_BOOT1.1; also elsewhere on the board
/Power and USB/USB_SHIELD: C18.1, J3.SH (SHIELD), R13.1, R14.1
/USB_DN: D6.2 (A2), J3.A7 (DN1), J3.B7 (DN2); also elsewhere on the board
/USB_DP: D5.2 (A2), J3.A6 (DP1), J3.B6 (DP2); also elsewhere on the board
GND: C1.1, C3.2, C4.2, C5.2, C6.2, C7.1, C9.2, C18.2, C19.2, C20.1, D1.1 (A1), D4.1 (A1), D5.1 (A1), D6.1 (A1), J3.A1 (GND_A), J3.A12 (GND_A), J3.B1 (GND_B), J3.B12 (GND_B), R10.2, R11.2, R12.2, R13.2, R14.2, SW_BOOT1.2, SW_RESET1.2, U3.2 (GND); also elsewhere on the board
unnamed: C2.1, R43.1
unnamed: C4.1, F2.2, FB1.1
unnamed: C20.2, R44.1
unnamed: D1.2 (A2), D2.2 (A), R54.2
unnamed: C5.1, D3.2 (A), D4.2 (A2), FB1.2
unnamed: F1.2, R54.1
unnamed: F2.1, J3.A4 (VBUS_A), J3.A9 (VBUS_A), J3.B4 (VBUS_B), J3.B9 (VBUS_B)
unnamed: J3.A5 (CC1), R12.1
unnamed: J3.B5 (CC2), R11.1
unnamed: R43.2, U3.1 (CB)
unnamed: R9.2, R10.1, U3.3 (FB)
unnamed: C2.2, L1.1, R44.2, U3.6 (SW)
VS: F1.1; also elsewhere on the board

Notes on the sheet:
Circuit protection based on SH-ESP32
Boot & reset based on SH-ESP32

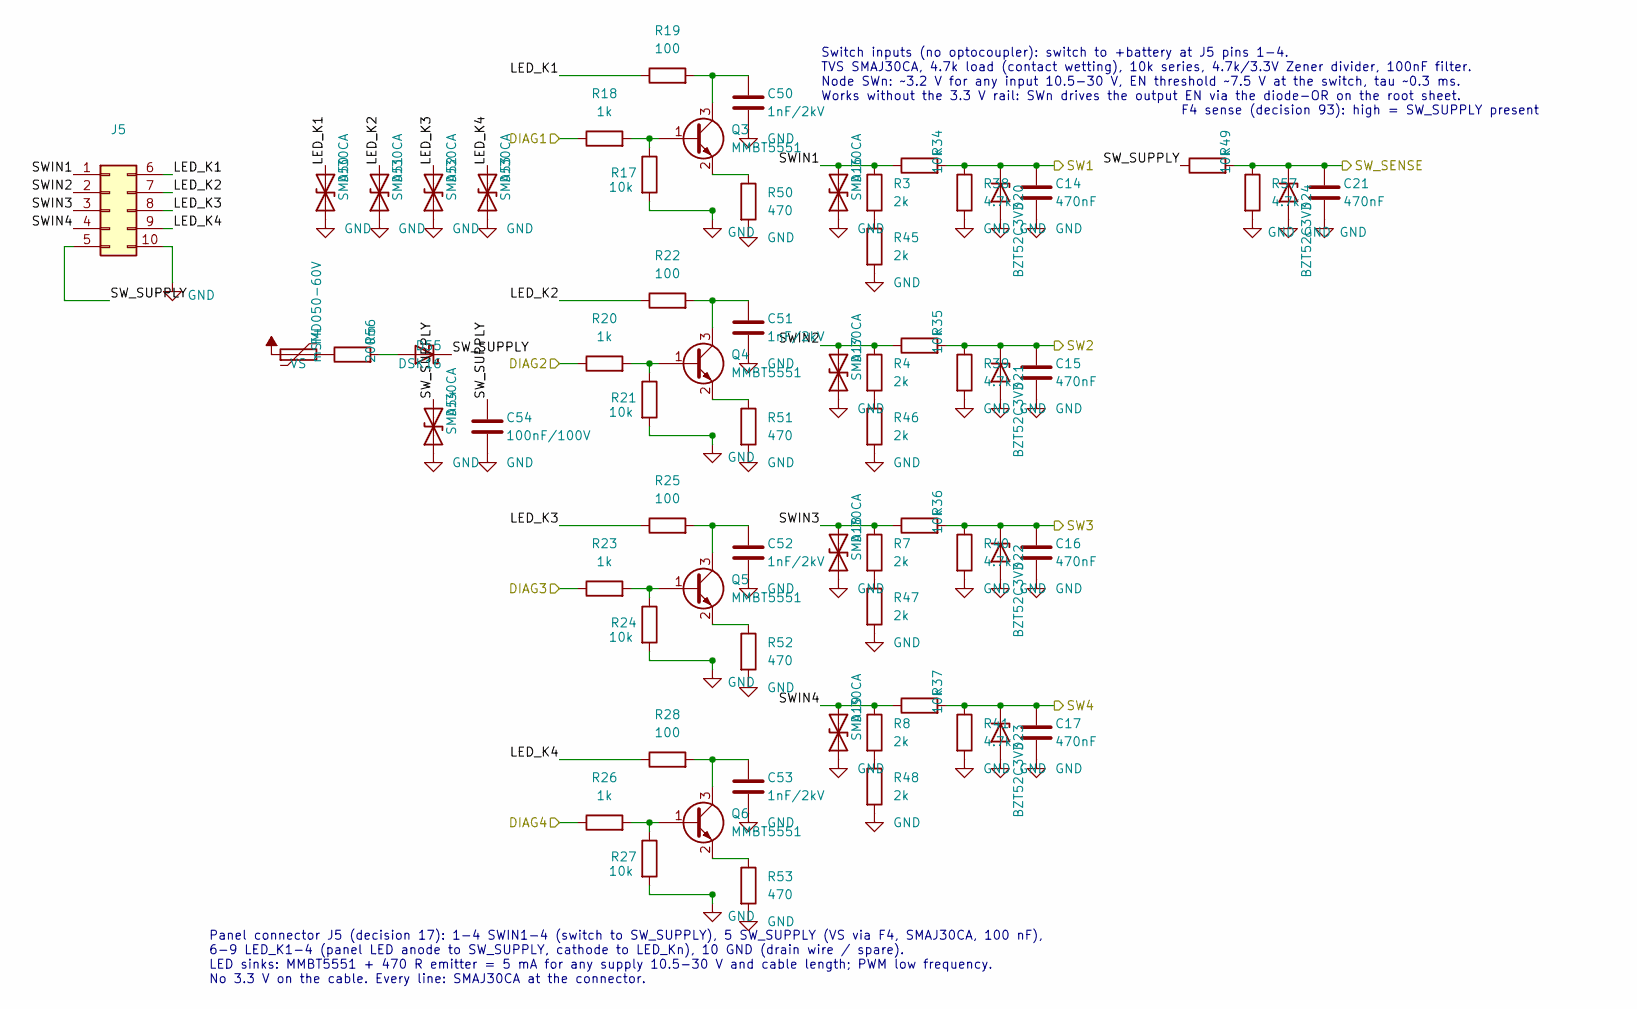
[picture p4: schematic analog_sw.kicad_sch]

Parts:
C14, C15, C16, C17, C21: 470nF; C_0402_1005Metric; LCSC C47339
C50, C51, C52, C53: 1nF/2kV; C_1206_3216Metric; LCSC C9196
C54: 100nF/100V; C_0805_2012Metric; LCSC C28233
D16, D17, D18, D19, D50, D51, D52, D53, D54: SMAJ30CA; D_SMA; LCSC C19077548
D20, D21, D22, D23, D24: BZT52C3V3; D_SOD-123; LCSC C19077396
D55: DSK16; D_SOD-123F; LCSC C22466351
F4: mSMD050-60V; Fuse_1812_4532Metric; LCSC C70113
J5: WJ15EDGRC-3.81-10P; Kangnex_WJ15EDGRC-3.81-10P; LCSC C26895
Q3, Q4, Q5, Q6: MMBT5551; SOT-23-3; LCSC C2145
R3, R4, R7, R8, R45, R46, R47, R48: 2k; R_1206_3216Metric; LCSC C17944
R17, R21, R24, R27: 10k; R_0402_1005Metric; LCSC C25744
R18, R20, R23, R26: 1k; R_0402_1005Metric; LCSC C11702
R19, R22, R25, R28: 100; R_0402_1005Metric; LCSC C25076
R34, R35, R36, R37, R49: 10k; R_1206_3216Metric; LCSC C17902
R38, R39, R40, R41, R57: 4.7k; R_0402_1005Metric; LCSC C25900
R50, R51, R52, R53: 470; R_0402_1005Metric; LCSC C25117
R56: 200m; R_2512_6332Metric; LCSC C7420022

Connections:
/Analog interface/LED_K1: D50.2 (A2), J5.6, R19.1
/Analog interface/LED_K2: D51.2 (A2), J5.7, R22.1
/Analog interface/LED_K3: D52.2 (A2), J5.8, R25.1
/Analog interface/LED_K4: D53.2 (A2), J5.9, R28.1
/Analog interface/SWIN1: D16.2 (A2), J5.1, R3.1, R34.1
/Analog interface/SWIN2: D17.2 (A2), J5.2, R4.1, R35.1
/Analog interface/SWIN3: D18.2 (A2), J5.3, R7.1, R36.1
/Analog interface/SWIN4: D19.2 (A2), J5.4, R8.1, R37.1
/Analog interface/SW_SUPPLY: C54.1, D54.2 (A2), D55.1 (K), J5.5, R49.1
/IO38: R18.1; also elsewhere on the board
/IO39: R20.1; also elsewhere on the board
/IO40: R23.1; also elsewhere on the board
/IO41: R26.1; also elsewhere on the board
/SW1: C14.1, D20.1 (K), R34.2, R38.1; also elsewhere on the board
/SW2: C15.1, D21.1 (K), R35.2, R39.1; also elsewhere on the board
/SW3: C16.1, D22.1 (K), R36.2, R40.1; also elsewhere on the board
/SW4: C17.1, D23.1 (K), R37.2, R41.1; also elsewhere on the board
/SW_SENSE: C21.1, D24.1 (K), R49.2, R57.1; also elsewhere on the board
GND: C14.2, C15.2, C16.2, C17.2, C21.2, C50.2, C51.2, C52.2, C53.2, C54.2, D16.1 (A1), D17.1 (A1), D18.1 (A1), D19.1 (A1), D20.2 (A), D21.2 (A), D22.2 (A), D23.2 (A), D24.2 (A), D50.1 (A1), D51.1 (A1), D52.1 (A1), D53.1 (A1), D54.1 (A1), J5.10, R17.2, R21.2, R24.2, R27.2, R38.2, R39.2, R40.2, R41.2, R45.2, R46.2, R47.2, R48.2, R50.2, R51.2, R52.2, R53.2, R57.2; also elsewhere on the board
unnamed: D55.2 (A), R56.2
unnamed: F4.2, R56.1
unnamed: Q3.1 (B), R17.1, R18.2
unnamed: C50.1, Q3.3 (C), R19.2
unnamed: Q3.2 (E), R50.1
unnamed: Q4.1 (B), R20.2, R21.1
unnamed: C51.1, Q4.3 (C), R22.2
unnamed: Q4.2 (E), R51.1
unnamed: Q5.1 (B), R23.2, R24.1
unnamed: C52.1, Q5.3 (C), R25.2
unnamed: Q5.2 (E), R52.1
unnamed: Q6.1 (B), R26.2, R27.1
unnamed: C53.1, Q6.3 (C), R28.2
unnamed: Q6.2 (E), R53.1
unnamed: R3.2, R45.1
unnamed: R4.2, R46.1
unnamed: R7.2, R47.1
unnamed: R8.2, R48.1
VS: F4.1; also elsewhere on the board

Notes on the sheet:
Switch inputs (no optocoupler): switch to +battery at J5 pins 1-4. TVS SMAJ30CA, 4.7k load (contact wetting), 10k series, 4.7k/3.3V Zener divider, 100nF filter. Node SWn: ~3.2 V for any input 10.5-30 V, EN threshold ~7.5 V at the switch, tau ~0.3 ms. Works without the 3.3 V rail: SWn drives the out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
Panel connector J5 (decision 17): 1-4 SWIN1-4 (switch to SW_SUPPLY), 5 SW_SUPPLY (VS via F4, SMAJ30CA, 100 nF), 6-9 LED_K1-4 (panel LED anode to SW_SUPPLY, cathode to LED_Kn), 10 GND (drain wire / spare). LED sinks: MMBT5551 + 470 R emitter = 5 mA for any supply 10.5-30 V and cable length; PWM low 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
F4 sense (decision 93): high = SW_SUPPLY present

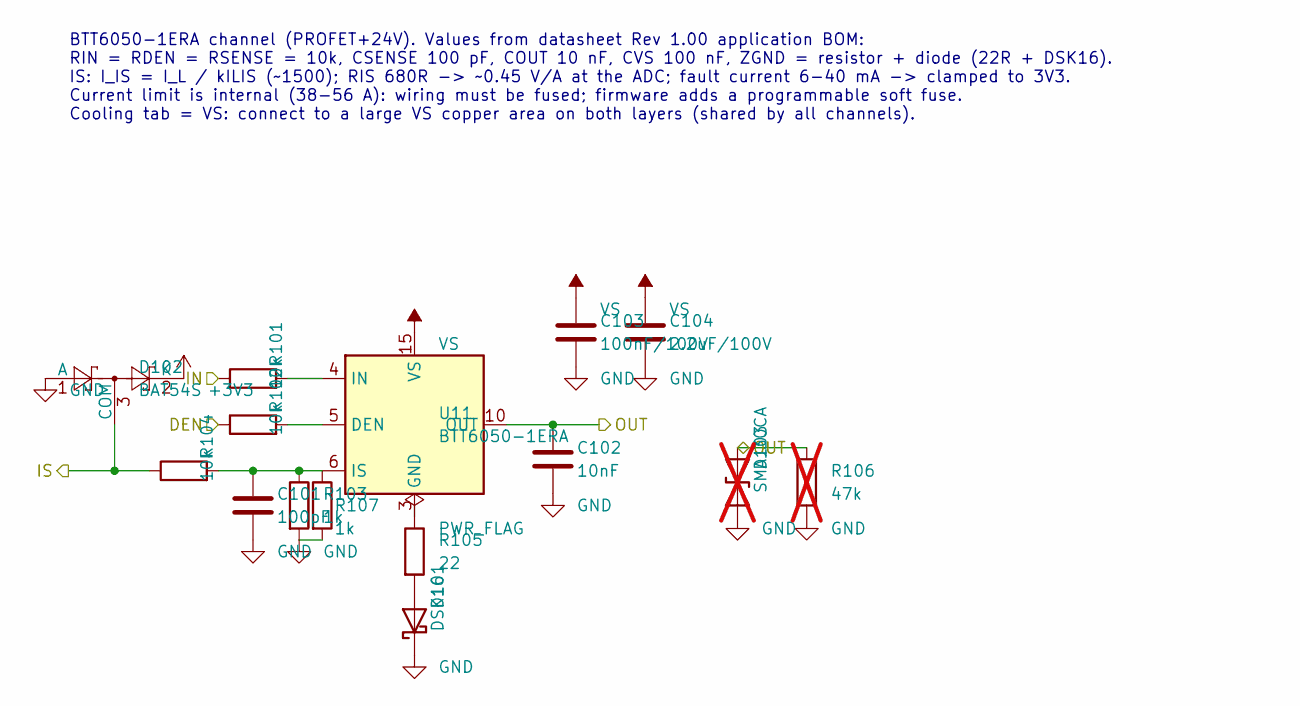
[picture p5: schematic channel.kicad_sch]

Parts:
C101: 100pF; C_0402_1005Metric; LCSC C1546
C102: 10nF; C_0402_1005Metric; LCSC C15195
C103: 100nF/100V; C_0805_2012Metric; LCSC C28233
C104: 2.2uF/100V; C_1206_3216Metric; MPN Samsung CL31B225KCHSNNE; LCSC C170101
D101: DSK16; D_SOD-123F; LCSC C22466351
D102: BAT54S; SOT-23; LCSC C7420333
D103: SMAJ30CA; D_SMA; LCSC C19077548; not fitted
R101, R102, R104: 10k; R_0402_1005Metric; LCSC C25744
R103, R107: 1k; R_1206_3216Metric; LCSC C4410
R105: 22; R_0402_1005Metric; LCSC C25092
R106: 47k; R_0603_1608Metric; LCSC C25819; not fitted
U11: BTT6050-1ERA; Infineon_PG-TDSO-14_ThermalVias; LCSC C534868

Connections:
+3V3: D102.2 (K); also elsewhere on the board
/DEN: R102.1; also elsewhere on the board
/IO2: D102.3 (COM), R104.1; also elsewhere on the board
/OUT1: C102.1, D103.2 (A2), R106.1, U11.10 (OUT), U11.11 (OUT), U11.12 (OUT); also elsewhere on the board
/SW_IN1: R101.1; also elsewhere on the board
GND: C101.2, C102.2, C103.2, C104.2, D101.1 (K), D102.1 (A), D103.1 (A1), R103.2, R106.2, R107.2; also elsewhere on the board
unnamed: D101.2 (A), R105.2
unnamed: R102.2, U11.5 (DEN)
unnamed: R105.1, U11.3 (GND)
unnamed: R101.2, U11.4 (IN)
unnamed: C101.1, R103.1, R104.2, R107.1, U11.6 (IS)
VS: C103.1, C104.1, U11.15 (VS); also elsewhere on the board

Parts of its further copies:
C201, C301, C401: 100pF; C_0402_1005Metric; LCSC C1546
C202, C302, C402: 10nF; C_0402_1005Metric; LCSC C15195
C203, C303, C403: 100nF/100V; C_0805_2012Metric; LCSC C28233
C204, C304, C404: 2.2uF/100V; C_1206_3216Metric; MPN Samsung CL31B225KCHSNNE; LCSC C170101
D201, D301, D401: DSK16; D_SOD-123F; LCSC C22466351
D202, D302, D402: BAT54S; SOT-23; LCSC C7420333
D203, D303, D403: SMAJ30CA; D_SMA; LCSC C19077548; not fitted
R201, R202, R204, R301, R302, R304, R401, R402, R404: 10k; R_0402_1005Metric; LCSC C25744
R203, R207, R303, R307, R403, R407: 1k; R_1206_3216Metric; LCSC C4410
R205, R305, R405: 22; R_0402_1005Metric; LCSC C25092
R206, R306, R406: 47k; R_0603_1608Metric; LCSC C25819; not fitted
U12, U13, U14: BTT6050-1ERA; Infineon_PG-TDSO-14_ThermalVias; LCSC C534868

Connections of its further copies:
+3V3: D202.2 (K), D302.2 (K), D402.2 (K); also elsewhere on the board
/DEN: R202.1, R302.1, R402.1; also elsewhere on the board
/IO3: D202.3 (COM), R204.1; also elsewhere on the board
/IO4: D302.3 (COM), R304.1; also elsewhere on the board
/IO5: D402.3 (COM), R404.1; also elsewhere on the board
/OUT2: C202.1, D203.2 (A2), R206.1, U12.10 (OUT), U12.11 (OUT), U12.12 (OUT); also elsewhere on the board
/OUT3: C302.1, D303.2 (A2), R306.1, U13.10 (OUT), U13.11 (OUT), U13.12 (OUT); also elsewhere on the board
/OUT4: C402.1, D403.2 (A2), R406.1, U14.10 (OUT), U14.11 (OUT), U14.12 (OUT); also elsewhere on the board
/SW_IN2: R201.1; also elsewhere on the board
/SW_IN3: R301.1; also elsewhere on the board
/SW_IN4: R401.1; also elsewhere on the board
GND: C201.2, C202.2, C203.2, C204.2, C301.2, C302.2, C303.2, C304.2, C401.2, C402.2, C403.2, C404.2, D201.1 (K), D202.1 (A), D203.1 (A1), D301.1 (K), D302.1 (A), D303.1 (A1), D401.1 (K), D402.1 (A), D403.1 (A1), R203.2, R206.2, R207.2, R303.2, R306.2, R307.2, R403.2, R406.2, R407.2; also elsewhere on the board
unnamed: D201.2 (A), R205.2
unnamed: D301.2 (A), R305.2
unnamed: D401.2 (A), R405.2
unnamed: R202.2, U12.5 (DEN)
unnamed: R205.1, U12.3 (GND)
unnamed: R201.2, U12.4 (IN)
unnamed: C201.1, R203.1, R204.2, R207.1, U12.6 (IS)
unnamed: R302.2, U13.5 (DEN)
unnamed: R305.1, U13.3 (GND)
unnamed: R301.2, U13.4 (IN)
unnamed: C301.1, R303.1, R304.2, R307.1, U13.6 (IS)
unnamed: R402.2, U14.5 (DEN)
unnamed: R405.1, U14.3 (GND)
unnamed: R401.2, U14.4 (IN)
unnamed: C401.1, R403.1, R404.2, R407.1, U14.6 (IS)
VS: C203.1, C204.1, C303.1, C304.1, C403.1, C404.1, U12.15 (VS), U13.15 (VS), U14.15 (VS); also elsewhere on the board

Notes on the sheet:
BTT6050-1ERA channel (PROFET+24V). Values from datasheet Rev 1.00 application BOM: RIN = RDEN = RSENSE = 10k, CSENSE 100 pF, COUT 10 nF, CVS 100 nF, ZGND = resistor + diode (22R + DSK16). IS: I_IS = I_L / kILIS (~1500); RIS 680R -> ~0.45 V/A at the ADC; fault current 6-40 mA -> clamped to 3V3. Curr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
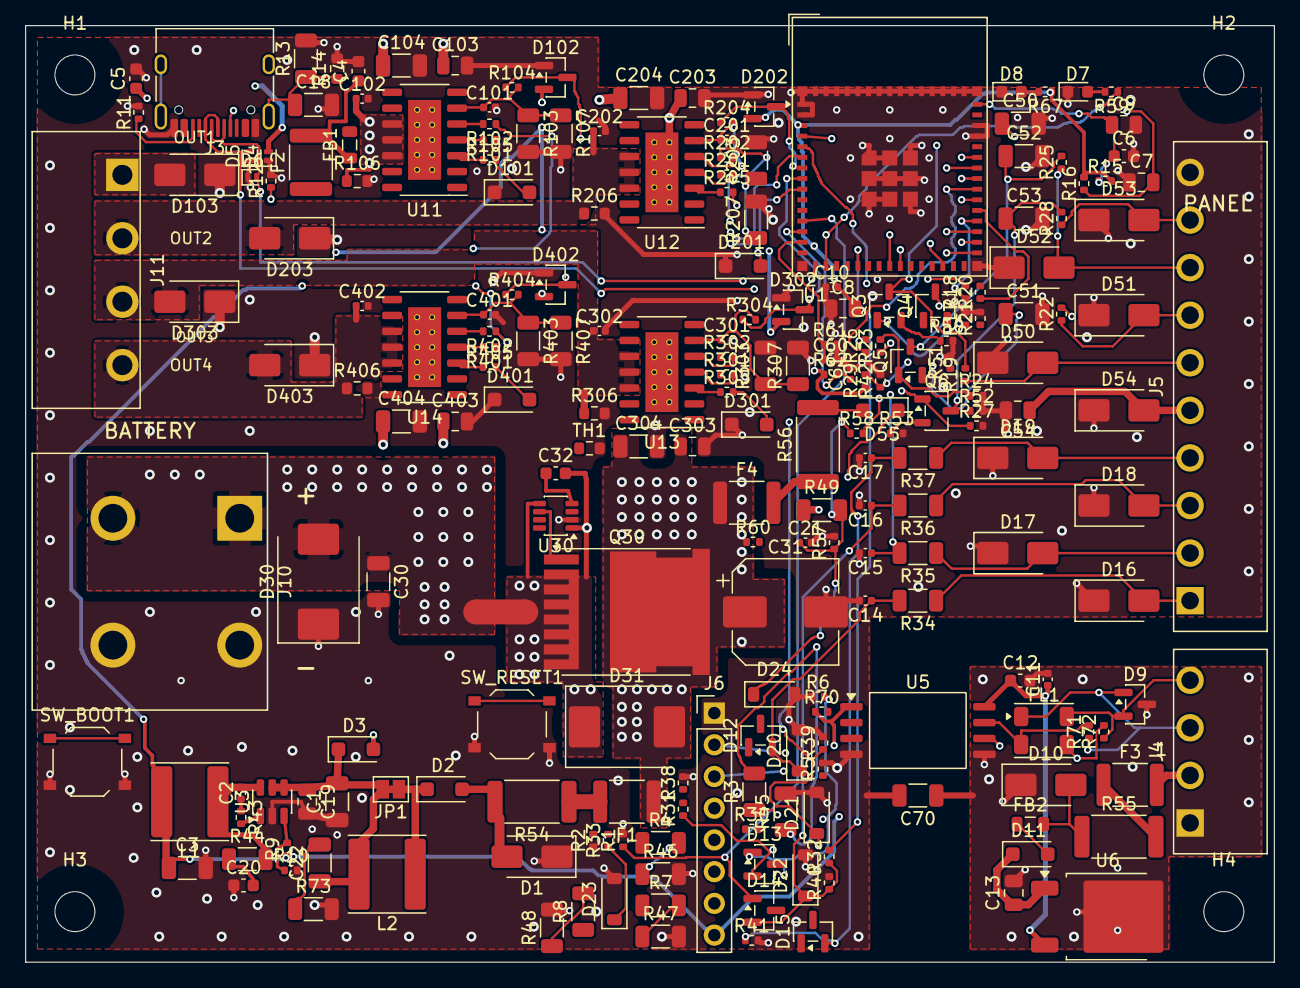
[picture p6: board ESP32-PDM-4CH.kicad_pcb from above]

Board: 4 copper layers, 100.0 x 75.0 mm, 226 parts (0 on the bottom side), 130 nets.

Other parts of the board:
C22: 2.2uF/100V; C_1206_3216Metric
JP1: BRIDGE copper (no part), bypasses L2; SolderJumper-2_P1.3mm_Bridged_Pad1.0x1.5mm
L2: SWPA6045S8R2MT; L_Sunlord_SWPA6045S
R73: 10; R_1206_3216Metric

Their connections:
GND: R73.2; also elsewhere on the board
unnamed: C22.2, R73.1
