plektra/ESP32-PDM/(commit log)

2026-10-30 Single-board 4-channel ESP32-PDM with BTT6050 outputs
    Merge the former base board and 4x4 output module into one board:
    - controller, power, CAN and panel-input sheets from ESP32-PDM-base
    (schematic-fixes, c35b031/b420fd2), board-to-board header removed
    - new channel sheet (x4): Infineon BTT6050-1ERA with the datasheet
    application circuit (10k on IN/DEN/IS, 680R sense, BAT54S clamp,
    22R + DSK16 ground network, COUT 10 nF, CVS 100 nF/100 V)
    - battery input terminal with SMCJ30CA, output terminal, DEN on IO33,
    board variant ID resistor on IO1
    - shared library: BTT6050-1ERA symbol and PG-TDSO-14 footprint drawn
    from the datasheet outline (verify against JLCPCB footprint)
    - docs/design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
2026-10-30 Per-channel switch options (BTT6050/BTT6010), mixed-load heat model
2026-10-30 Note bilge pump current and relay plan in open items
2026-10-30 Plan high-current board (TPS48111-Q1 + MOSFETs) instead of relays
2026-10-30 Add SEAFLO 3500 GPH bilge pump data to design notes
2026-10-30 Add 2-channel high-current board (TPS48110A-Q1 + MOSFETs)
    - hardware/pdm-hc2: controller/power/CAN/input sheets shared with pdm-4ch,
    two hc_channel sheets: TPS48110AQDGXRQ1, back-to-back BSC030N08NS5,
    1 mR shunt, overcurrent 25 A / 146 ms, short circuit 80 A, IMON gain 108,
    UVLO 9.7 V / OV 34.5 V, MMBT3904 temperature sensor, SS510B freewheel.
    Values from TI TPS4811-Q1 datasheet SLUSEE5E equations.
    - Inputs 1-2 drive the channels in hardware; inputs 3-4 sense-only.
    IMON on IO2/IO3, FLT_I/FLT_T on IO34-IO37, variant ID 4.7k.
    - lib: TPS48110A-Q1 and BSC030N08NS5 symbols, TI DGX0019A footprint drawn
    from the datasheet land pattern.
    - Heat model: HC channel entry; ~15 A per channel c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
2026-10-30 System: session roles, decision log, status files and handoff
    - CLAUDE.md, docs/WORKING-WITH-CLAUDE.md: roles (board designer, architect,
    validator, cost controller, EMC reviewer, helpers) and the session loop
    - .claude/commands: /board /system /handoff /progress /validate /cost /emc
    - .claude/agents: architect, validator, cost-controller, emc-reviewer,
    part-facts, stock-check
    - docs/decisions.md (decisions 1-19), docs/ARCHITECTURE.md (shared sheets,
    pin map, invariants, budgets), docs/CONTINUE-FROM-HERE.md (order of work)
    - hardware/pdm-4ch/STATUS.md, hardware/pdm-hc2/STATUS.md
    - tools/ksch.py: schematic editing helper used for the scripted edits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
2026-10-30 System: unattended reviewer pilot – policy, queue, inbox, orchestrator (decision 20)
2026-10-30 System: panel cable and pin map – fused switch supply, MMBT5551 LED sinks, VBAT and NTC (decisions 17-21)
2026-11-01 Unattended runs in tmux: stream agent output to a live log, tools/agents-tmux.sh
    orchestrate.py runs agents with stream-json and writes a readable trace per task and to
    .claude/worktrees/auto-logs/live.log; agents-tmux.sh opens orchestrator, status and live
    trace panes plus an inbox window.
2026-11-01 Agent views: dashboard, readable traces, attach to agent sessions
    orchestrate.py watch: progress, run budget, running agents with current step and findings,
    finished results, inbox. follow [task]: narration and findings, tool calls folded. attach
    <task>: resume the agent's session (a fork while it runs). Agents narrate their checks and
    mark FINDING lines; tool calls show the agent's own step description. Sessions are now saved
    and their ids recorded in the queue. agents-tmux.sh uses watch and follow.
2026-11-01 System: autonomy by one-way/two-way doors (decision 23)
    Replaces the small/big rule of decision 22. One-way doors (money, the owner's decisions,
    weakening safety or invariants, facts only the owner has, CRITICAL findings, ordered boards)
    go to the owner; everything else is decided by agents, listed in an inbox digest and undoable
    with orchestrate.py undo. Questions with a sensible default are answered with it. Reviewers
    mark door and default; the orchestrator enforces the one-way rules, reading the owner's
    decisions from decisions.md. Inbox rewrites keep answers typed but not yet applied.
2026-11-01 System: unattended fixes – planner, board-fixer and design gates (decision 24)
    Approved items (owner rulings, two-way decisions) are applied without the owner: a planner
    groups them into work packages and drafts decision rows for the owner's rulings; board-fixer
    agents edit the schematics in their own worktrees; orchestrate.py gates every change (scope,
    no PDFs, ERC not worse, netlist changes only on declared refs, LCSC or DNP, shared sheets
    equal on both boards) before merging it into auto/pilot, then a validator re-checks the
    board. One board-fixer per board at a time; undo reverts an applied package; run --no-fixes
    for reviews only; --rounds bounds fix/re-check cycles.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
2026-11-01 tools/orchestrate.py: robust trace parsing; a reader failure kills the agent instead of orphaning it
    A system event with a plain-string message crashed describe(), which killed the reader thread
    and left the board-fixer agent running unchecked (T-0064). describe() now accepts any event
    shape, trace errors never stop a run, and any other failure kills the agent process.
2026-11-01 Auto: board-fixer shared (T-0065): failed
    Unattended run by tools/orchestrate.py, model opus, 2.04 USD.
2026-11-01 tools/orchestrate.py: requeue interrupted agents; timeout timer never blocks exit
    An agent cut off mid-run (terminal reason aborted_streaming, T-0065) is queued again up to 3
    attempts instead of failing. The per-agent timeout timer is a daemon thread, so a crashed task
    can no longer keep the orchestrator alive for 90 minutes.
2026-11-01 tools/orchestrate.py: shared PDF venv for agents; scripts folder and naming hint
    Agents lost ~10 tool calls per package building their own pypdf venv (a script named
    inspect.py in the scratch folder shadowed the stdlib, rm -rf is denied). The orchestrator now
    builds ~/.cache/esp32-pdm/pdf-venv (pypdf, pypdfium2, Pillow) once and passes it as
    PDM_PDF_PYTHON; prompts say to use it and to keep scripts in $CLAUDE_JOB_DIR/scripts/.
2026-11-01 shared: Battery input bulk/HF caps and output surge protection (invariant 4) (T-0064)
    Unattended board-fixer, model opus, 4.12 USD; gates passed (ERC, netlist, LCSC, shared sheets).
2026-11-01 Auto: board-fixer shared (T-0064): 4 fixed, 0 blocked, merged dbc672cd
    Unattended run by tools/orchestrate.py, model opus, 4.12 USD.
2026-11-01 Auto: board-fixer shared (T-0065): paused, API unavailable
    Unattended run by tools/orchestrate.py, model opus, 3.76 USD.
2026-11-02 docs: backlog PWM outputs and stepless blower control
    Claude-Session: https://claude.ai/code/session_013YUXWKoJ1JLb42LRnT86mp
2026-11-02 Unattended runs: wait out usage limits, resume paused agents
    run --wait-for-limit reads the reset time from the limit message, sleeps until it (plus 2 min,
    30 min if unknown, at most 6 waits) and carries on. An agent paused by a limit or cut off keeps
    its worktree, scratch folder and session; its next attempt resumes the session (claude
    --resume) instead of starting over. Board-fixer gates take their before-check from the commit
    the agent started on (git archive), so a resumed worktree is gated correctly. Requeued tasks
    no longer count against --max-tasks.
2026-11-02 shared: Shared supply, USB and fuse parts (buck caps, USB shield/ESD, L3 swaps, PTC check) (T-0065)
    Unattended board-fixer, model opus, 6.34 USD; gates passed (ERC, netlist, LCSC, shared sheets).
2026-11-02 Auto: board-fixer shared (T-0065): 5 fixed, 1 blocked, merged e5fedd96
    Unattended run by tools/orchestrate.py, model opus, 6.34 USD.
2026-11-02 Unattended runs: clean Ctrl-C and orchestrate.py pause
    Ctrl-C sets a stop flag before the workers book their cut-off agents: they are kept for
    resuming without using up an attempt, the run is marked 'stopped by Ctrl-C' and exits
    without a traceback. orchestrate.py pause (from any terminal, only while a run is active)
    lets running agents finish and be merged, starts nothing new, then stops; --cancel takes it
    back.
2026-11-02 shared: Custom footprints in lib/ (TDSO-14 paste, LMR51610 -> SOT-23-6) (T-0066)
    Unattended board-fixer, model opus, 1.58 USD; gates passed (ERC, netlist, LCSC, shared sheets).
2026-11-02 Auto: board-fixer shared (T-0066): 2 fixed, 0 blocked, merged 14b42e65
    Unattended run by tools/orchestrate.py, model opus, 1.58 USD.
2026-11-02 Auto: board-fixer shared (T-0067): interrupted, queued again
    Unattended run by tools/orchestrate.py, model opus, 1.69 USD.
2026-11-02 Visibility and restraint: generated roadmap, board growth, scoped re-checks, run guide
    - docs/ROADMAP.md is regenerated with the queue: dependency diagram (Mermaid), every upcoming
    package with its items and the owner's rulings, done packages with their board growth,
    board size since the agents started, questions and deferred items.
    - The gates measure parts, DNP and unique fitted parts per board for every package; the
    dashboard shows board size and the next packages.
    - Restraint rules: board-fixers make the smallest change (value before part, BOM part before
    new part, nothing extra), the planner plans only what items ask, reviewers report only
    findings with a concrete failure mech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
2026-11-02 Auto: board-fixer shared (T-0067): interrupted, queued again, resumes where it stopped
    Unattended run by tools/orchestrate.py, model opus, 0.88 USD.
2026-11-02 Token savings: part-facts cache and Sonnet lookups, schematic query and gate-check tools, Sonnet fixer trial
    Most agent cost is re-reading the growing conversation each turn. Datasheets now go through
    tools/part_facts.py: cached facts in docs/part-facts/ (text with citations, no PDFs), else a
    Sonnet part-facts agent reads the datasheet in its own session (capped, cost counted in the
    task and run budget). tools/sch_query.py answers schematic questions in one call;
    tools/fix_check.py runs the orchestrator's merge gates for the fixer before it hands in.
    run --fixer-model sonnet for trials; the roadmap shows model and cost per package. First
    cached part: SMAJ33CA (C19077549), 0.15 USD.
    Co-Autho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
2026-11-02 pdm-4ch: Channel sense resistor, DEN rule, population rule (T-0069)
    Unattended board-fixer, model sonnet, 0.62 USD; gates passed (ERC, netlist, LCSC, shared sheets).
2026-11-02 Auto: board-fixer pdm-4ch (T-0069): 4 fixed, 0 blocked, merged b9fcef31; pdm-4ch +4 parts (+4 DNP), +0 unique
    Unattended run by tools/orchestrate.py, model sonnet, 0.62 USD.
2026-11-02 Auto: board-fixer shared (T-0067): failed
    Unattended run by tools/orchestrate.py, model opus, 4.17 USD.
2026-11-02 shared: CAN sheet: barrier Y-cap/CMC footprints, TXD pull-up, CA-IS3050G check (T-0067)
    Unattended board-fixer, model opus, 4.17 USD; gates passed (ERC, netlist, LCSC, shared sheets).
2026-11-02 shared: Panel interface (analog_sw): debounce, switch-load resistors, SW_SUPPLY diode, margins, reverse notes (T-0068)
    Unattended board-fixer, model opus, 2.66 USD; gates passed (ERC, netlist, LCSC, shared sheets).
2026-11-02 Auto: board-fixer shared (T-0068): 5 fixed, 1 blocked, merged 86fbfe03; pdm-4ch +1 parts (+0 DNP), +1 unique, pdm-hc2 +1 parts (+0 DNP), +1 unique
    Unattended run by tools/orchestrate.py, model opus, 2.66 USD.
2026-11-02 pdm-hc2: HC2 gate slew control (inrush, EMC edges) (T-0070)
    Unattended board-fixer, model opus, 1.65 USD; gates passed (ERC, netlist, LCSC, shared sheets).
2026-11-02 Auto: board-fixer pdm-hc2 (T-0070): 1 fixed, 3 blocked, merged 9d0b6d53; no part changes
    Unattended run by tools/orchestrate.py, model opus, 1.65 USD.
2026-11-02 Auto: board-fixer pdm-hc2 (T-0071): paused, API unavailable, resumes where it stopped
    Unattended run by tools/orchestrate.py, model opus, 1.64 USD.
2026-11-03 pdm-hc2: HC2 controller pin filtering (VS RC, CS/EN/OV/IWRN filters, DIODE 1 nF) (T-0071)
    Unattended board-fixer, model opus, 3.49 USD; gates passed (ERC, netlist, LCSC, shared sheets).
2026-11-03 Auto: board-fixer pdm-hc2 (T-0071): 3 fixed, 0 blocked, merged 80bb3bd1; pdm-hc2 +16 parts (+4 DNP), +0 unique
    Unattended run by tools/orchestrate.py, model opus, 3.49 USD.
2026-11-03 Auto: board-fixer shared (T-0072): interrupted, queued again, resumes where it stopped
    Unattended run by tools/orchestrate.py, model opus, 1.93 USD.
2026-11-03 Auto: board-fixer shared (T-0067): 5 fixed, 0 blocked, merged 5ffcfb6f (merge hand-resolved)
2026-11-03 Auto: board-fixer shared (T-0072): failed
    Unattended run by tools/orchestrate.py, model opus, 2.07 USD.
2026-11-03 shared: HC2 breaker level, float-run OUT divider, reverse-battery documentation (T-0072)
    Unattended board-fixer, model opus, 2.07 USD; gates passed (ERC, netlist, LCSC, shared sheets).
2026-11-03 shared: BOM LCSC codes and controller notes (VBAT full scale, IO3 strap) (T-0073)
    Unattended board-fixer, model opus, 1.13 USD; gates passed (ERC, netlist, LCSC, shared sheets).
2026-11-03 Auto: board-fixer shared (T-0073): 6 fixed, 0 blocked, merged 1939dfbc; pdm-4ch +0 parts (+0 DNP), -4 unique, pdm-hc2 +0 parts (+0 DNP), -5 unique
    Unattended run by tools/orchestrate.py, model opus, 1.13 USD.
2026-11-03 Union merge for board STATUS files
    Parallel board-fixer packages append paragraphs at the same spots in
    hardware/*/STATUS.md, which made the orchestrator's merge fail (T-0067,
    T-0072). Git now keeps both sides.
2026-11-03 Auto: board-fixer shared (T-0072): 4 fixed, 1 blocked, merged 901c6f45 (merge hand-resolved)
2026-11-03 Auto: inbox after landing T-0072
2026-11-03 Owner: withdraw the searchlight (decisions 16 and 19)
    The owner withdrew the searchlight from the project. Decisions 16 (heating)
    and 19 (21 A MOSFET option, halogen inrush) are marked withdrawn; the
    searchlight is removed from design-notes, CONTINUE-FROM-HERE, the HC2
    STATUS, the reviews and the queue. Two halogen-load notes on the hc_channel
    sheet removed (text only: netlist identical, ERC 5 -> 5).
    Inbox: Q-0052 yes; Q-0053 answered (21 A option dropped).
2026-11-03 shared: U5 CA-IS3050G: TXD/RXD pin numbers 2/3 swapped (both boards) (T-0078)
    Unattended board-fixer, model opus, 0.51 USD; gates passed (ERC, netlist, LCSC, shared sheets).
2026-11-03 Auto: board-fixer shared (T-0078): 1 fixed, 0 blocked, merged d42065e2; no part changes
    Unattended run by tools/orchestrate.py, model opus, 0.51 USD.
2026-11-03 Unattended runs: self-repair instead of failing
    A hand-in the agent can fix itself (missing or malformed block, wrong report
    path, failed gate) goes back to its own session with the exact problem, up to
    2 repairs, before the task fails. Agents check their report with the new
    tools/report_check.py before handing in. Board-fixer changes are pre-merged
    with the newest auto/pilot outside the lock; Markdown-only conflicts are
    resolved by the agent, other conflicts re-queue the package for a rebuild.
    Rejected reviewer reports are kept as -rejected.md; failures notify at once.
2026-11-03 Unattended runs: system sync packages (decision 71)
    Board-fixers with scope `sync` bring docs/ARCHITECTURE.md (never its
    Invariants section), design-notes, the boards' STATUS.md and
    tools/heat_budget.py inputs in line with what is already merged and decided.
    Once fixes settle, the orchestrator sweeps the "For /system" lists whenever
    they changed: bookkeeping is synced, choices stay for an interactive /system
    session. Gates: those files only, netlists unchanged, invariants word for
    word, the heat budget tool still runs.
2026-11-03 sync: HC2 heat-budget RDS(on) at 150 C per BSC030N08NS5 Diagram 9 (T-0082)
    Unattended board-fixer, model opus, 0.24 USD; gates passed (ERC, netlist, LCSC, shared sheets).
2026-11-03 Auto: board-fixer sync (T-0082): 0 fixed, 0 blocked, merged 24bf9f3b; no part changes
    Unattended run by tools/orchestrate.py, model opus, 0.24 USD.
2026-11-03 sync: HC2 heat-budget RDS(on) at 150 C - verify T-0082 sync and close (T-0084)
    Unattended board-fixer, model opus, 0.15 USD; gates passed (ERC, netlist, LCSC, shared sheets).
2026-11-03 Auto: board-fixer sync (T-0084): 0 fixed, 0 blocked, merged 0a052c20; no part changes
    Unattended run by tools/orchestrate.py, model opus, 0.15 USD.
2026-11-03 sync: Sync the "For /system" lists (T-0085)
    Unattended board-fixer, model opus, 0.71 USD; gates passed (ERC, netlist, LCSC, shared sheets).
2026-11-03 Auto: board-fixer sync (T-0085): 5 synced, 12 left for /system, merged 78c1506a
    Unattended run by tools/orchestrate.py, model opus, 0.71 USD.
2026-11-03 Orchestrator: cost and EMC re-checks after fix rounds
    After all design packages of a plan, a cost controller and an EMC reviewer
    re-check the diff since the plan, like the per-board validator re-checks.
    They run only when needed, judged from the packages' declared refs (now
    recorded on each package): cost when any part changed, EMC when a
    connector, ferrite, inductor, diode/TVS, fuse or switch changed. Otherwise
    they are closed as skipped without starting an agent.
2026-11-03 shared: PTC interrupt rating: F1/F3/F4 100 A PTC + series resistor, then the F2 swap (T-0104)
    Unattended board-fixer, model opus, 1.91 USD; gates passed (ERC, netlist, LCSC, shared sheets).
2026-11-03 Auto: board-fixer shared (T-0104): 0 fixed, 1 blocked, merged 8981e0b5; no part changes
    Unattended run by tools/orchestrate.py, model opus, 3.21 USD.
2026-11-03 shared: Panel switch loads R3/R4/R7/R8 -> 2 k + 2 k basic (T-0105)
    Unattended board-fixer, model opus, 1.34 USD; gates passed (ERC, netlist, LCSC, shared sheets).
2026-11-03 Auto: board-fixer shared (T-0105): 1 fixed, 0 blocked, merged 849fc1d6; pdm-4ch +4 parts (+0 DNP), +0 unique, pdm-hc2 +4 parts (+0 DNP), +0 unique
    Unattended run by tools/orchestrate.py, model opus, 1.49 USD.
2026-11-03 pdm-hc2: Short EMC gate slew, maximum load capacitance, HC2 load guidance (T-0106)
    Unattended board-fixer, model opus, 2.82 USD; gates passed (ERC, netlist, LCSC, shared sheets).
2026-11-03 Auto: board-fixer pdm-hc2 (T-0106): 4 fixed, 0 blocked, merged c036d2a6; pdm-hc2 +6 parts (+0 DNP), +0 unique
    Unattended run by tools/orchestrate.py, model opus, 3.28 USD.
2026-11-03 Auto: board-fixer shared (T-0107): paused, API unavailable, resumes where it stopped
    Unattended run by tools/orchestrate.py, model opus, 0.54 USD.
2026-11-03 shared: Extended-part fee levers: C18 -> C9196, RIS -> 2 x C4410, 1 uF/100 V -> C170101 (T-0107)
    Unattended board-fixer, model opus, 1.97 USD; gates passed (ERC, netlist, LCSC, shared sheets).
2026-11-03 Auto: board-fixer shared (T-0107): 1 fixed, 3 blocked, merged d6c2bb6e; pdm-4ch +4 parts (+0 DNP), +0 unique, pdm-hc2 +0 parts (+0 DNP), -1 unique
    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
2026-11-03 shared: README installation guidance (text only) (T-0108)
    Unattended board-fixer, model opus, 0.25 USD; gates passed (ERC, netlist, LCSC, shared sheets).
2026-11-03 Auto: board-fixer shared (T-0108): 1 fixed, 0 blocked, merged c9bce1a7; no part changes
    Unattended run by tools/orchestrate.py, model opus, 0.25 USD.
2026-11-03 shared: PTC interrupt rating: C70113 on F1-F4 plus 0.2 ohm series resistor on F1/F3/F4 (T-0118)
    Unattended board-fixer, model opus, 1.81 USD; gates passed (ERC, netlist, LCSC, shared sheets).
2026-11-03 Auto: board-fixer shared (T-0118): 1 fixed, 0 blocked, merged 3b24acd6; pdm-4ch +3 parts (+0 DNP), +0 unique, pdm-hc2 +3 parts (+0 DNP), +0 unique
    Unattended run by tools/orchestrate.py, model opus, 1.81 USD.
2026-11-03 shared: USB shield capacitor C18 to 1 nF/2 kV C9196 (T-0119)
    Unattended board-fixer, model opus, 0.47 USD; gates passed (ERC, netlist, LCSC, shared sheets).
2026-11-03 Auto: board-fixer shared (T-0119): 2 fixed, 0 blocked, merged 196bdd9c; pdm-4ch +0 parts (+0 DNP), -1 unique, pdm-hc2 +0 parts (+0 DNP), -1 unique
    Unattended run by tools/orchestrate.py, model opus, 0.47 USD.
2026-11-03 pdm-4ch: pdm-4ch VS-tab capacitors C104-C404 to 2.2 uF/100 V C170101 (T-0120)
    Unattended board-fixer, model opus, 0.41 USD; gates passed (ERC, netlist, LCSC, shared sheets).
2026-11-03 Auto: board-fixer pdm-4ch (T-0120): 2 fixed, 0 blocked, merged 70cdd9cf; pdm-4ch +0 parts (+0 DNP), -1 unique
    Unattended run by tools/orchestrate.py, model opus, 0.41 USD.
2026-11-03 pdm-4ch: pdm-4ch reverse-battery blocking on VS in front of the bulk capacitor (T-0121)
    Unattended board-fixer, model opus, 3.13 USD; gates passed (ERC, netlist, LCSC, shared sheets).
2026-11-03 Auto: board-fixer pdm-4ch (T-0121): 1 fixed, 0 blocked, merged f1f3f88b; pdm-4ch +3 parts (+0 DNP), +2 unique
    Unattended run by tools/orchestrate.py, model opus, 4.44 USD.
2026-11-03 Auto: board-fixer pdm-4ch (T-0132): paused, API unavailable, resumes where it stopped
    Unattended run by tools/orchestrate.py, model opus, 1.16 USD.
2026-11-04 pdm-4ch: Q30 AGM601LL swap check (swap only if it passes) and design-notes 8.6 (b) avalanche correction (T-0132)
    Unattended board-fixer, model opus, 5.90 USD; gates passed (ERC, netlist, LCSC, shared sheets).
2026-11-04 Auto: board-fixer pdm-4ch (T-0132): 1 fixed, 1 blocked, merged 605f3305; no part changes
    Unattended run by tools/orchestrate.py, model opus, 5.90 USD.
2026-11-04 pdm-4ch: TVS across Q30 for negative transients with VS charged (T-0137)
    Unattended board-fixer, model opus, 2.51 USD; gates passed (ERC, netlist, LCSC, shared sheets).
2026-11-04 Auto: board-fixer pdm-4ch (T-0137): 0 fixed, 1 blocked, merged 3bf52fa6; no part changes
    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
2026-11-04 sync: Sync the "For /system" lists (T-0141)
    Unattended board-fixer, model opus, 0.80 USD; gates passed (ERC, netlist, LCSC, shared sheets).
2026-11-04 Auto: board-fixer sync (T-0141): 4 synced, 17 left for /system, merged 89be376e
    Unattended run by tools/orchestrate.py, model opus, 0.80 USD.
2026-11-04 System: digital SW_SUPPLY sense on IO12; HC2 one light per output
    Decision 93 replaces decision 21: the 100 k/10 k divider cannot work on
    IO12 (ADC2, invariant 10; reads low at 24 V as a digital input). Both
    boards get the switch-input network: R49, R57, D24, C21 on analog_sw and
    R58 on the root sheet. +5 parts, no new unique part. ERC unchanged, and
    the netlist differs only in those parts and U1 pad 16.
    Decision 94 amends decision 72: plan on one LED work light per HC2 output,
    about 50 uF per output, pre-charge only if the prototype shows it is
    needed. README, design-notes, ARCHITECTURE, both STATUS files and
    CONTINUE-FROM-HERE updated.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
2026-11-04 System: board input limits 32 A / 36 A (decision 95)
    J10, its GND pole and the supply copper are sized for the real maximums
    instead of about 40 A / 50 A. Documents only, no schematic change. Q30 is
    about 86 C at 32 A with the copper rule kept; the cheaper AGM601LL still
    fails at about 179 C, so that cost lever stays dropped.
2026-11-04 Auto: board-fixer pdm-4ch (T-0143): paused, API unavailable, resumes where it stopped
    Unattended run by tools/orchestrate.py, model opus, 0.31 USD.
2026-11-04 pdm-4ch: Fit SMDJ40CA across Q30, record the residual risk and the prototype check (T-0143)
    Unattended board-fixer, model opus, 1.63 USD; gates passed (ERC, netlist, LCSC, shared sheets).
2026-11-04 Auto: board-fixer pdm-4ch (T-0143): 1 fixed, 0 blocked, merged 9cda47c8; pdm-4ch +1 parts (+0 DNP), +1 unique
    Unattended run by tools/orchestrate.py, model opus, 1.63 USD.
2026-11-04 sync: Sync the "For /system" lists (T-0147)
    Unattended board-fixer, model opus, 0.76 USD; gates passed (ERC, netlist, LCSC, shared sheets).
2026-11-04 Auto: board-fixer sync (T-0147): 4 synced, 15 left for /system, merged f6f643aa
    Unattended run by tools/orchestrate.py, model opus, 0.76 USD.
2026-11-05 Mechanical: DIN carrier or printed enclosure, four M3 holes (decision 97)
    Amends decision 10. The bare board mounts edge-on on a plastic DIN carrier,
    about 36 mm of rail per unit, in an enclosure the installer provides, or in
    a 3D-printed enclosure on the same holes. The 1-module target is dropped;
    shared-enclosure rating is stated as air inside the box.
    H1/H2 had no footprint, so the PCB would have had no holes. H1-H4 are now
    four non-plated MountingHole_3.2mm_M3 on both boards. ERC unchanged; the
    netlist adds H3/H4 and the footprints only.
2026-11-05 System: keyed plugs on all connectors, five new footprints (decision 98)
    J4, J5, J10 and J11 become keyed plugs on right-angle sockets, hand-soldered,
    with LCSC and plug fields on both boards. HC2 outputs lock and use a different
    pitch from J10. Board depth about 65 mm (4-ch) and 75 mm (HC2). Fields only:
    no net changed, pads match pins, ERC unchanged. One sample of each set is
    checked before layout. Architecture review: no conflicts; its documentation
    updates are applied.
2026-11-05 Cost review, system, 2026-11-05: U1 standard-only forces Standard PCBA
    Full re-pricing after decisions 85 and 92-98. Report only; no design change.
2026-11-06 Record Q-0026: no Economic PCBA with 2 oz copper (decision 99)
2026-11-06 Cost review: real 5-piece PCB quotes for 1 oz and 2 oz
2026-11-06 Cost review: Economic PCBA is available with 1 oz copper
2026-11-06 Save pump start current test; record module ruling (decision 100)
2026-11-06 Record first order as 2 of 5 assembled (decision 101)
2026-11-06 Queue approved 16 A, part merge and SH-ESP32 items (T-0148 to T-0155)
2026-11-07 sync: Sync the "For /system" lists (T-0148)
    Unattended board-fixer, model opus, 0.61 USD; gates passed (ERC, netlist, LCSC, shared sheets).
2026-11-07 Auto: board-fixer sync (T-0148): 0 synced, 14 left for /system, merged 2d4d9b57
    Unattended run by tools/orchestrate.py, model opus, 0.61 USD.
2026-11-07 README: bilge breaker must open before the float-circuit fuse (design-notes 8.2)
2026-11-07 Auto: planner system (T-0157): interrupted, queued again, resumes where it stopped
    Unattended run by tools/orchestrate.py, model opus, 0.42 USD.
2026-11-07 pdm-4ch: pdm-4ch 16 A input: J10 set and Q30 re-selection (T-0158)
    Unattended board-fixer, model opus, 2.57 USD; gates passed (ERC, netlist, LCSC, shared sheets).
2026-11-07 Auto: board-fixer pdm-4ch (T-0158): 1 fixed, 0 blocked, merged 232c3185; no part changes
    Unattended run by tools/orchestrate.py, model opus, 2.93 USD.
2026-11-07 shared: Merge near-duplicate BOM lines (T-0159)
    Unattended board-fixer, model opus, 1.71 USD; gates passed (ERC, netlist, LCSC, shared sheets).
2026-11-07 Auto: board-fixer shared (T-0159): 1 fixed, 0 blocked, merged 698cbf87; pdm-4ch +0 parts (+0 DNP), -3 unique, pdm-hc2 +0 parts (+0 DNP), -4 unique
    Unattended run by tools/orchestrate.py, model opus, 3.01 USD.
2026-11-07 shared: Sign-of-life LEDs, spare GPIO and serial console access (T-0160)
    Unattended board-fixer, model opus, 3.35 USD; gates passed (ERC, netlist, LCSC, shared sheets).
2026-11-07 Auto: board-fixer shared (T-0160): 3 fixed, 0 blocked, merged c01c3a6d; pdm-4ch +5 parts (+1 DNP), +1 unique, pdm-hc2 +5 parts (+1 DNP), +1 unique
    Unattended run by tools/orchestrate.py, model opus, 4.13 USD.
2026-11-07 Auto: board-fixer shared (T-0161): paused, API unavailable, resumes where it stopped
    Unattended run by tools/orchestrate.py, model opus, 1.77 USD.
2026-11-07 shared: Buck input filter position (T-0161)
    Unattended board-fixer, model opus, 3.30 USD; gates passed (ERC, netlist, LCSC, shared sheets).
2026-11-07 Auto: board-fixer shared (T-0161): 1 fixed, 0 blocked, merged 9024407b; pdm-4ch +4 parts (+4 DNP), +0 unique, pdm-hc2 +4 parts (+4 DNP), +0 unique
    Unattended run by tools/orchestrate.py, model opus, 3.30 USD.
2026-11-07 pdm-4ch: pdm-4ch J10 socket C577772: stock fallback for the order (T-0171)
    Unattended board-fixer, model opus, 0.49 USD; gates passed (ERC, netlist, LCSC, shared sheets).
2026-11-07 Auto: board-fixer pdm-4ch (T-0171): 2 fixed, 1 blocked, merged 9d4e6dd8; no part changes
    Unattended run by tools/orchestrate.py, model opus, 0.97 USD.
2026-11-07 shared: C577772 + C577752 set: buying rule and interchangeable-plug warning (documents only) (T-0179)
    Unattended board-fixer, model opus, 0.44 USD; gates passed (ERC, netlist, LCSC, shared sheets).
2026-11-07 Auto: board-fixer shared (T-0179): 3 fixed, 0 blocked, merged ac1c0481; no part changes
    Unattended run by tools/orchestrate.py, model opus, 0.44 USD.
2026-11-07 pdm-hc2: HC2 turn-off edge: R116/R216 trial on the pre-compliance scan list (documents only) (T-0180)
    Unattended board-fixer, model opus, 0.28 USD; gates passed (ERC, netlist, LCSC, shared sheets).
2026-11-07 Auto: board-fixer pdm-hc2 (T-0180): 1 fixed, 0 blocked, merged 147034f0; no part changes
    Unattended run by tools/orchestrate.py, model opus, 0.28 USD.
2026-11-07 sync: Sync the "For /system" lists (T-0185)
    Unattended board-fixer, model opus, 0.65 USD; gates passed (ERC, netlist, LCSC, shared sheets).
2026-11-07 Auto: board-fixer sync (T-0185): 5 synced, 15 left for /system, merged 840bf4c9
    Unattended run by tools/orchestrate.py, model opus, 0.65 USD.
2026-11-07 pdm-4ch: J10 fixed screw terminal KF135T-10.16-2P C475108 for the prototype (decision 121)
    New footprint from the Kefa drawing; J10 fields only, nets unchanged, ERC unchanged.
2026-11-07 sync: Sync the "For /system" lists (T-0186)
    Unattended board-fixer, model opus, 0.53 USD; gates passed (ERC, netlist, LCSC, shared sheets).
2026-11-07 Auto: board-fixer sync (T-0186): 0 synced, 16 left for /system, merged 306f49be
    Unattended run by tools/orchestrate.py, model opus, 0.53 USD.
2026-11-08 Queue: T-0187 board-fix for cost lever L5 (C3 -> C170101, shared sheet), approved by owner
2026-11-08 Decision 122: all SMT parts on one side, layout rule on both boards (cost lever L3)
2026-11-08 Decision 123: corner M3 holes, one printed ASA DIN mount (short or long), Ø8 mm hole keep-out; mechanics docs synced
2026-11-08 Queue T-0188 (cost lever L6); cost-controller: owner-settled items (2-board prototype order, no combined panel, no SMD hand-soldering) are never re-proposed
2026-11-08 System: cost review, T-0187/T-0188 queued, one-side SMT and corner-hole DIN mount, docs tidy (decisions 122-123)
2026-11-08 shared: Shared power-usb: C3 to C170101 (cost lever L5) (T-0190)
    Unattended board-fixer, model opus, 0.75 USD; gates passed (ERC, netlist, LCSC, shared sheets).
2026-11-08 Auto: board-fixer shared (T-0190): 1 fixed, 0 blocked, merged ca774491; pdm-4ch +0 parts (+0 DNP), -1 unique, pdm-hc2 +0 parts (+0 DNP), -1 unique
    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
2026-11-08 pdm-hc2: HC2 EN/UVLO top resistors R105/R205 to C17927 (cost lever L6) (T-0191)
    Unattended board-fixer, model opus, 0.34 USD; gates passed (ERC, netlist, LCSC, shared sheets).
2026-11-08 Auto: board-fixer pdm-hc2 (T-0191): 1 fixed, 0 blocked, merged 93a72d3b; pdm-hc2 +0 parts (+0 DNP), -1 unique
    Unattended run by tools/orchestrate.py, model opus, 0.46 USD.
2026-11-08 sync: Sync the "For /system" lists (T-0196)
    Unattended board-fixer, model opus, 0.33 USD; gates passed (ERC, netlist, LCSC, shared sheets).
2026-11-08 Auto: board-fixer sync (T-0196): 0 synced, 11 left for /system, merged 4d92de34
    Unattended run by tools/orchestrate.py, model opus, 0.33 USD.
2026-11-08 Decision 124: pdm-4ch connector sample check moves to bring-up; layout covers the fit risks
2026-11-08 Decision 124: rail pitch is a soft goal, not a constraint
2026-11-08 pdm-4ch PCB: floorplan skeleton (decision 125), connector footprints checked against maker drawings
2026-11-08 pdm-4ch: drop the 'Update Symbols from Library' step; a KiCad 10 save with it reset every field and merged GND_CAN into GND
2026-11-08 pdm-4ch: KiCad 10 default keys in the project file (no rule or design change)
2026-11-08 pcb-fixer tooling: tools/kpcb.py, pcb-fixer role and PCB gates in the orchestrator (decision 130)
2026-11-08 pdm-4ch PCB: footprints imported from the schematic (kpcb sync: 226 parts parked beside the board, parity 0, DRC 0 errors); hole keep-outs allow the hole itself
2026-11-08 PCB layout by the orchestrator (decision 130): pcb-fixer agent, pdm-4ch stages T-0197..T-0202 queued, combined-panel items closed
2026-11-08 orchestrate.py pcb <board>: queue the layout stages and the layout reviews (decision 130)
2026-11-08 pdm-4ch: Place connectors and mounting holes (T-0197)
    Unattended board-fixer, model opus, 2.17 USD; gates passed (ERC, netlist, LCSC, shared sheets).
2026-11-08 Auto: pcb-fixer pdm-4ch (T-0197): 0 fixed, 0 blocked, merged b78636d7; no part changes
    Unattended run by tools/orchestrate.py, model opus, 2.17 USD.
2026-11-08 Auto: pcb-fixer pdm-4ch (T-0198): paused, API unavailable, resumes where it stopped
    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
2026-11-09 pdm-4ch: Place the power path and output channels (T-0198)
    Unattended board-fixer, model opus, 2.72 USD; gates passed (ERC, netlist, LCSC, shared sheets).
2026-11-09 Auto: pcb-fixer pdm-4ch (T-0198): 0 fixed, 0 blocked, merged 59c802e7; no part changes
    Unattended run by tools/orchestrate.py, model opus, 2.72 USD.
2026-11-09 Auto: pcb-fixer pdm-4ch (T-0199): failed
    Unattended run by tools/orchestrate.py, model opus, 14.42 USD.
2026-11-09 pcb-fixer: blocked layout items become owner questions or planner items and the stage waits instead of failing; U30 footprint TI_DDF0008A (TI land, 0.2 mm pad gaps)
2026-11-09 pdm-4ch: 100 x 75 mm (decision 131), stage 3 (T-0199) queued again
2026-11-09 Renumber the board-size decision to 138 (131-137 are the layout agents' auto decisions)
2026-11-09 Auto: pcb-fixer pdm-4ch (T-0199): interrupted, queued again, resumes where it stopped
    Unattended run by tools/orchestrate.py, model opus, 3.78 USD.
2026-11-09 pdm-4ch: Place the logic half and all remaining parts (T-0199)
    Unattended board-fixer, model opus, 6.04 USD; gates passed (ERC, netlist, LCSC, shared sheets).
2026-11-09 Auto: pcb-fixer pdm-4ch (T-0199): 0 fixed, 0 blocked, merged 04b3e460; no part changes
    Unattended run by tools/orchestrate.py, model opus, 6.04 USD.
2026-11-09 pdm-4ch: Power copper: pours and wide paths (T-0200)
    Unattended board-fixer, model opus, 4.34 USD; gates passed (ERC, netlist, LCSC, shared sheets).
2026-11-09 Auto: pcb-fixer pdm-4ch (T-0200): 0 fixed, 0 blocked, merged 4c911f85; no part changes
    Unattended run by tools/orchestrate.py, model opus, 4.34 USD.
2026-11-09 Auto: pcb-fixer pdm-4ch (T-0201): paused, API unavailable, resumes where it stopped
    Unattended run by tools/orchestrate.py, model opus, 0.00 USD.
2026-11-09 Auto: pcb-fixer pdm-4ch (T-0201): interrupted, queued again, resumes where it stopped
    Unattended run by tools/orchestrate.py, model opus, 2.92 USD.
2026-11-09 Auto: pcb-fixer pdm-4ch (T-0201): interrupted, queued again, resumes where it stopped
    Unattended run by tools/orchestrate.py, model opus, 3.41 USD.
2026-11-09 pdm-4ch: 4 copper layers (decision 150); planes and 4-layer routing stages T-0205/T-0206 queued, 2-layer routing T-0201 superseded
2026-11-09 pdm-4ch: 4-layer planes and stitching vias (T-0205)
    Unattended board-fixer, model opus, 2.44 USD; gates passed (ERC, netlist, LCSC, shared sheets).
2026-11-09 Auto: pcb-fixer pdm-4ch (T-0205): 0 fixed, 0 blocked, merged 83a4c8b8; no part changes
    Unattended run by tools/orchestrate.py, model opus, 2.44 USD.
2026-11-10 Auto: pcb-fixer pdm-4ch (T-0206): failed
    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
2026-11-10 Auto: pcb-fixer pdm-4ch (T-0206): interrupted, queued again, resumes where it stopped
    Unattended run by tools/orchestrate.py, model opus, 1.24 USD.
2026-11-10 Auto: pcb-fixer pdm-4ch (T-0206): failed
    Unattended run by tools/orchestrate.py, model opus, 3.22 USD.
2026-11-10 Auto: pcb-fixer pdm-4ch (T-0207): paused, API unavailable, resumes where it stopped
    Unattended run by tools/orchestrate.py, model opus, 2.82 USD.
2026-11-10 pdm-4ch: Route the short local links and ground vias (T-0207)
    Unattended board-fixer, model opus, 4.22 USD; gates passed (ERC, netlist, LCSC, shared sheets).
2026-11-10 Auto: pcb-fixer pdm-4ch (T-0207): 0 fixed, 0 blocked, merged b1920f21; no part changes
    Unattended run by tools/orchestrate.py, model opus, 4.22 USD.
2026-11-10 pdm-4ch: Make room in the U1 strip and fan out U1 (T-0208)
    Unattended board-fixer, model opus, 5.29 USD; gates passed (ERC, netlist, LCSC, shared sheets).
2026-11-10 Auto: pcb-fixer pdm-4ch (T-0208): 0 fixed, 0 blocked, merged 23846591; no part changes
    Unattended run by tools/orchestrate.py, model opus, 5.29 USD.
2026-11-10 pdm-4ch: routing as a reproducible build script, syntsamix method (decision 163); T-0209–T-0211 rebriefed
2026-11-10 pdm-4ch: Routing build script and the U1 strip (T-0209)
    Unattended board-fixer, model opus, 3.54 USD; gates passed (ERC, netlist, LCSC, shared sheets).
2026-11-10 Auto: pcb-fixer pdm-4ch (T-0209): 0 fixed, 0 blocked, merged 308b8eae; no part changes
    Unattended run by tools/orchestrate.py, model opus, 3.54 USD.
2026-11-10 pdm-4ch: CAN and USB pairs as fixed routes, rebuild (T-0210)
    Unattended board-fixer, model opus, 5.93 USD; gates passed (ERC, netlist, LCSC, shared sheets).
2026-11-10 Auto: pcb-fixer pdm-4ch (T-0210): 0 fixed, 0 blocked, merged e5818743; no part changes
    Unattended run by tools/orchestrate.py, model opus, 5.93 USD.
2026-11-10 Auto: pcb-fixer pdm-4ch (T-0211): paused, API unavailable, resumes where it stopped
    Unattended run by tools/orchestrate.py, model opus, 0.06 USD.
2026-11-11 orchestrate: pcb-fixer may change its board's build scripts (decision 163)
    Routing is built by hardware/<board>/scripts/; the merge gate let a stage add those
    files but not change them, so T-0210's fixed routes were held back (T-0214).
2026-11-11 Auto: pcb-fixer pdm-4ch (T-0211): waits for T-0218, T-0219 (blocked items), then runs again
    Unattended run by tools/orchestrate.py, model opus, 10.25 USD.
2026-11-11 pdm-4ch: pdm-4ch: CAN/USB/CC1 fixed routes and LAND_BEST into the routing build scripts (T-0214)
    Unattended board-fixer, model opus, 0.57 USD; gates passed (ERC, netlist, LCSC, shared sheets).
2026-11-11 Auto: board-fixer pdm-4ch (T-0214): 1 fixed, 0 blocked, merged 746f3880; no part changes
    Unattended run by tools/orchestrate.py, model opus, 0.57 USD.
2026-11-11 pdm-4ch: pdm-4ch: confirm the routing scripts gate is open and the T-0210 fixed routes are in scripts/ (T-0221)
    Unattended board-fixer, model opus, 0.21 USD; gates passed (ERC, netlist, LCSC, shared sheets).
2026-11-11 Auto: board-fixer pdm-4ch (T-0221): 1 fixed, 0 blocked, merged 1c5d7eb3; no part changes
    Unattended run by tools/orchestrate.py, model opus, 0.21 USD.
2026-11-11 Auto: pcb-fixer pdm-4ch (T-0226): failed
    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
2026-11-11 pdm-4ch: pdm-4ch routing: signal vias through VS-In2 and placement room for the U1 block and channel columns (staged, time-boxed) (T-0231)
    Unattended board-fixer, model opus, 0.94 USD; gates passed (ERC, netlist, LCSC, shared sheets).
2026-11-11 Auto: pcb-fixer pdm-4ch (T-0231): 0 fixed, 0 blocked, merged 7627a725; no part changes
    Unattended run by tools/orchestrate.py, model opus, 0.94 USD.
2026-11-12 pdm-4ch: pdm-4ch routing: build with signal vias through VS-In2, placement room for the U1 block and channel columns (continue T-0231) (T-0236)
    Unattended board-fixer, model opus, 4.81 USD; gates passed (ERC, netlist, LCSC, shared sheets).
2026-11-12 Auto: pcb-fixer pdm-4ch (T-0236): 0 fixed, 0 blocked, merged 02fe24a6; no part changes
    Unattended run by tools/orchestrate.py, model opus, 4.81 USD.
2026-11-12 pdm-4ch: pdm-4ch routing: clean router export, In2 signal corridor through VS-In2, scripted channel buses (Q-0071) (T-0241)
    Unattended board-fixer, model opus, 7.17 USD; gates passed (ERC, netlist, LCSC, shared sheets).
2026-11-12 Auto: pcb-fixer pdm-4ch (T-0241): 0 fixed, 0 blocked, merged 7f006e83; no part changes
    Unattended run by tools/orchestrate.py, model opus, 7.17 USD.
2026-11-13 pdm-4ch: pdm-4ch routing: ch1/ch4 signal parts out of the west pocket, Freerouting dropped, all links scripted with maze_route.py (Q-0072) (T-0246)
    Unattended board-fixer, model opus, 1.95 USD; gates passed (ERC, netlist, LCSC, shared sheets).
2026-11-13 Auto: pcb-fixer pdm-4ch (T-0246): 0 fixed, 0 blocked, merged 0e5e7cd2; no part changes
    Unattended run by tools/orchestrate.py, model opus, 1.95 USD.
2026-11-13 kpcb: leave with os._exit after the work so pcbnew's shutdown cannot segfault
    KiCad's Python bindings crash in Py_FinalizeEx and in pcbnew worker threads while
    the board is freed (17 macOS crash reports 9-13 Nov). Exit codes and messages of
    sys.exit and tracebacks are kept.
2026-11-13 pdm-4ch: pdm-4ch routing scripts: remove dangling maze copper and emit net-class widths (+3V3 at 0.3 mm) (T-0253)
    Unattended board-fixer, model opus, 3.81 USD; gates passed (ERC, netlist, LCSC, shared sheets).
2026-11-13 Auto: pcb-fixer pdm-4ch (T-0253): 2 fixed, 0 blocked, merged f6b7742b; no part changes
    Unattended run by tools/orchestrate.py, model opus, 3.81 USD.
2026-11-13 Auto: pcb-fixer pdm-4ch (T-0259): paused, API unavailable, resumes where it stopped
    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
2026-11-13 pdm-4ch: pdm-4ch routing: maze_route merge fix, ch1/ch4 signal parts toward U1, maze passes (T-0259)
    Unattended board-fixer, model opus, 5.40 USD; gates passed (ERC, netlist, LCSC, shared sheets).
2026-11-13 Auto: pcb-fixer pdm-4ch (T-0259): 0 fixed, 0 blocked, merged 85c42c5f; no part changes
    Unattended run by tools/orchestrate.py, model opus, 5.40 USD.
2026-11-13 Auto: board-fixer sync (T-0260): paused, API unavailable, resumes where it stopped
    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
2026-11-13 sync: pdm-4ch +3V3 neck wording in design-notes and STATUS (T-0260)
    Unattended board-fixer, model opus, 0.52 USD; gates passed (ERC, netlist, LCSC, shared sheets).
2026-11-13 Auto: board-fixer sync (T-0260): 1 fixed, 0 blocked, merged 277a83e0; no part changes
    Unattended run by tools/orchestrate.py, model opus, 0.52 USD.
2026-11-13 pdm-4ch: pdm-4ch: move the ch4 DEN via off pad R402.1 (T-0266)
    Unattended board-fixer, model opus, 1.54 USD; gates passed (ERC, netlist, LCSC, shared sheets).
2026-11-13 Auto: pcb-fixer pdm-4ch (T-0266): 1 fixed, 0 blocked, merged 64f4ea02; no part changes
    Unattended run by tools/orchestrate.py, model opus, 1.54 USD.
2026-11-13 Auto: pcb-fixer pdm-4ch (T-0271): paused, API unavailable, resumes where it stopped
    Unattended run by tools/orchestrate.py, model opus, 1.84 USD.
2026-11-14 pdm-4ch: pdm-4ch: trim VS-In2 east edge for the west-pocket exit to U1, then continue routing (T-0271)
    Unattended board-fixer, model opus, 5.49 USD; gates passed (ERC, netlist, LCSC, shared sheets).
2026-11-14 Auto: pcb-fixer pdm-4ch (T-0271): 0 fixed, 0 blocked, merged 9939ff4c; no part changes
    Unattended run by tools/orchestrate.py, model opus, 5.49 USD.
2026-11-14 pdm-4ch: pdm-4ch: marked In2 exit across the VS-In2 east edge (y 5-20) to a via column at x 56.3-57, then continue routing (T-0276)
    Unattended board-fixer, model opus, 8.50 USD; gates passed (ERC, netlist, LCSC, shared sheets).
2026-11-14 Auto: pcb-fixer pdm-4ch (T-0276): 0 fixed, 0 blocked, merged 84d1e063; no part changes
    Unattended run by tools/orchestrate.py, model opus, 8.50 USD.
2026-11-14 Auto: pcb-fixer pdm-4ch (T-0281): paused, API unavailable, resumes where it stopped
    Unattended run by tools/orchestrate.py, model opus, 2.77 USD.
2026-11-14 pdm-4ch: pdm-4ch: stitched GND-F/B fragments, free signal rerouting, D12-D15 nudge; continue routing to fewer unconnected (T-0281)
    Unattended board-fixer, model opus, 6.86 USD; gates passed (ERC, netlist, LCSC, shared sheets).
2026-11-14 Auto: pcb-fixer pdm-4ch (T-0281): 0 fixed, 0 blocked, merged 6d1d90eb; no part changes
    Unattended run by tools/orchestrate.py, model opus, 6.86 USD.
